Meyerflitedesign/SU-30/3d_prints/Canopy/lock_front_A_x1.3mf

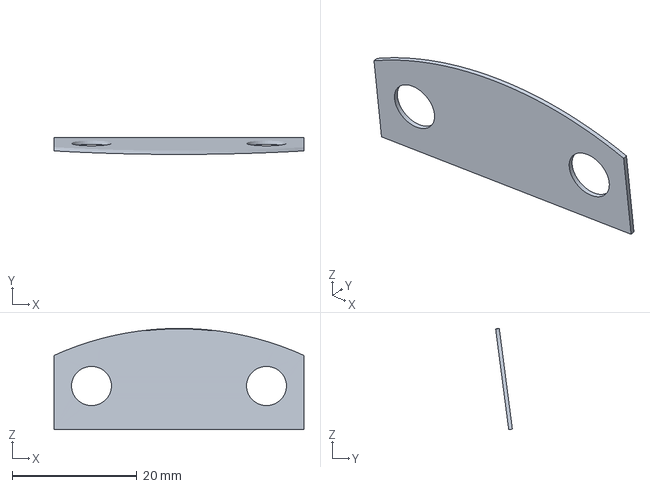
[picture p5: CAD file, 2023-12-27]
3d_prints/Canopy/lock_front_A_x1.3mf
40.0 x 2.69 x 16.2 mm
