Meyerflitedesign/SU-30/3d_prints/Miscellaneous/Tophatch_frame_x1.3mf

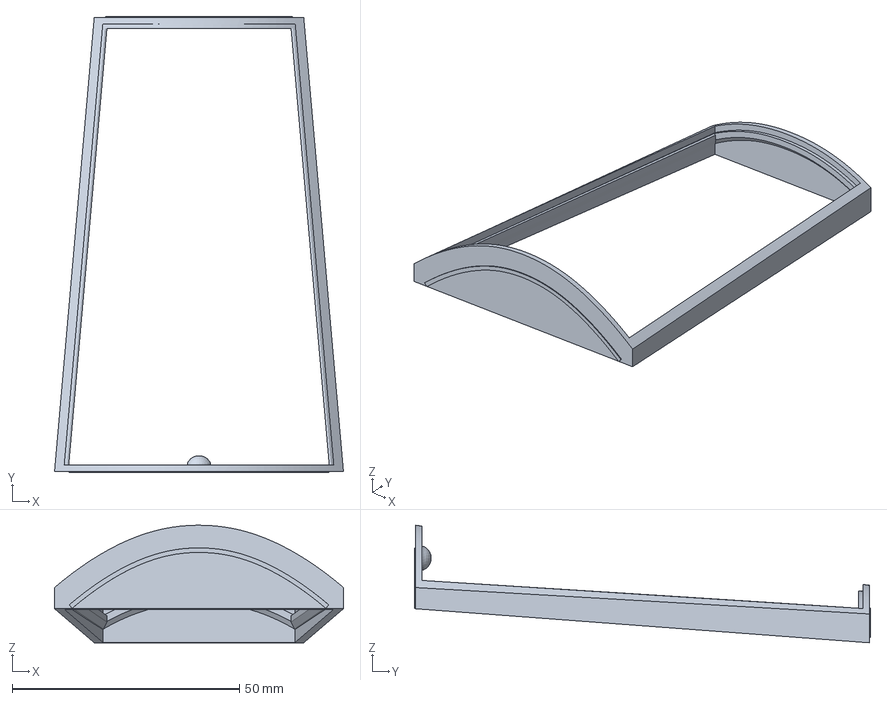
[picture p6: CAD file, 2023-12-27]
3d_prints/Miscellaneous/Tophatch_frame_x1.3mf
63.6 x 100.4 x 25.9 mm
