Meyerflitedesign/SU-30/3d_prints/Moving Canards/Canard_hinge_x2.3mf

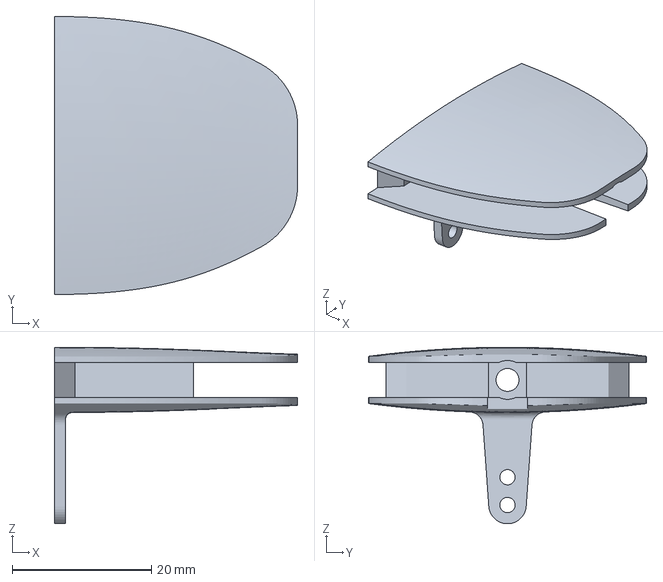
[picture p7: CAD file, 2023-12-27]
3d_prints/Moving Canards/Canard_hinge_x2.3mf
35.0 x 40.0 x 25.4 mm
