Meyerflitedesign/SU-30/3d_prints/Moving Stabilizers/Stabilizer_hinge_x1 +M.3mf

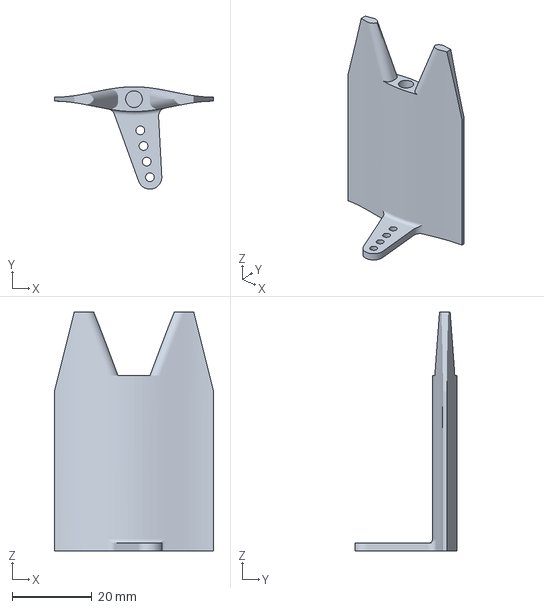
[picture p8: CAD file, 2023-12-27]
3d_prints/Moving Stabilizers/Stabilizer_hinge_x1 +M.3mf
40.0 x 25.7 x 60.0 mm
