Meyerflitedesign/SU-30/3d_prints/Substitutional Foam Parts/EF3_x1 +M.3mf

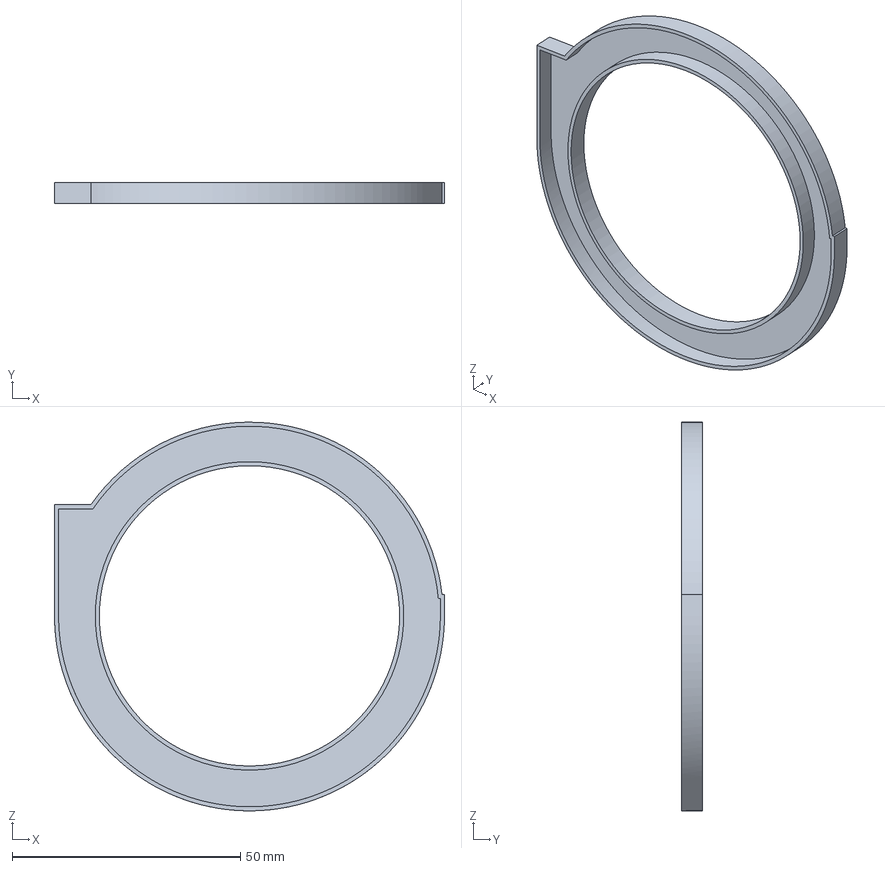
[picture p9: CAD file, 2023-12-27]
3d_prints/Substitutional Foam Parts/EF3_x1 +M.3mf
85.4 x 4.70 x 85.1 mm
