Meyerflitedesign/SU-30/3d_prints/Thrust Vectoring/Nozzle_retainer_x4.3mf

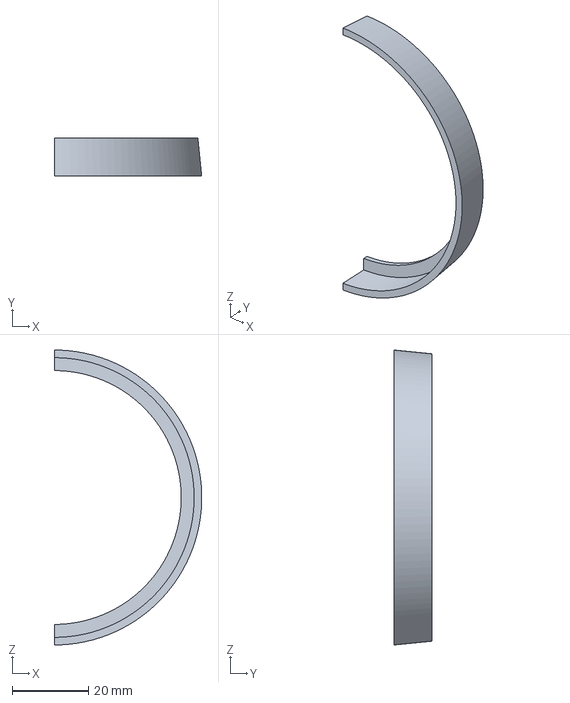
[picture p10: CAD file, 2023-12-27]
3d_prints/Thrust Vectoring/Nozzle_retainer_x4.3mf
38.7 x 10.00 x 77.4 mm
