Meyerflitedesign/SU-30/3d_prints/Canopy/Lock_back_B_x1.3mf

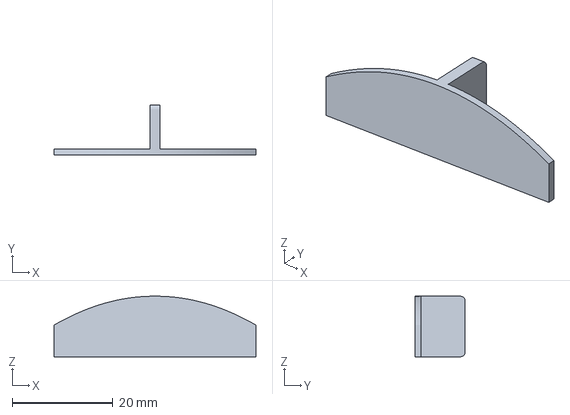
[picture p11: CAD file, 2023-12-27]
3d_prints/Canopy/Lock_back_B_x1.3mf
40.0 x 10.0 x 12.0 mm
