Meyerflitedesign/SU-30/3d_prints/Miscellaneous/Launchtab_support_x2.3mf

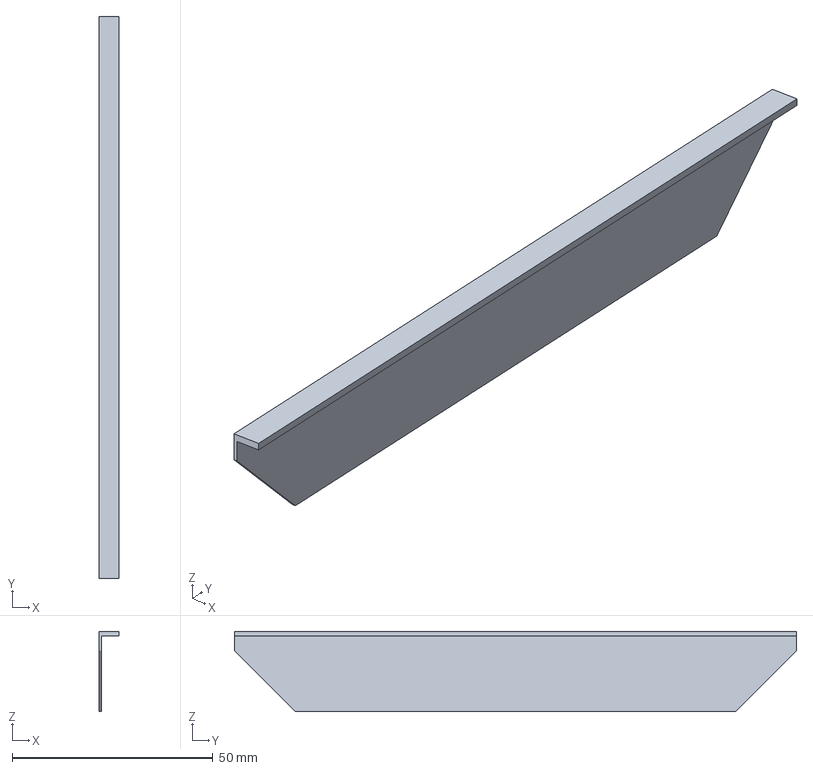
[picture p12: CAD file, 2023-12-27]
3d_prints/Miscellaneous/Launchtab_support_x2.3mf
5.00 x 140.0 x 20.0 mm
