Meyerflitedesign/SU-30/3d_prints/Moving Canards/Canard_mount_x1 +M.3mf

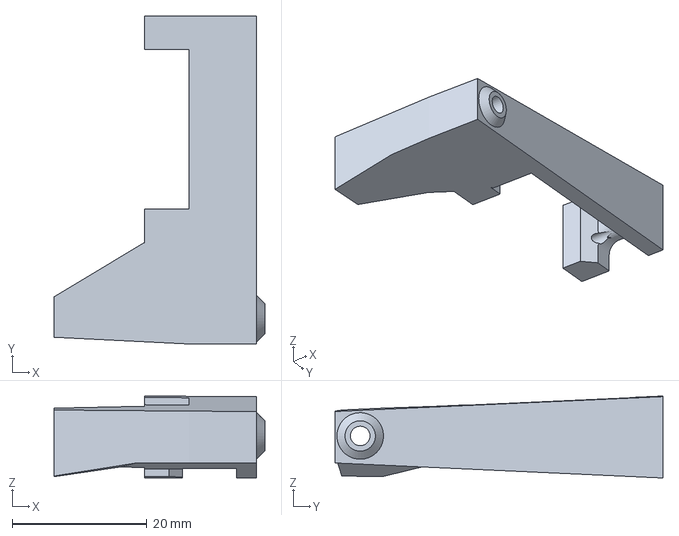
[picture p13: CAD file, 2023-12-27]
3d_prints/Moving Canards/Canard_mount_x1 +M.3mf
31.2 x 48.6 x 12.1 mm
