Meyerflitedesign/SU-30/3d_prints/Moving Stabilizers/Stabilizer_mount_1 +M.3mf

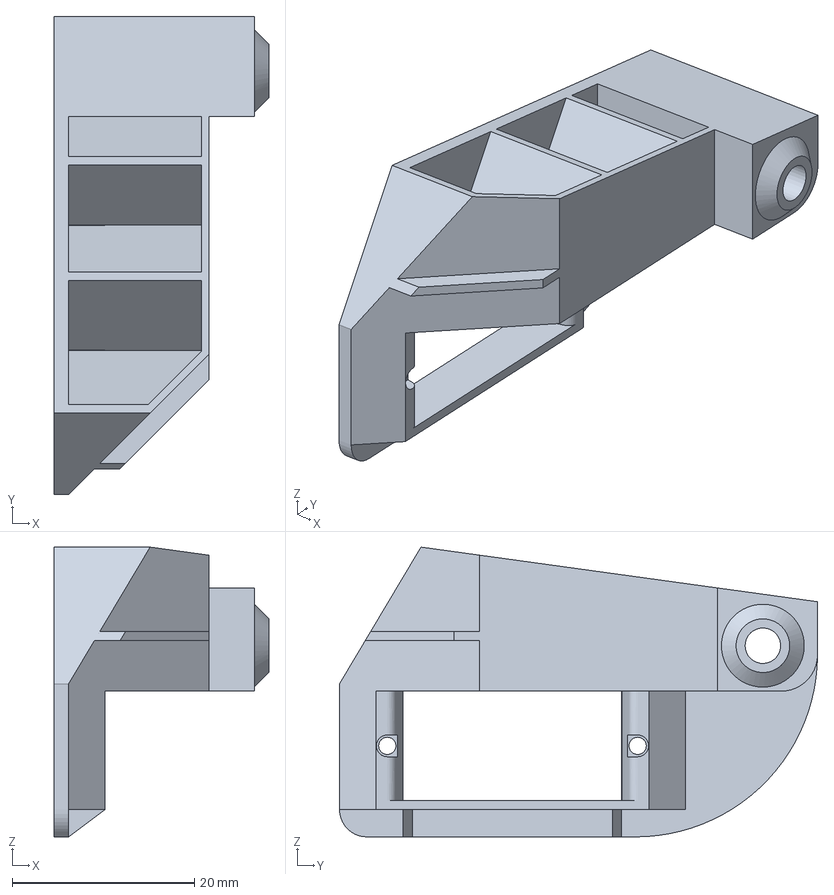
[picture p14: CAD file, 2023-12-27]
3d_prints/Moving Stabilizers/Stabilizer_mount_1 +M.3mf
23.6 x 52.5 x 31.8 mm
