Meyerflitedesign/SU-30/3d_prints/Substitutional Foam Parts/EF1_x1 +M.3mf

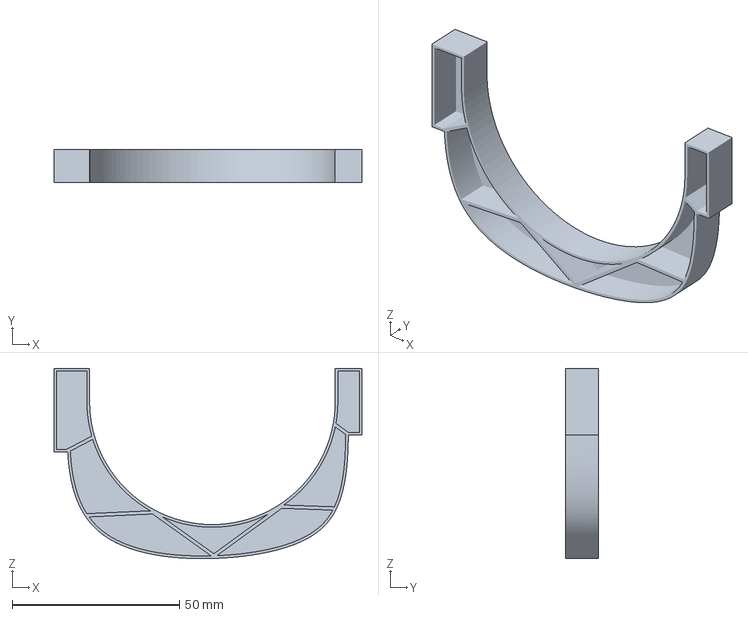
[picture p15: CAD file, 2023-12-27]
3d_prints/Substitutional Foam Parts/EF1_x1 +M.3mf
92.1 x 9.80 x 56.9 mm
