Meyerflitedesign/SU-30/3d_prints/Thrust Vectoring/Nozzle_mount_x2.3mf

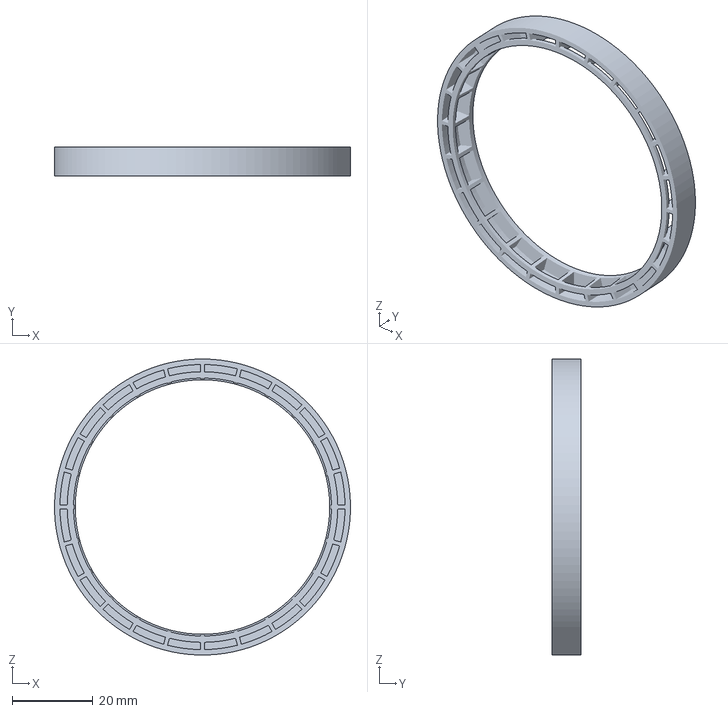
[picture p16: CAD file, 2023-12-27]
3d_prints/Thrust Vectoring/Nozzle_mount_x2.3mf
73.3 x 7.25 x 73.3 mm
