Meyerflitedesign/SU-30/3d_prints/Canopy/Lock_back_A_x1.3mf

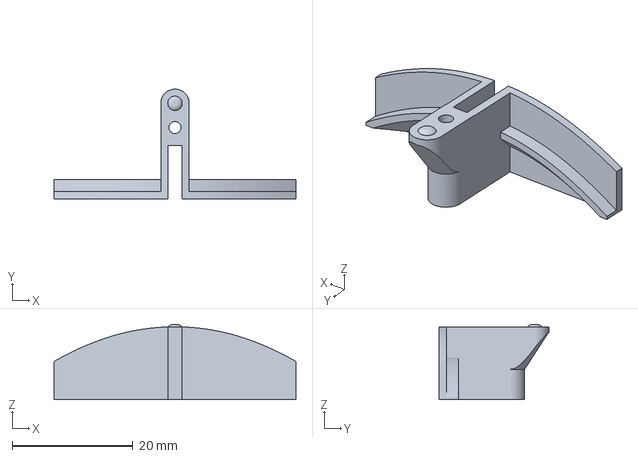
[picture p17: CAD file, 2023-12-27]
3d_prints/Canopy/Lock_back_A_x1.3mf
40.0 x 18.1 x 12.4 mm
