Meyerflitedesign/SU-30/3d_prints/Miscellaneous/Intake_grill_x4.3mf

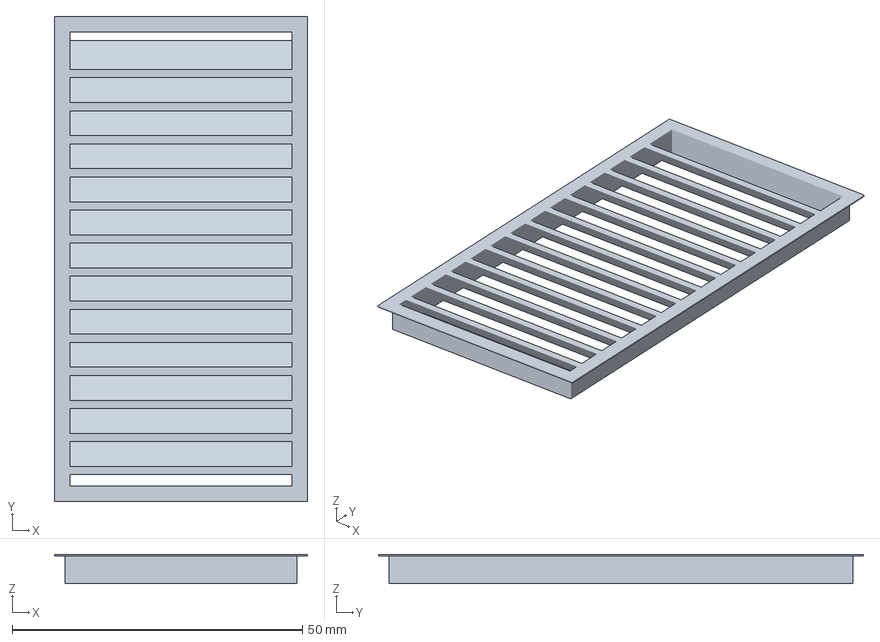
[picture p18: CAD file, 2023-12-27]
3d_prints/Miscellaneous/Intake_grill_x4.3mf
43.6 x 83.6 x 5.00 mm
