Meyerflitedesign/SU-30/3d_prints/Substitutional Foam Parts/FF2_x1 +M.3mf

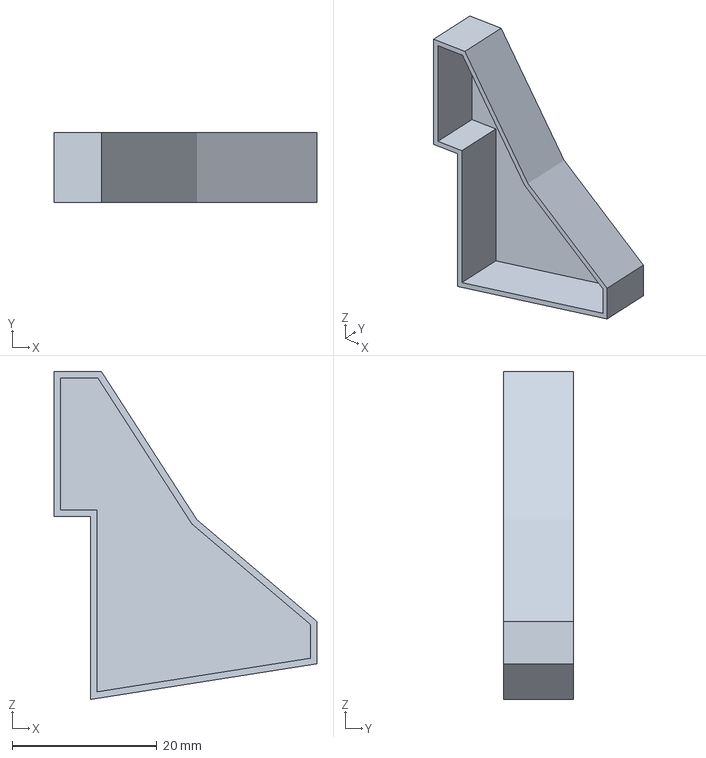
[picture p19: CAD file, 2023-12-27]
3d_prints/Substitutional Foam Parts/FF2_x1 +M.3mf
36.3 x 9.70 x 45.2 mm
