Meyerflitedesign/SU-30/3d_prints/Thrust Vectoring/Control_horn_x4.3mf

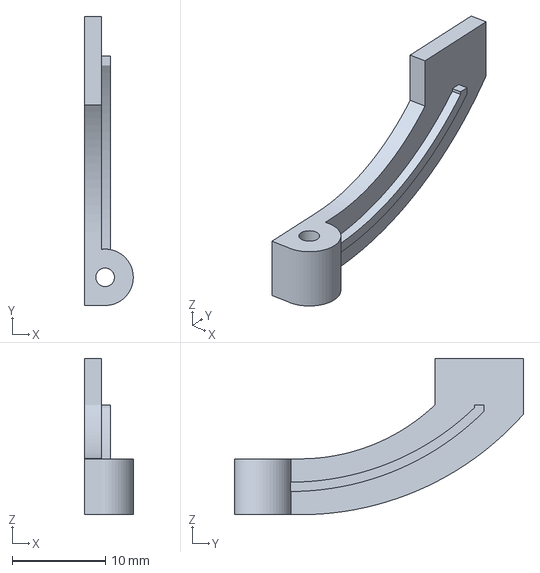
[picture p20: CAD file, 2023-12-27]
3d_prints/Thrust Vectoring/Control_horn_x4.3mf
5.23 x 31.0 x 16.8 mm
