Meyerflitedesign/SU-30/3d_prints/Canopy/Canopy_back_x1.3mf

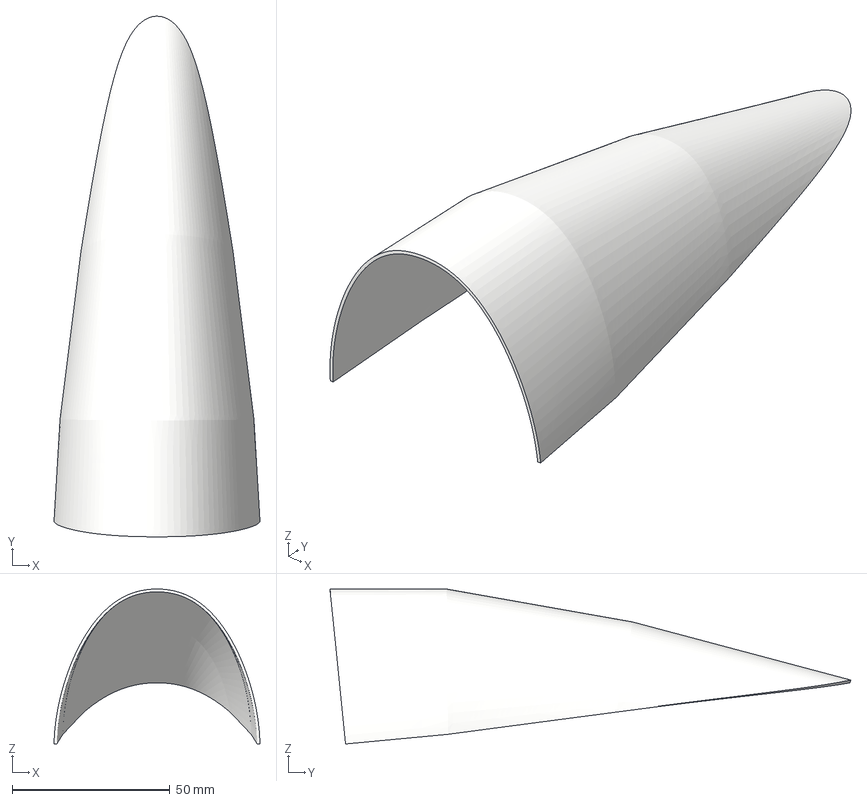
[picture p21: CAD file, 2023-12-27]
3d_prints/Canopy/Canopy_back_x1.3mf
65.3 x 165.1 x 49.1 mm
