Meyerflitedesign/SU-30/3d_prints/Miscellaneous/Gopro_mount_x1.3mf

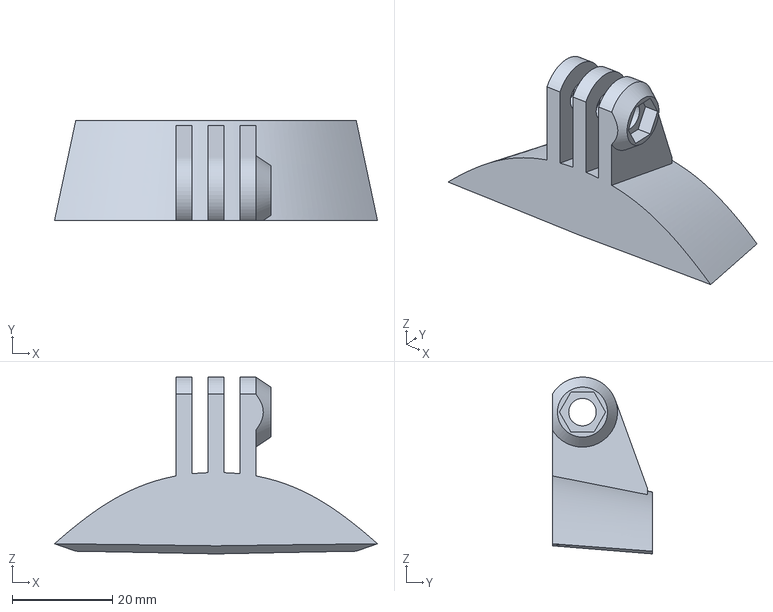
[picture p22: CAD file, 2023-12-27]
3d_prints/Miscellaneous/Gopro_mount_x1.3mf
64.5 x 20.0 x 35.3 mm
