Meyerflitedesign/SU-30/3d_prints/Substitutional Foam Parts/EF2_x1 +M.3mf

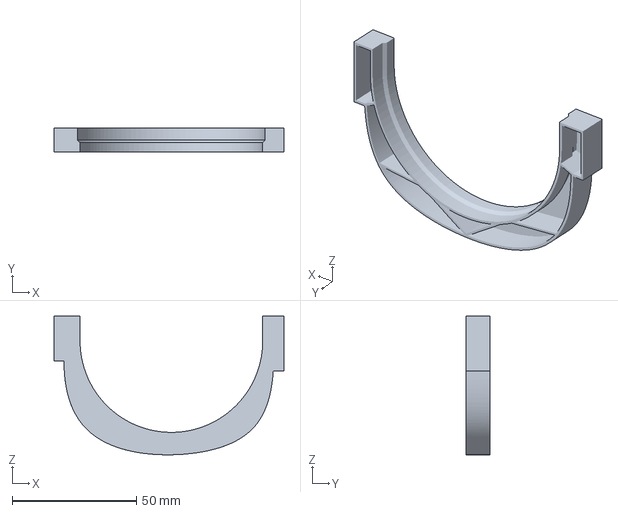
[picture p23: CAD file, 2023-12-27]
3d_prints/Substitutional Foam Parts/EF2_x1 +M.3mf
92.4 x 9.80 x 55.7 mm
