Meyerflitedesign/SU-30/3d_prints/Thrust Vectoring/Servo_mount_vertical_x1+M.3mf

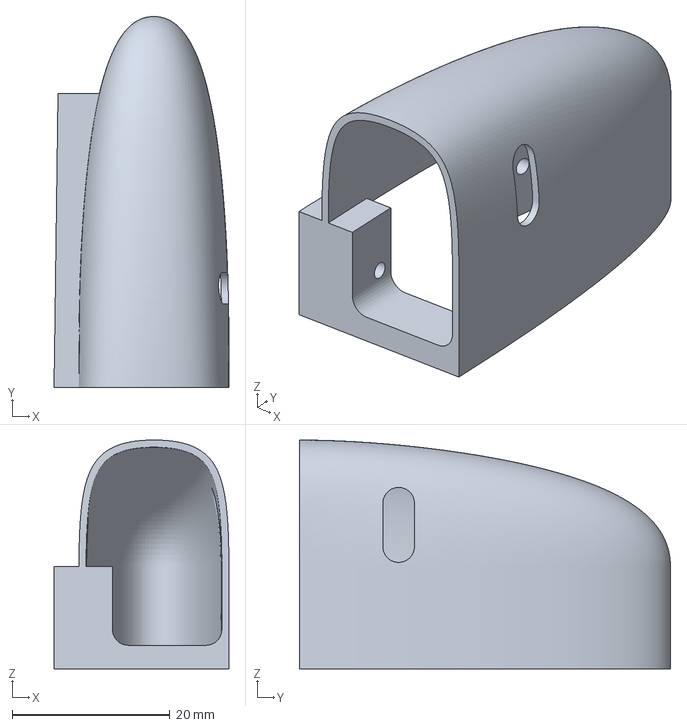
[picture p24: CAD file, 2023-12-27]
3d_prints/Thrust Vectoring/Servo_mount_vertical_x1+M.3mf
22.2 x 47.0 x 29.0 mm
