Meyerflitedesign/SU-30/3d_prints/Canopy/Canopy_front_x1.3mf

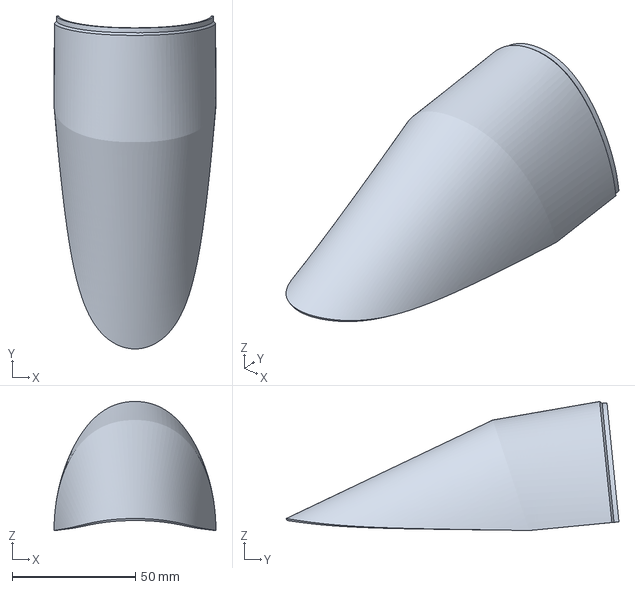
[picture p25: CAD file, 2023-12-27]
3d_prints/Canopy/Canopy_front_x1.3mf
65.6 x 134.9 x 52.3 mm
