Meyerflitedesign/SU-30/3d_prints/Miscellaneous/Tophatch_lid_x1.3mf

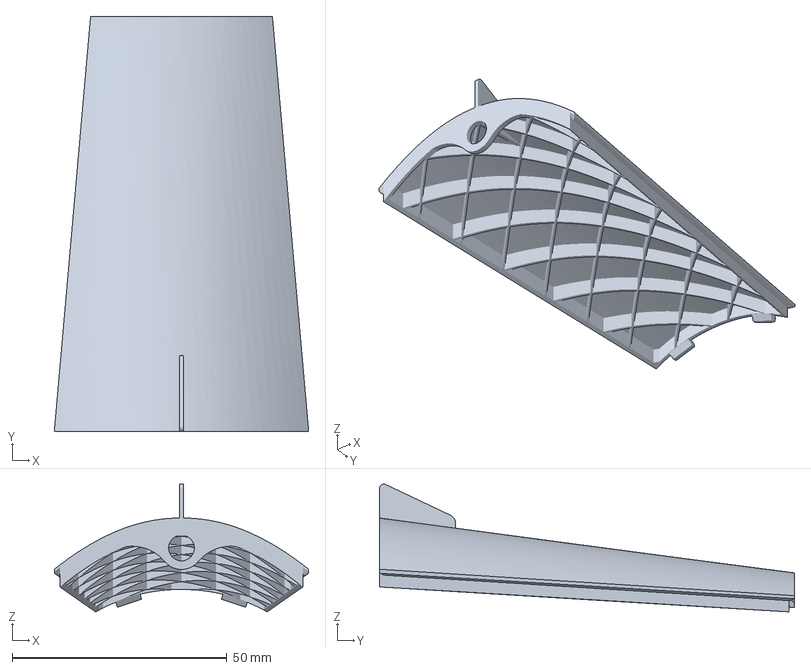
[picture p26: CAD file, 2023-12-27]
3d_prints/Miscellaneous/Tophatch_lid_x1.3mf
59.3 x 96.7 x 29.8 mm
