Meyerflitedesign/SU-30/3d_prints/Thrust Vectoring/Servo_mount_horizontal_x1+M.3mf

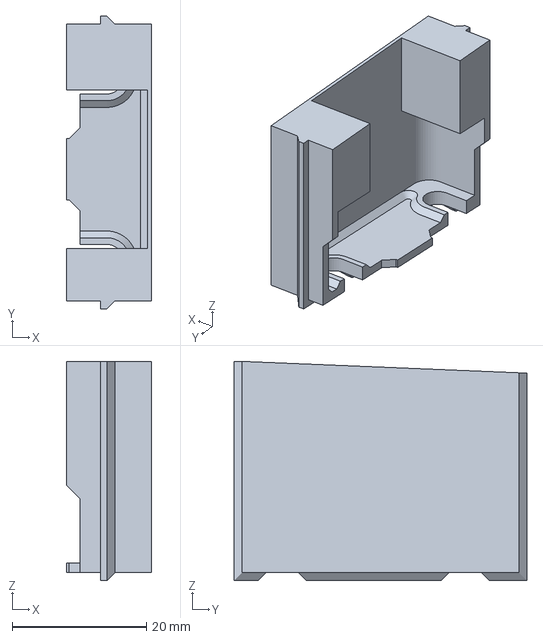
[picture p27: CAD file, 2023-12-27]
3d_prints/Thrust Vectoring/Servo_mount_horizontal_x1+M.3mf
12.6 x 43.6 x 32.6 mm
