Meyerflitedesign/SU-30/3d_prints/Canopy/Lock_front_B_x1.3mf

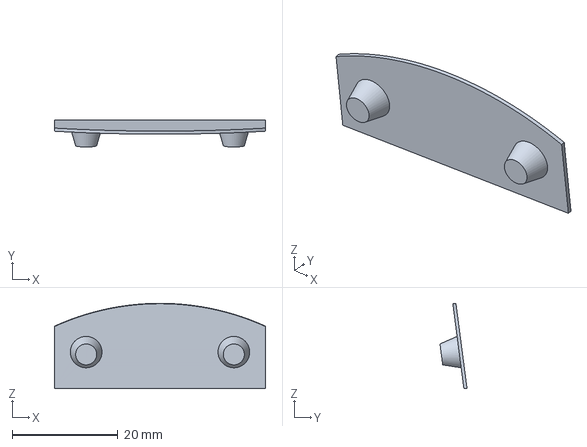
[picture p28: CAD file, 2023-12-27]
3d_prints/Canopy/Lock_front_B_x1.3mf
40.0 x 5.13 x 16.2 mm
