Meyerflitedesign/SU-30/3d_prints/Canopy/Lock_latch_x1.3mf

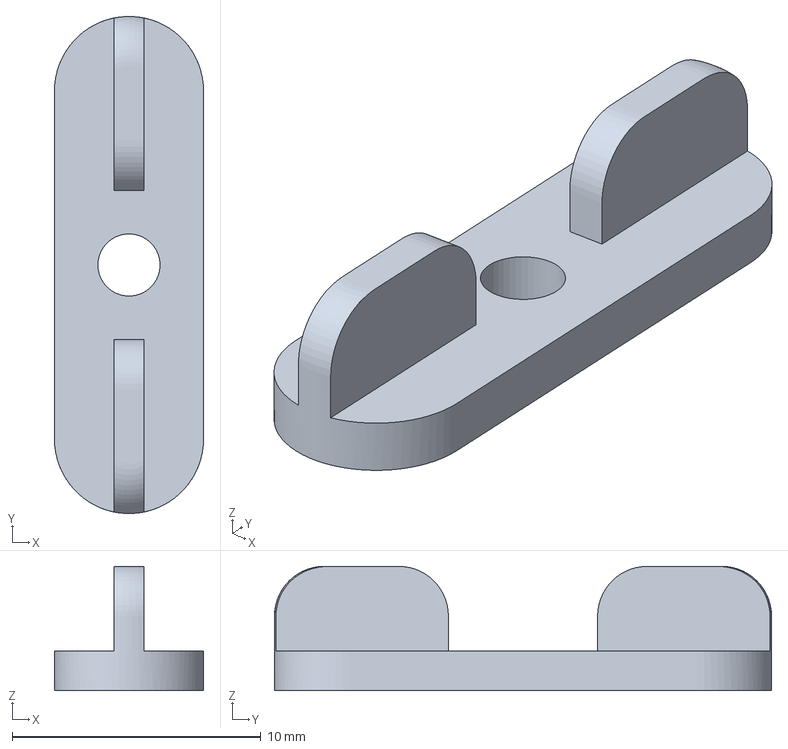
[picture p29: CAD file, 2023-12-27]
3d_prints/Canopy/Lock_latch_x1.3mf
6.00 x 20.0 x 5.00 mm
