Meyerflitedesign/SU-30/(list of files, cad)

Other CAD files:
Sheets/DXF/SU-30.dxf
