Meyerflitedesign/SU-30/su30_wiring.png

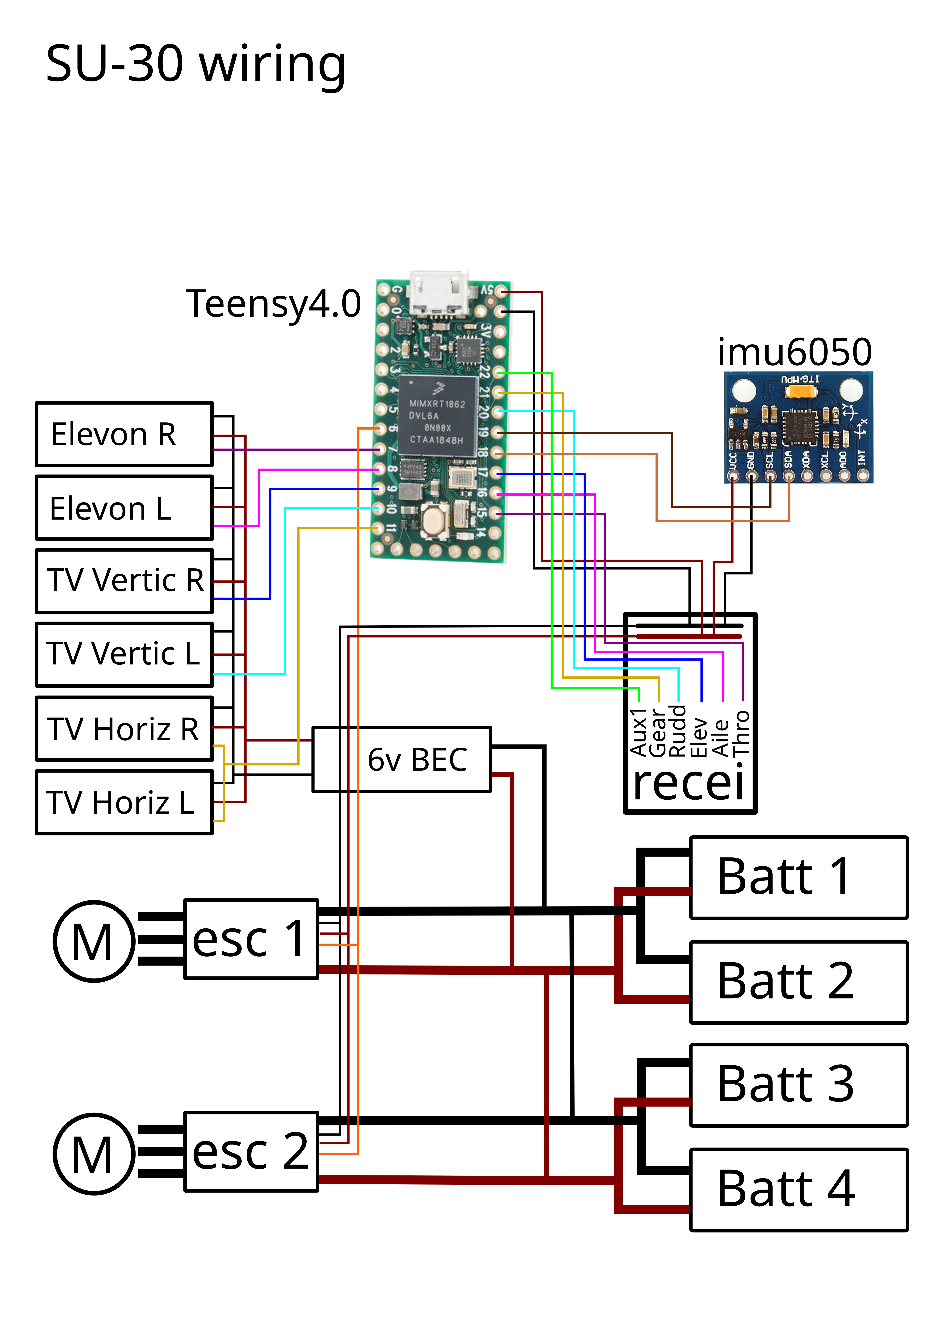
su30_wiring.png
