Meyerflitedesign/SU-30/Sheets/PDF/Sheet1.pdf

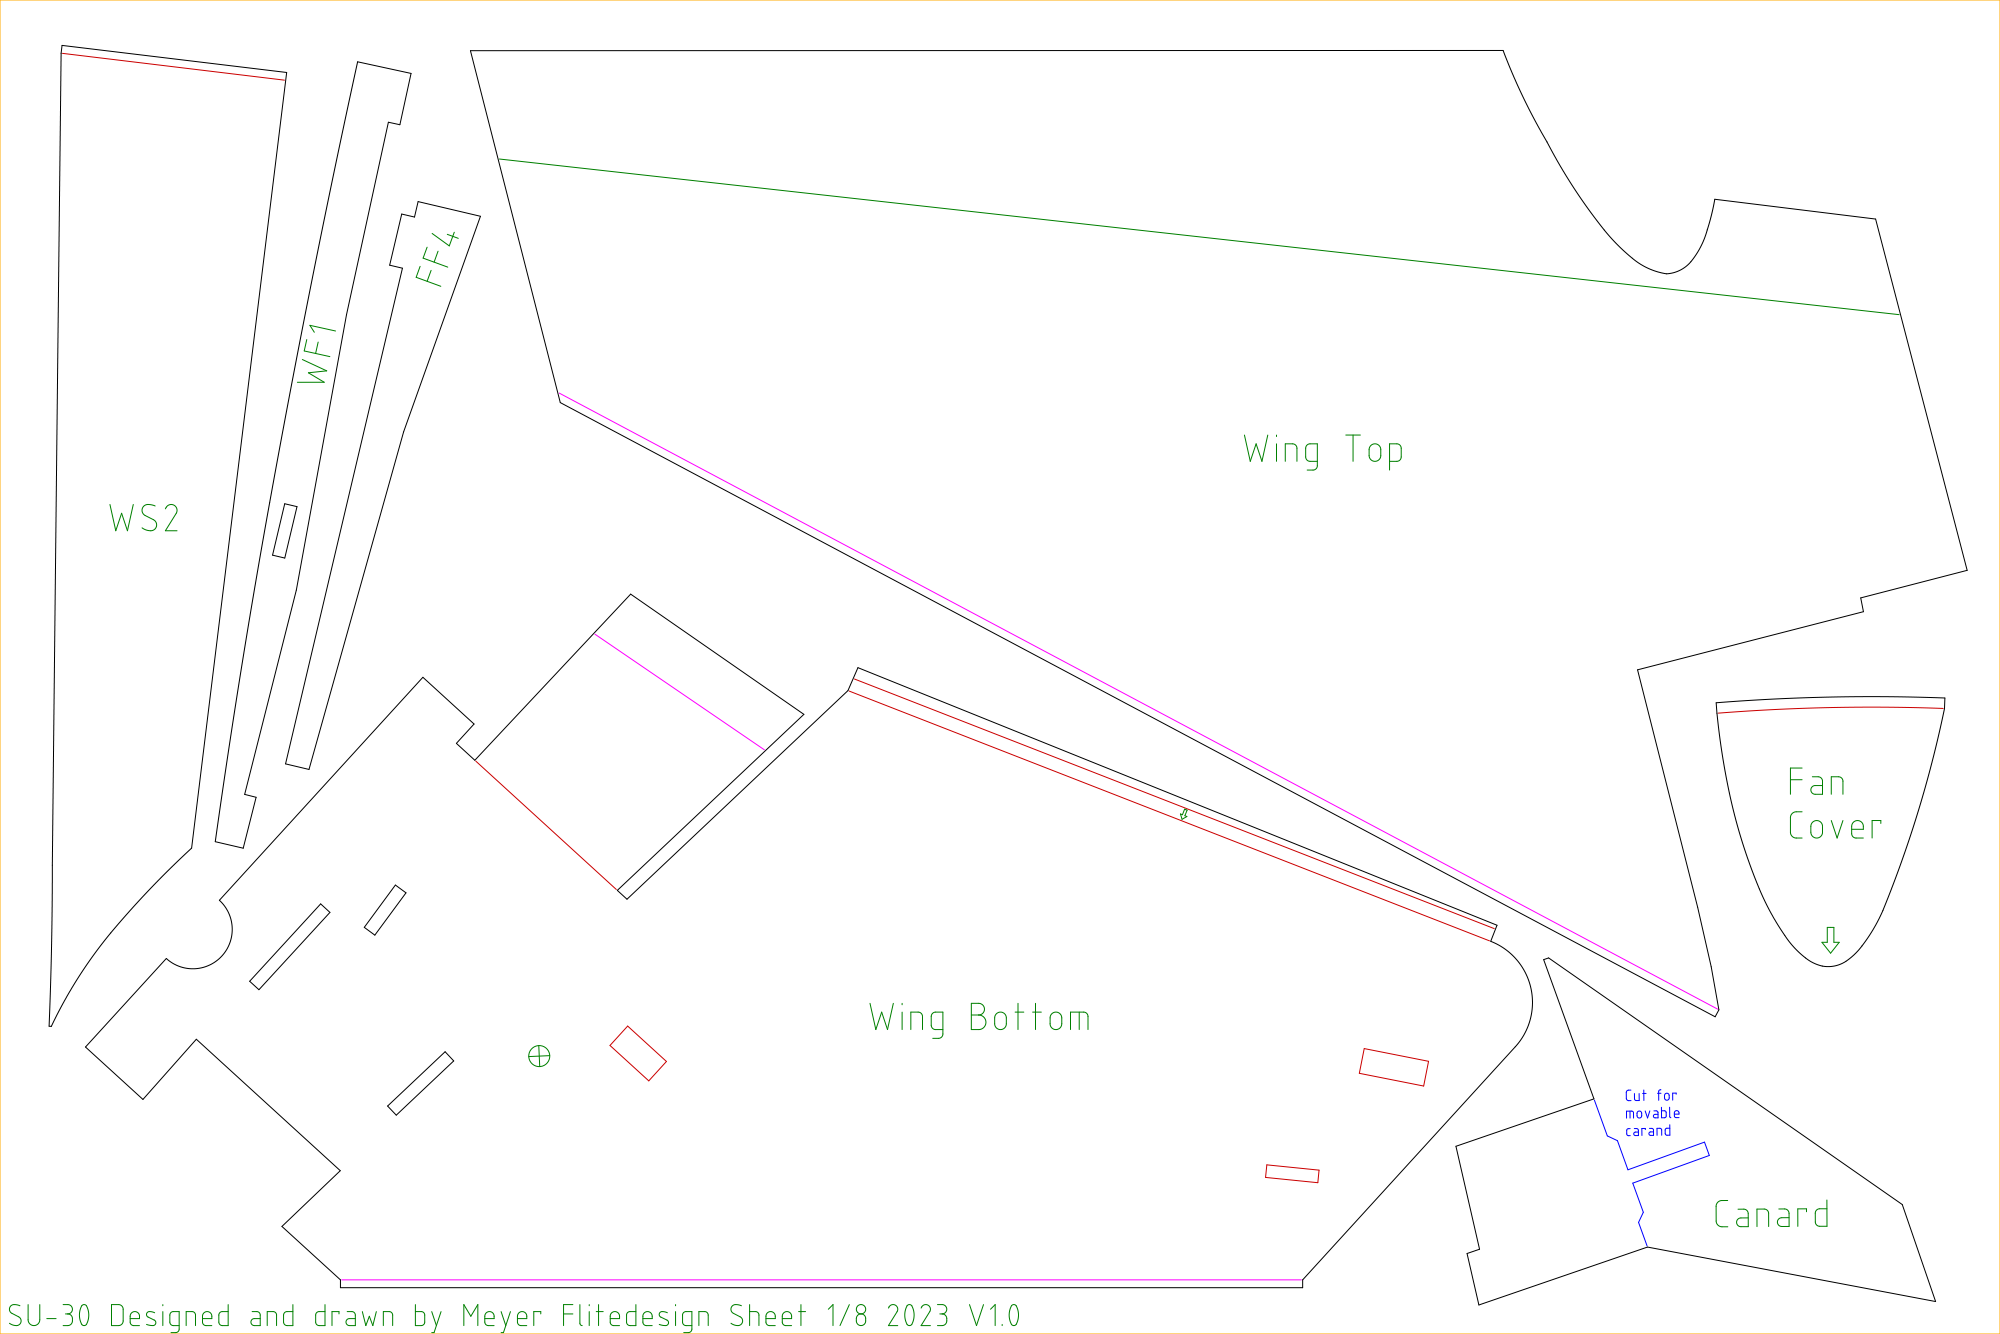
[picture p31: page 1]
