Meyerflitedesign/SU-30/Sheets/PDF/Sheet2.pdf

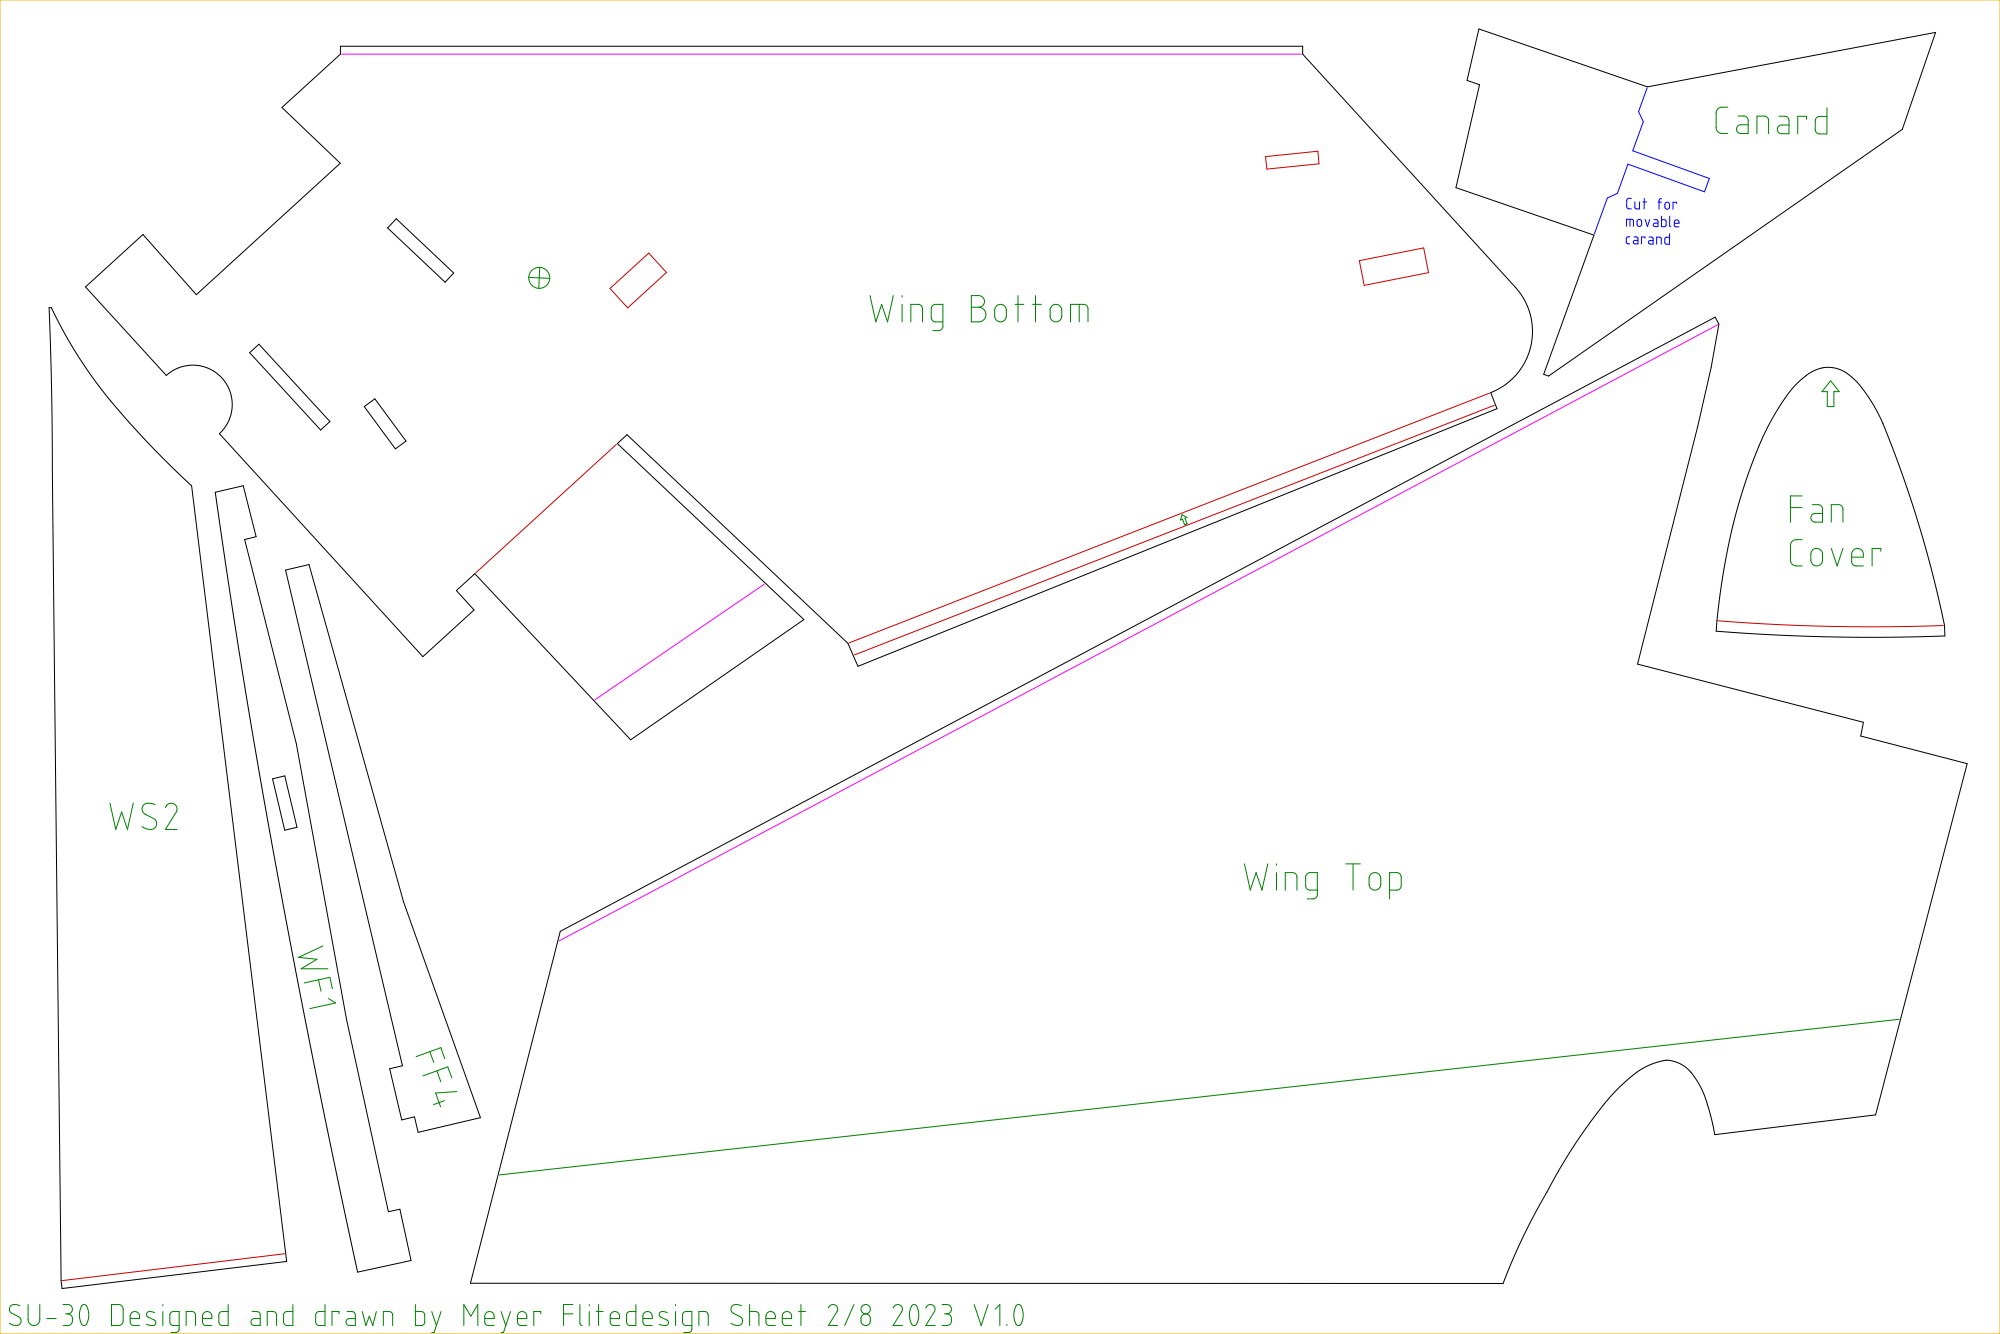
[picture p32: page 1]
