Meyerflitedesign/SU-30/Sheets/PDF/Sheet3.pdf

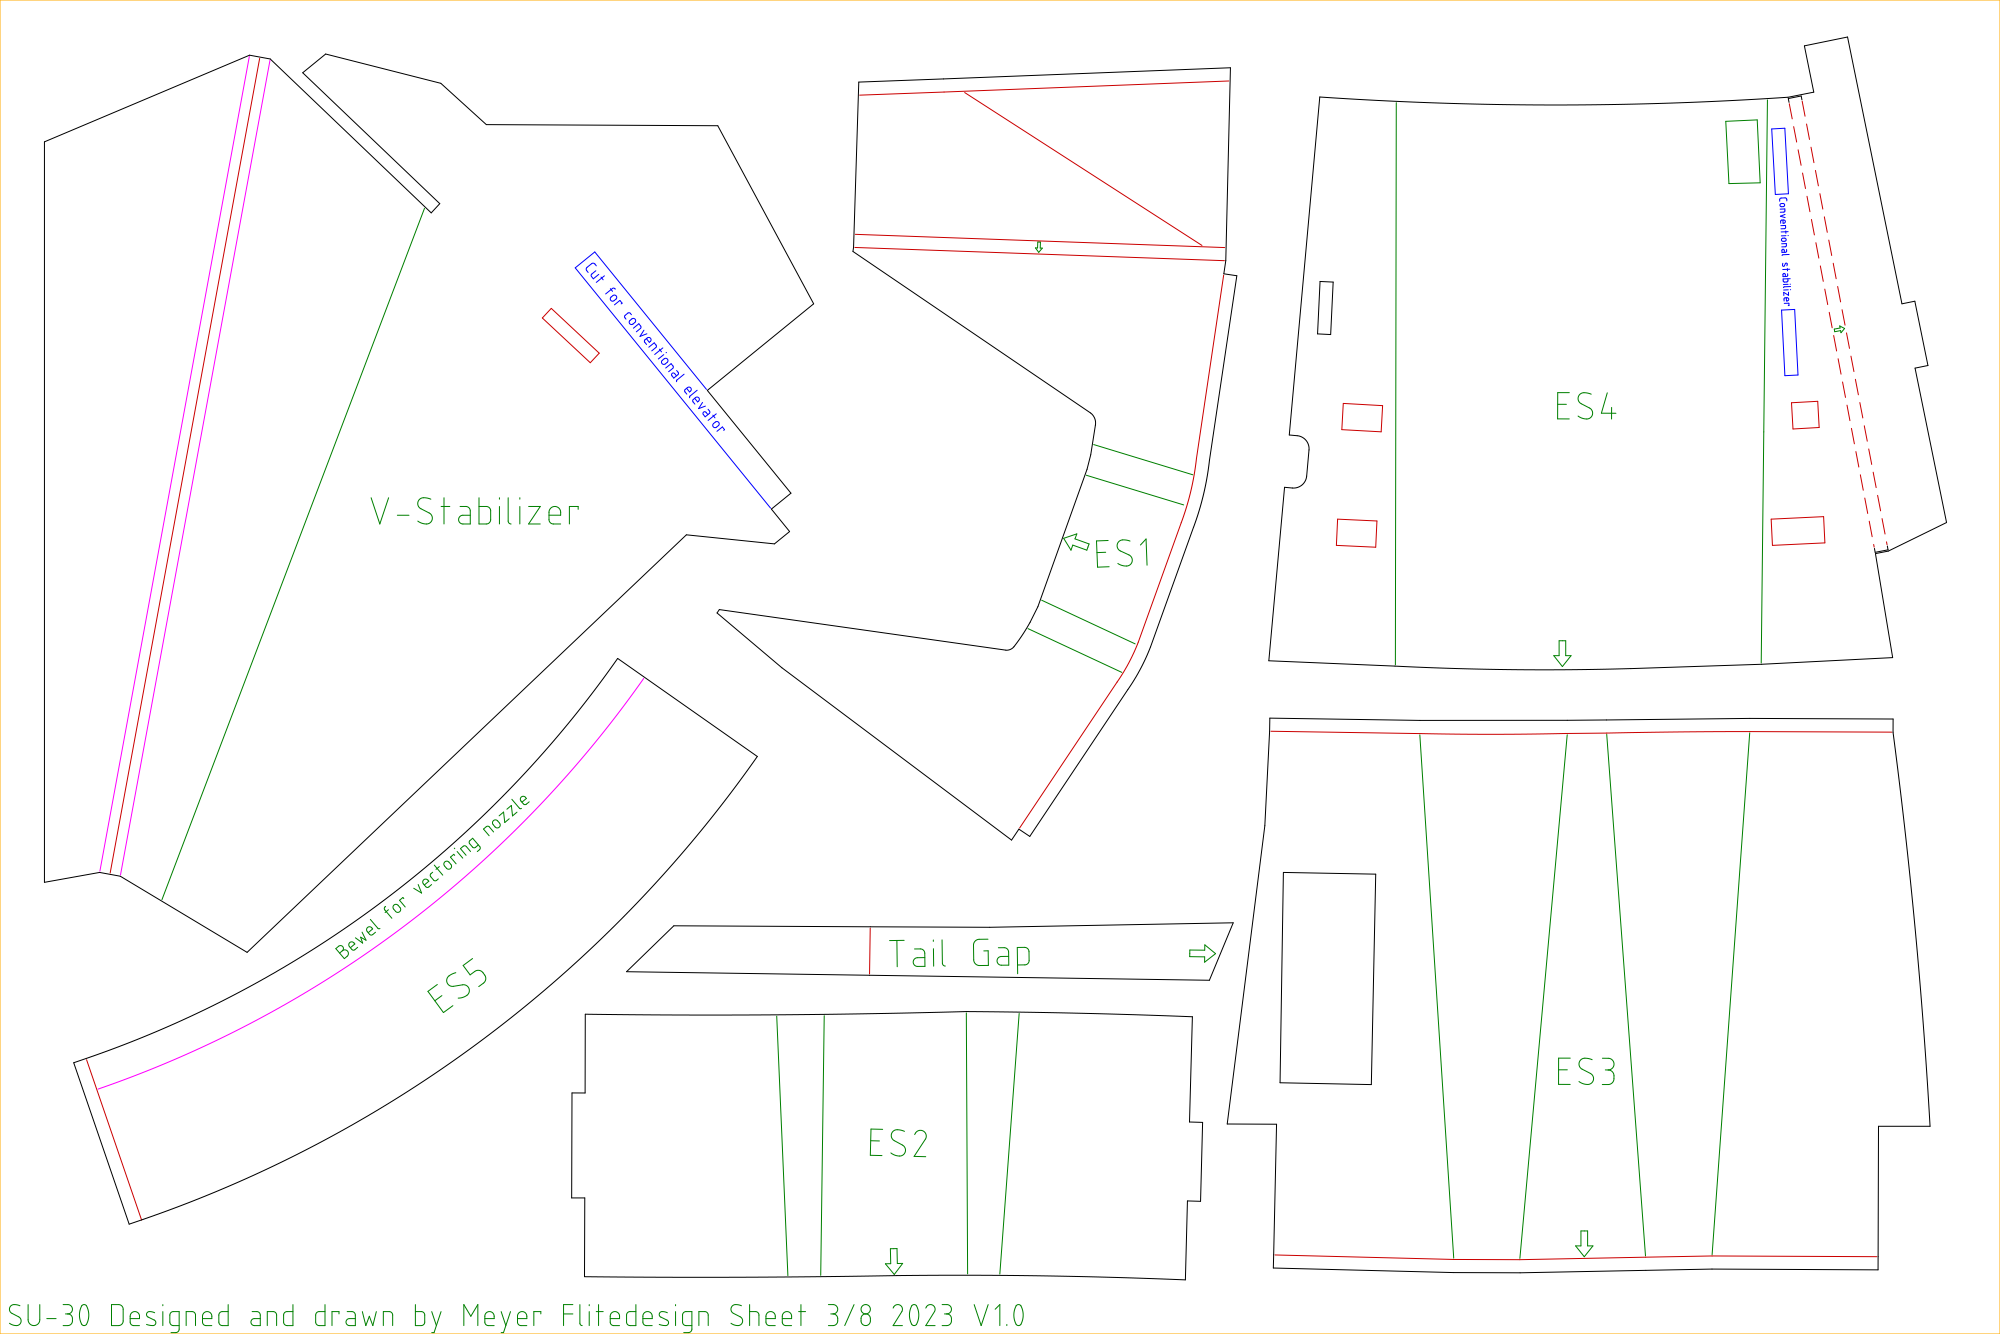
[picture p33: page 1]
