Meyerflitedesign/SU-30/Sheets/PDF/Sheet4.pdf

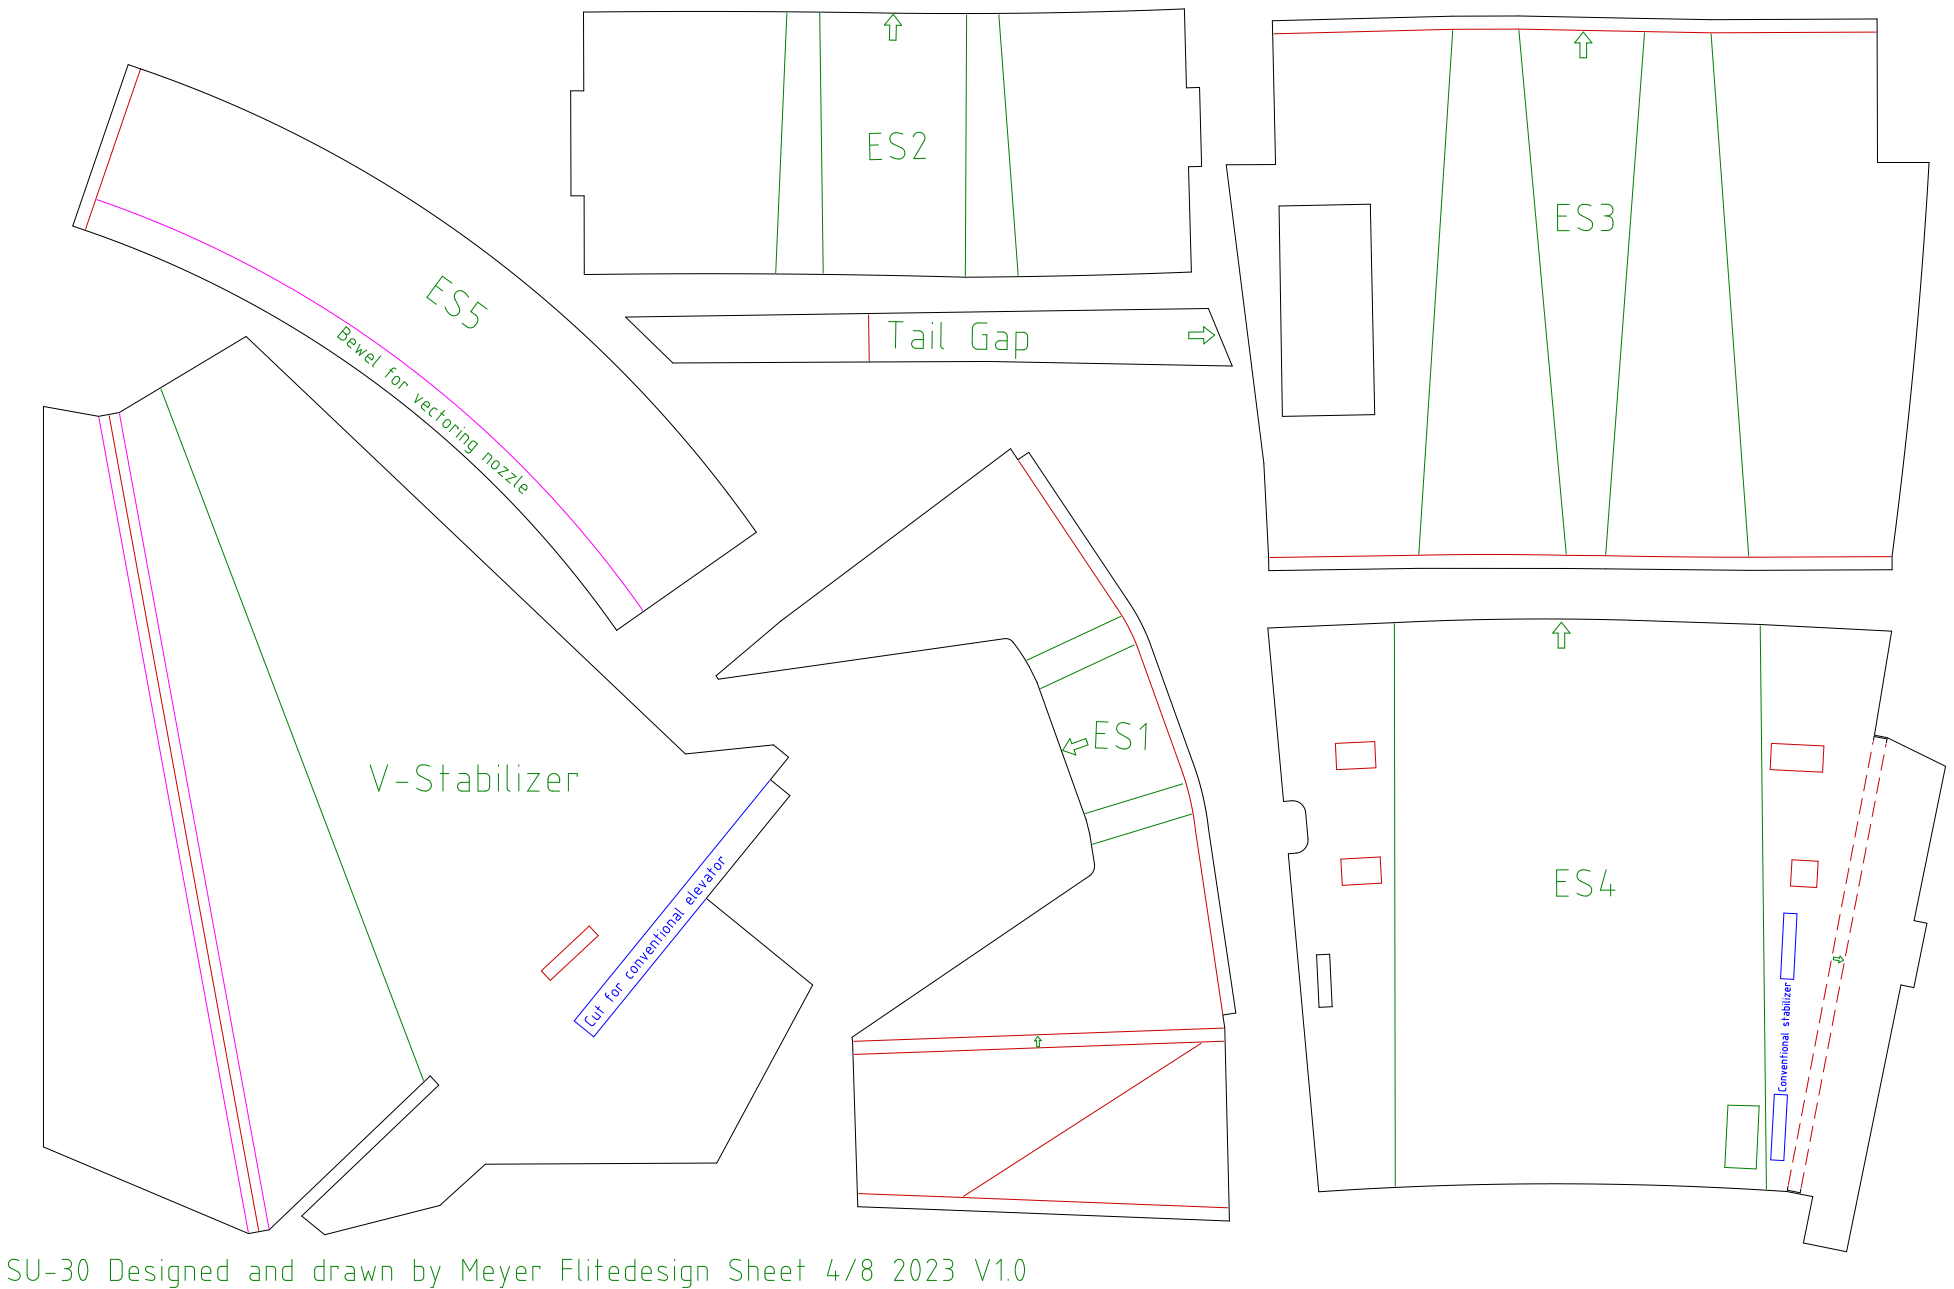
[picture p34: page 1]
