Meyerflitedesign/SU-30/Sheets/PDF/Sheet5.pdf

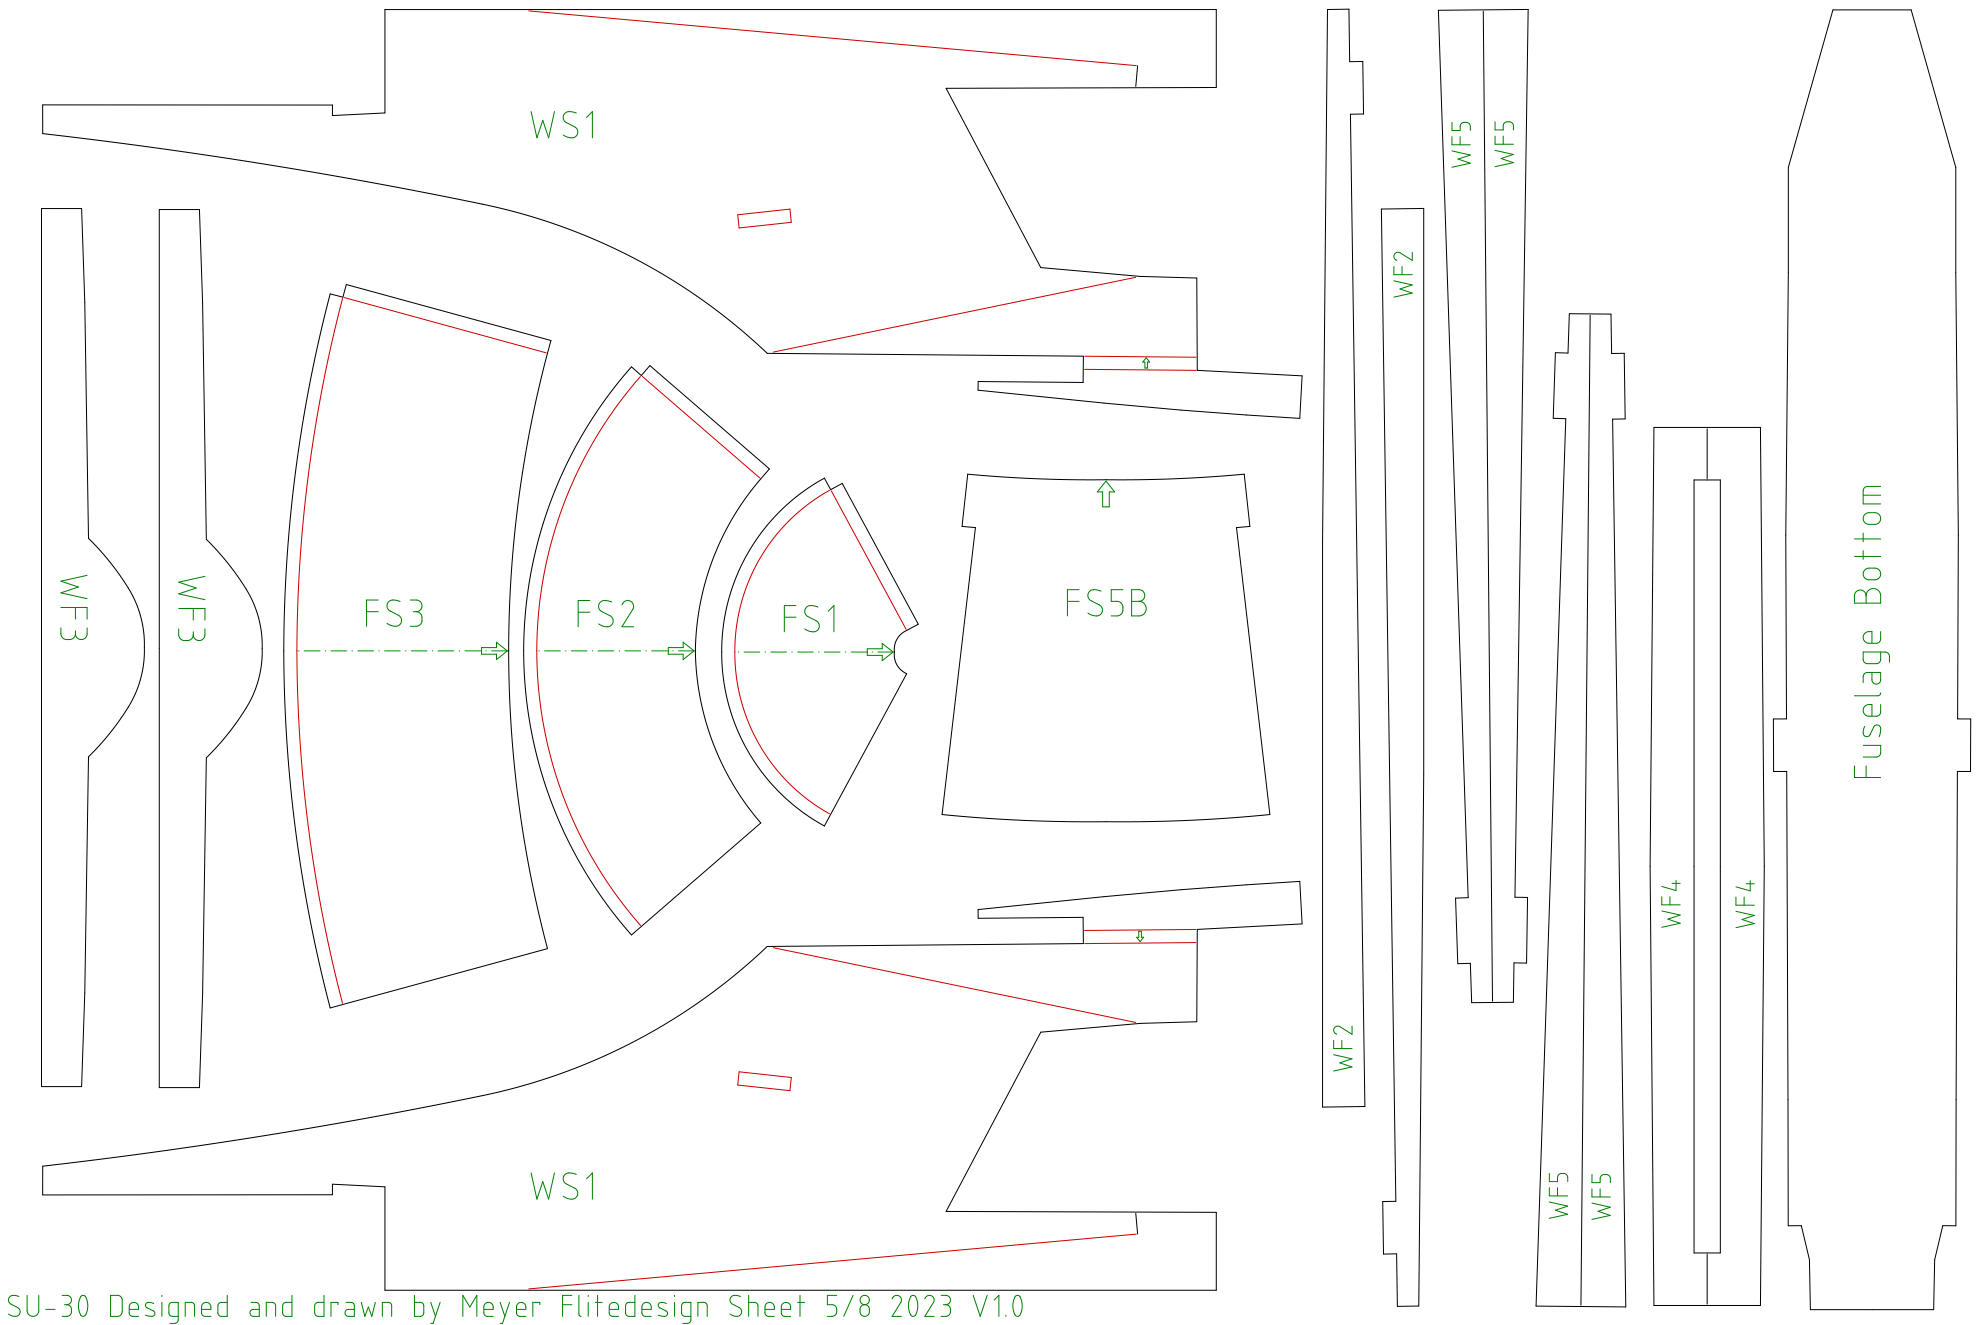
[picture p35: page 1]
