Meyerflitedesign/SU-30/Sheets/PDF/Sheet6.pdf

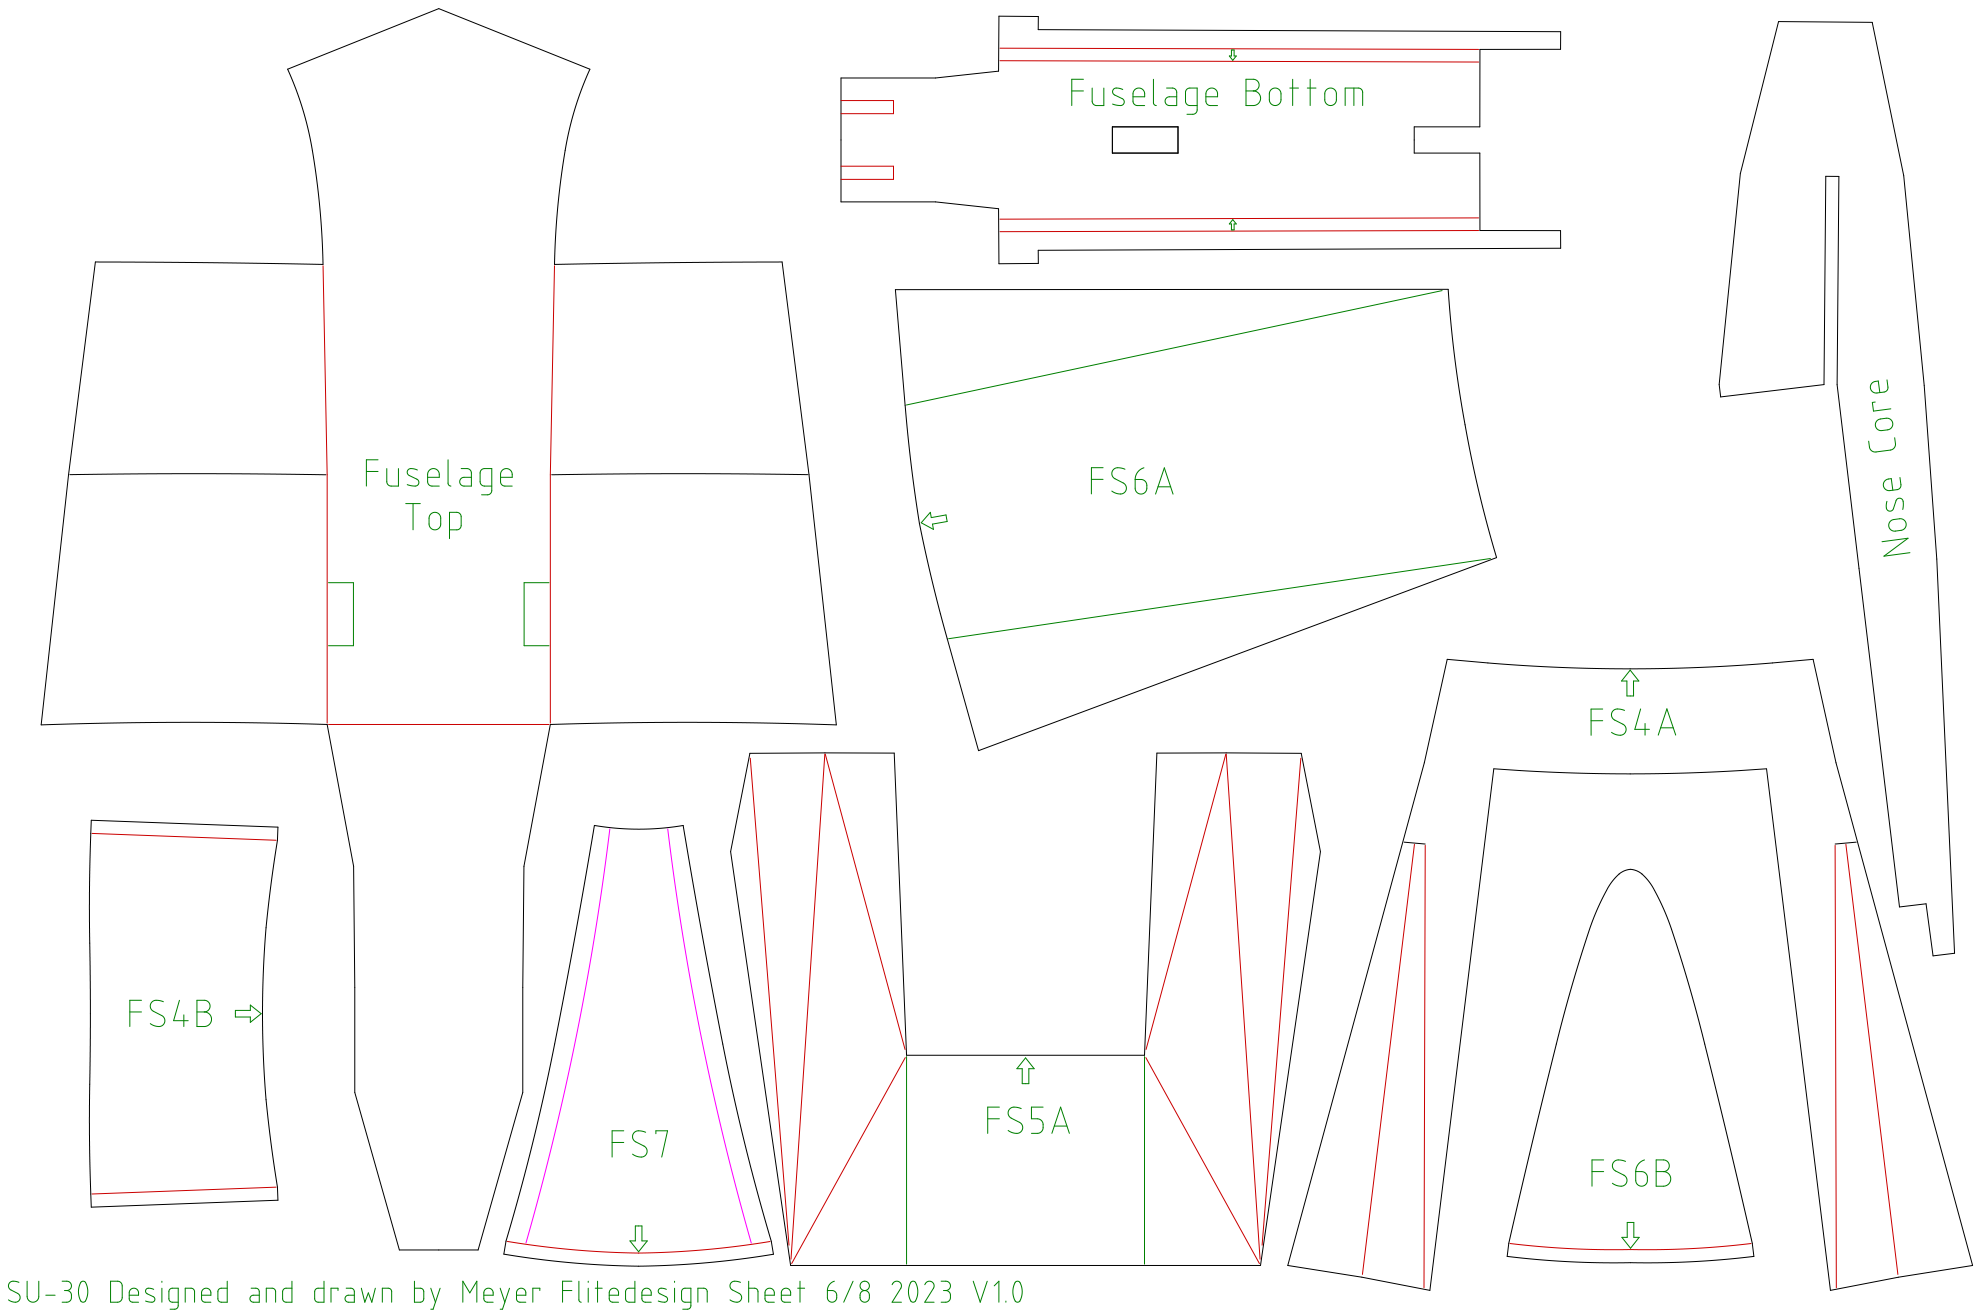
[picture p36: page 1]
