Meyerflitedesign/SU-30/Sheets/PDF/Sheet7.pdf

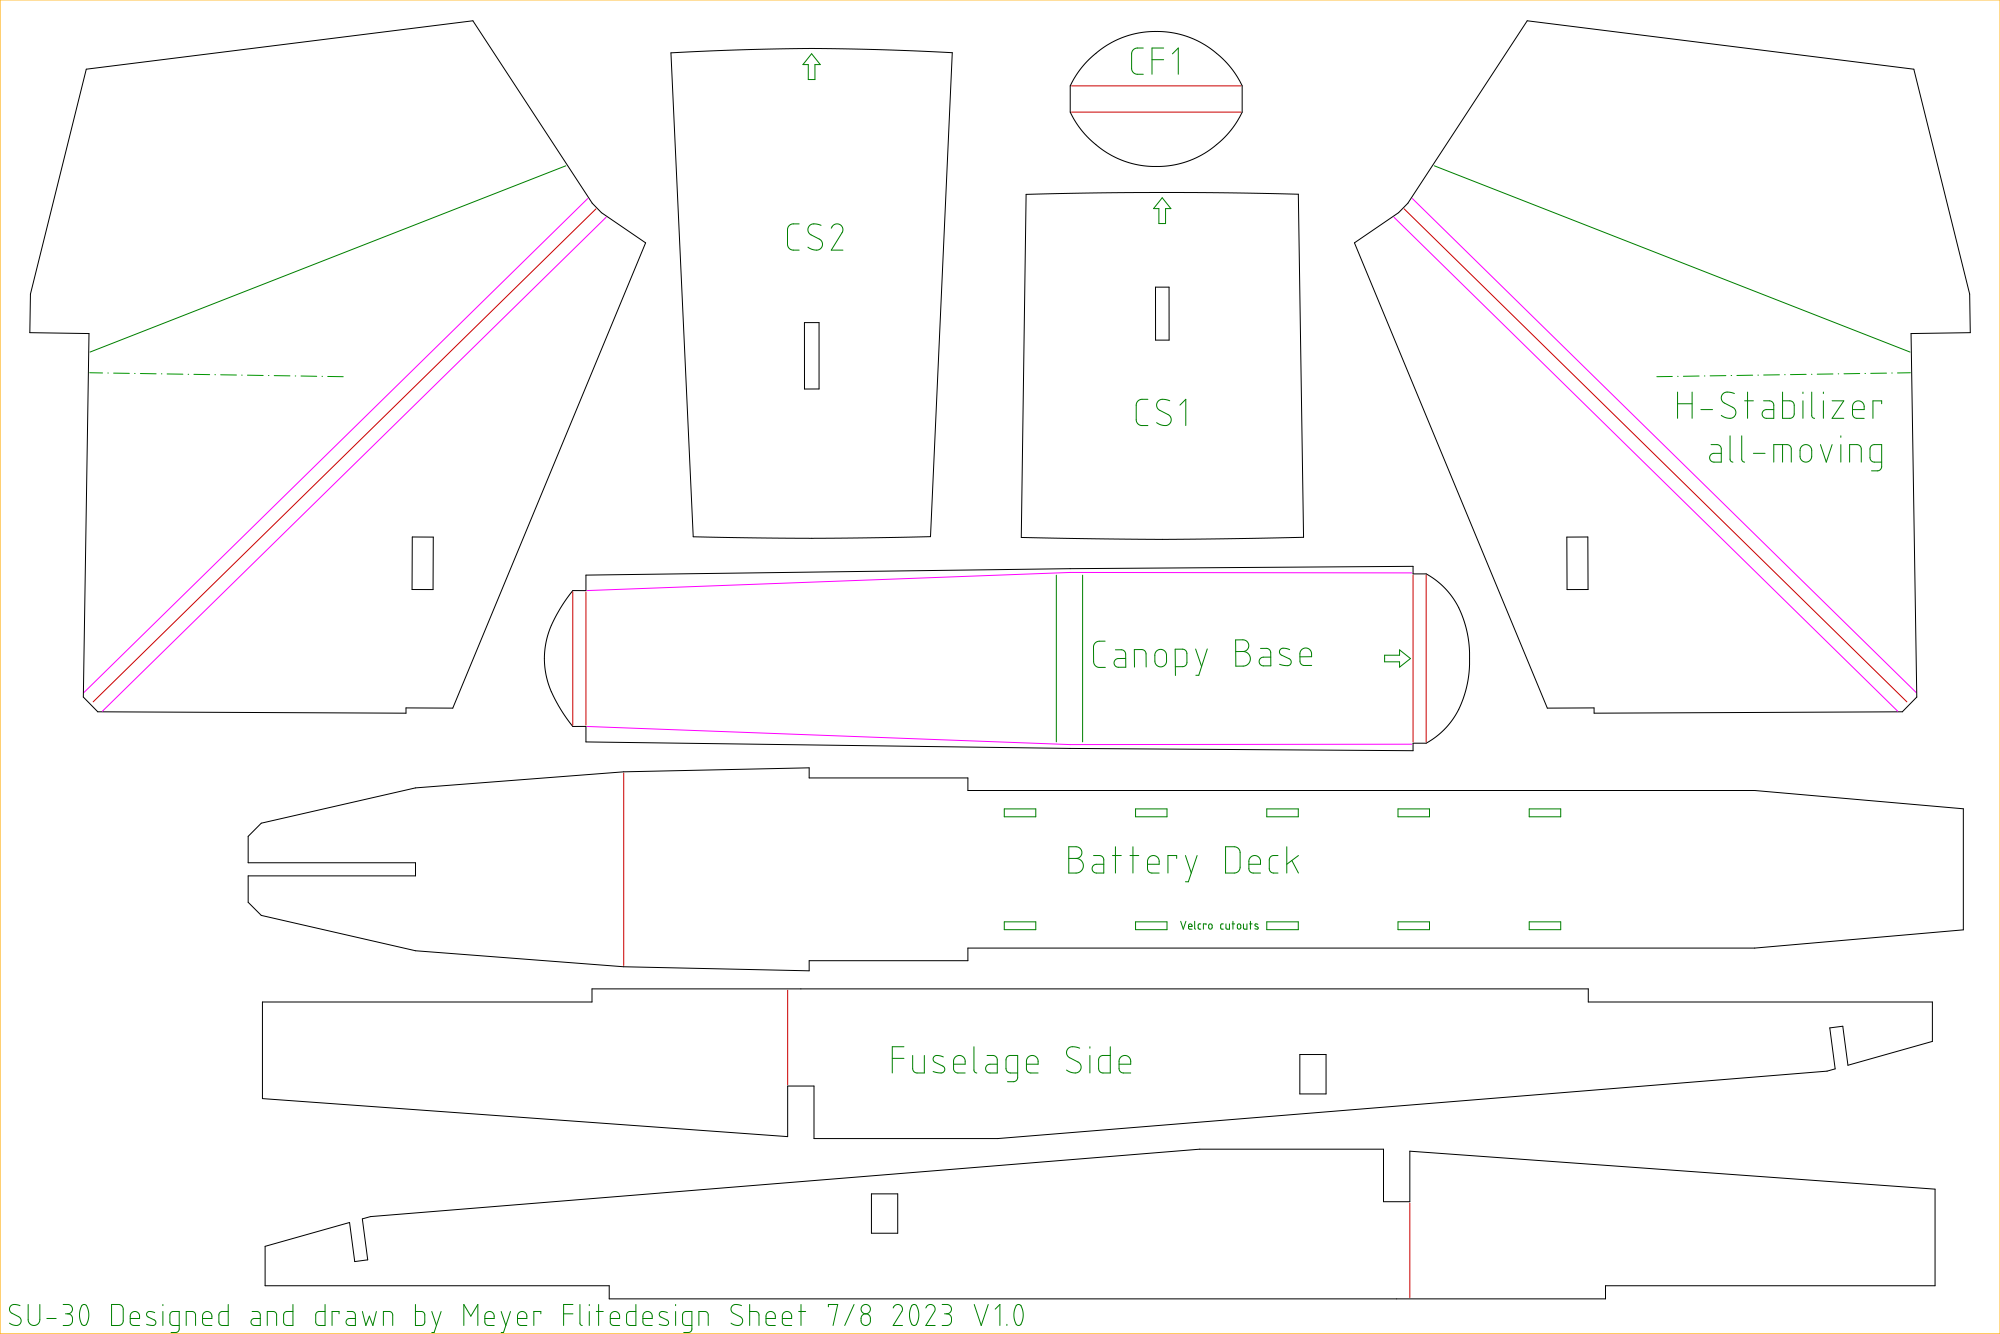
[picture p37: page 1]
