Meyerflitedesign/SU-30/Sheets/PDF/Sheet8.pdf

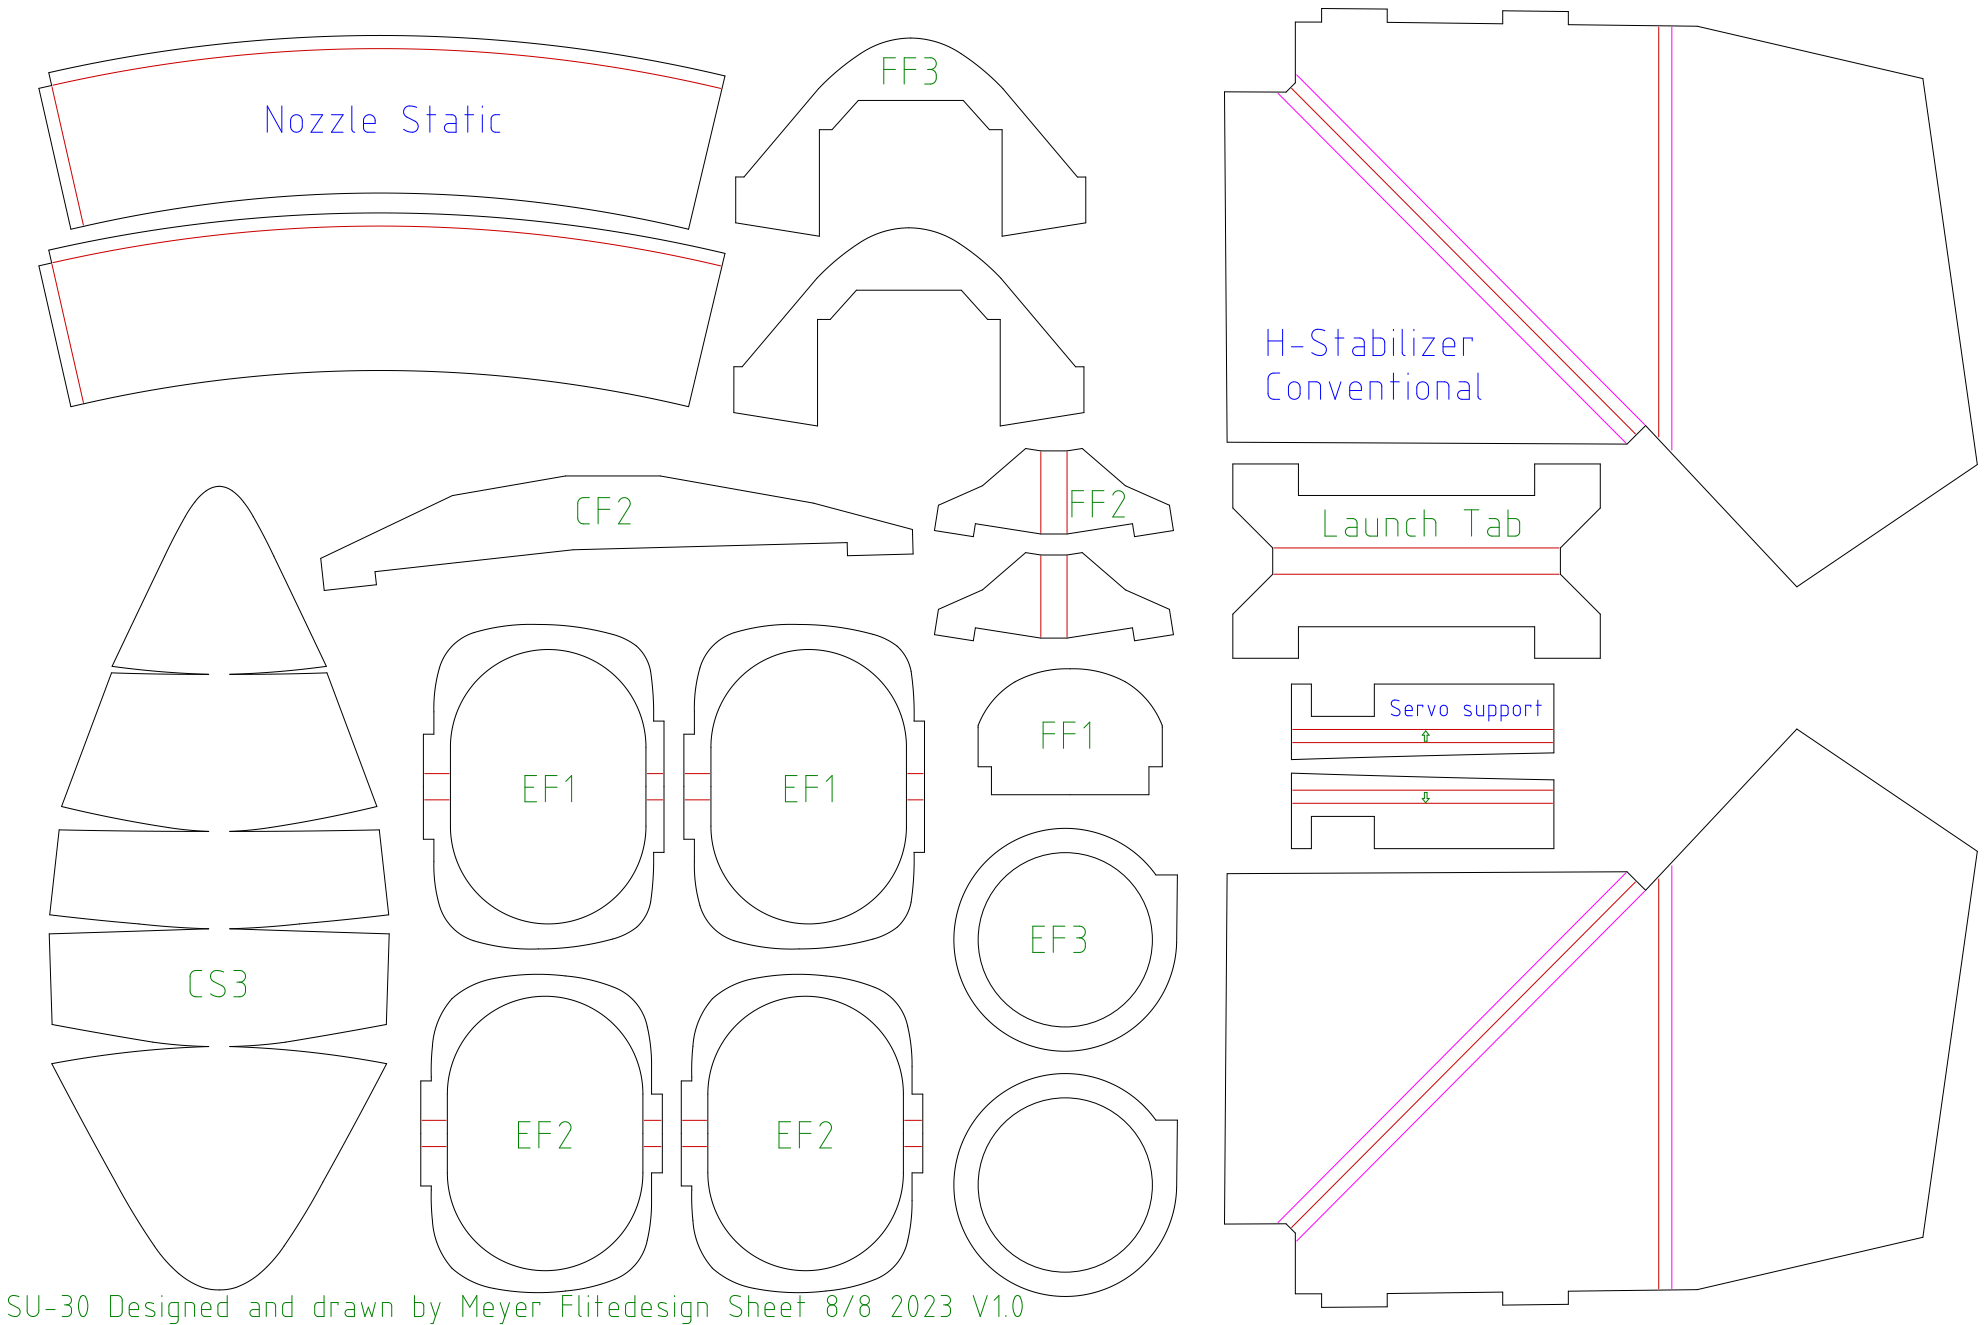
[picture p38: page 1]
