Meyerflitedesign/SU-30/Sheets/PDF/thrust_tube_conventional.pdf

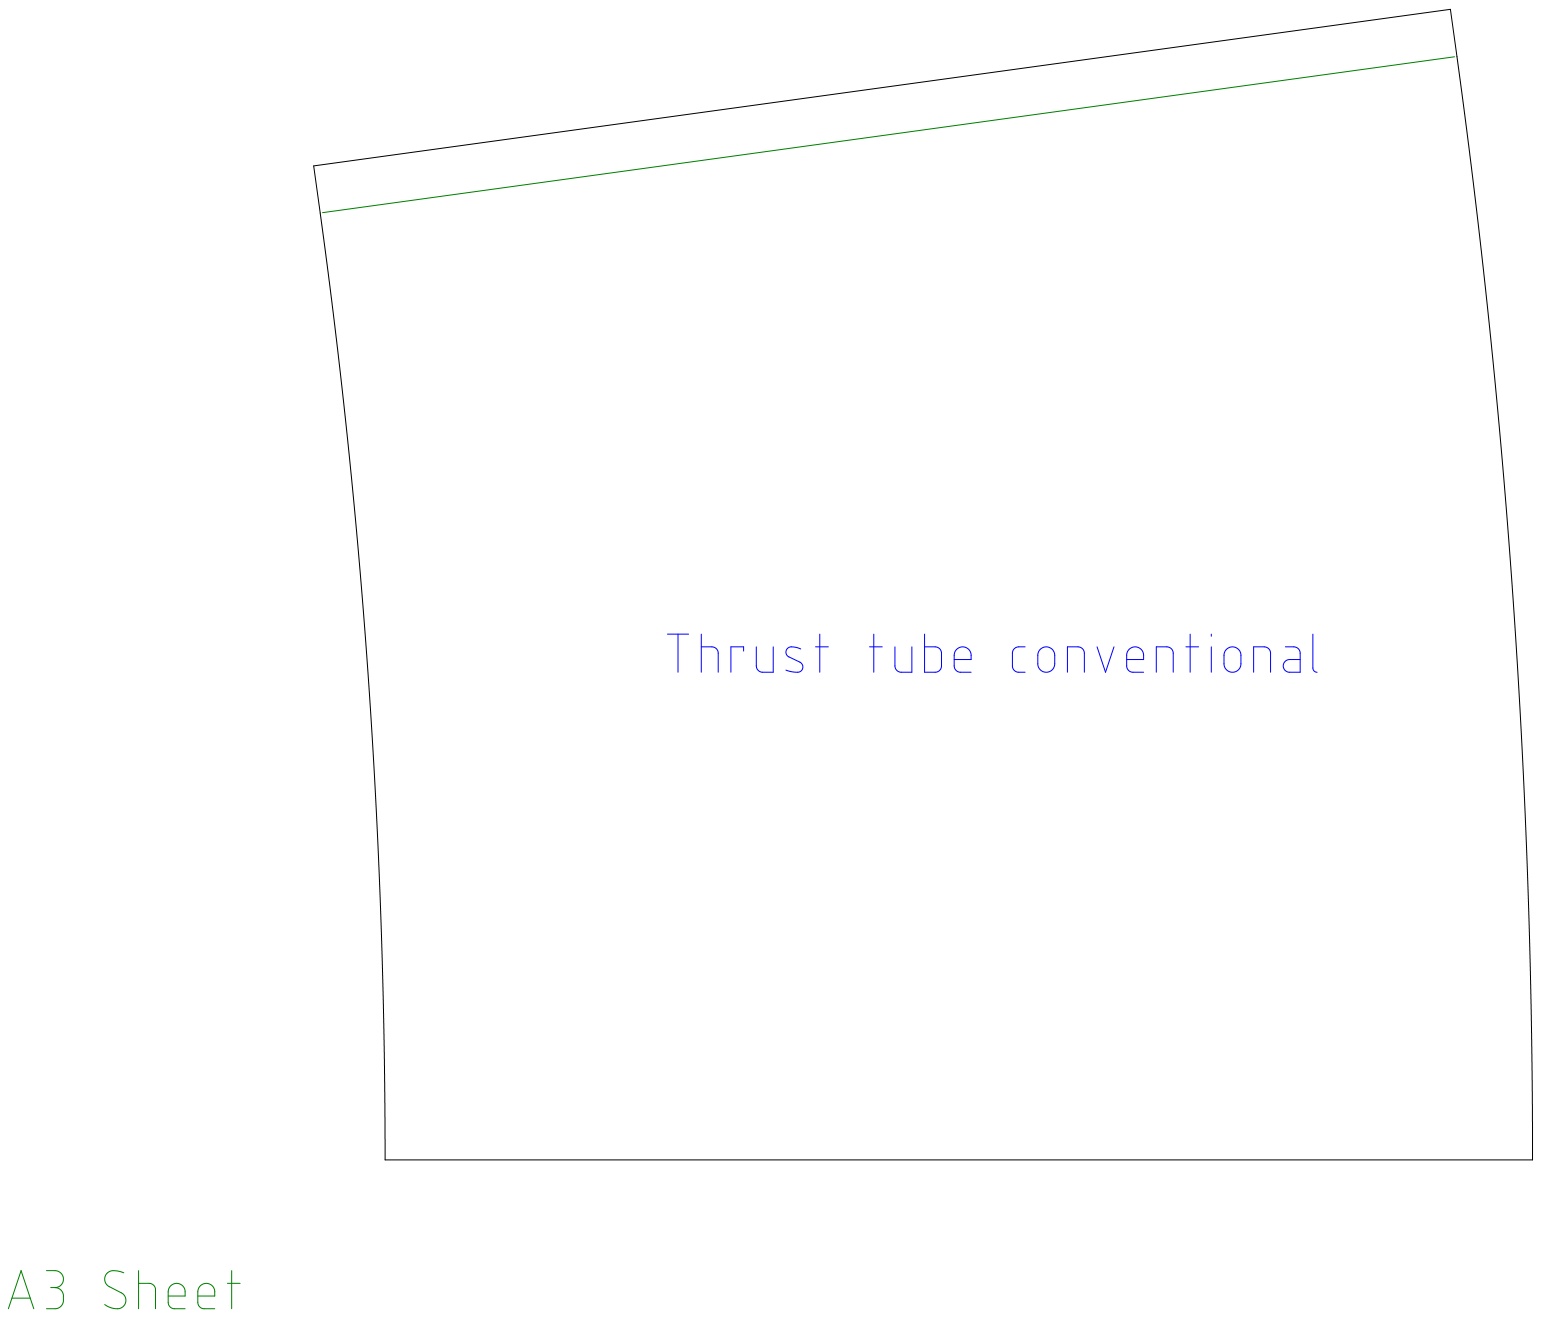
[picture p39: page 1]
