Meyerflitedesign/SU-30/Sheets/PDF/thrust_tube_vectored.pdf

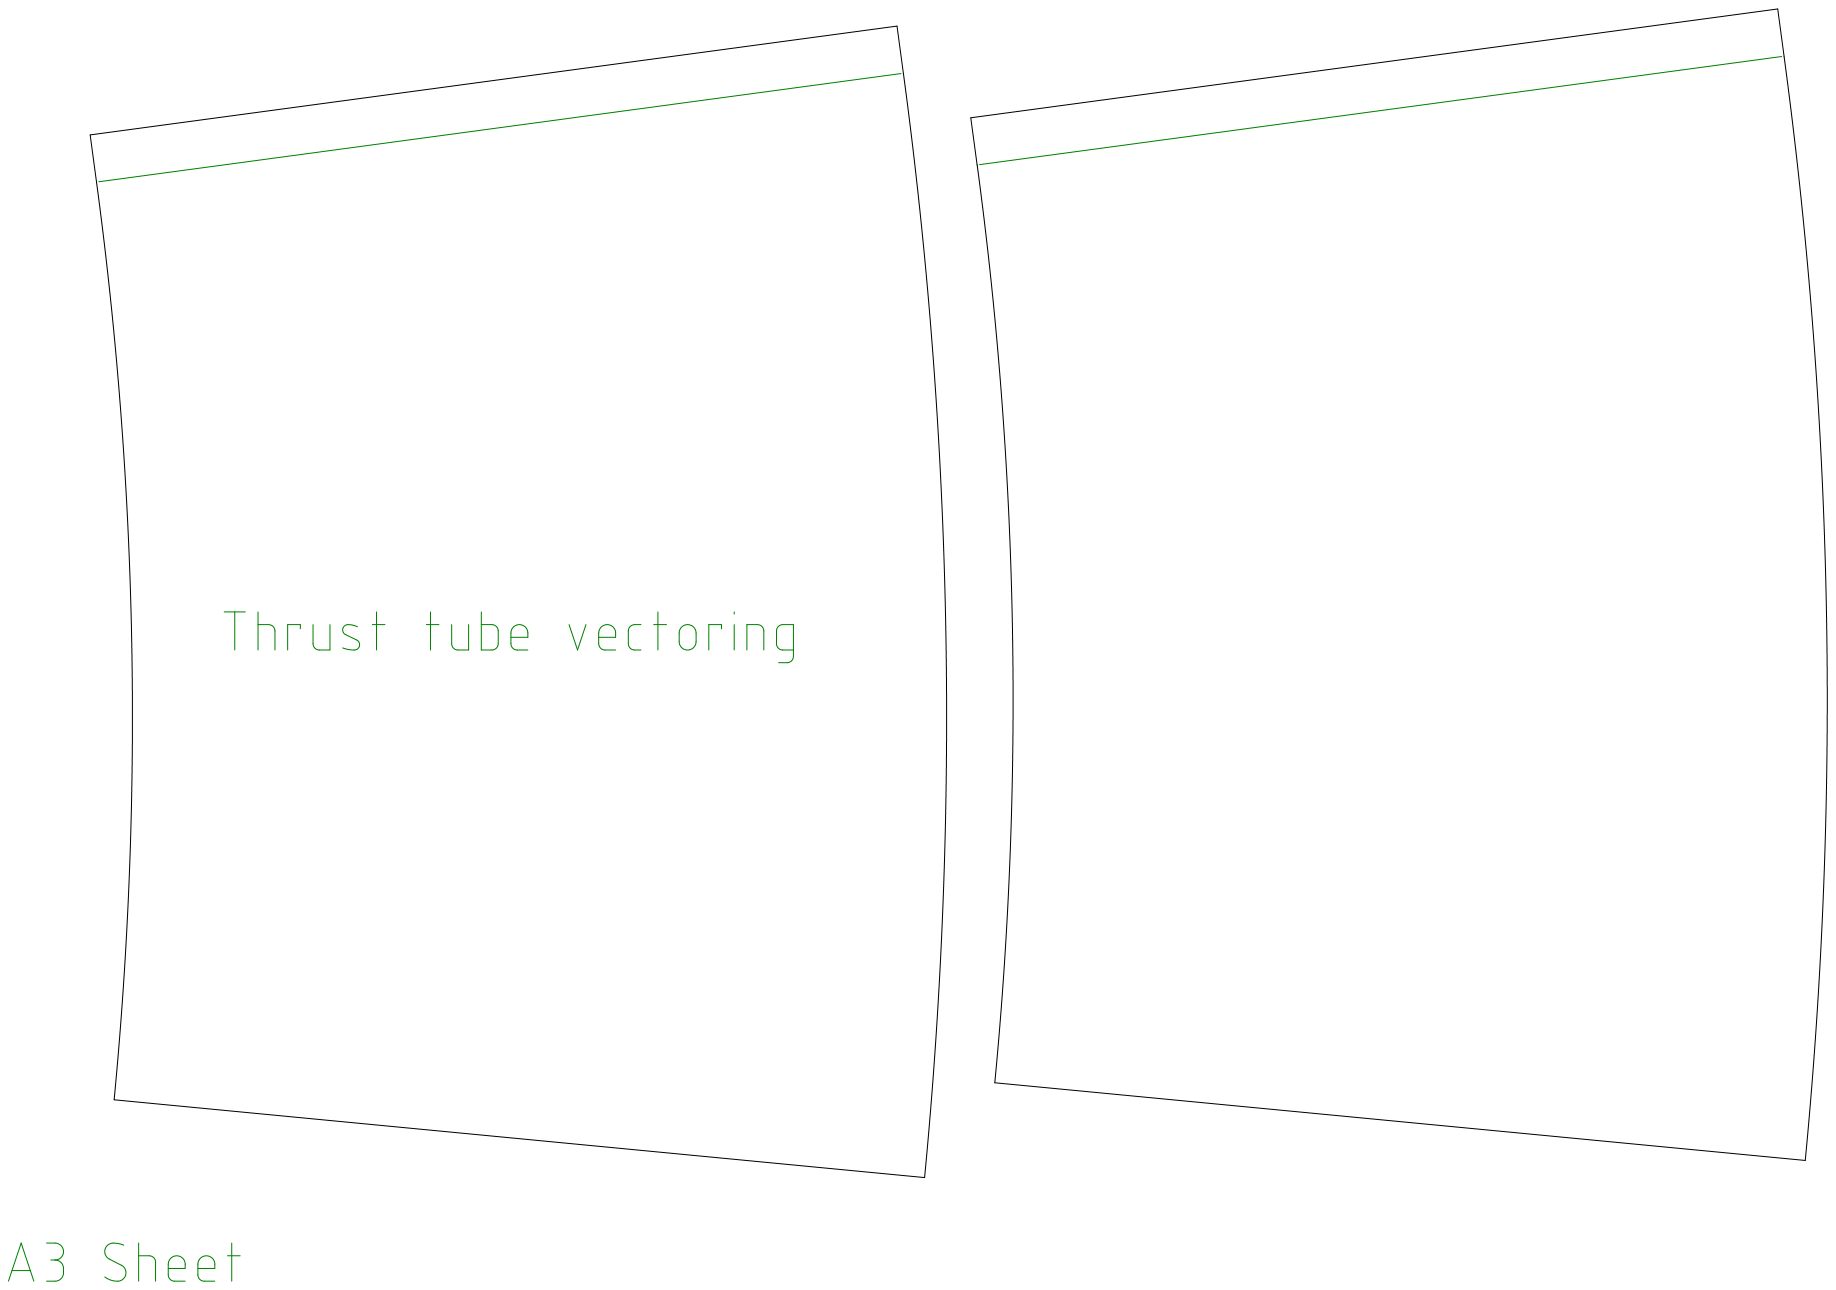
[picture p40: page 1]
