Meyerflitedesign/SU-30/Sheets/PDF_tiled/Sheet1.pdf

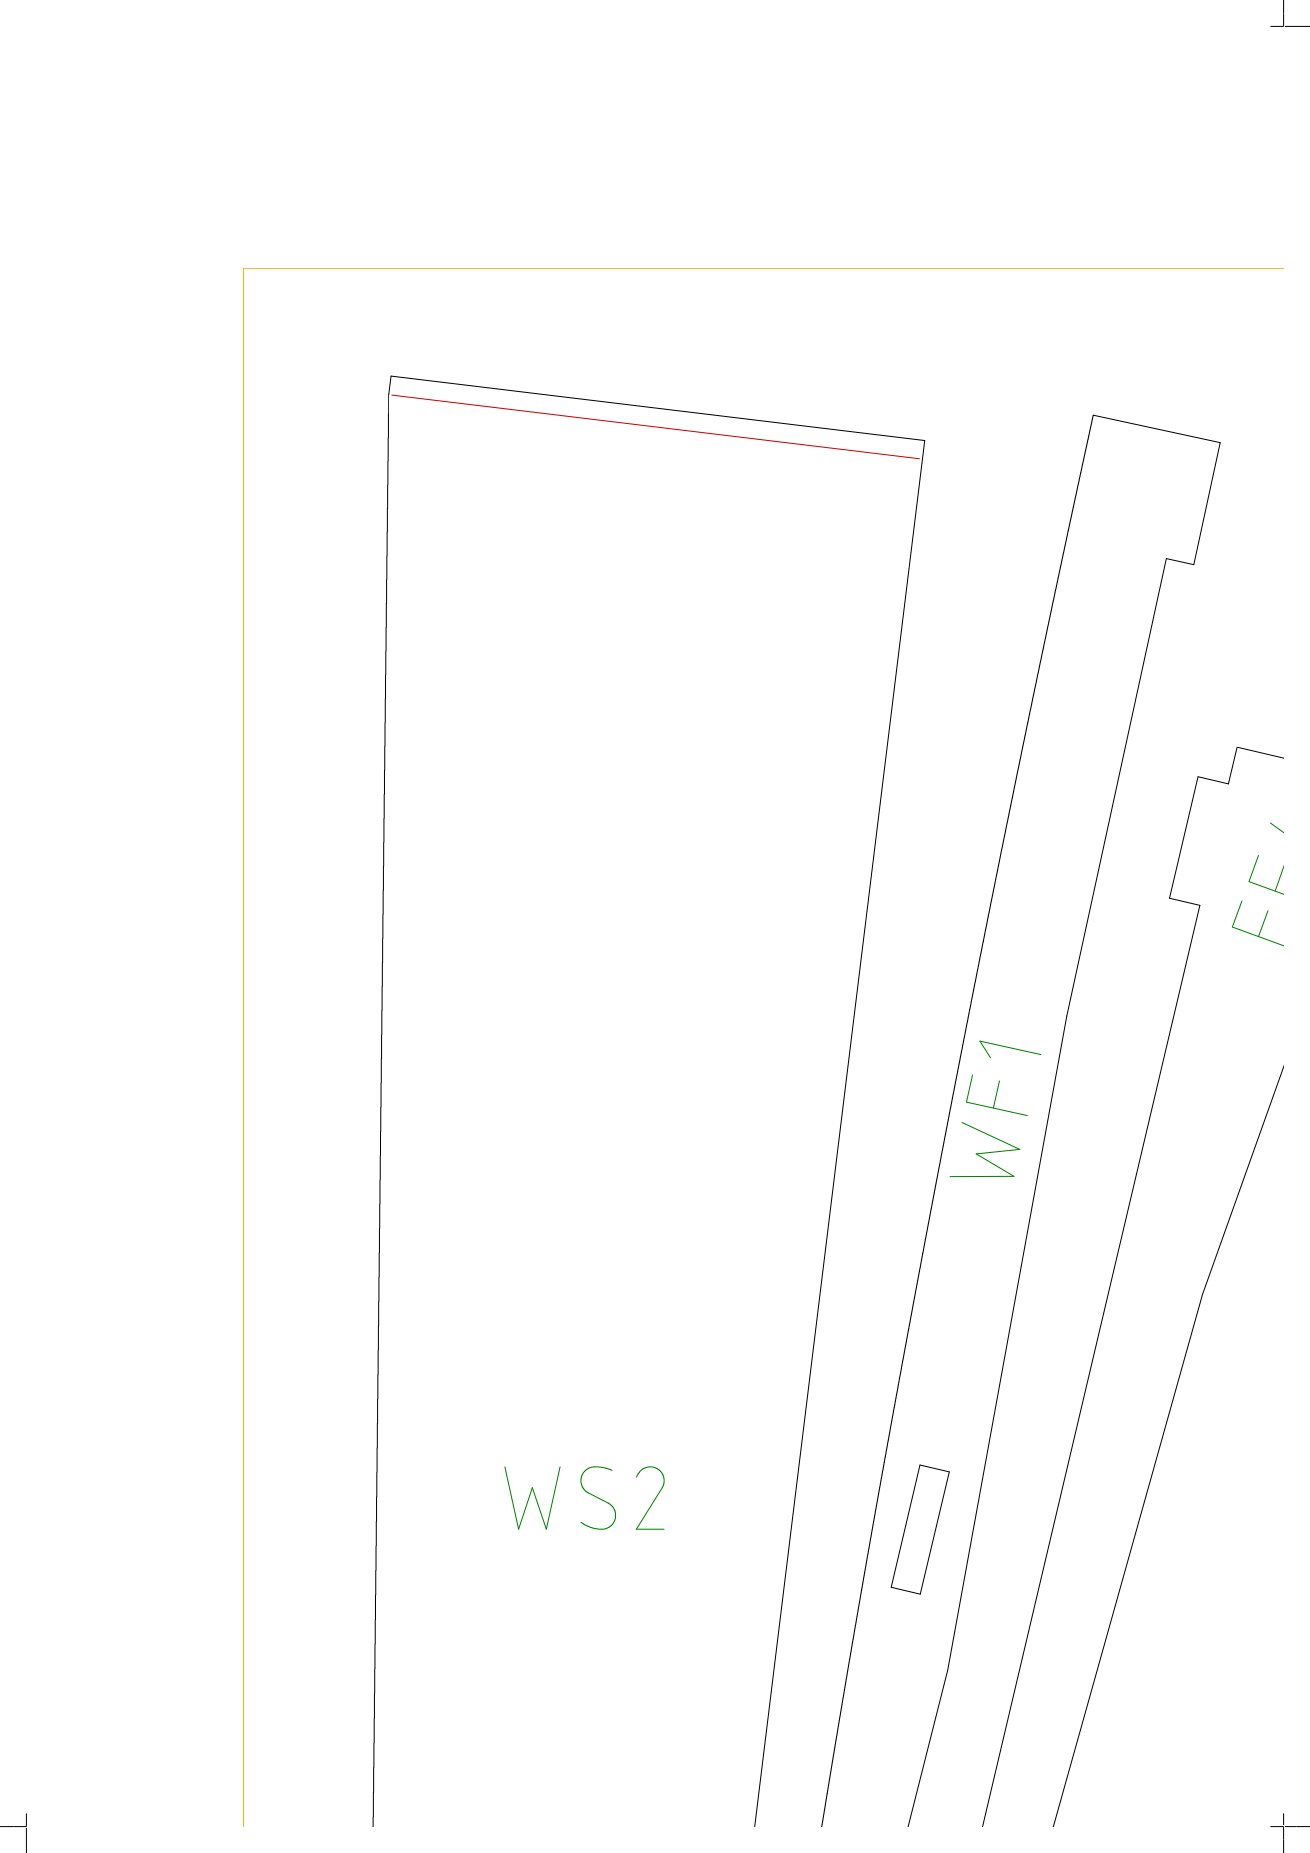
[picture p41: page 1]

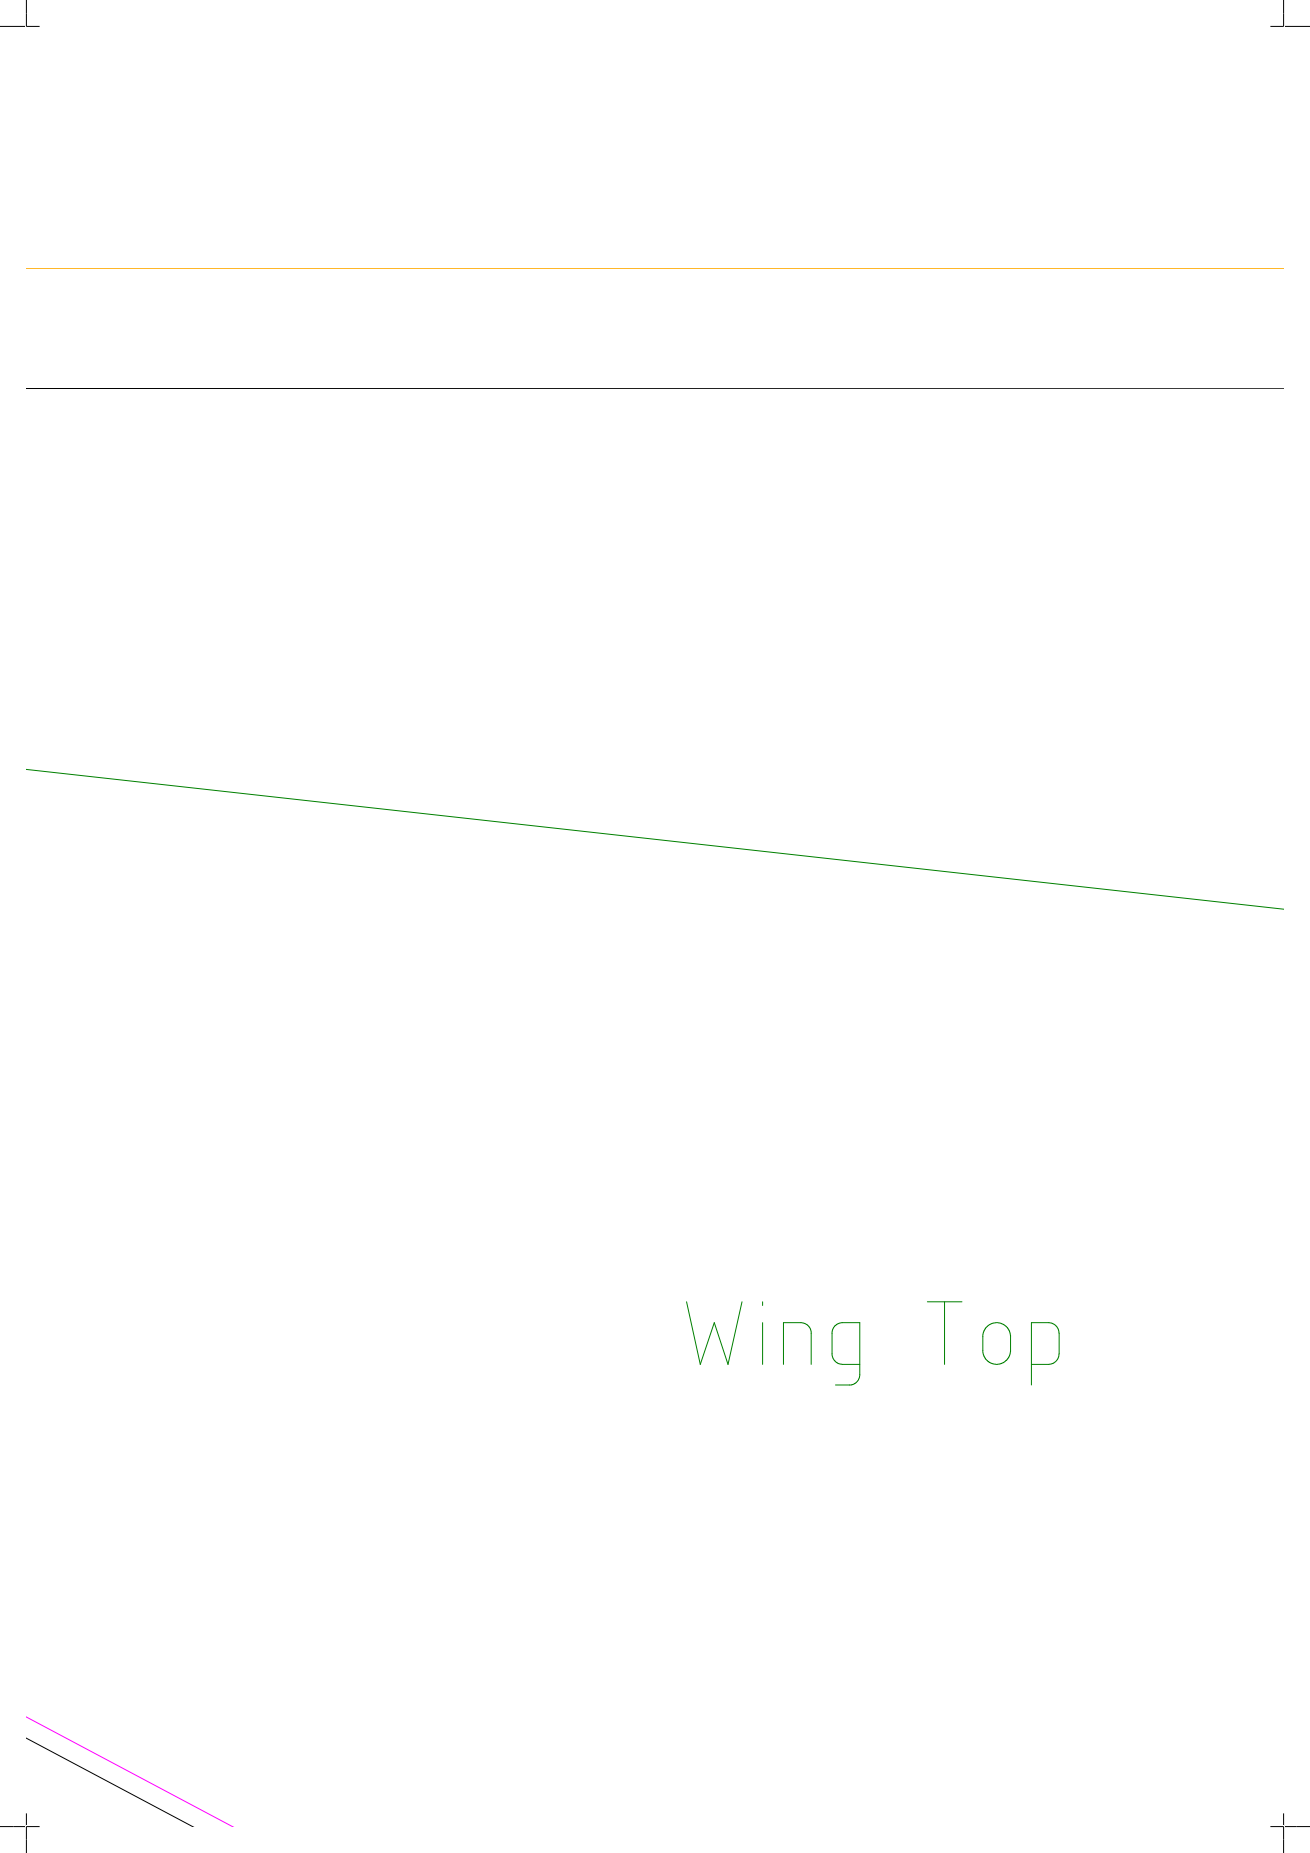
[picture p42: page 3]

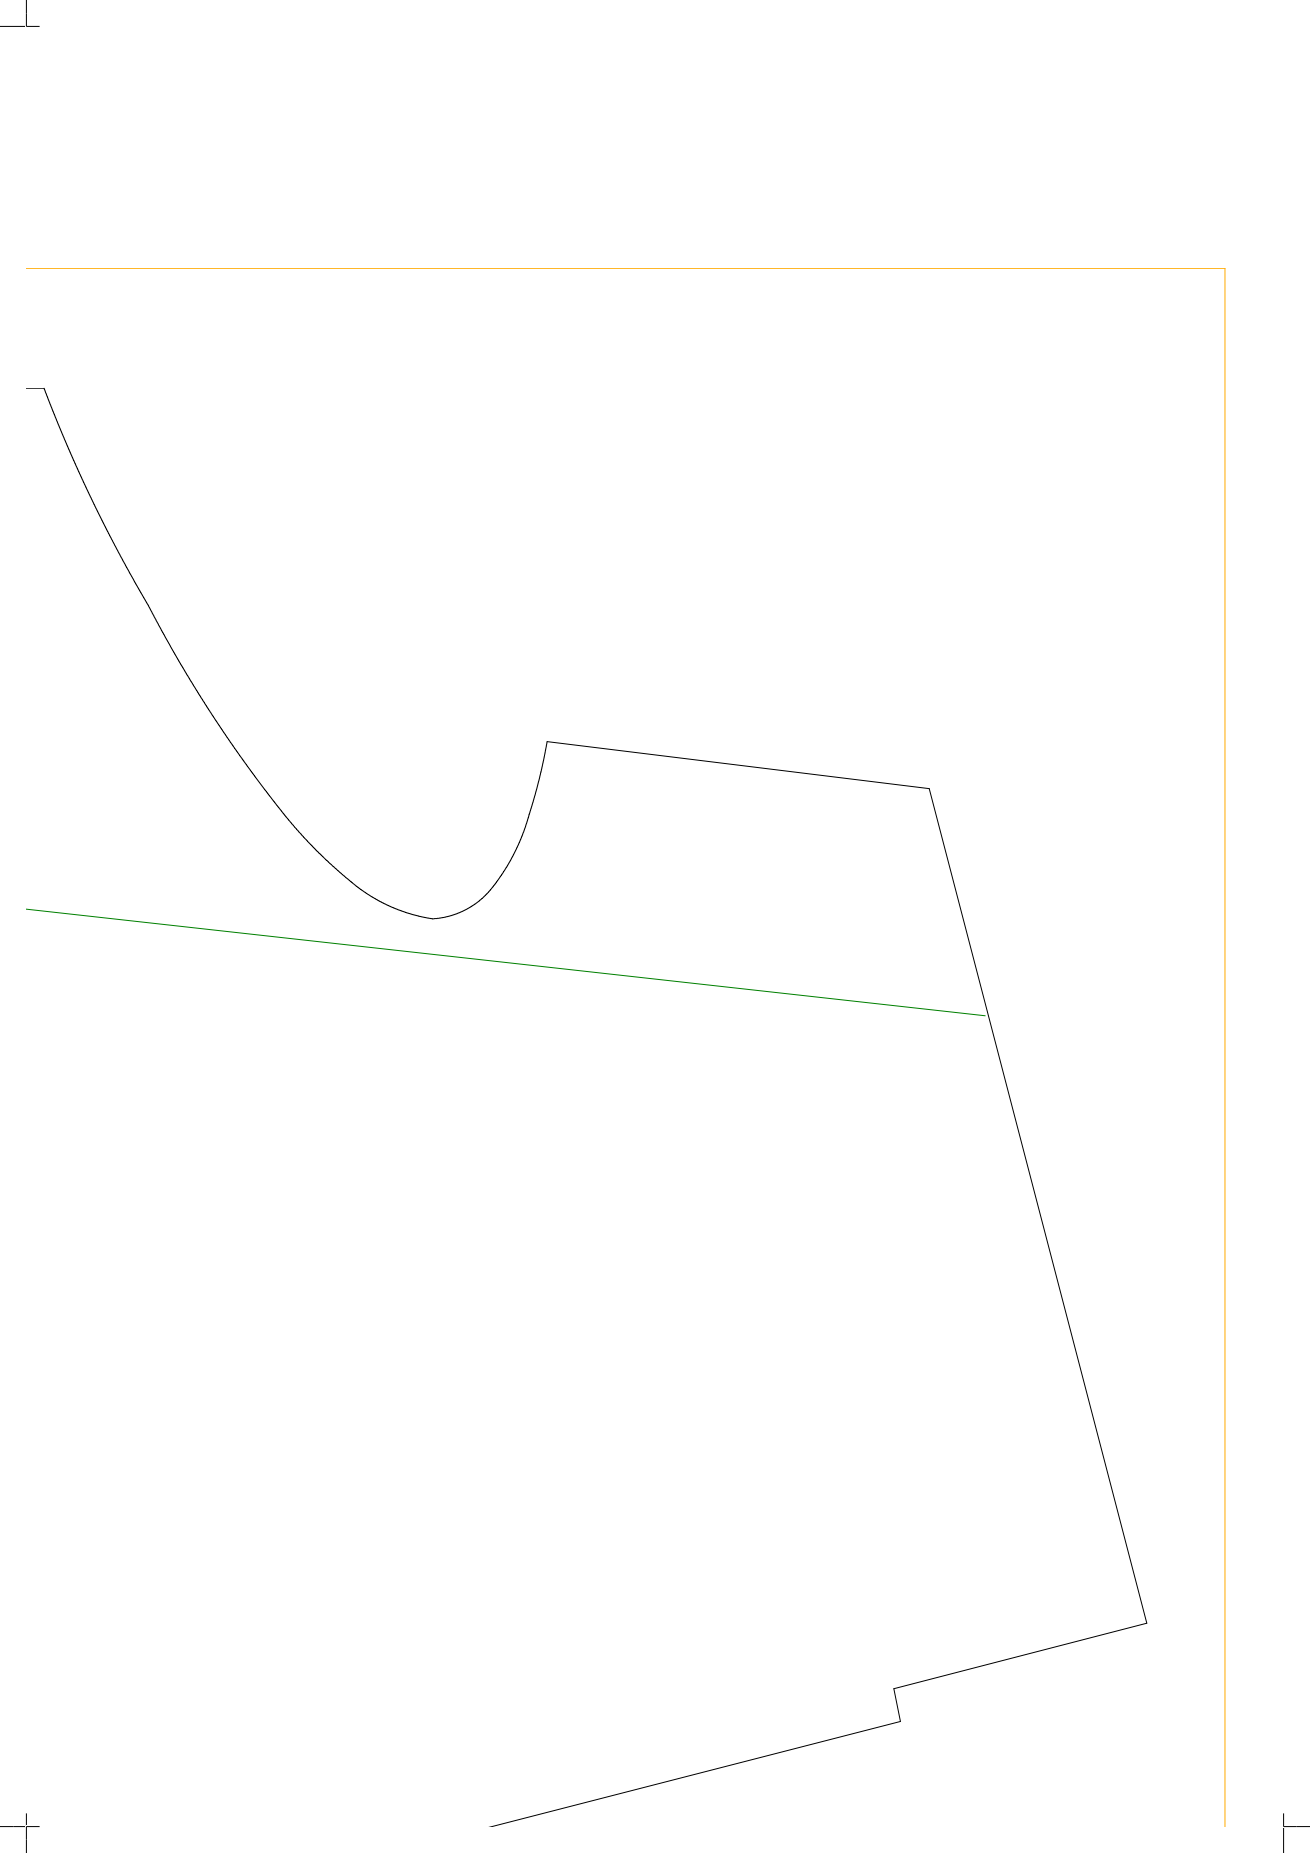
[picture p43: page 4]

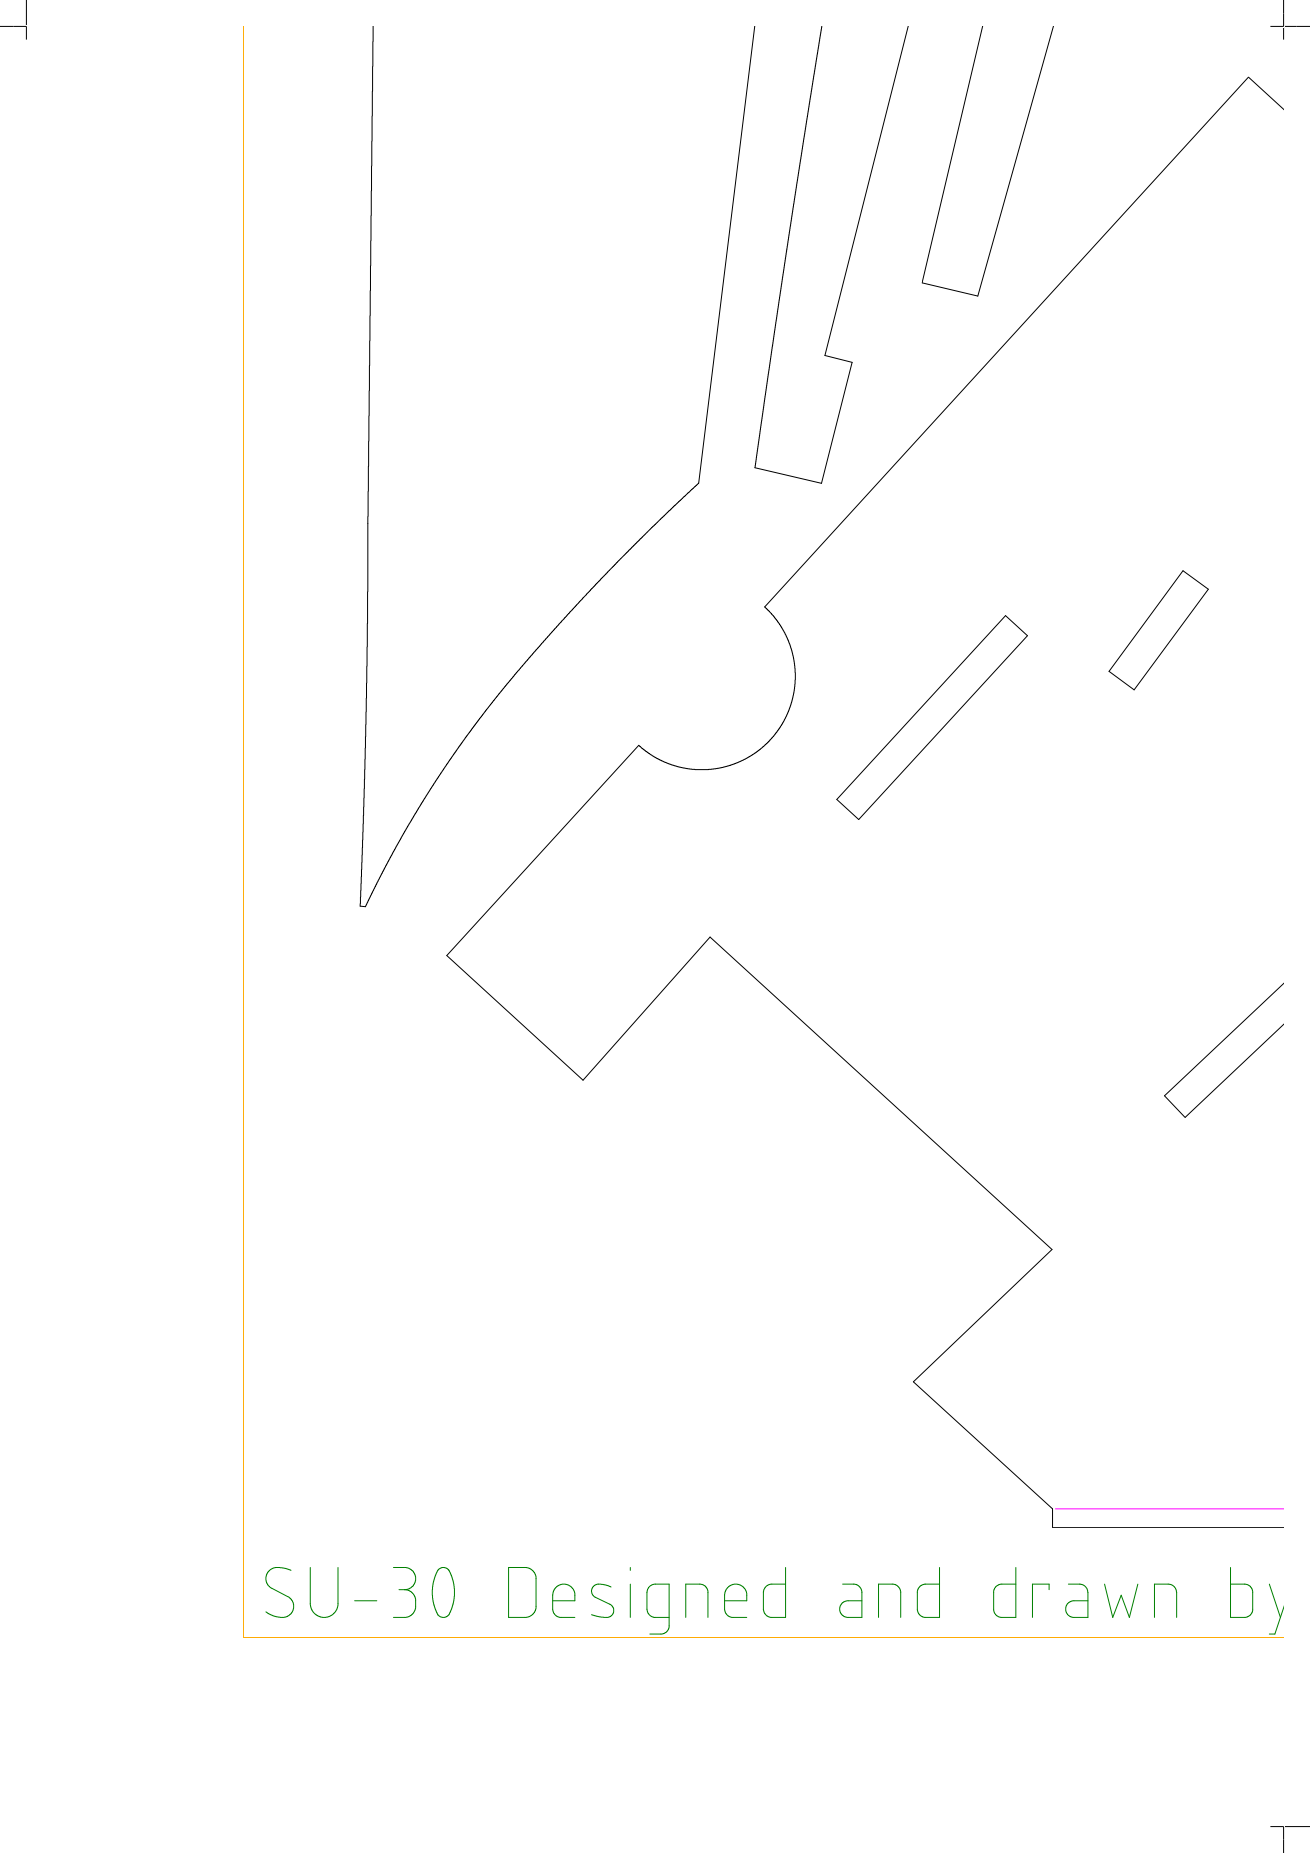
[picture p44: page 5]

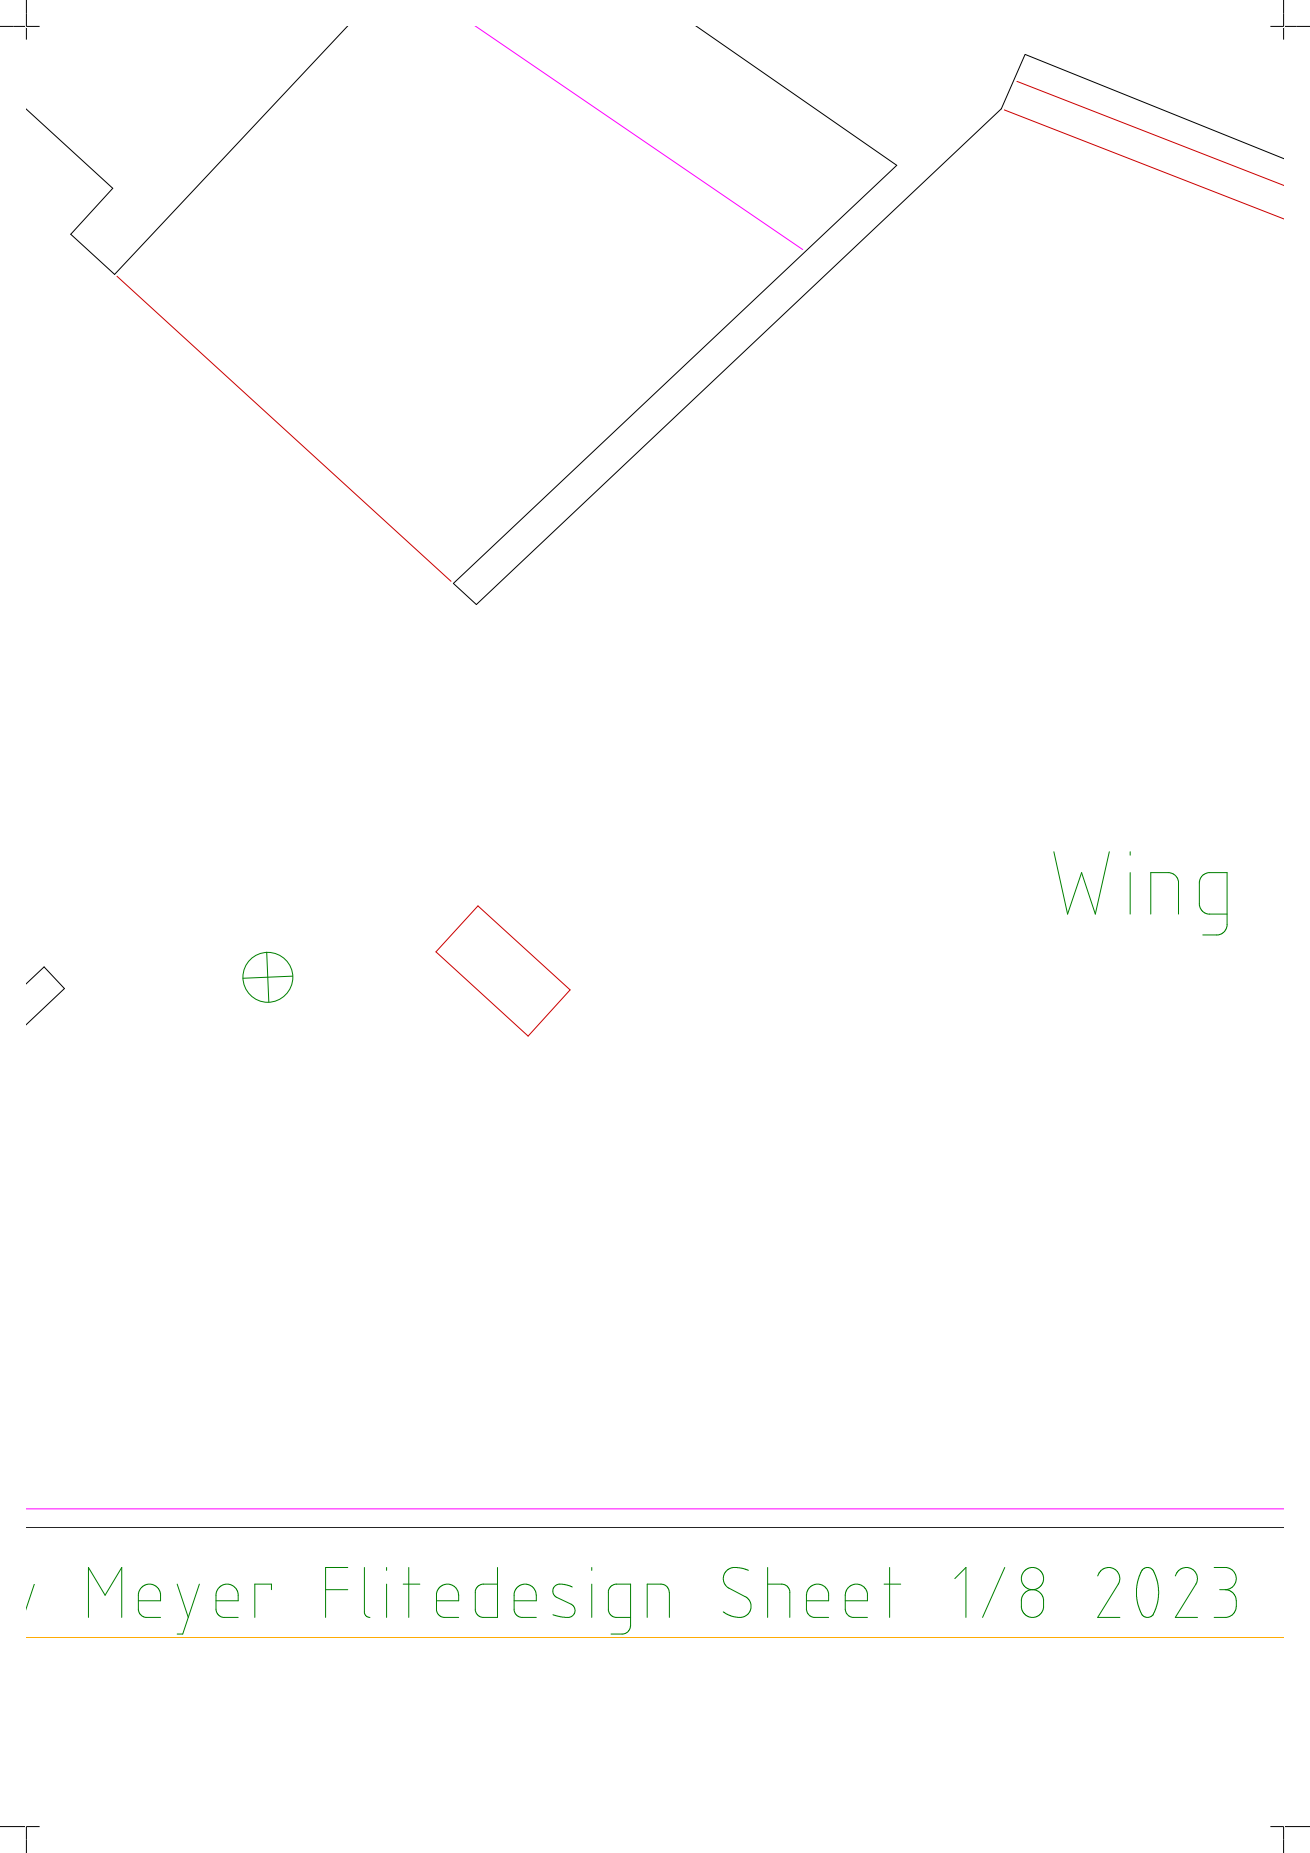
[picture p45: page 6]

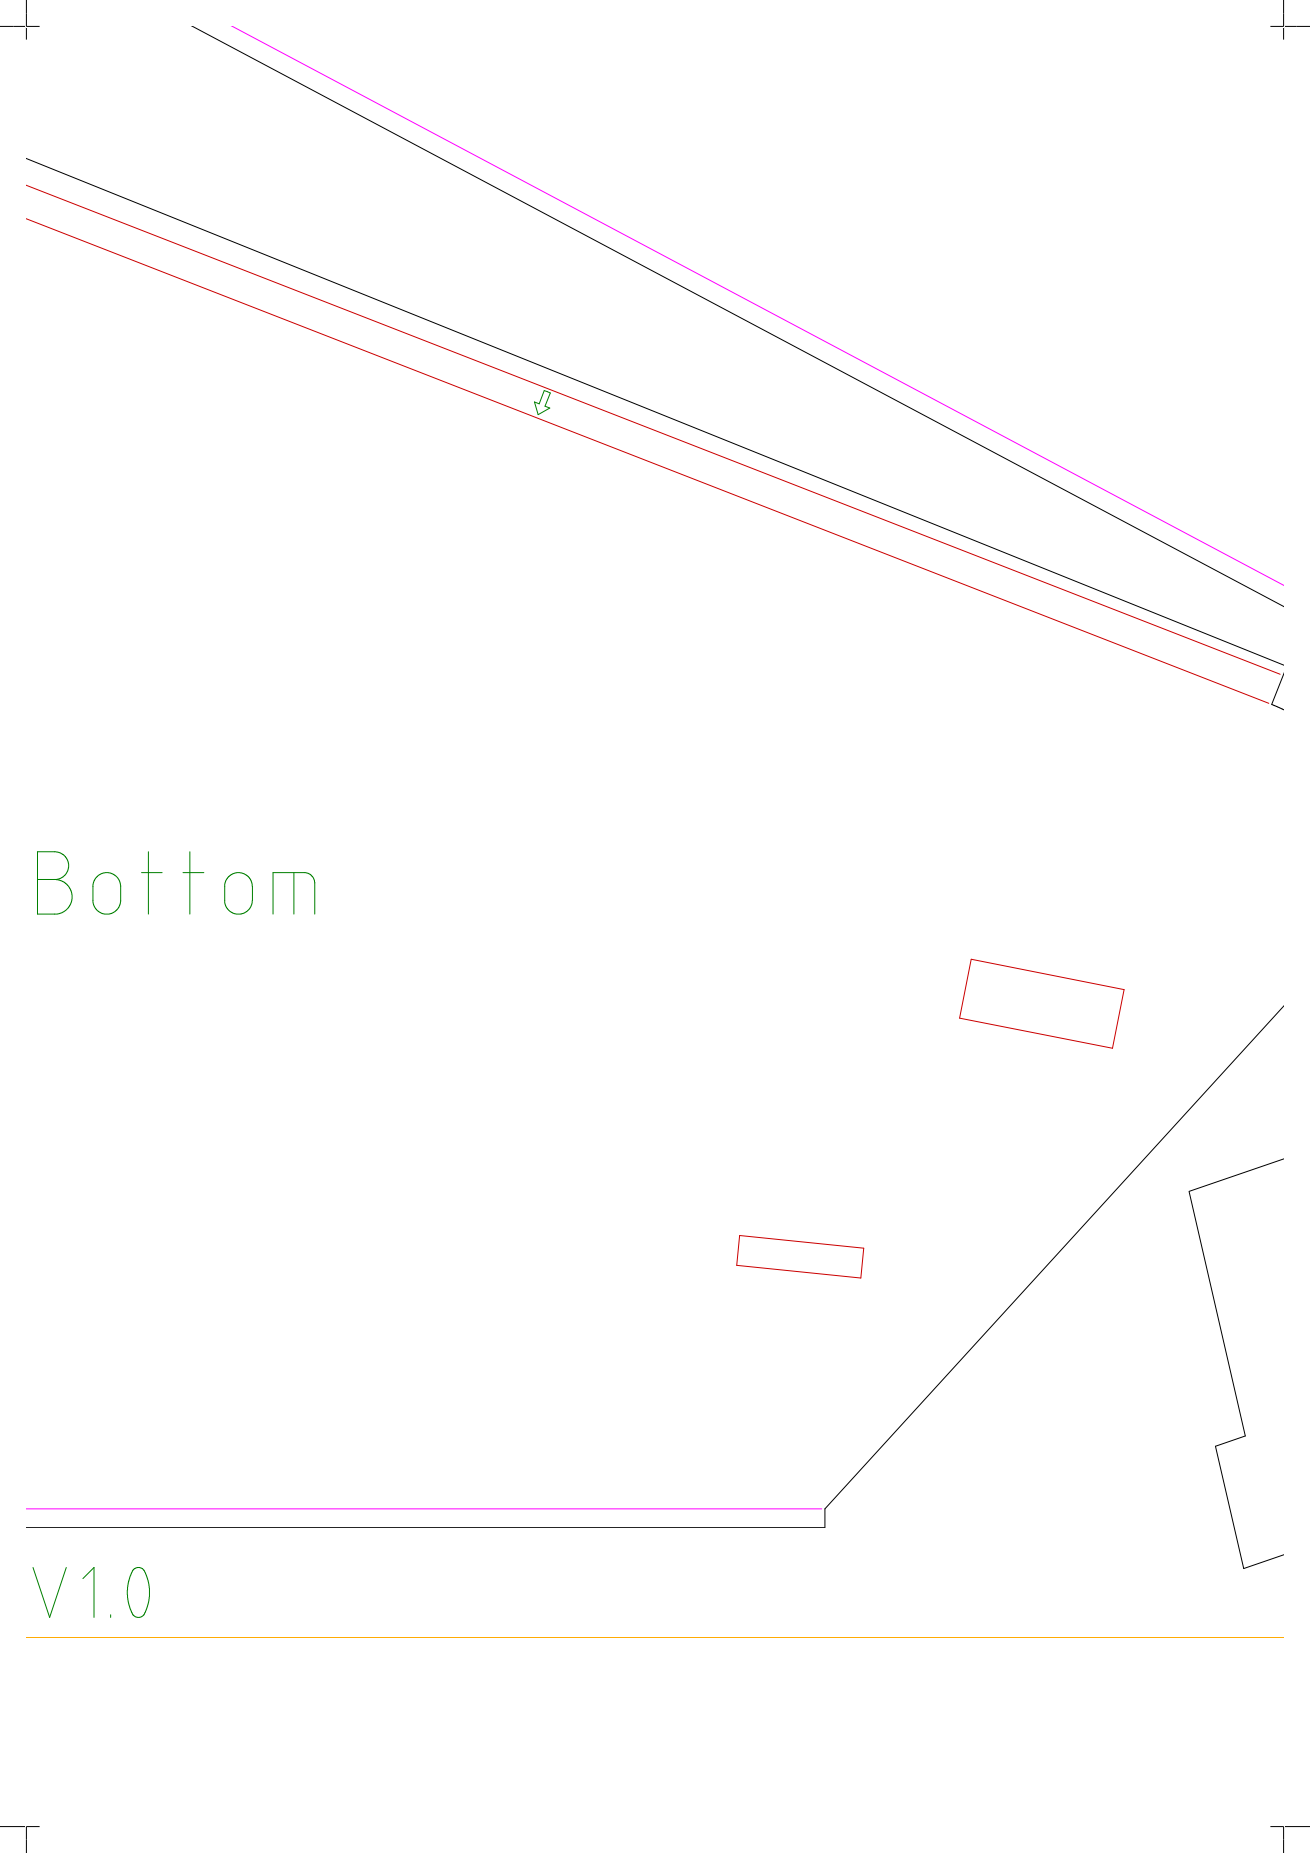
[picture p46: page 7]

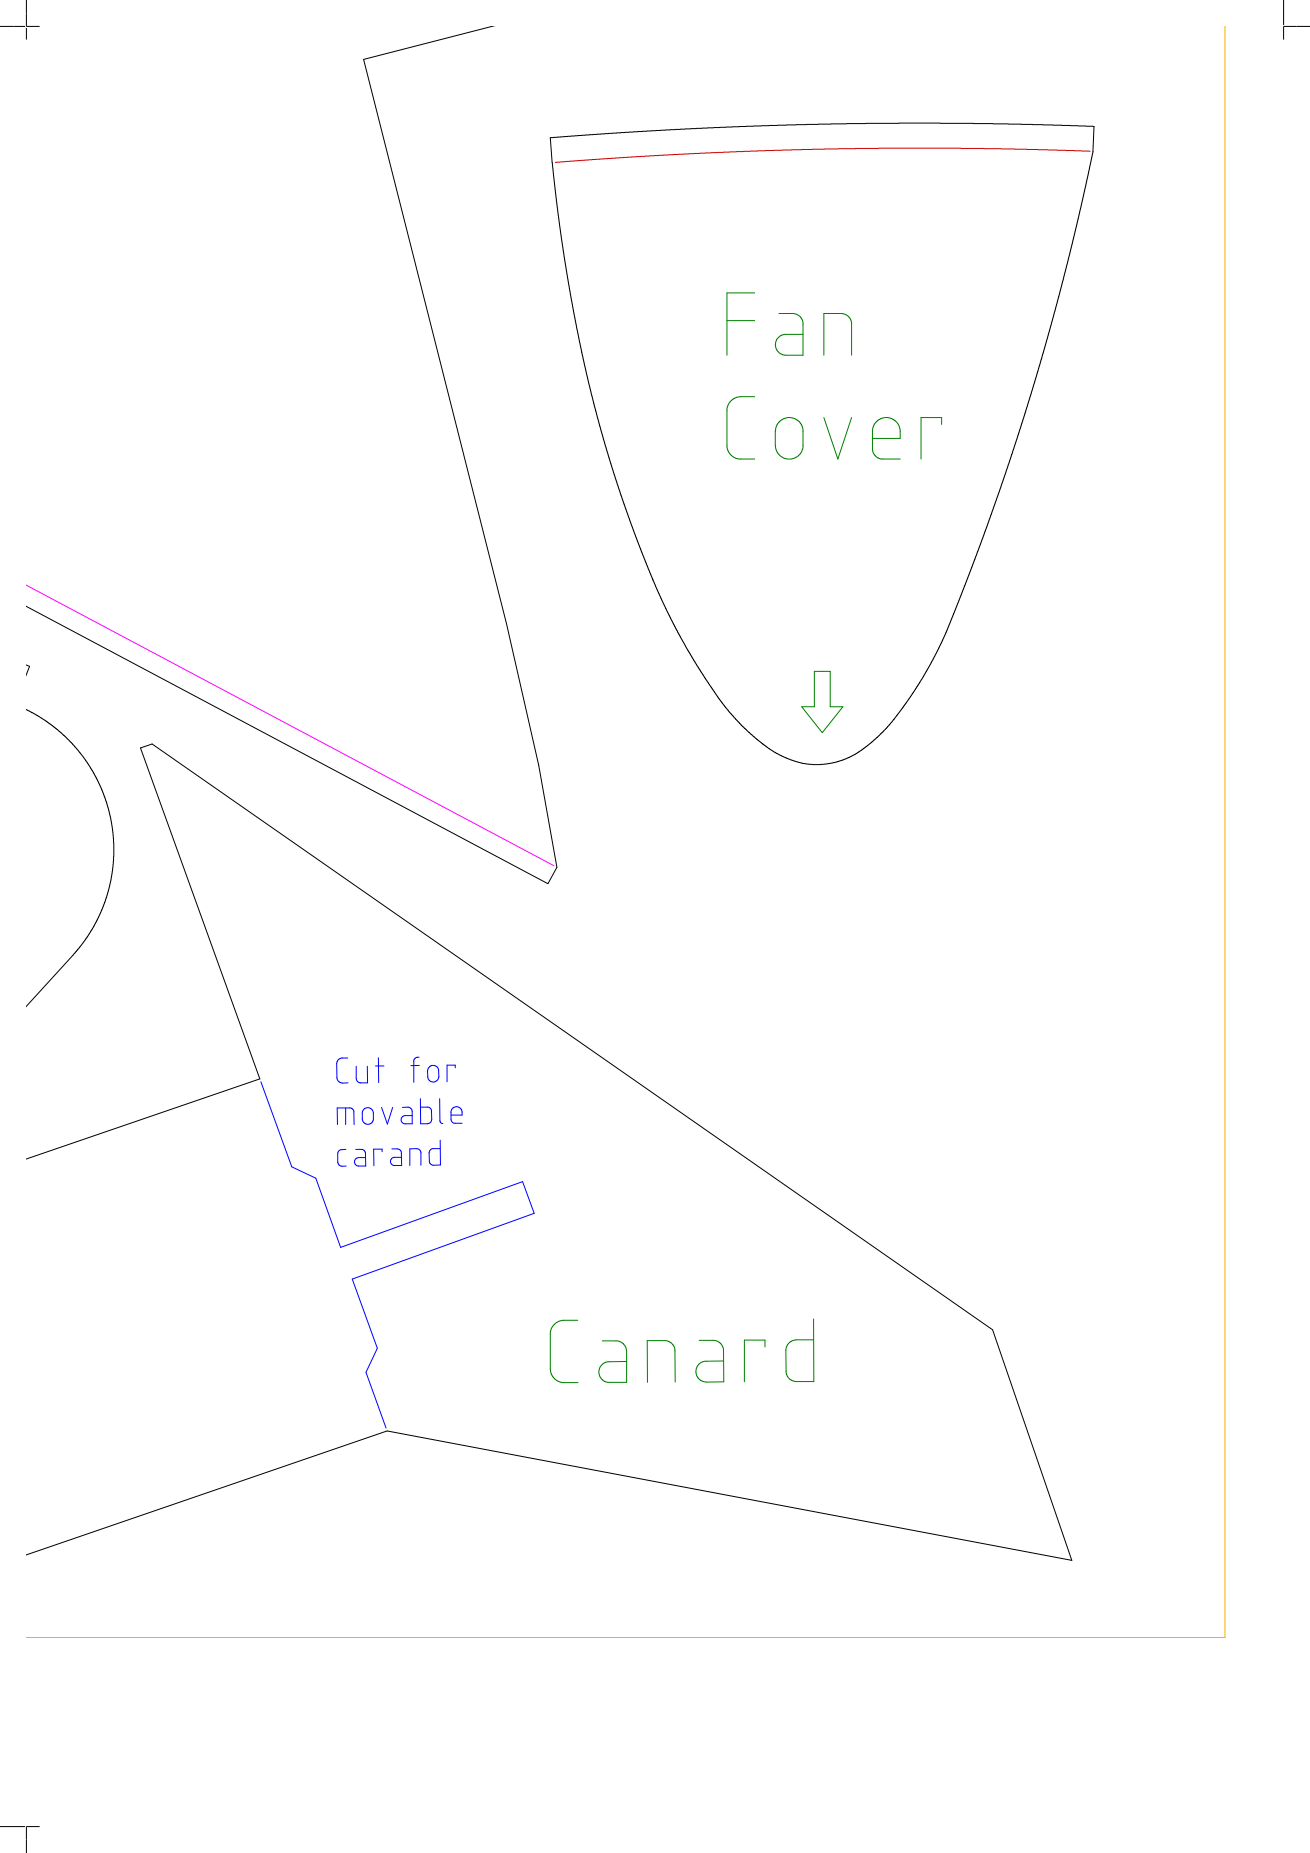
[picture p47: page 8]
