Meyerflitedesign/SU-30/Sheets/PDF_tiled/Sheet5.pdf

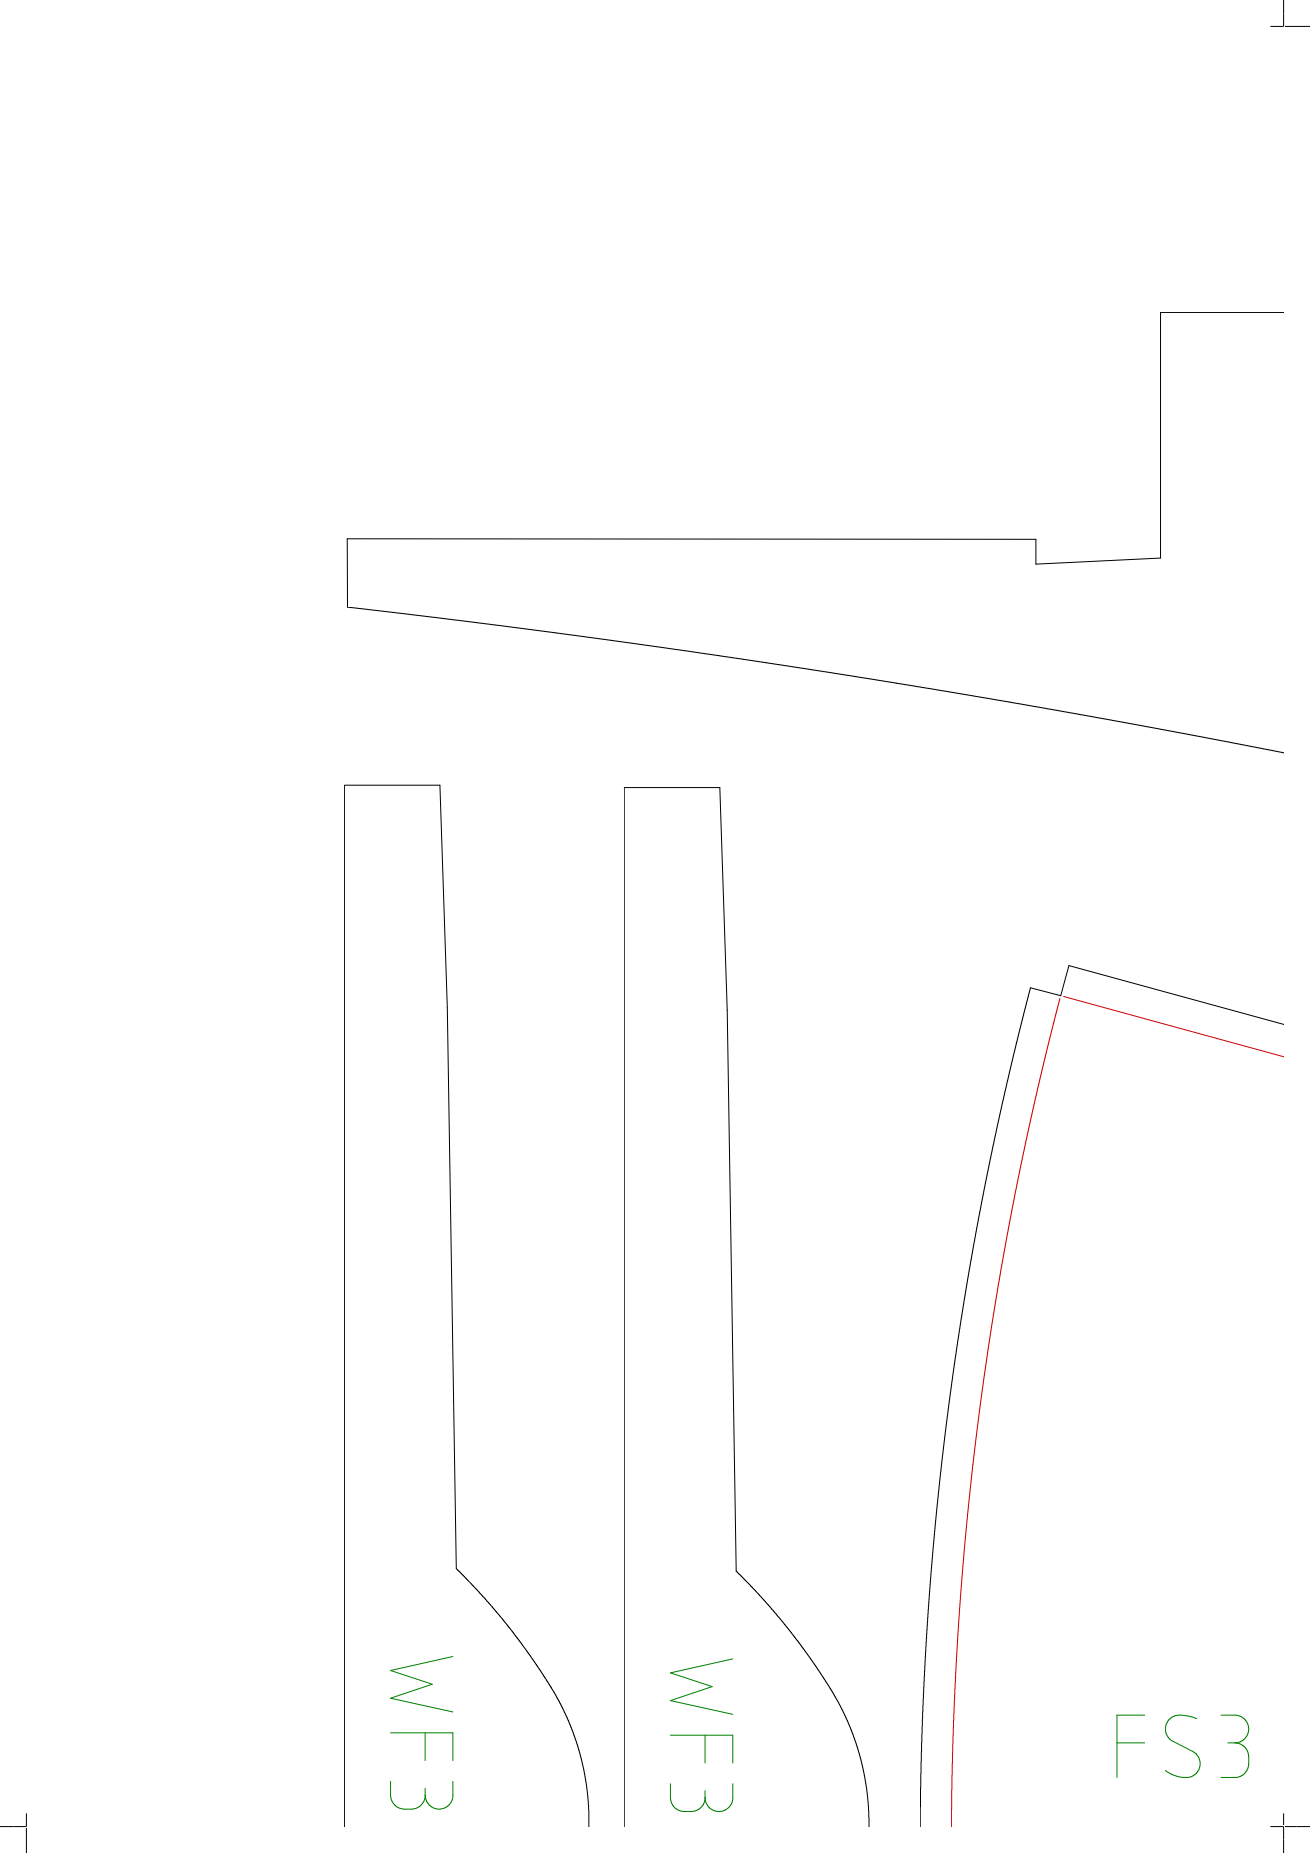
[picture p72: page 1]

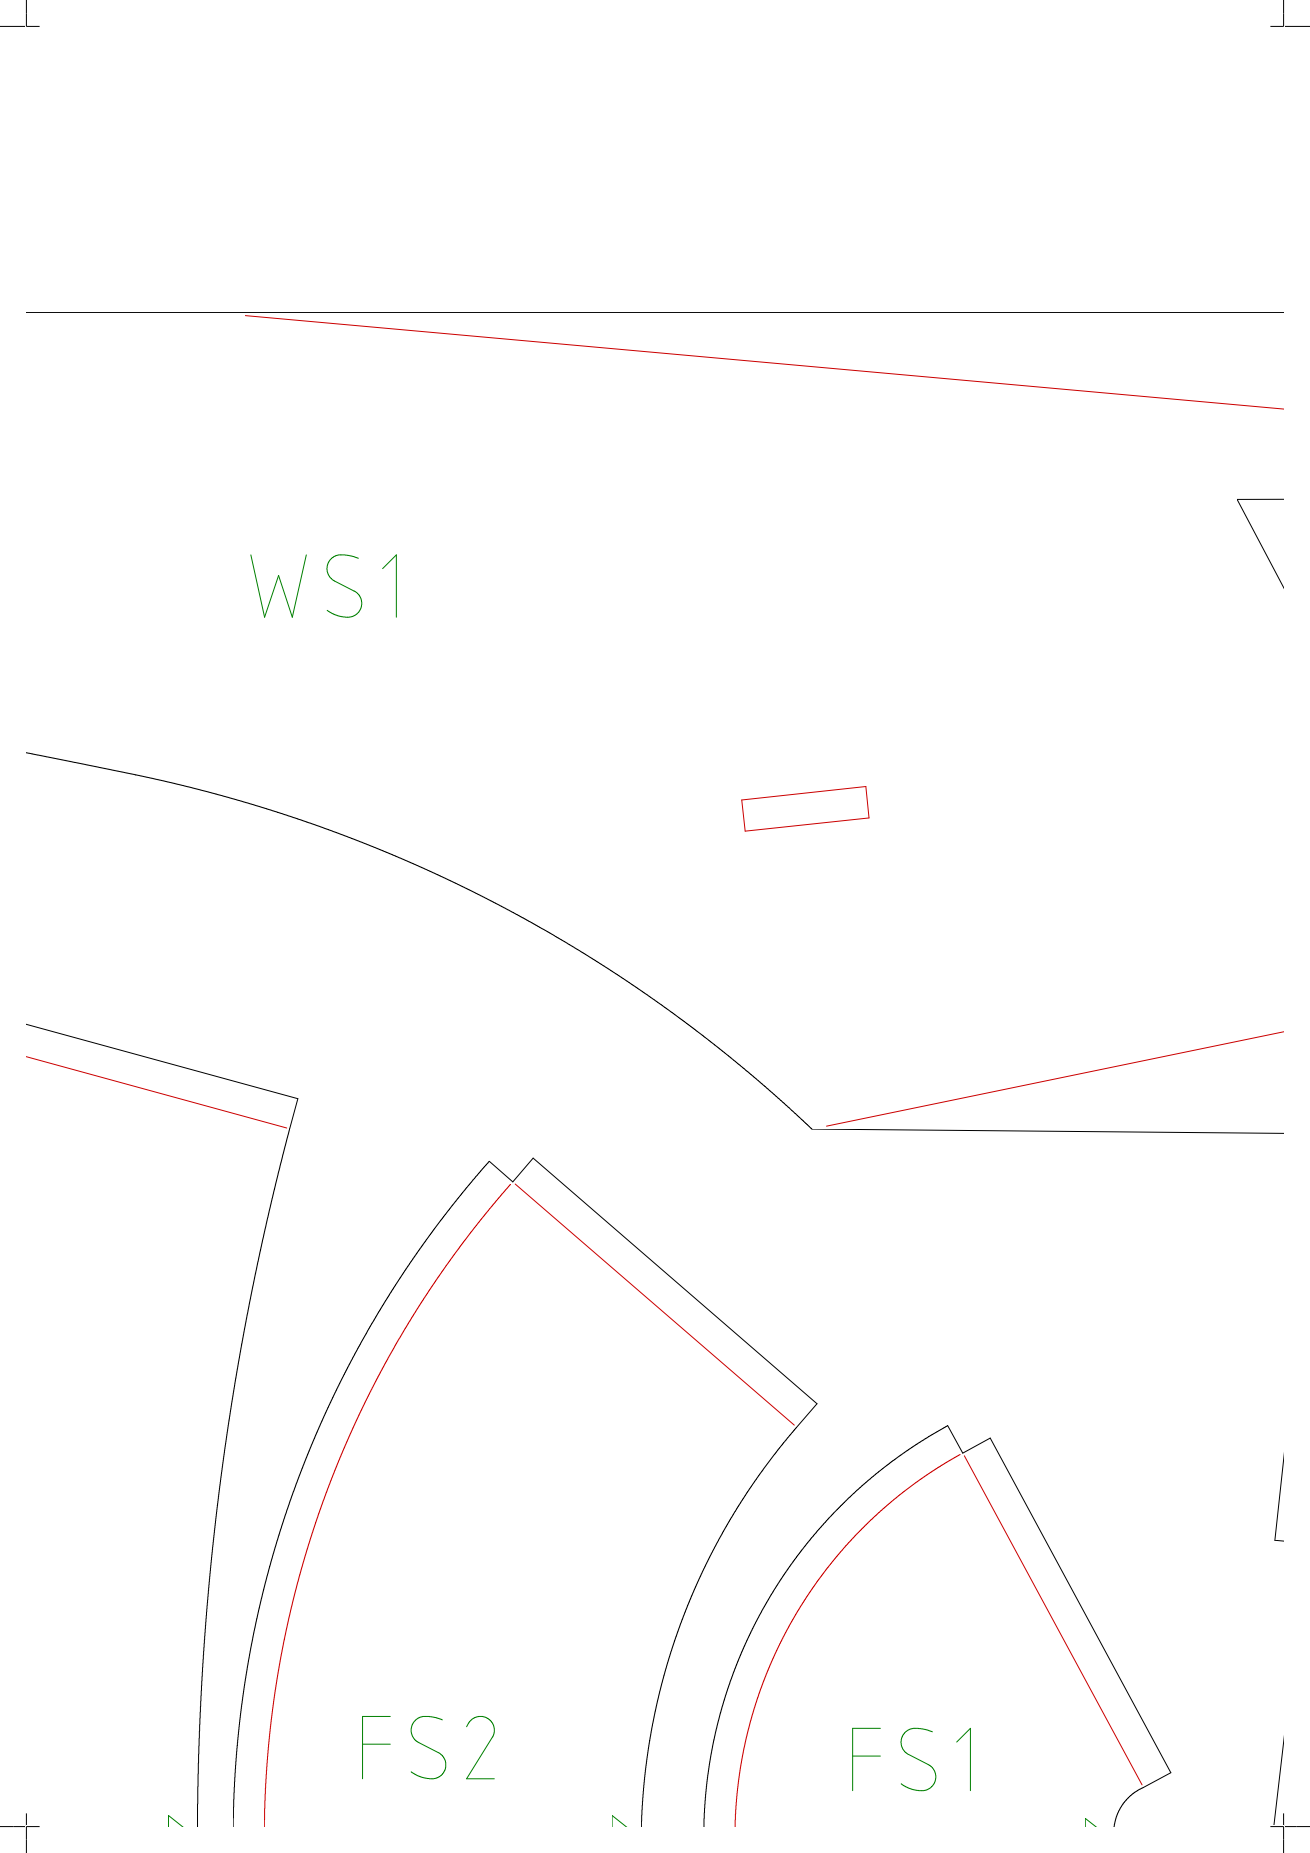
[picture p73: page 2]

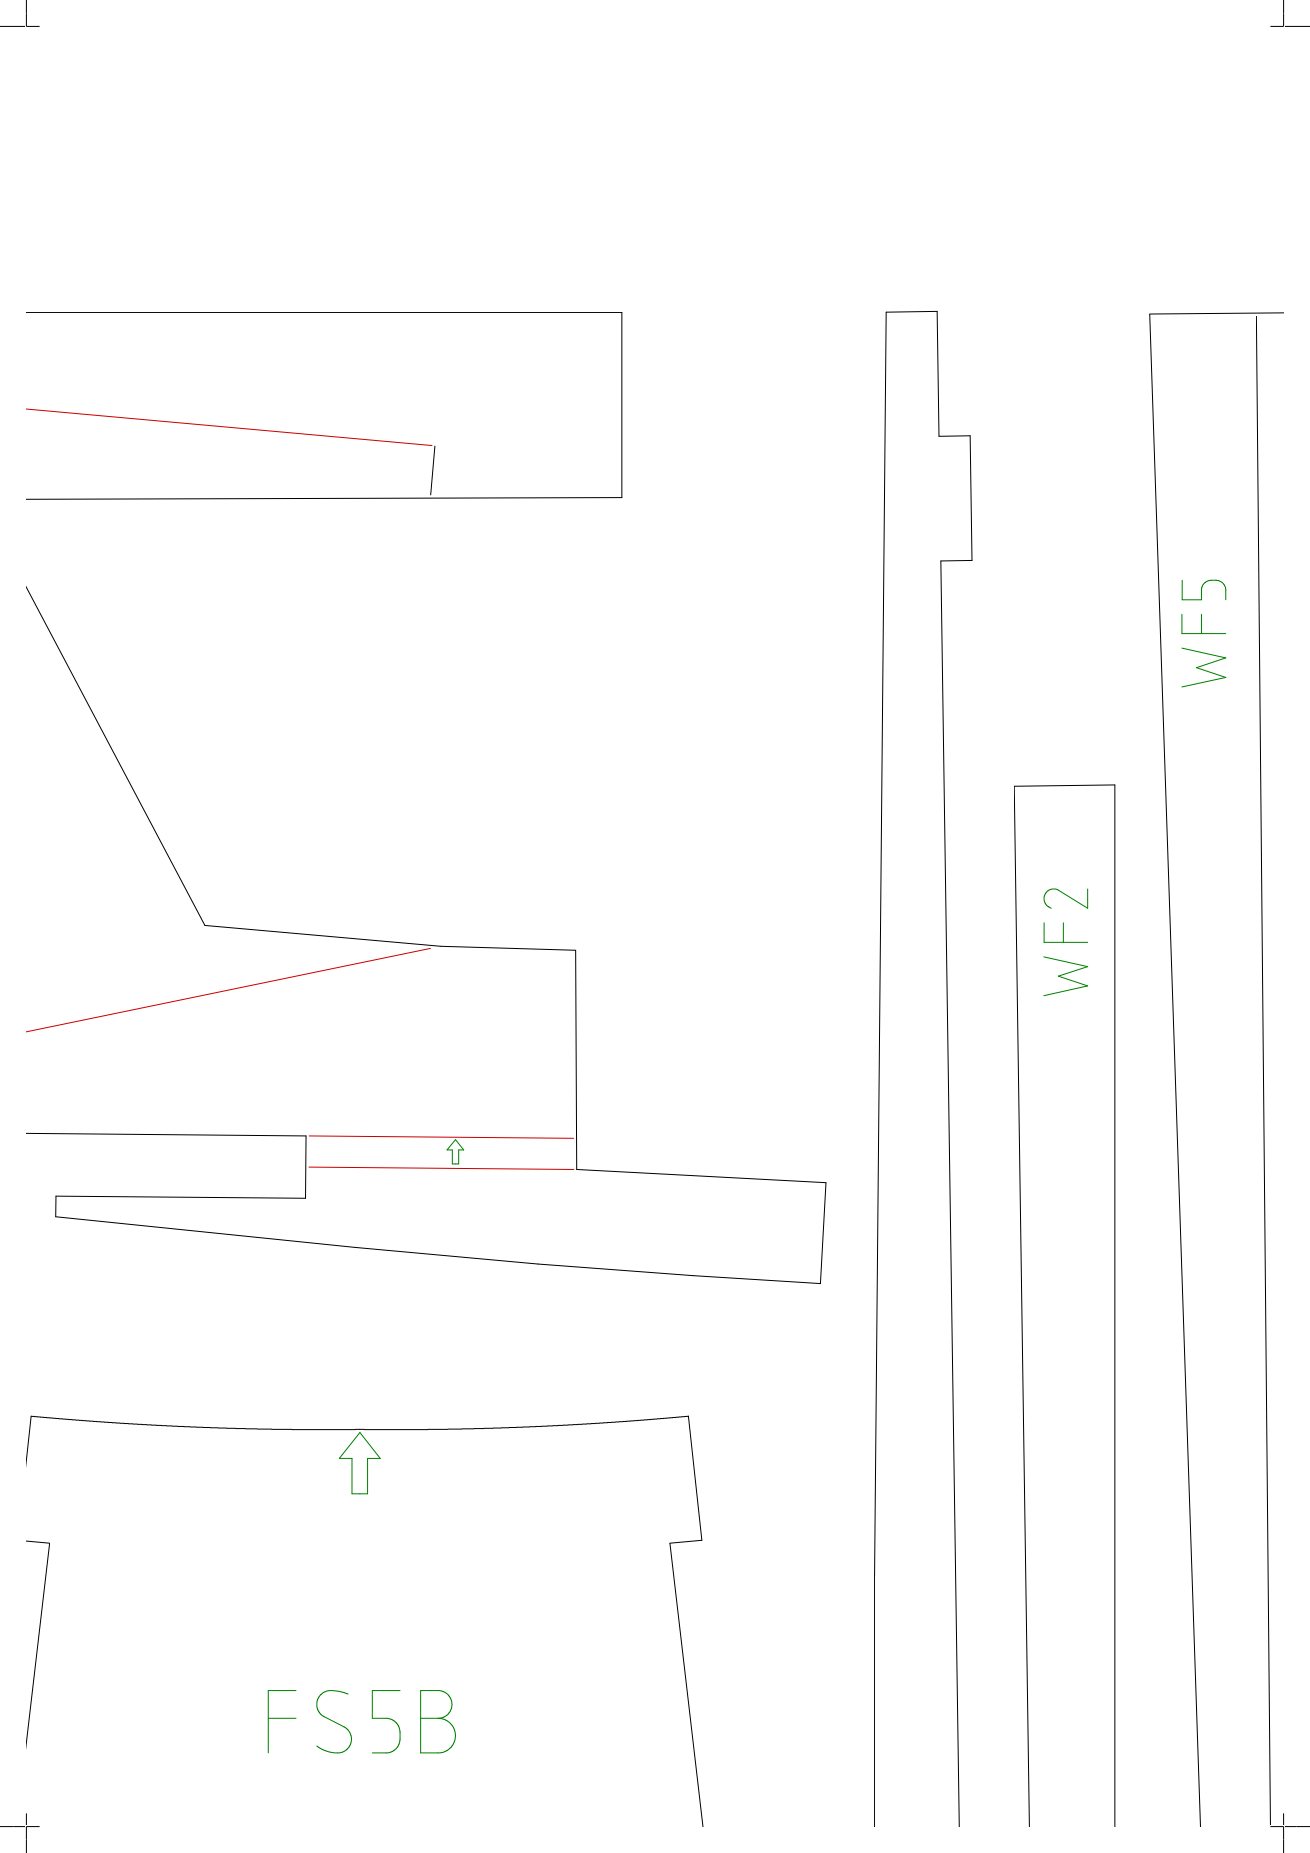
[picture p74: page 3]

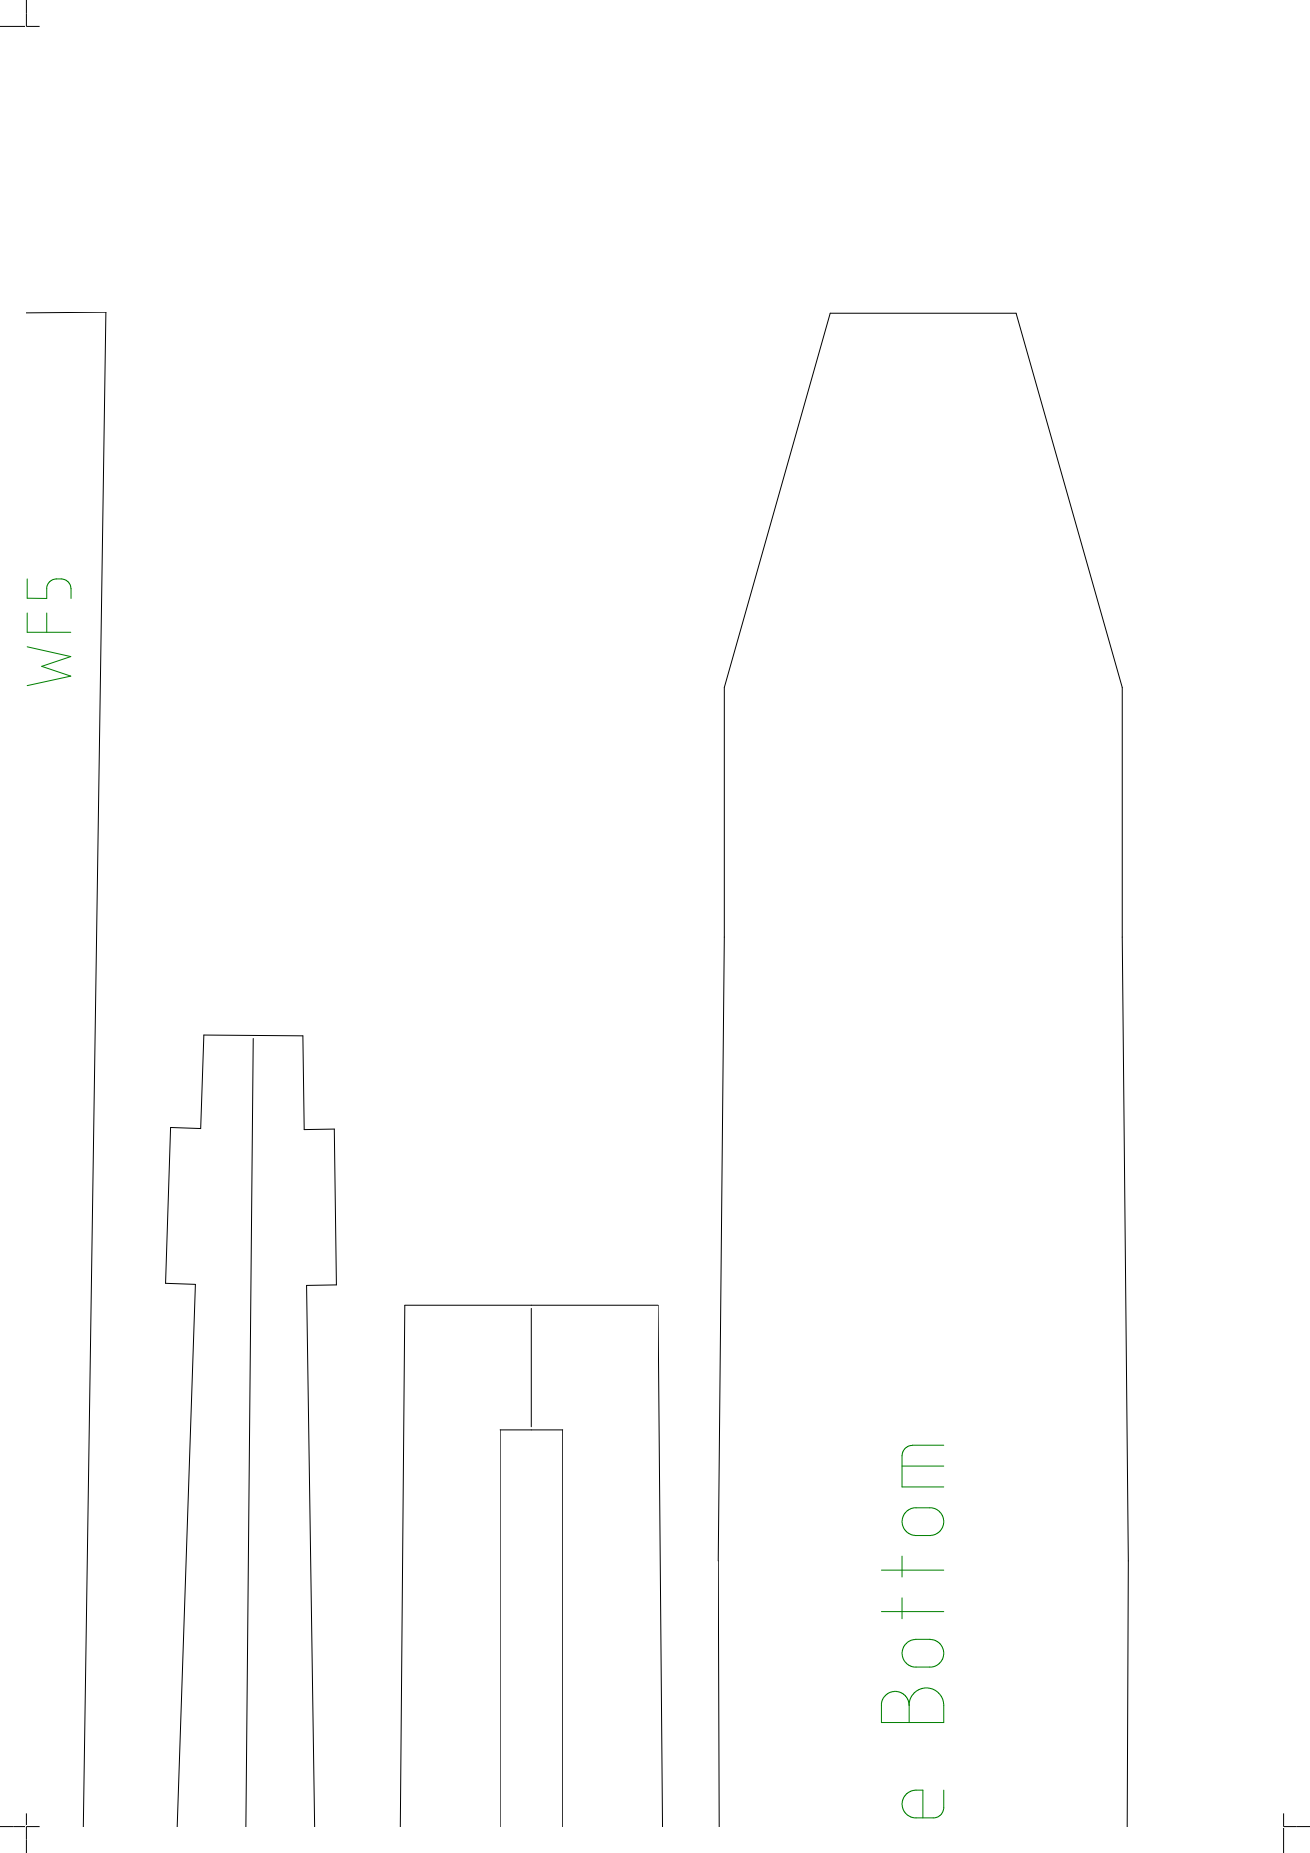
[picture p75: page 4]

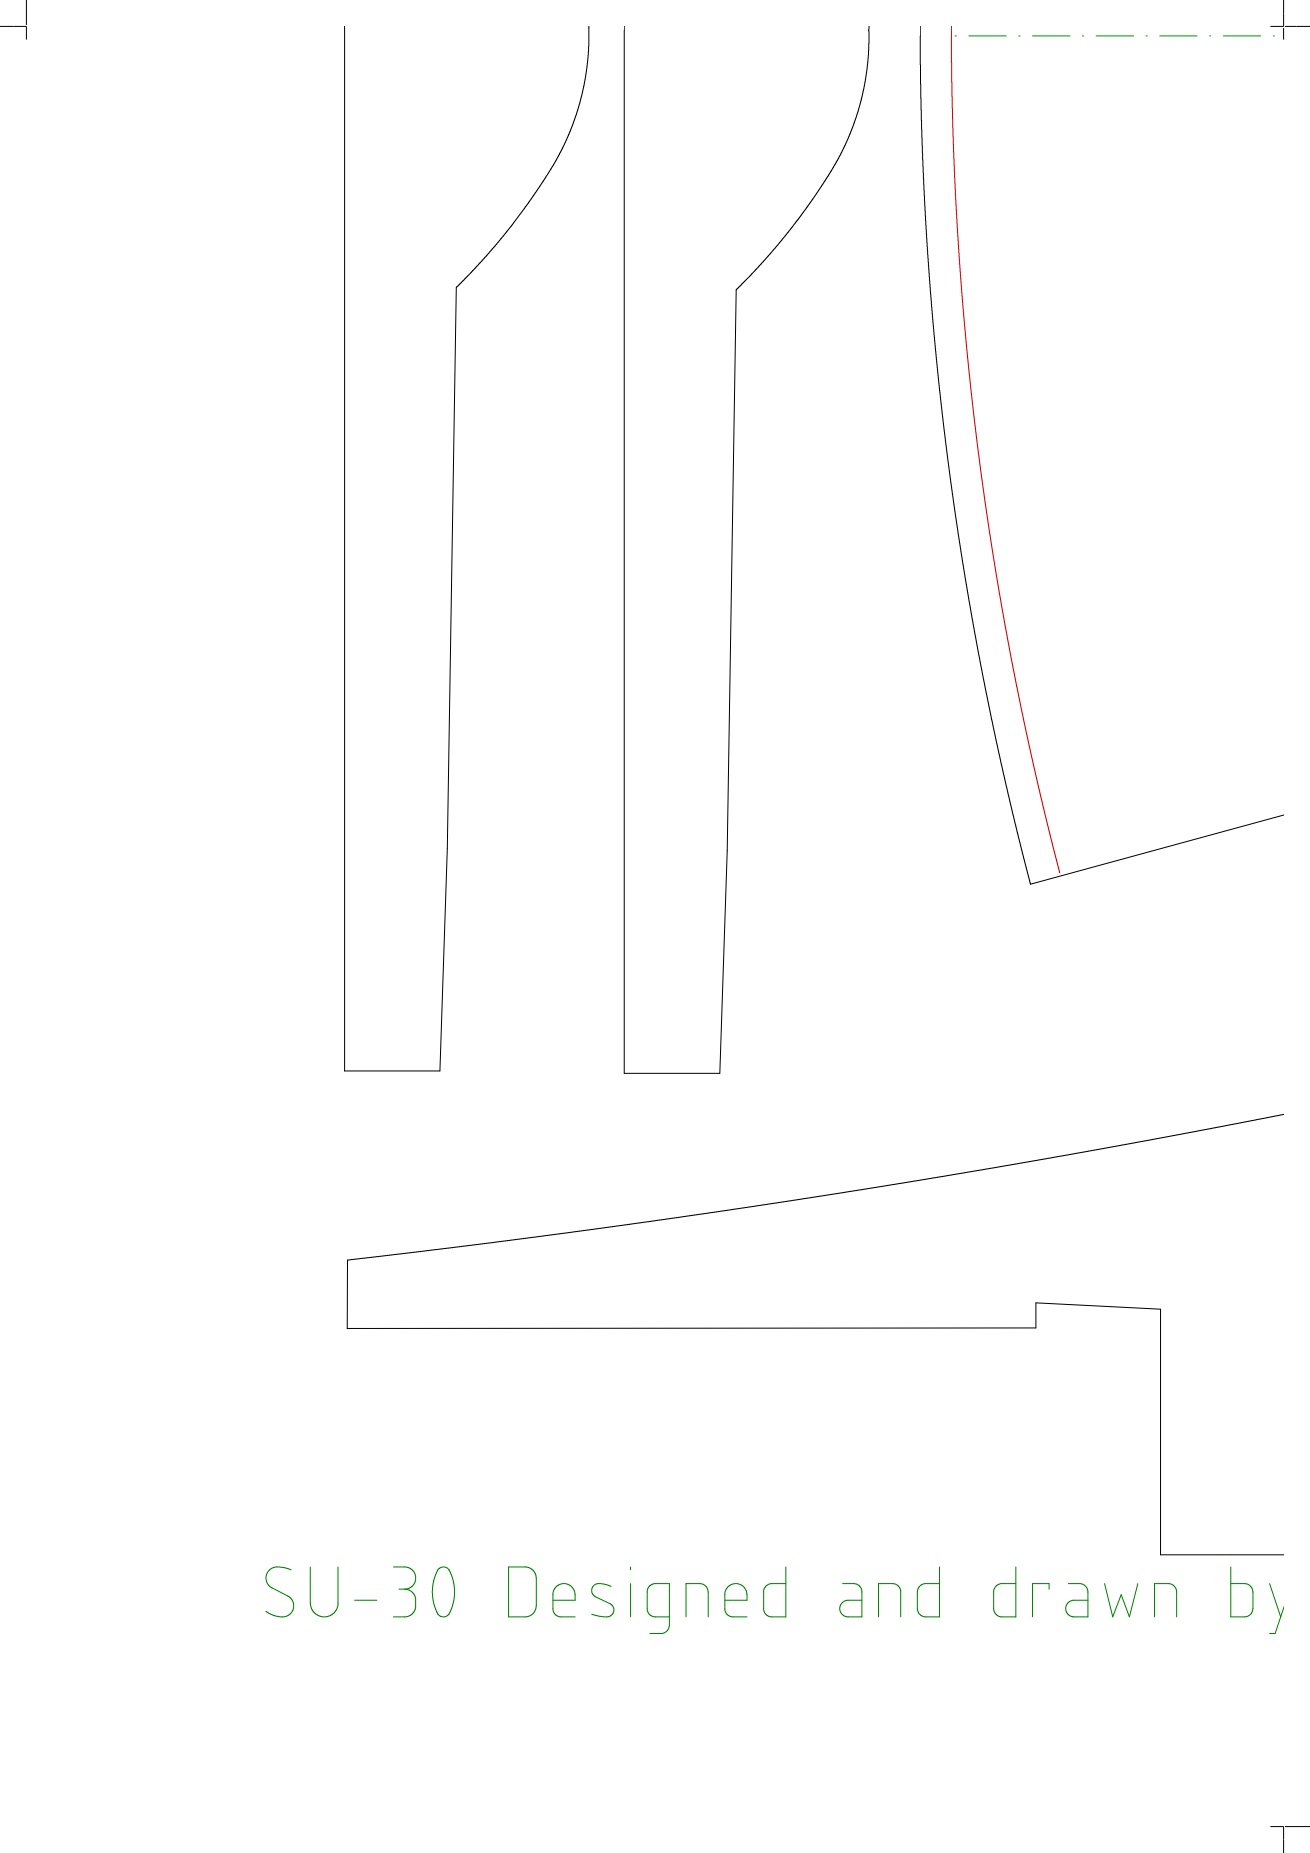
[picture p76: page 5]

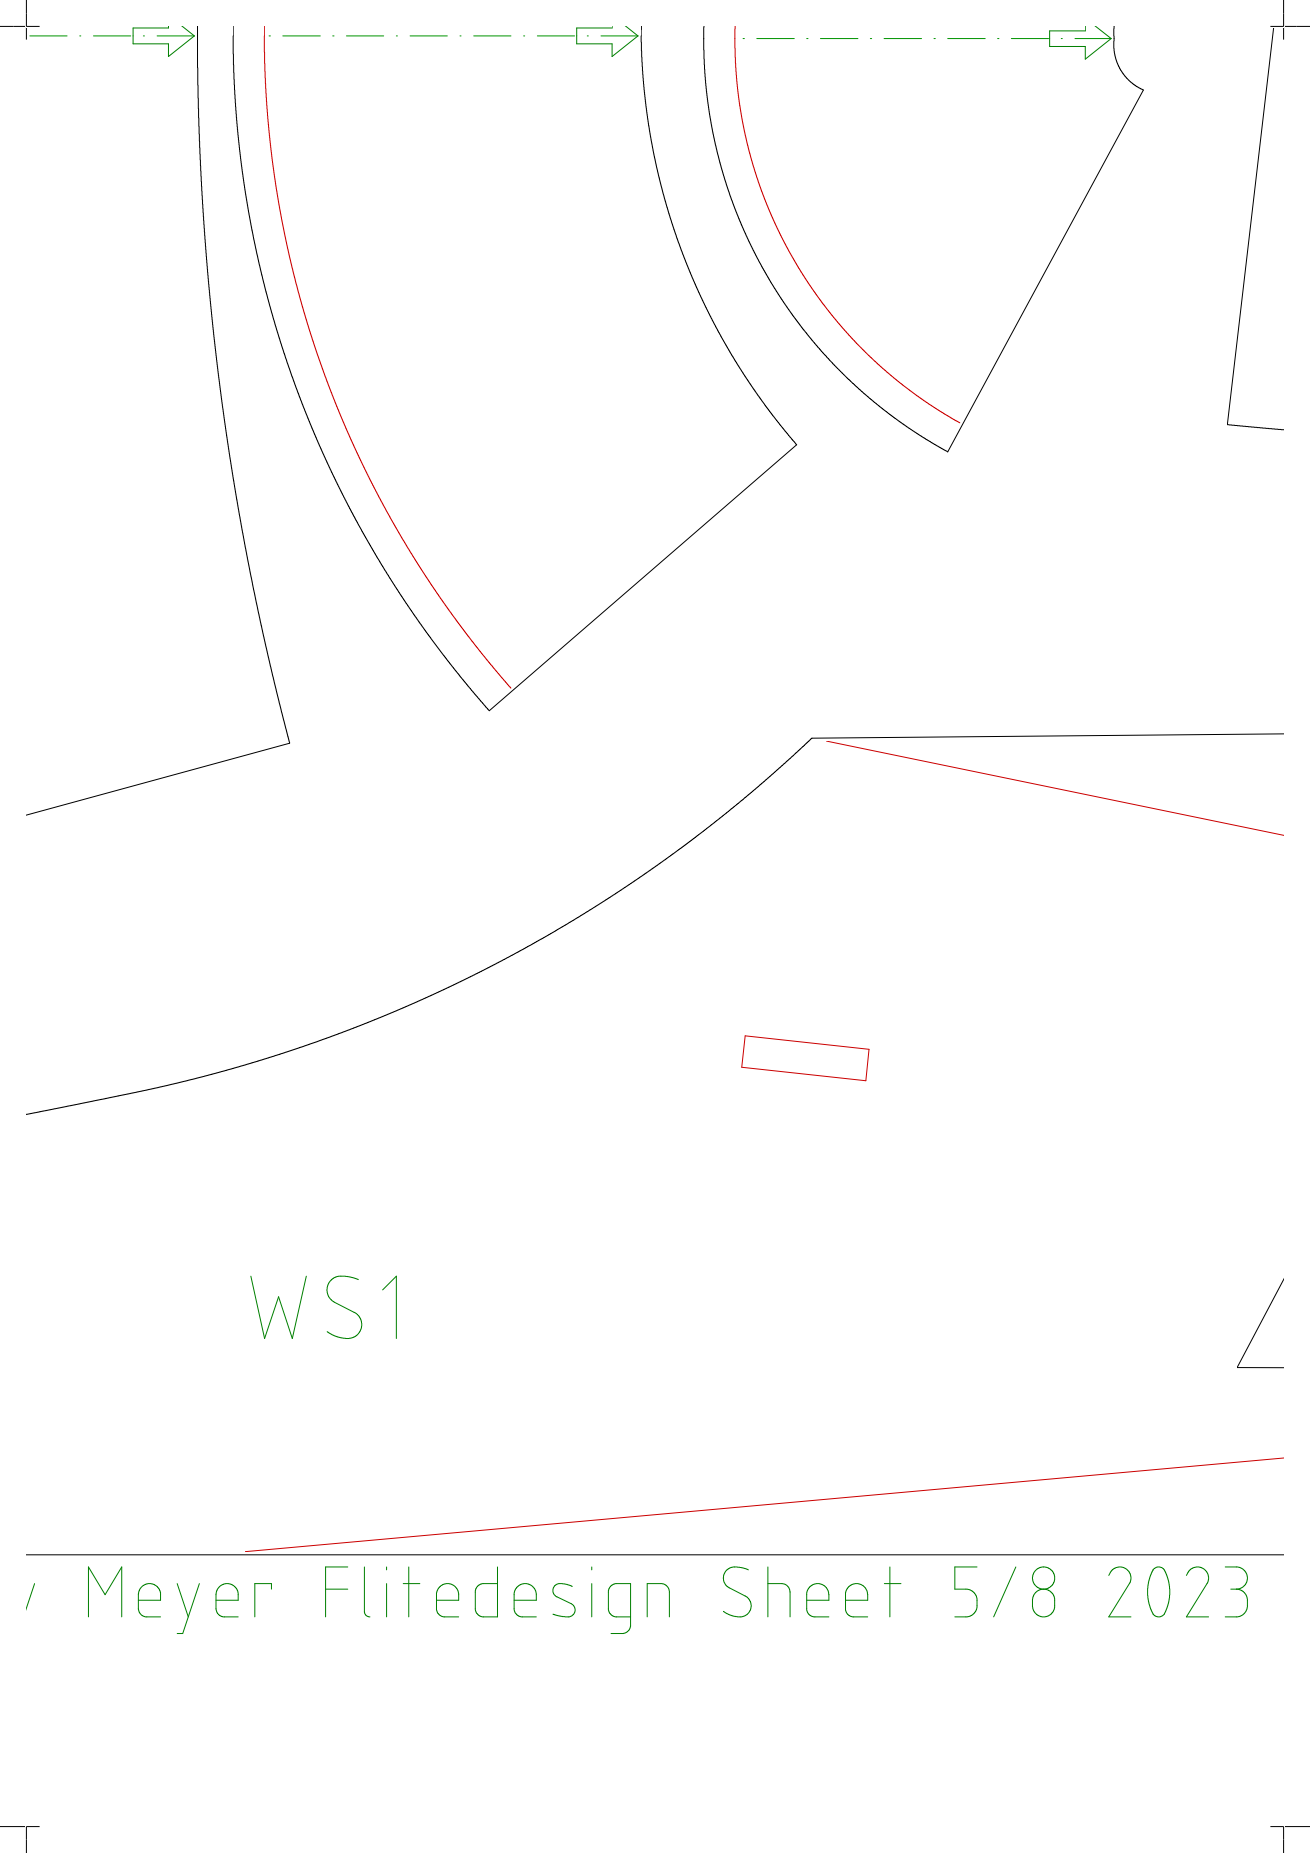
[picture p77: page 6]

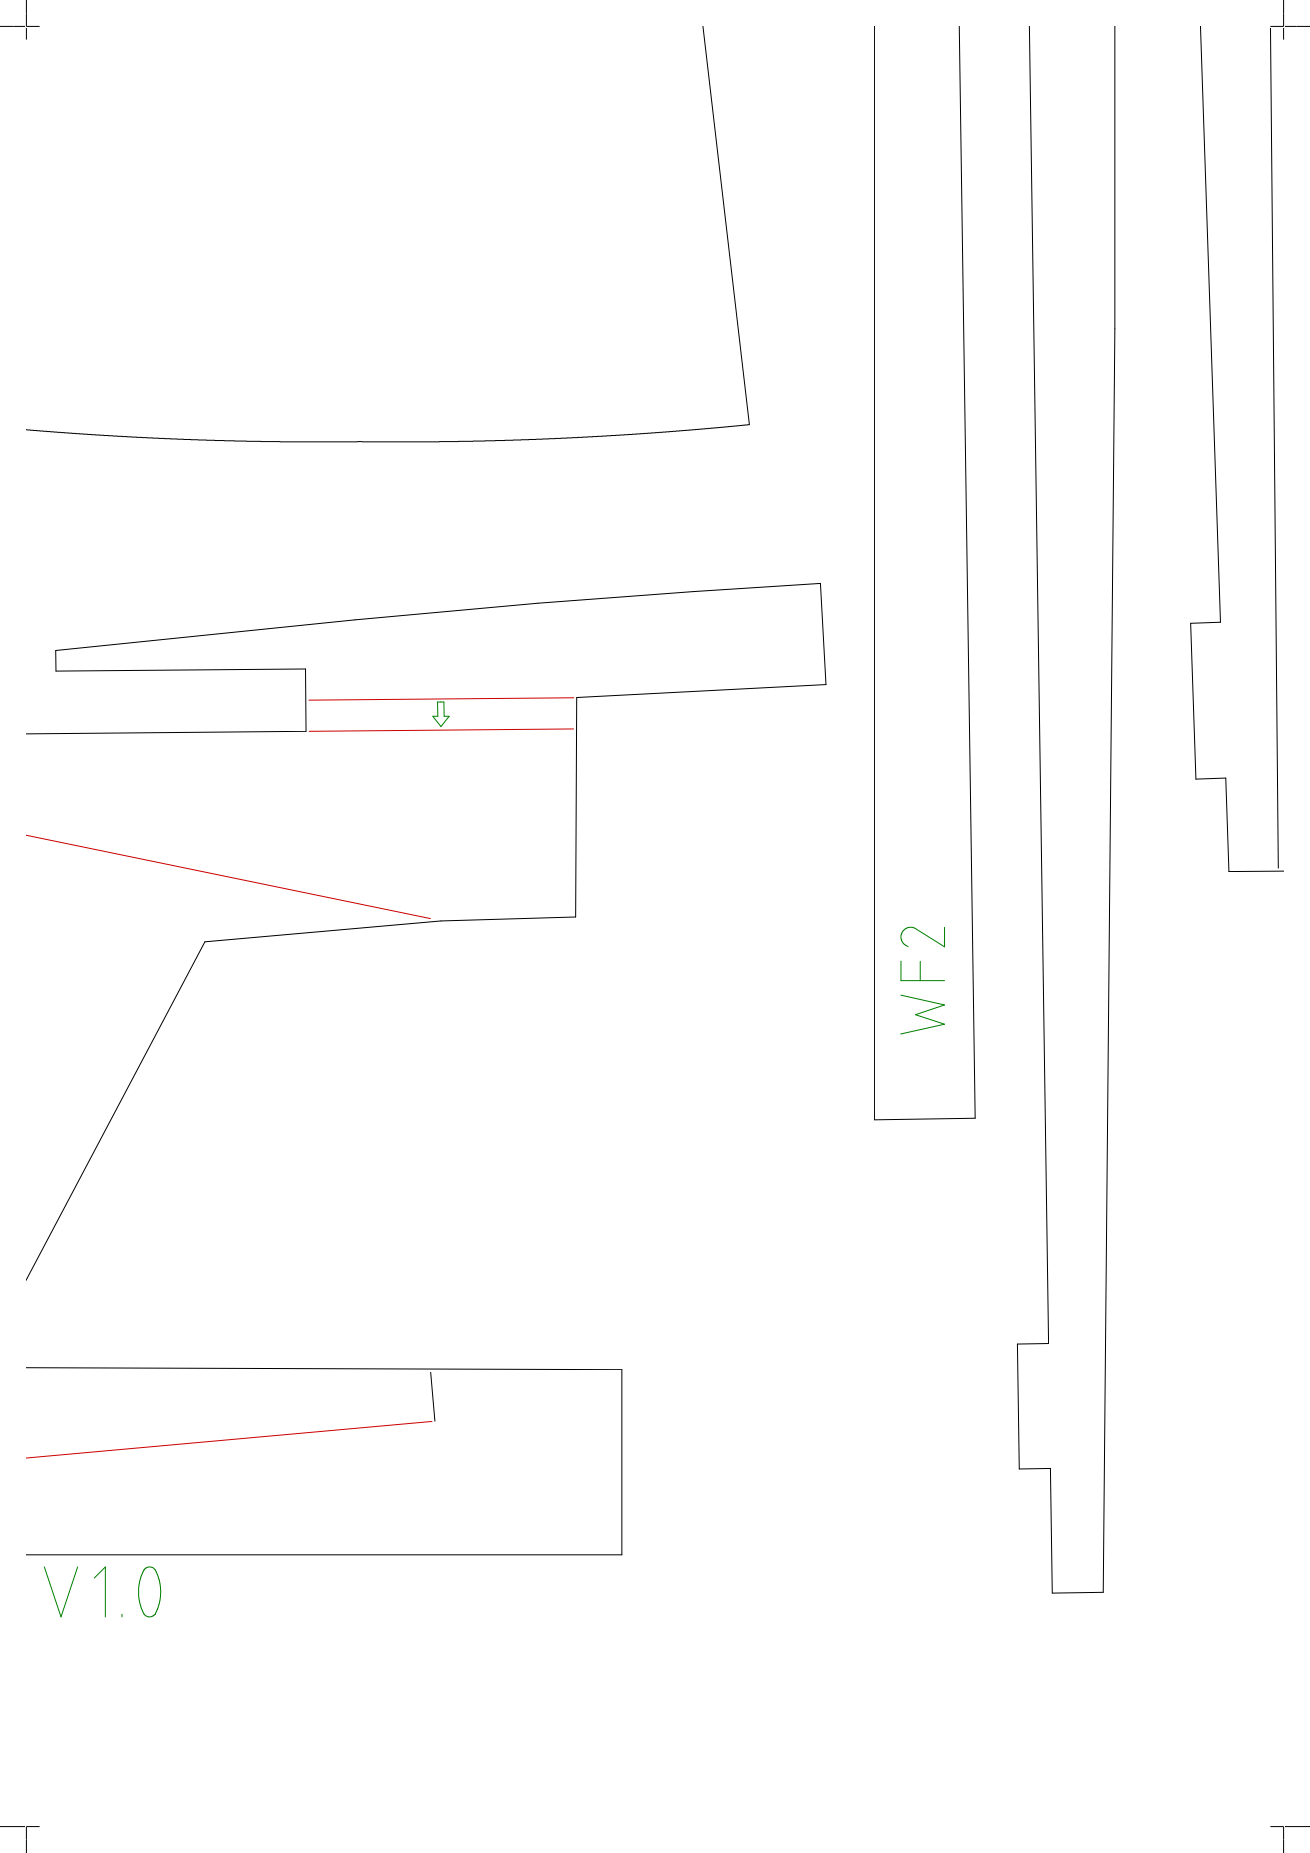
[picture p78: page 7]

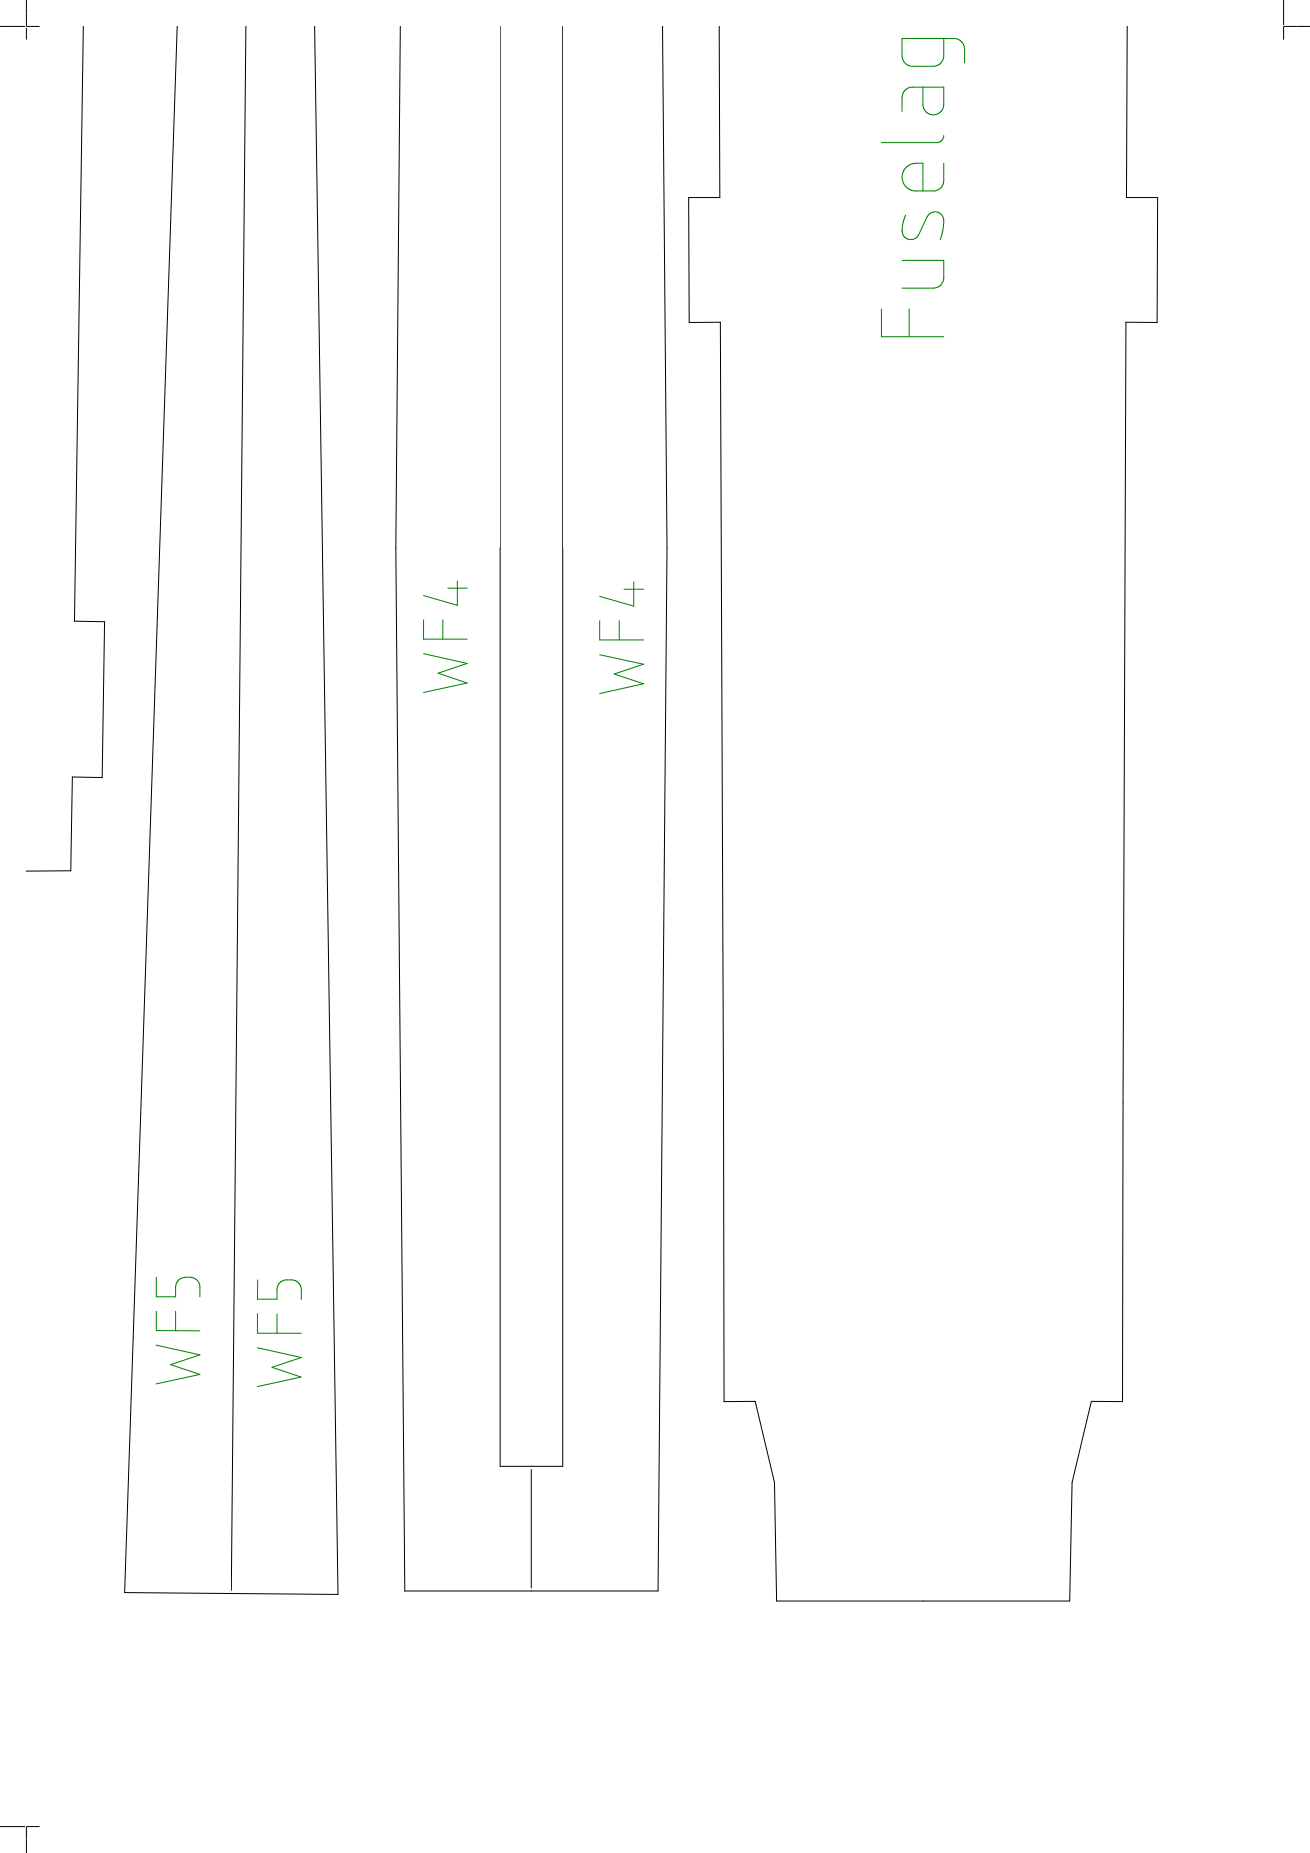
[picture p79: page 8]
