Meyerflitedesign/SU-30/Sheets/PDF_tiled/Sheet6.pdf

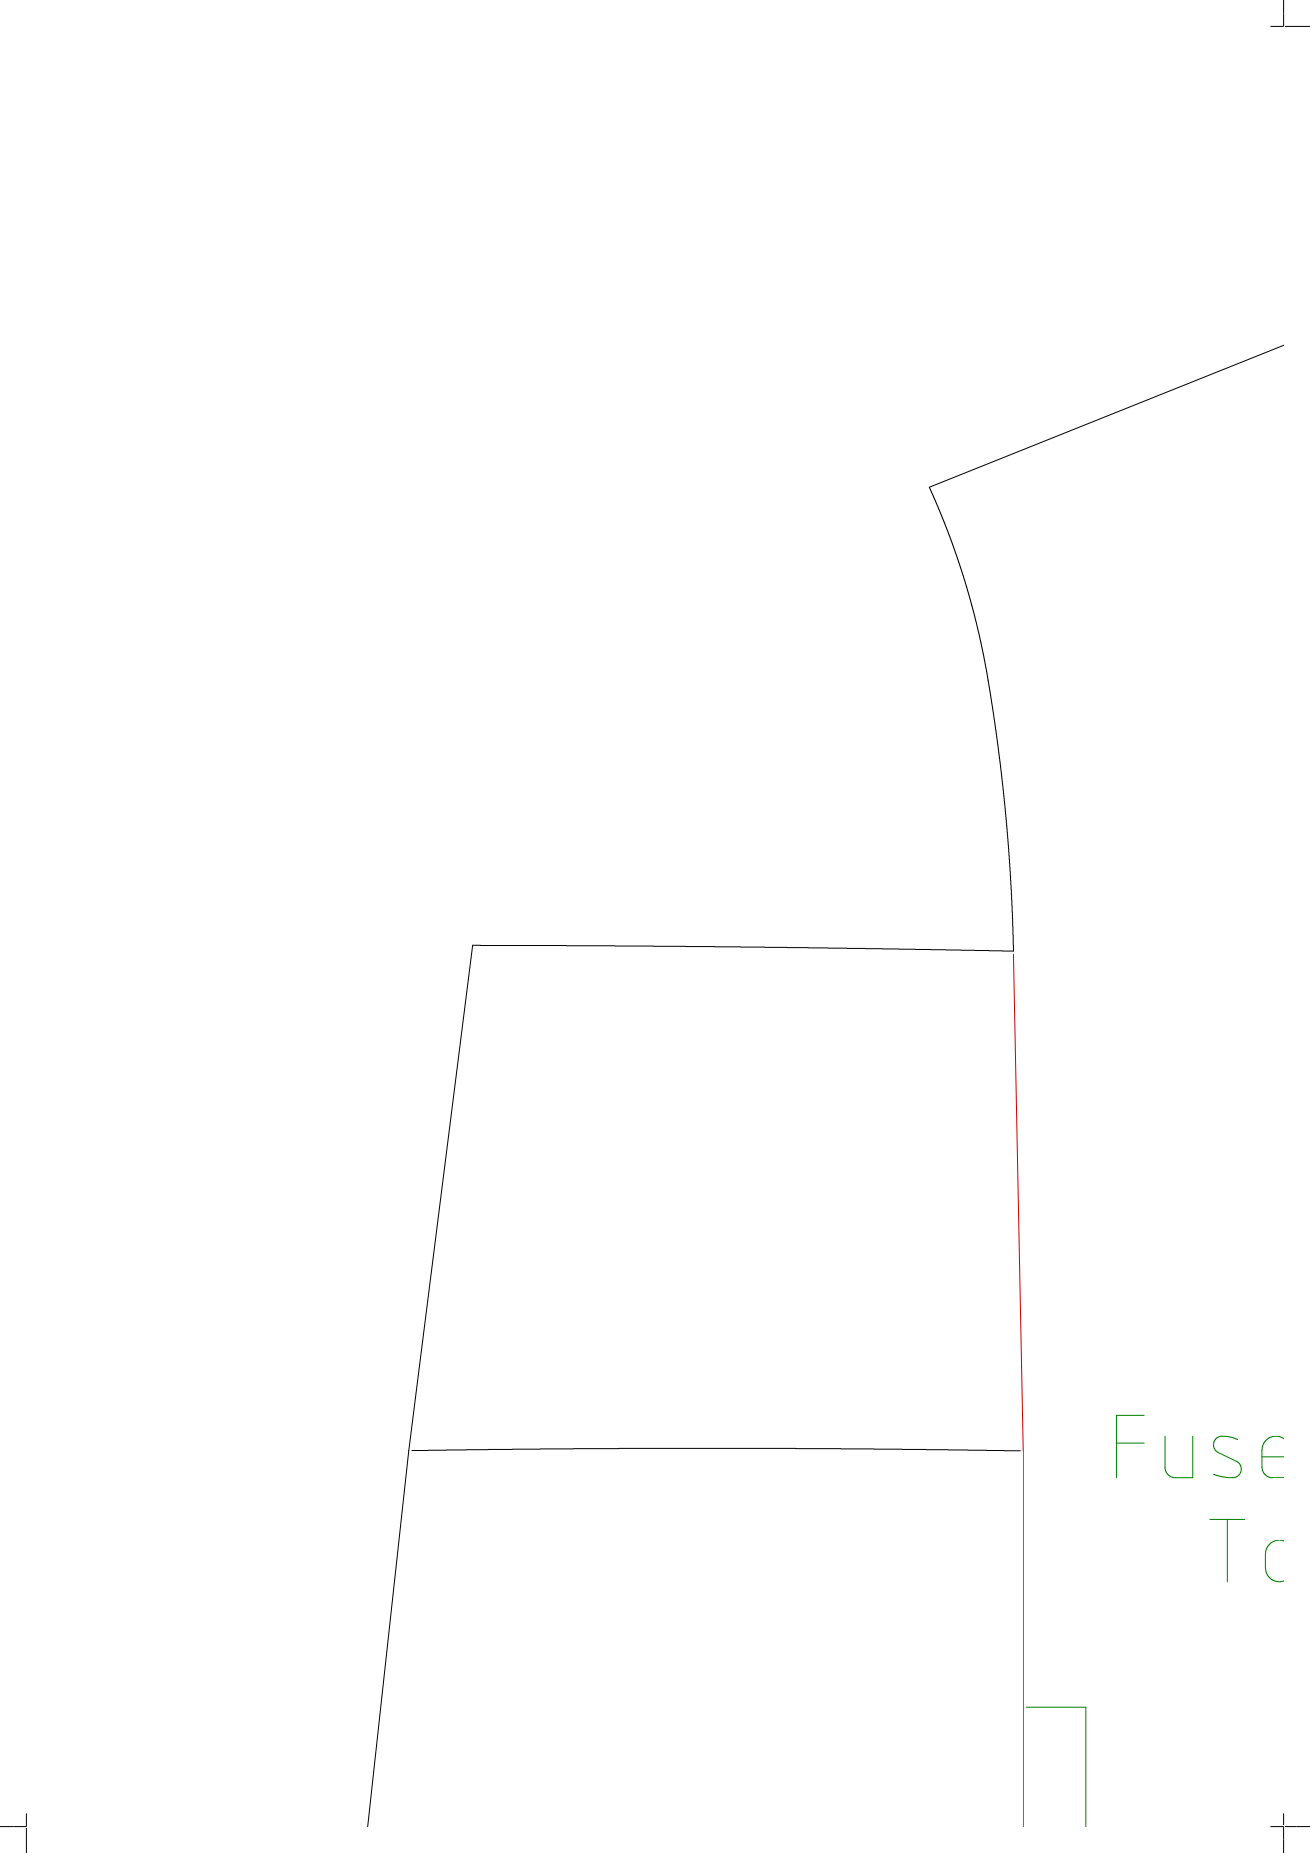
[picture p80: page 1]

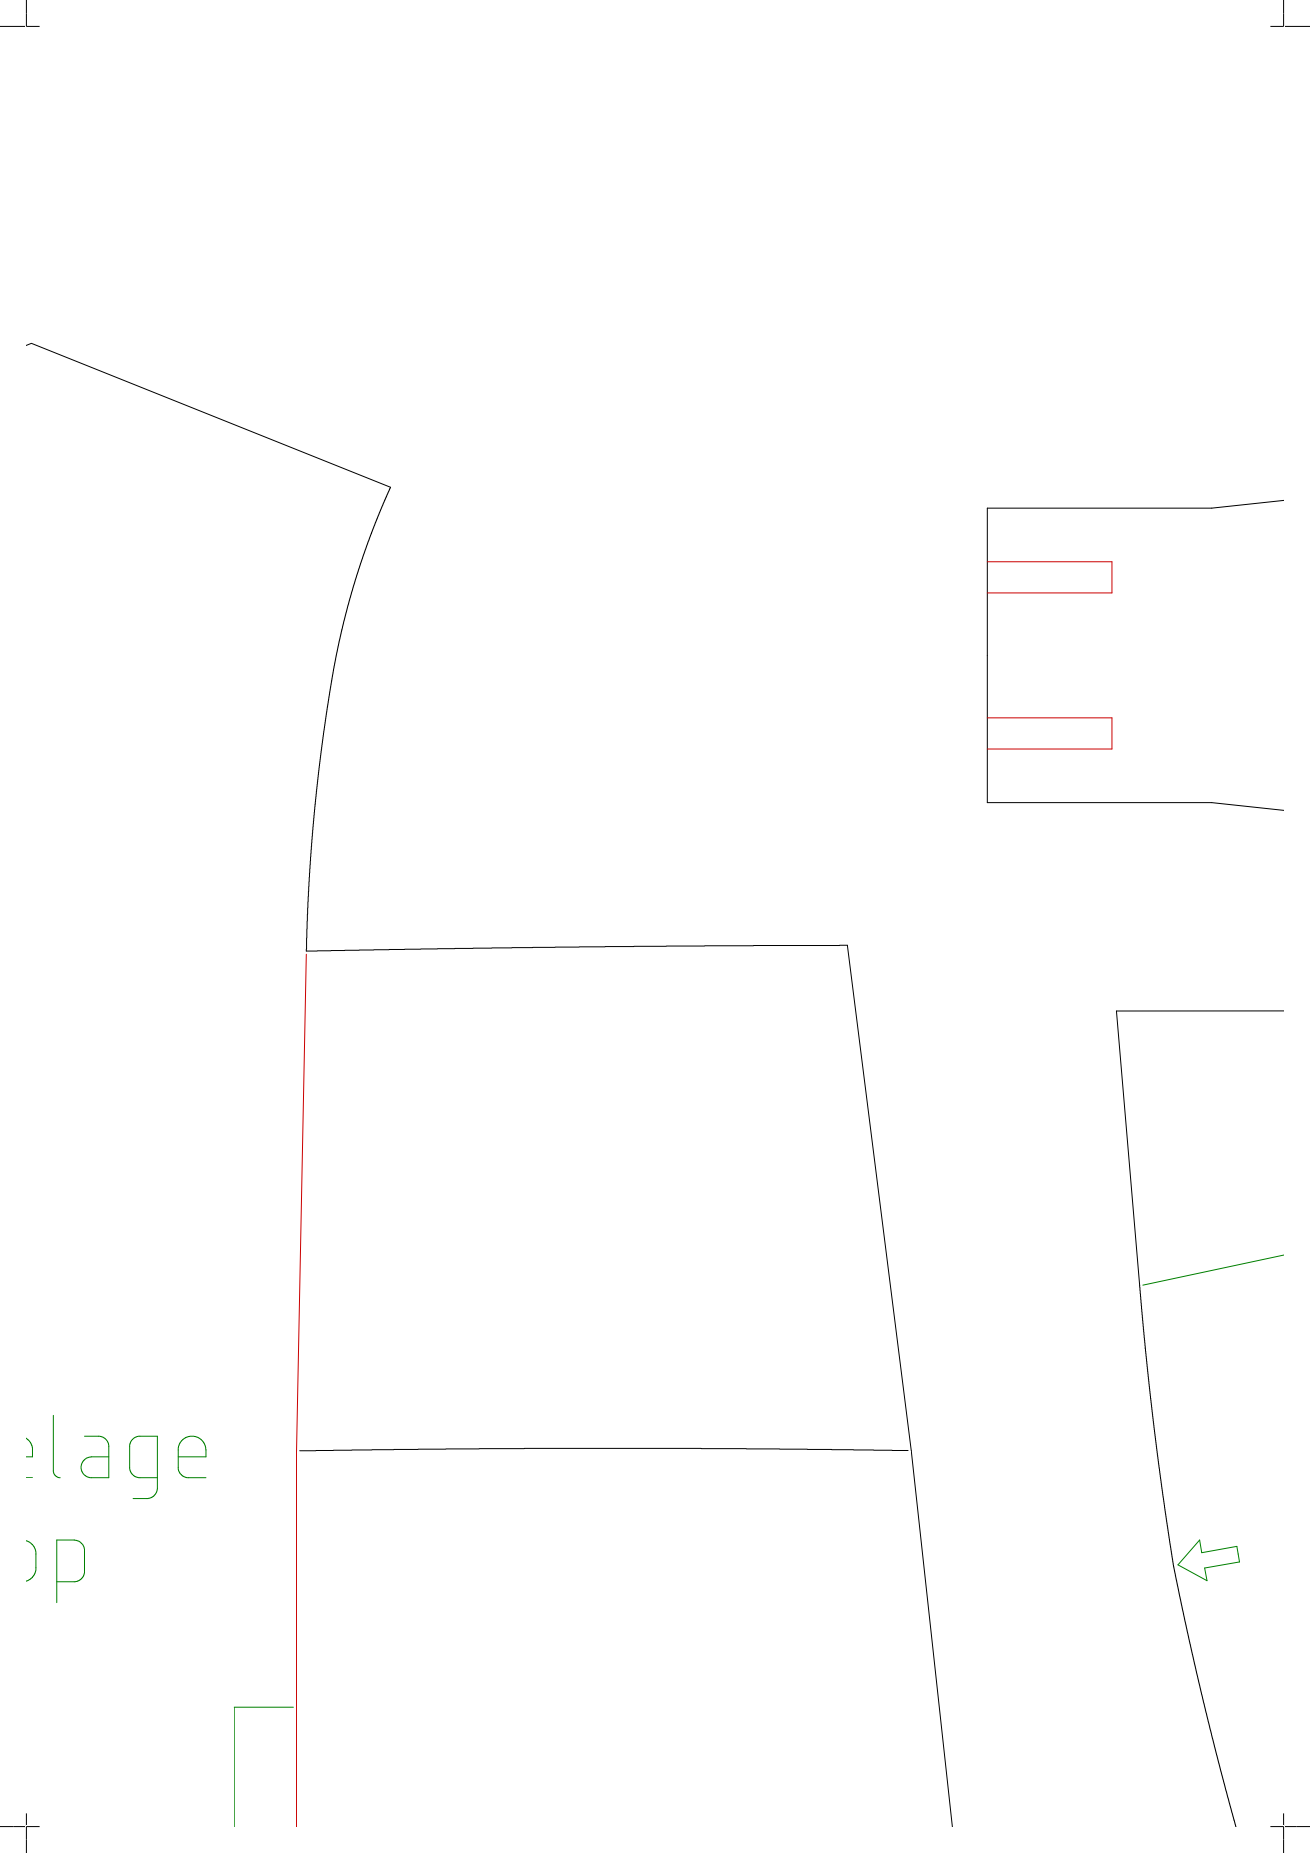
[picture p81: page 2]

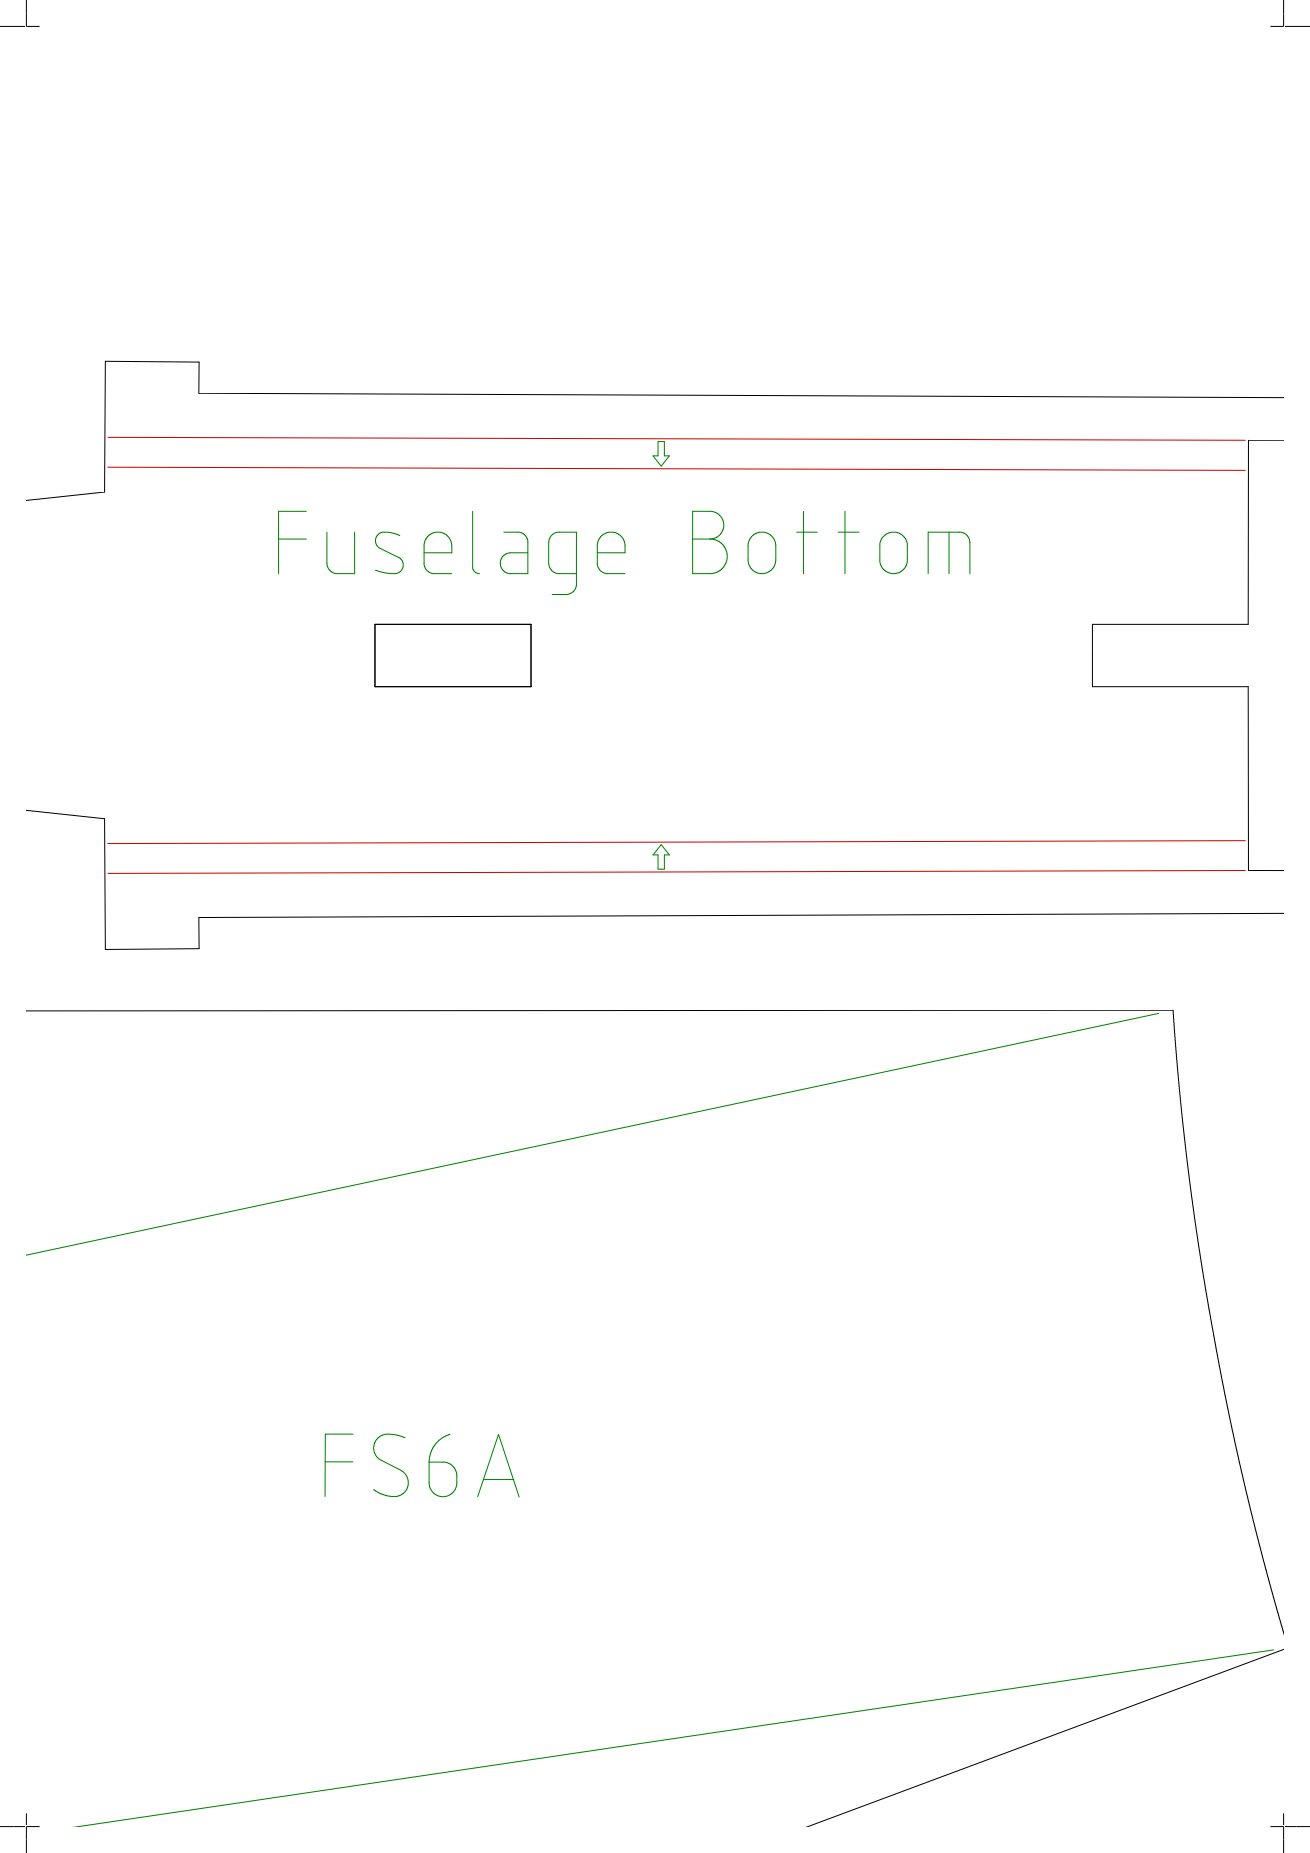
[picture p82: page 3]

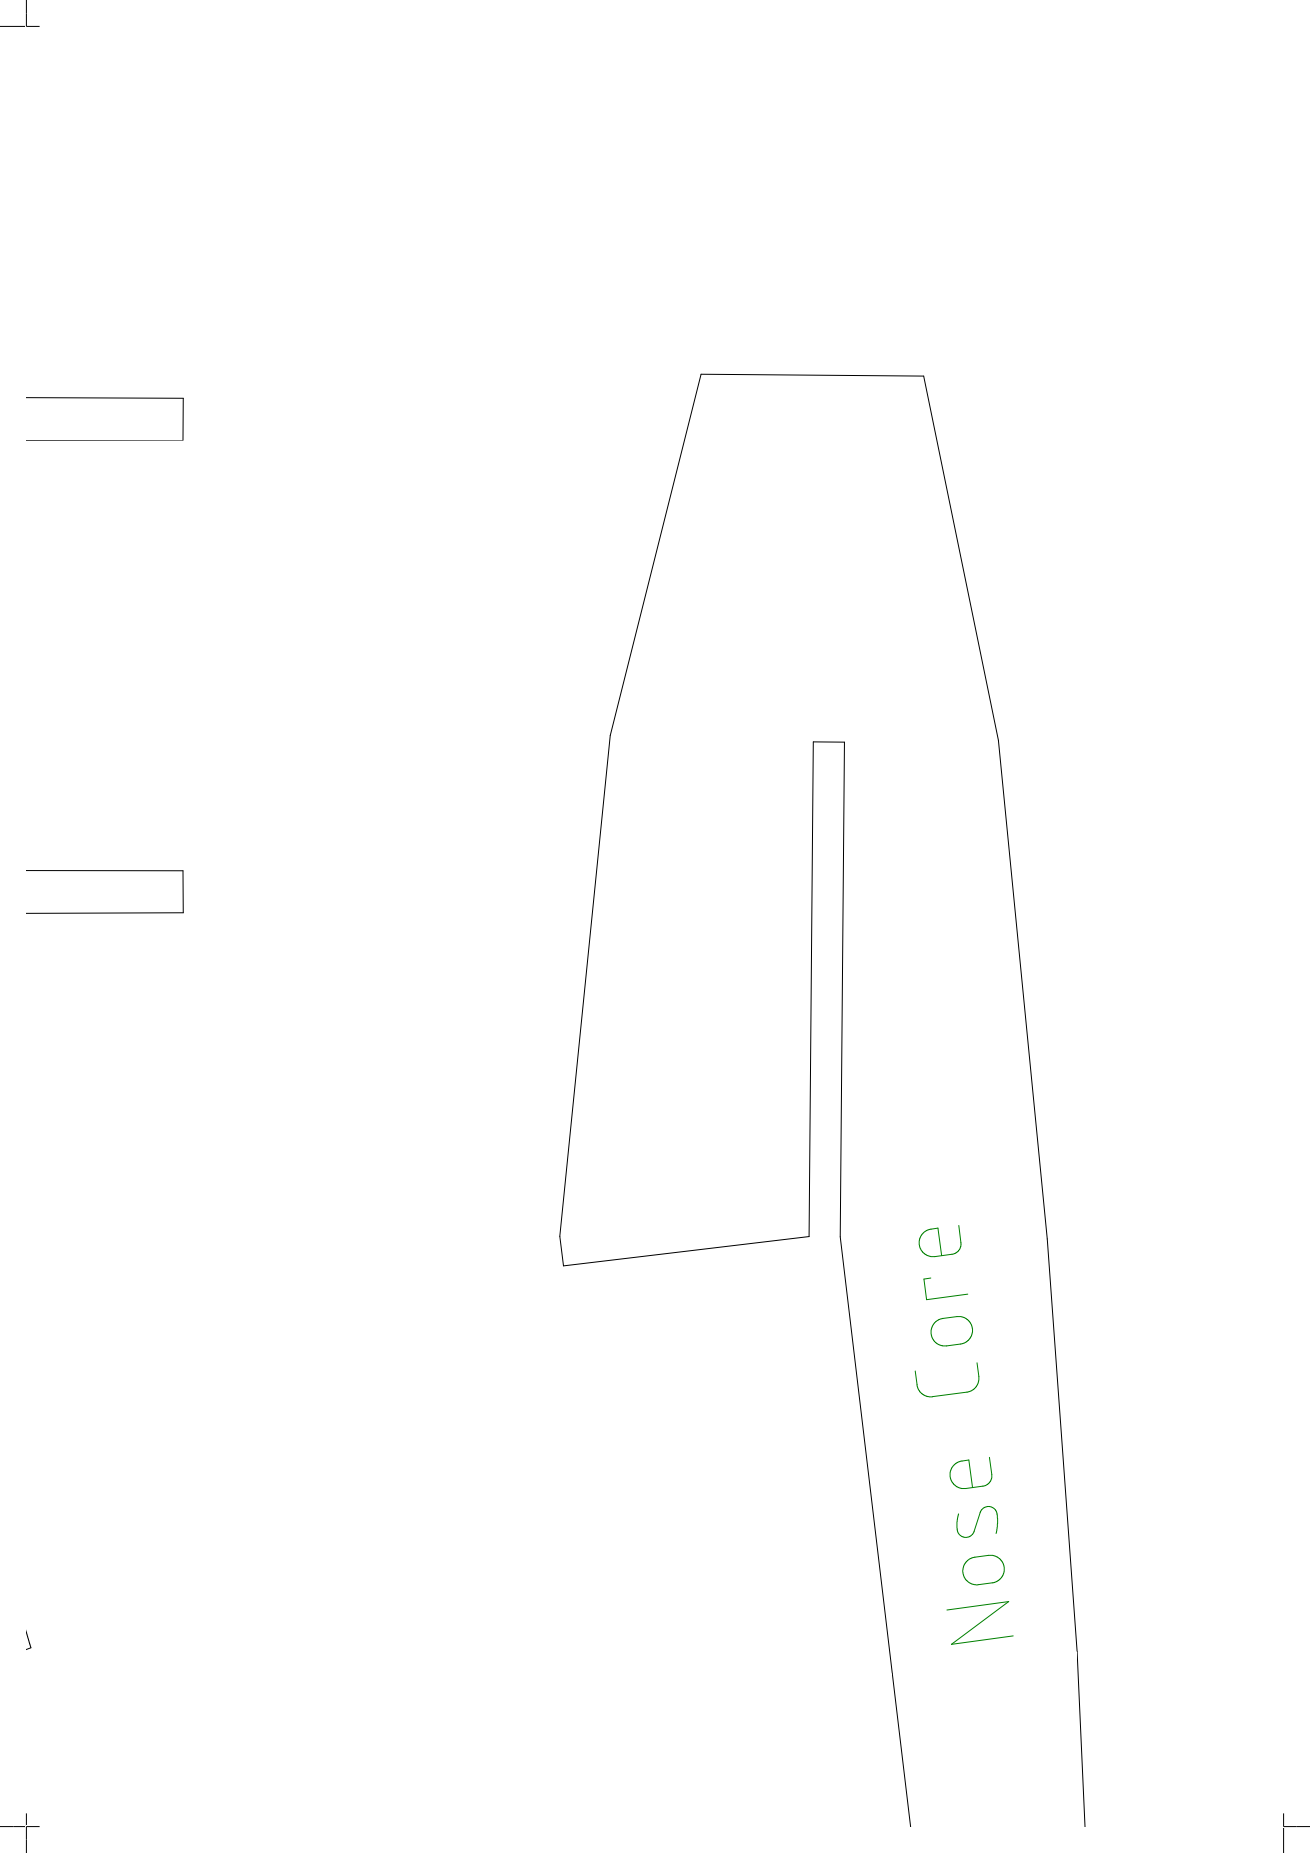
[picture p83: page 4]

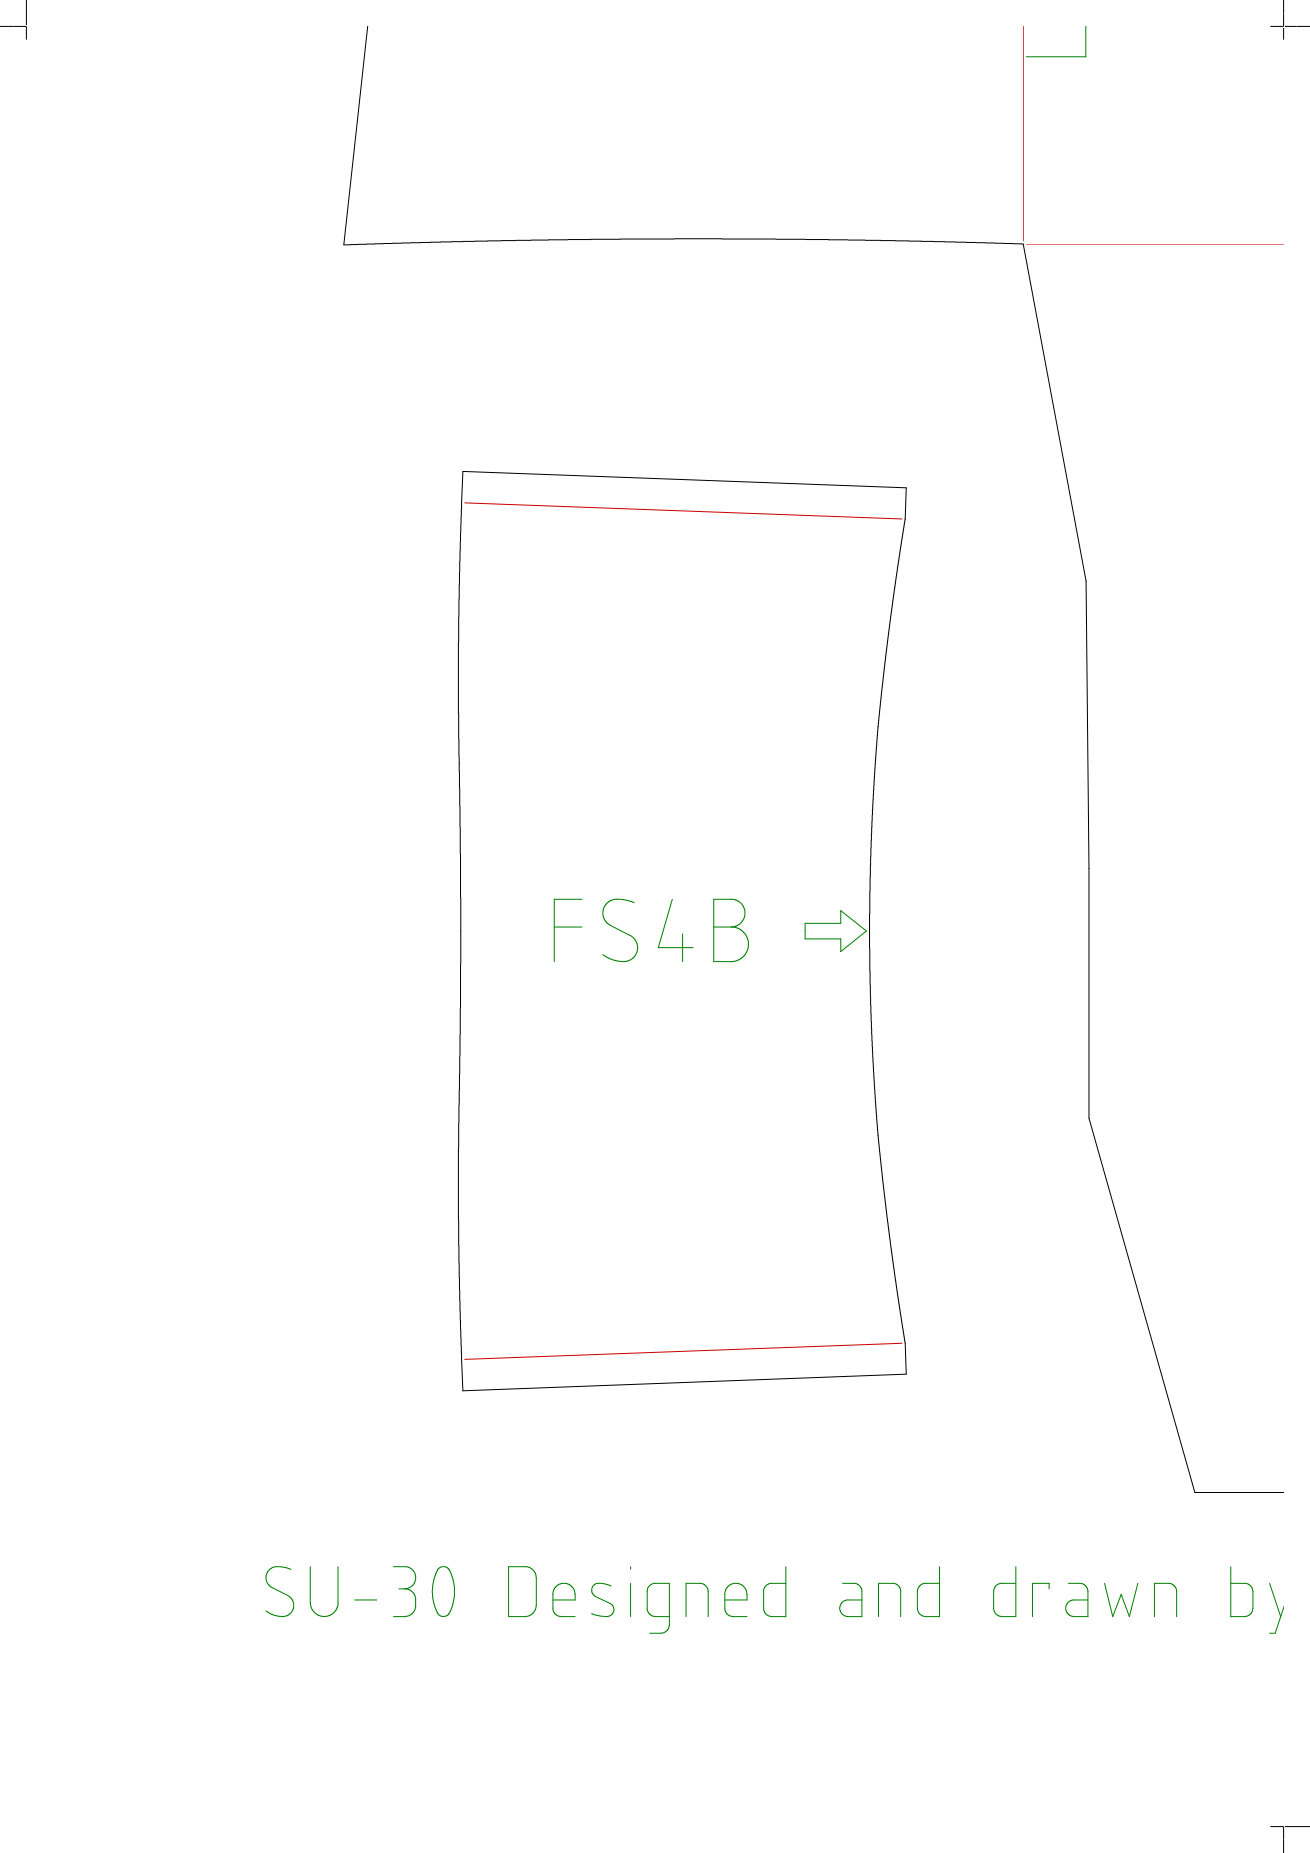
[picture p84: page 5]

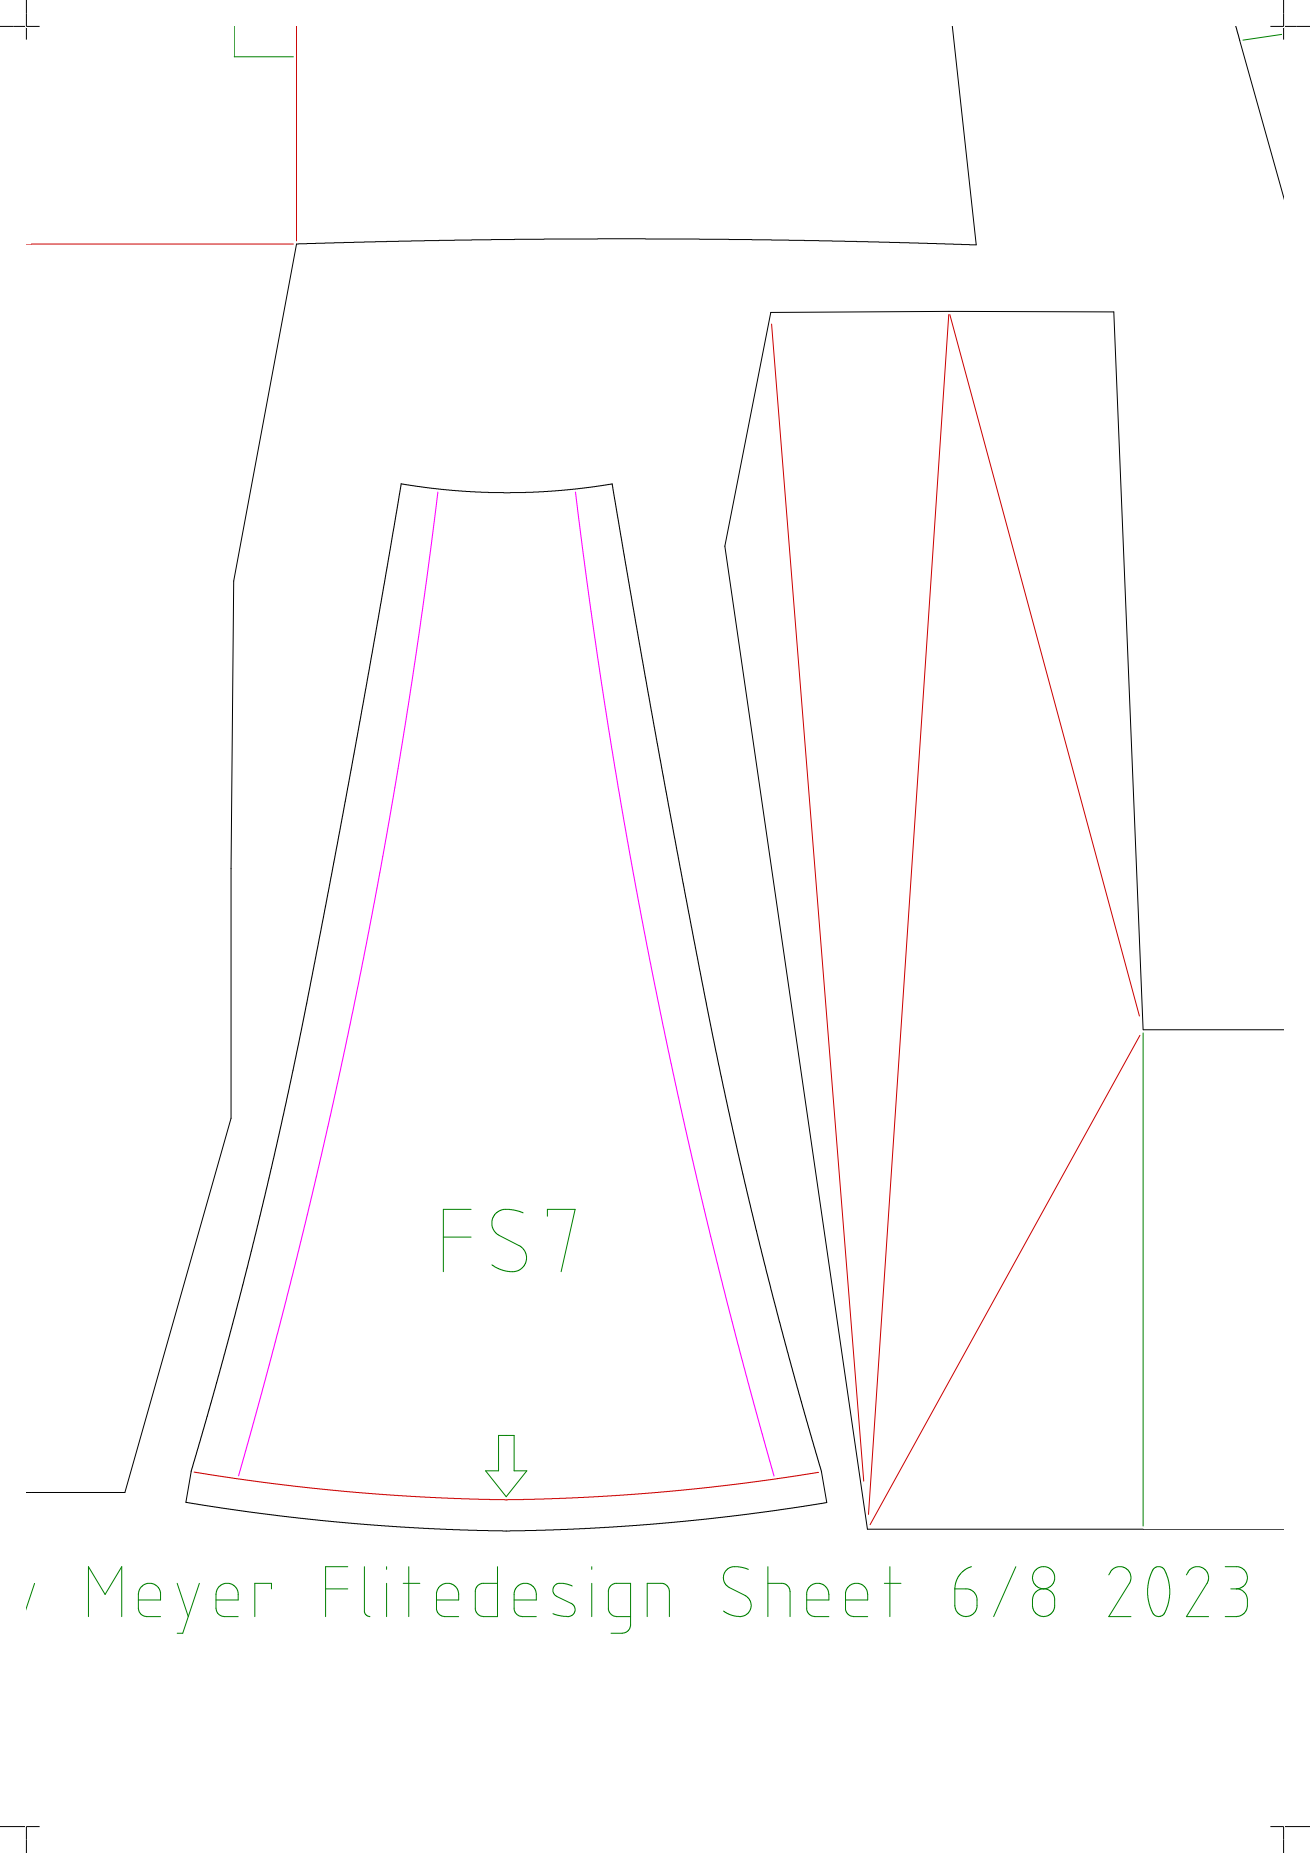
[picture p85: page 6]

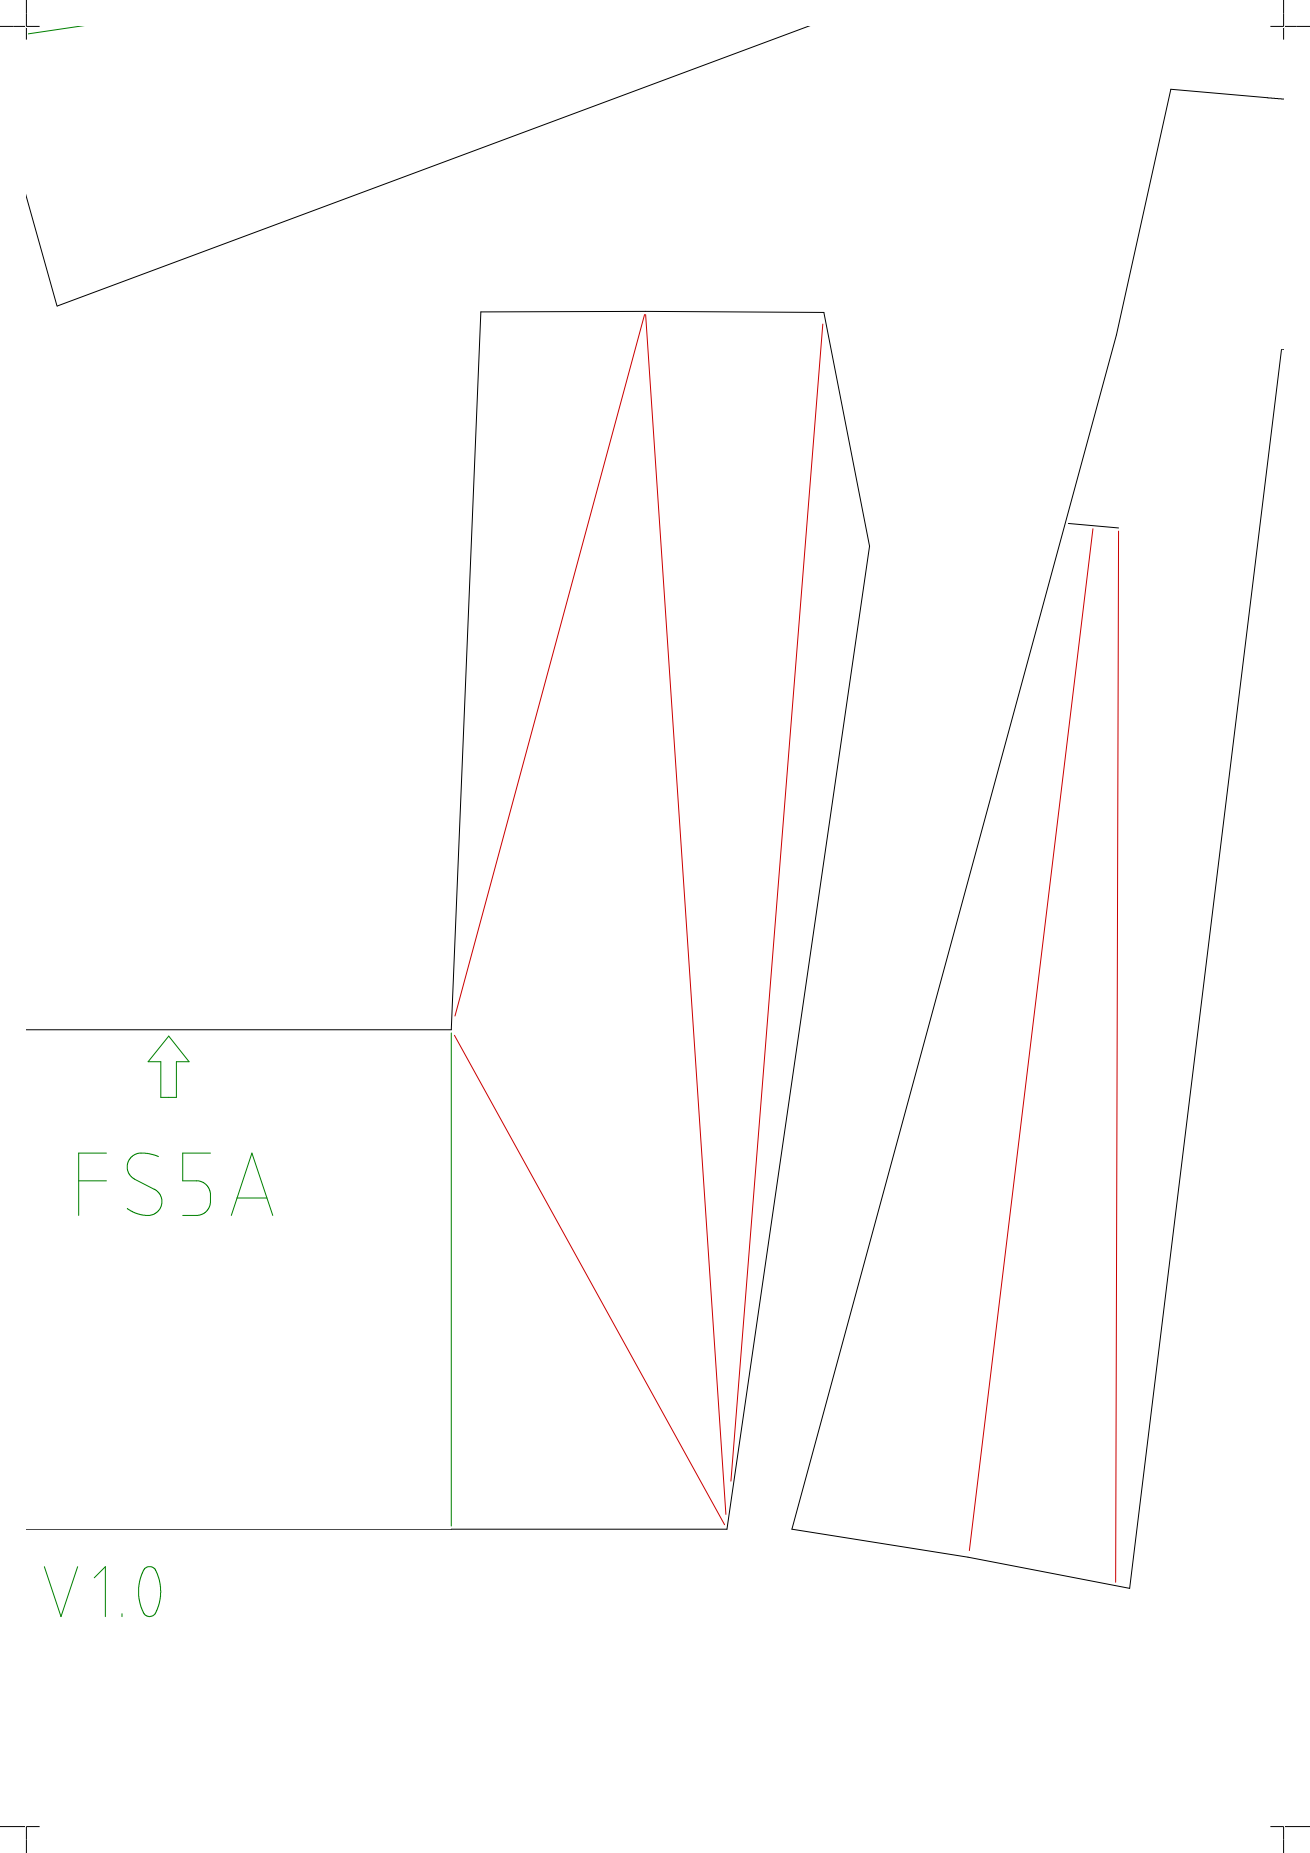
[picture p86: page 7]

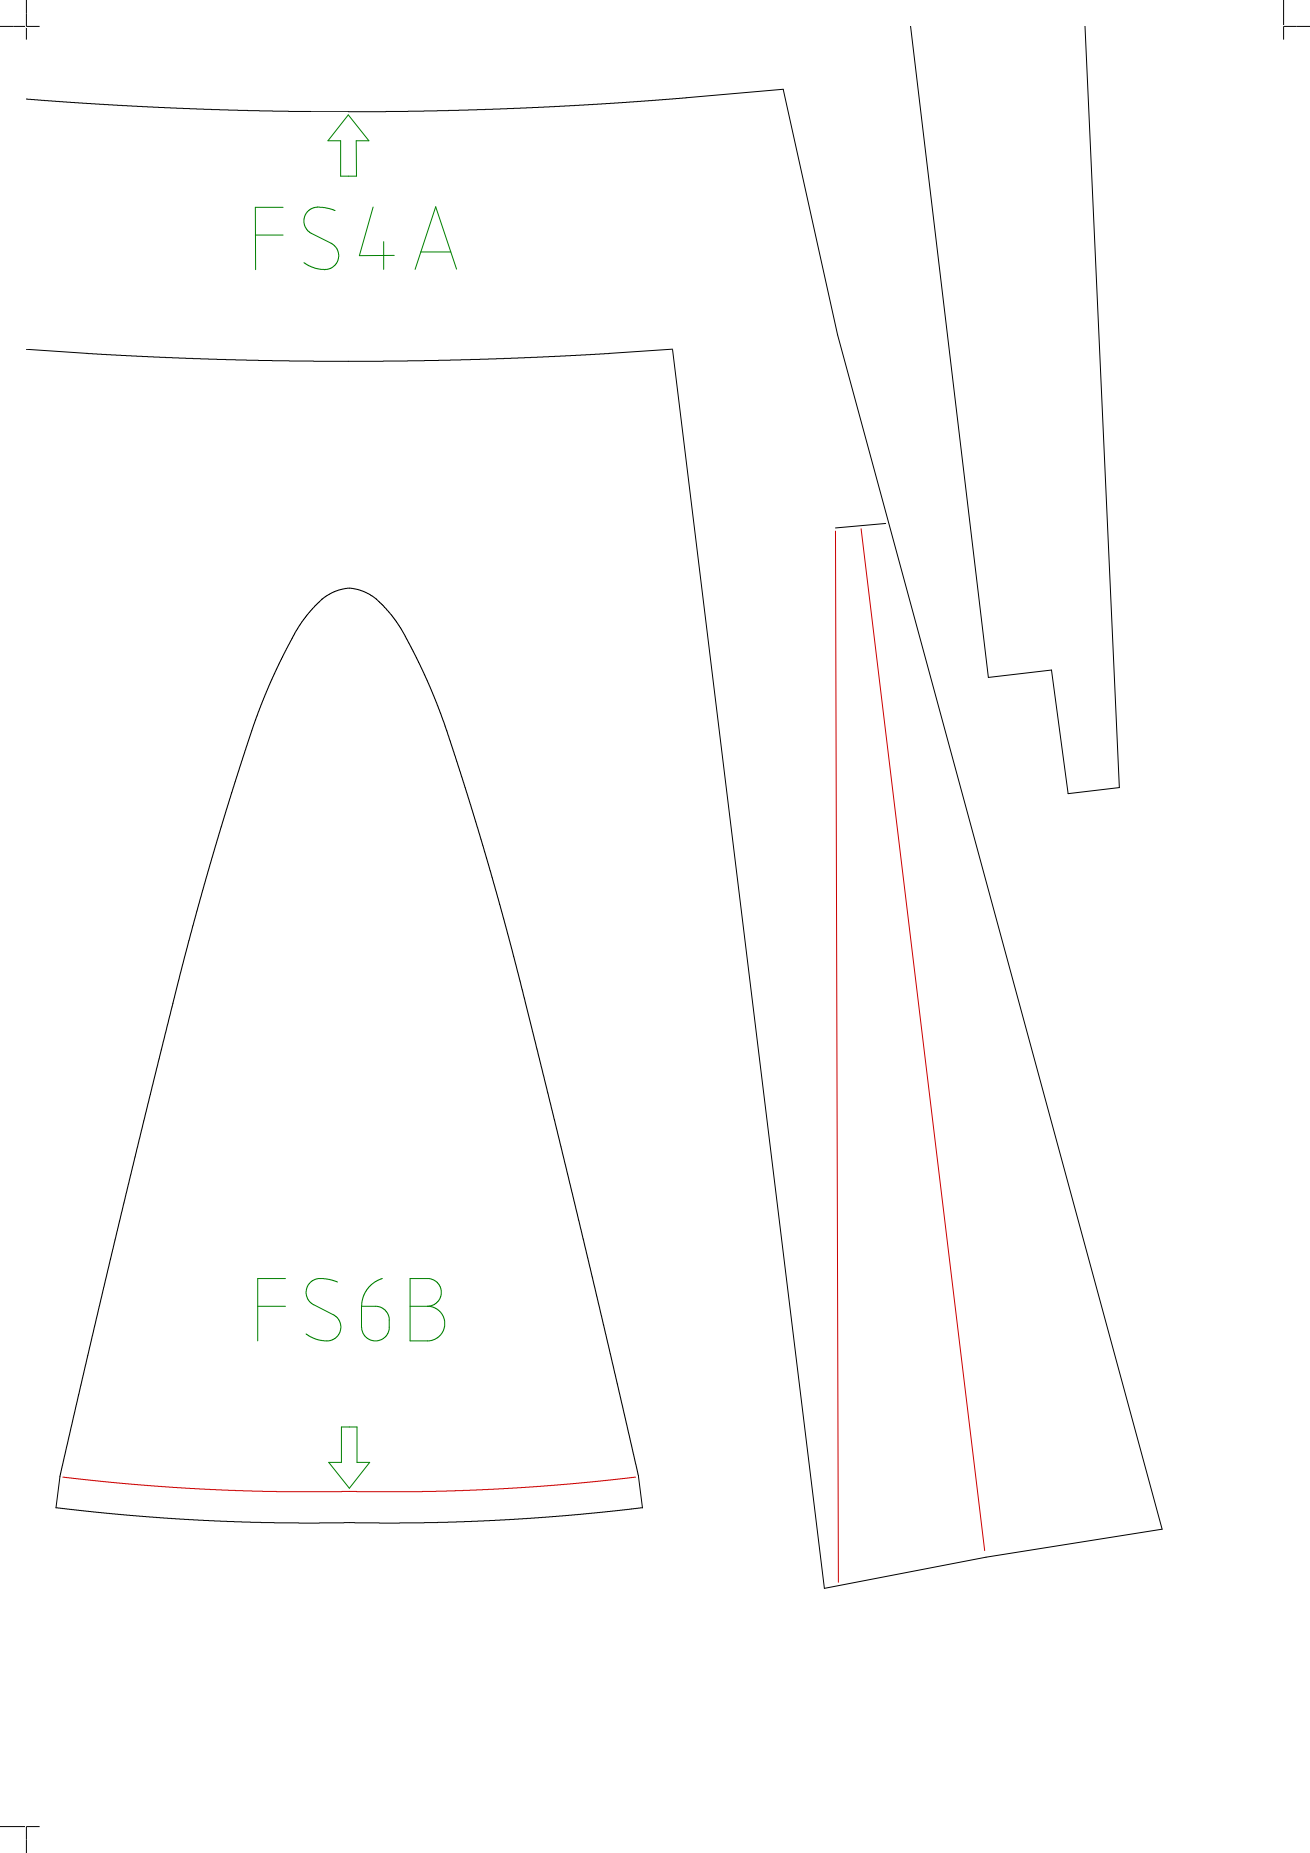
[picture p87: page 8]
