Meyerflitedesign/SU-30/Sheets/PDF_tiled/Sheet7.pdf

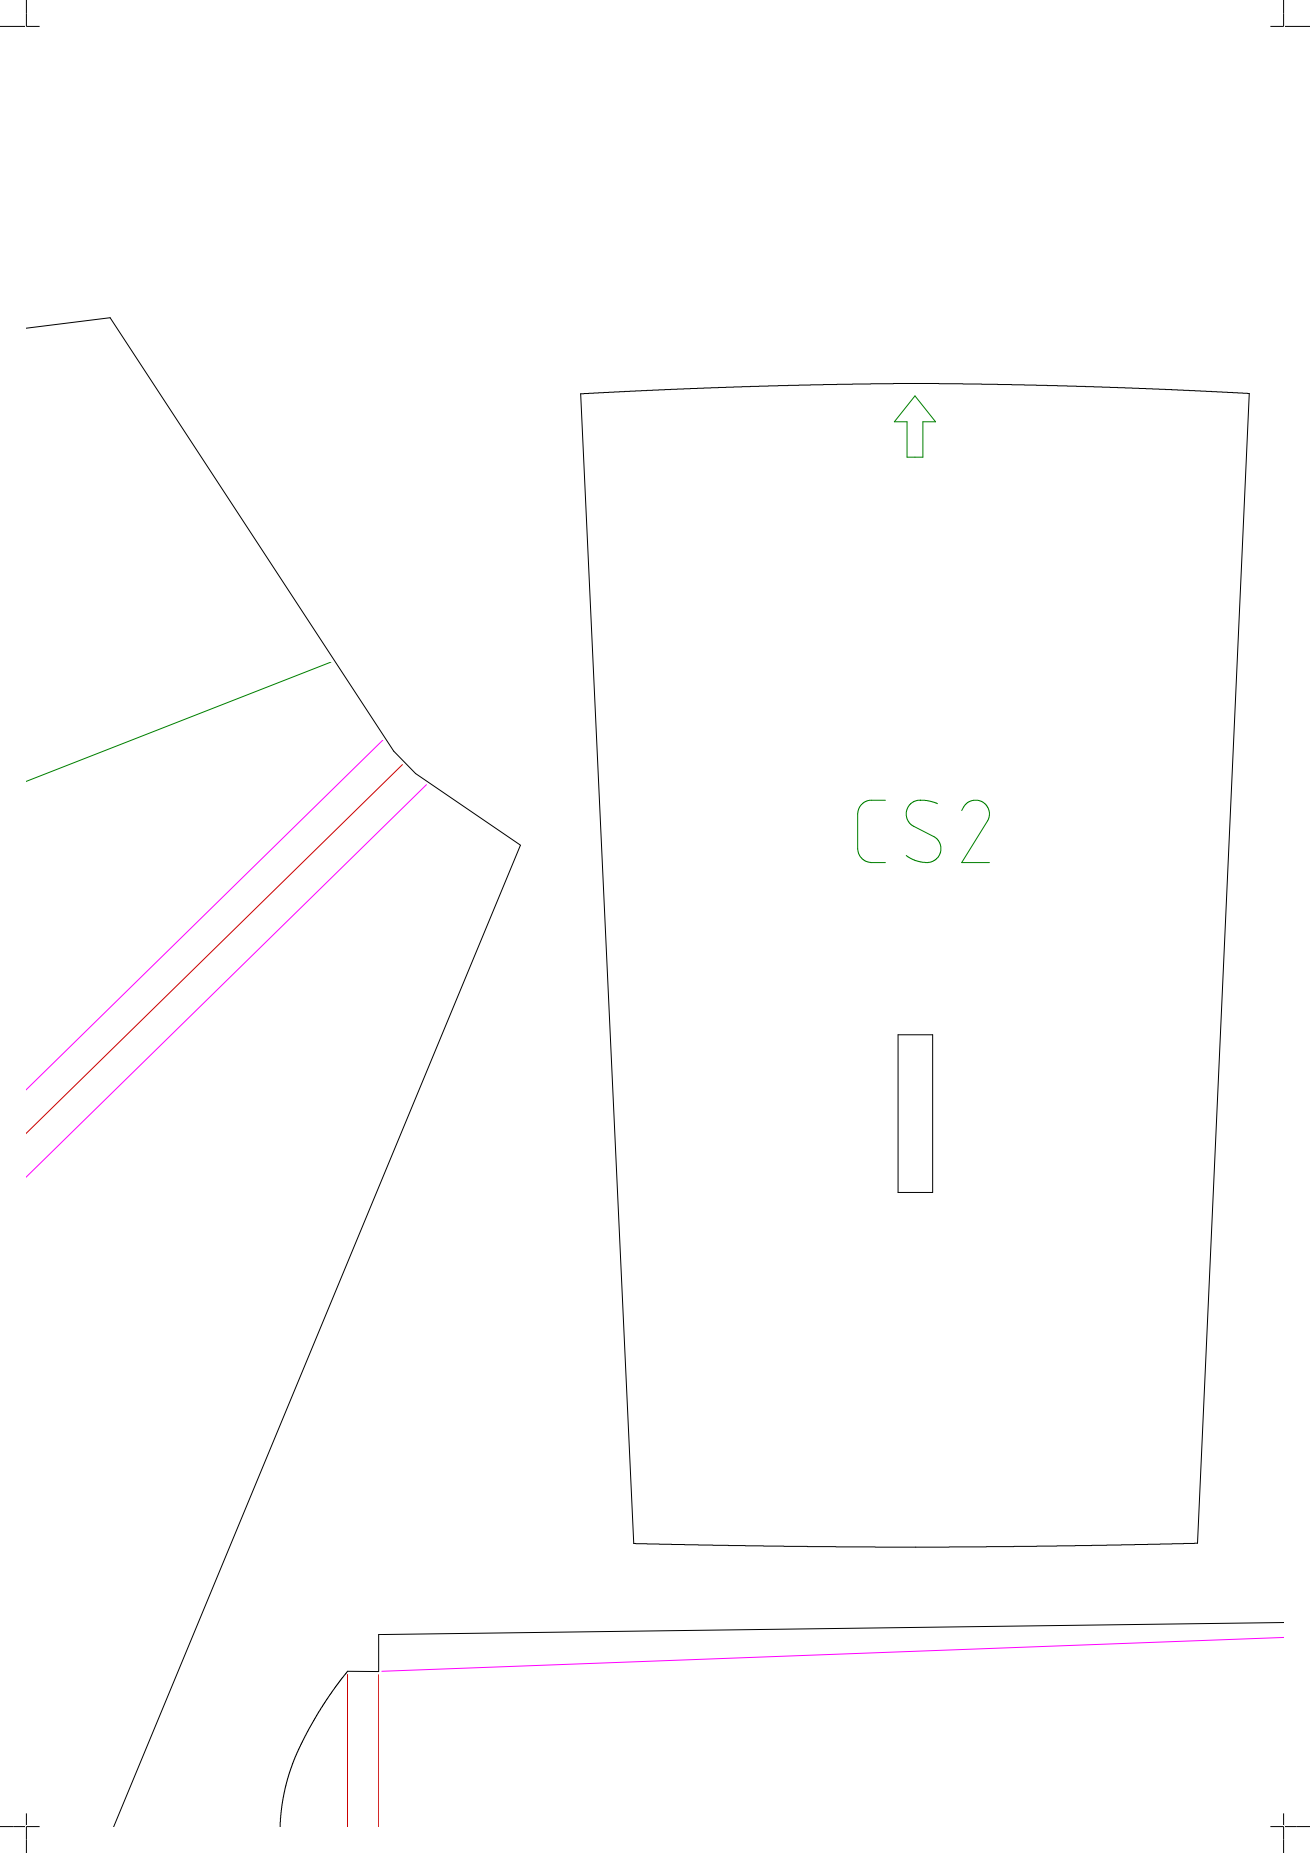
[picture p88: page 2]

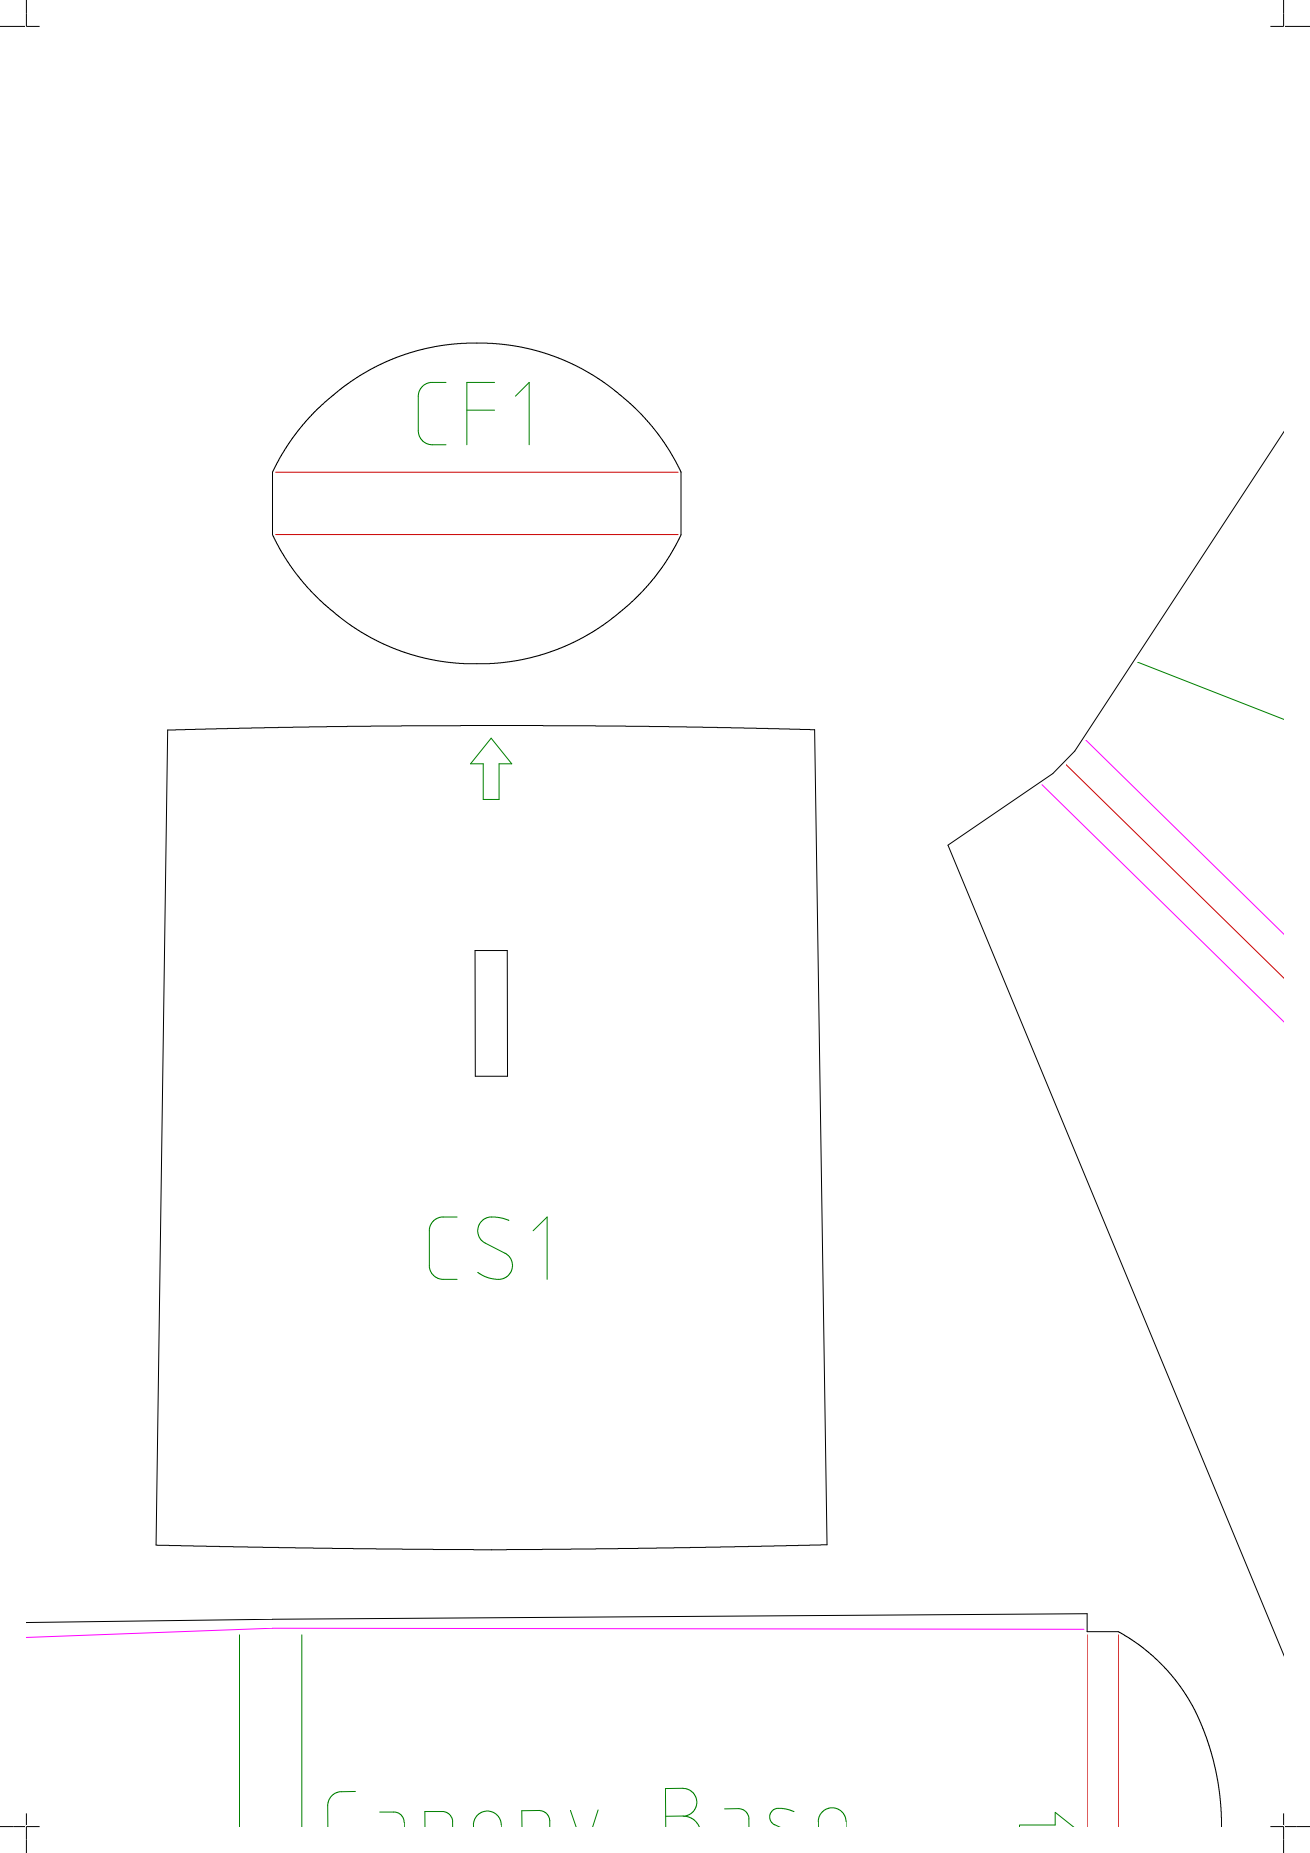
[picture p89: page 3]

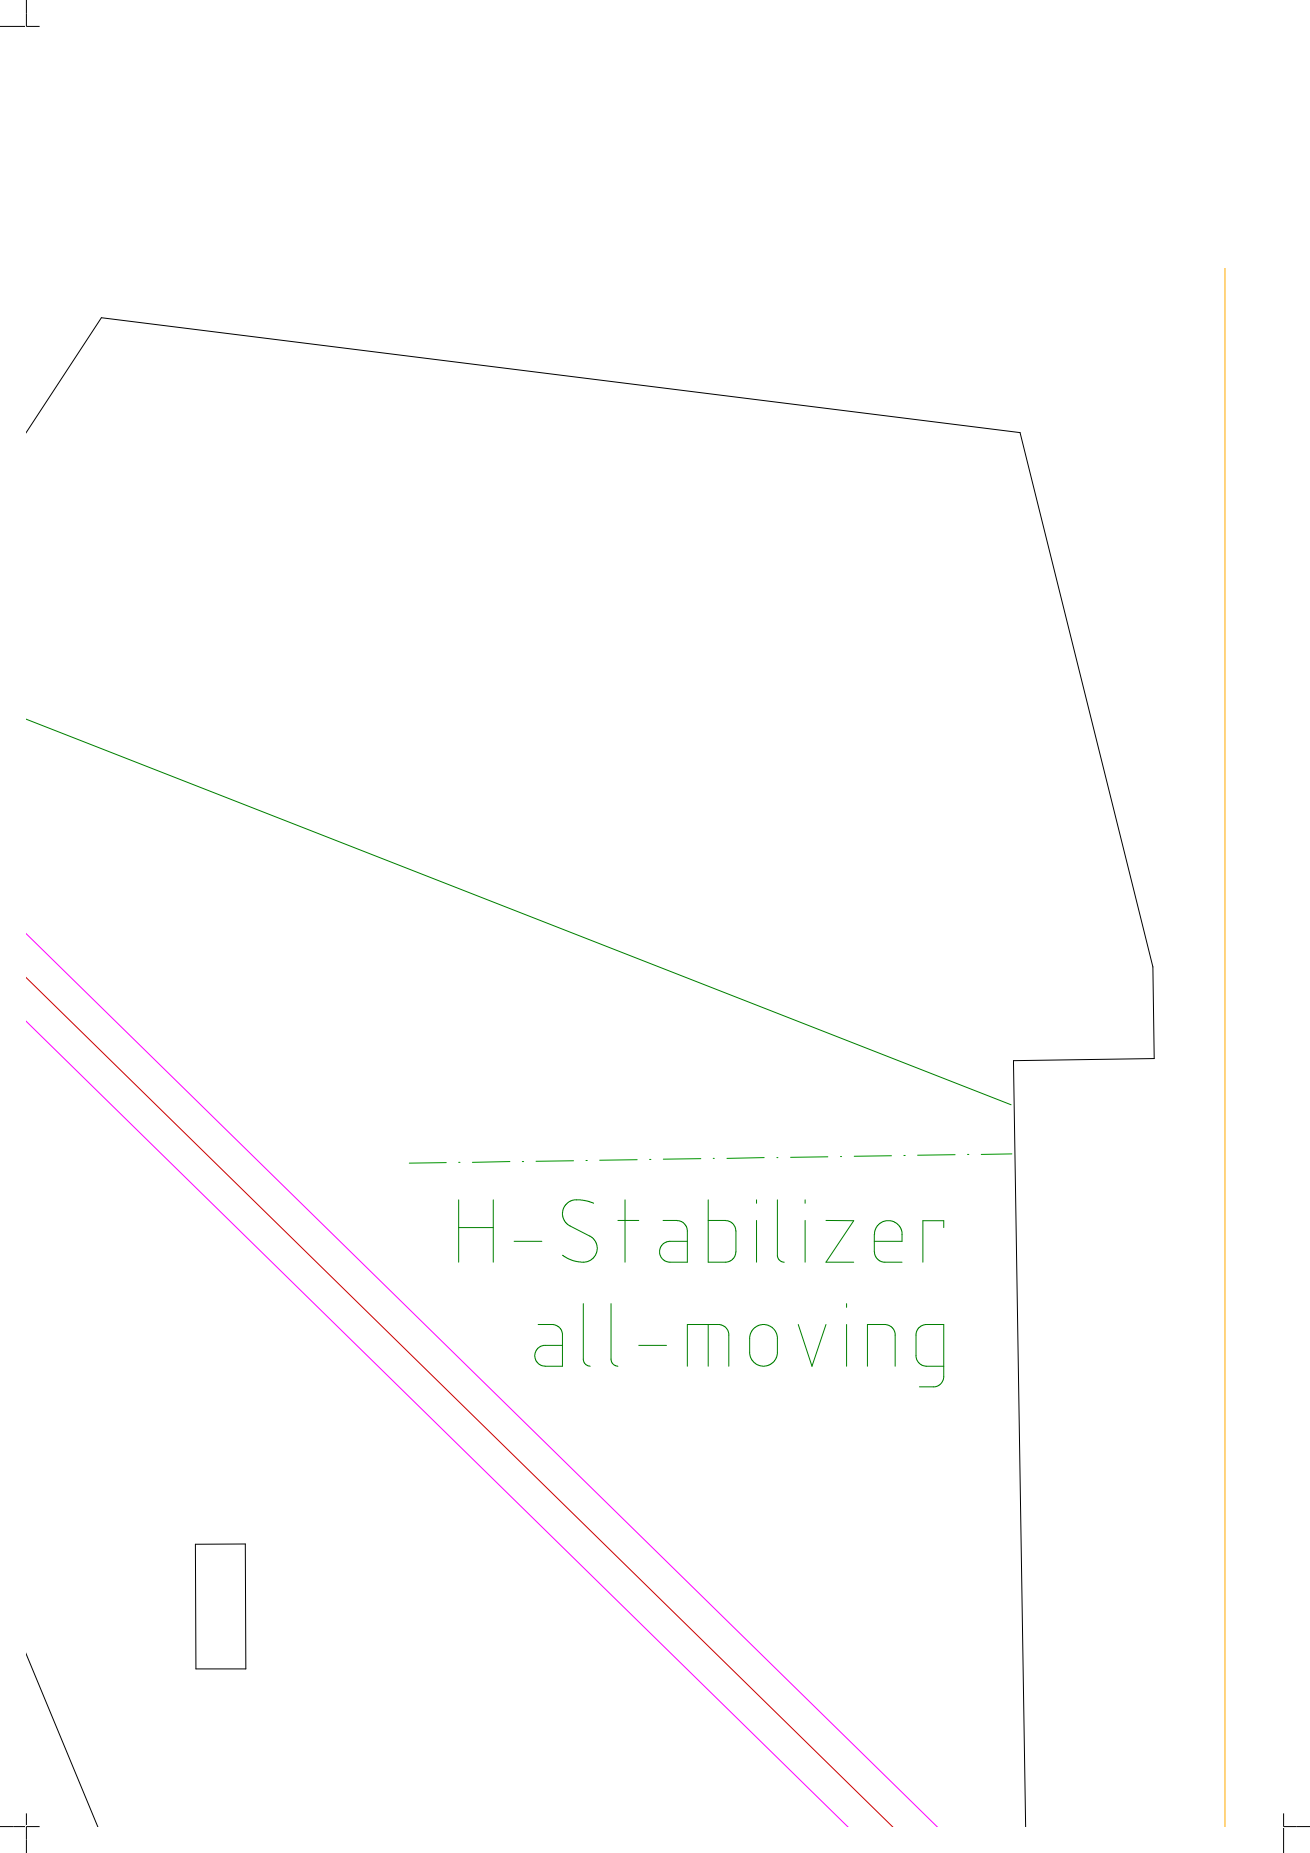
[picture p90: page 4]

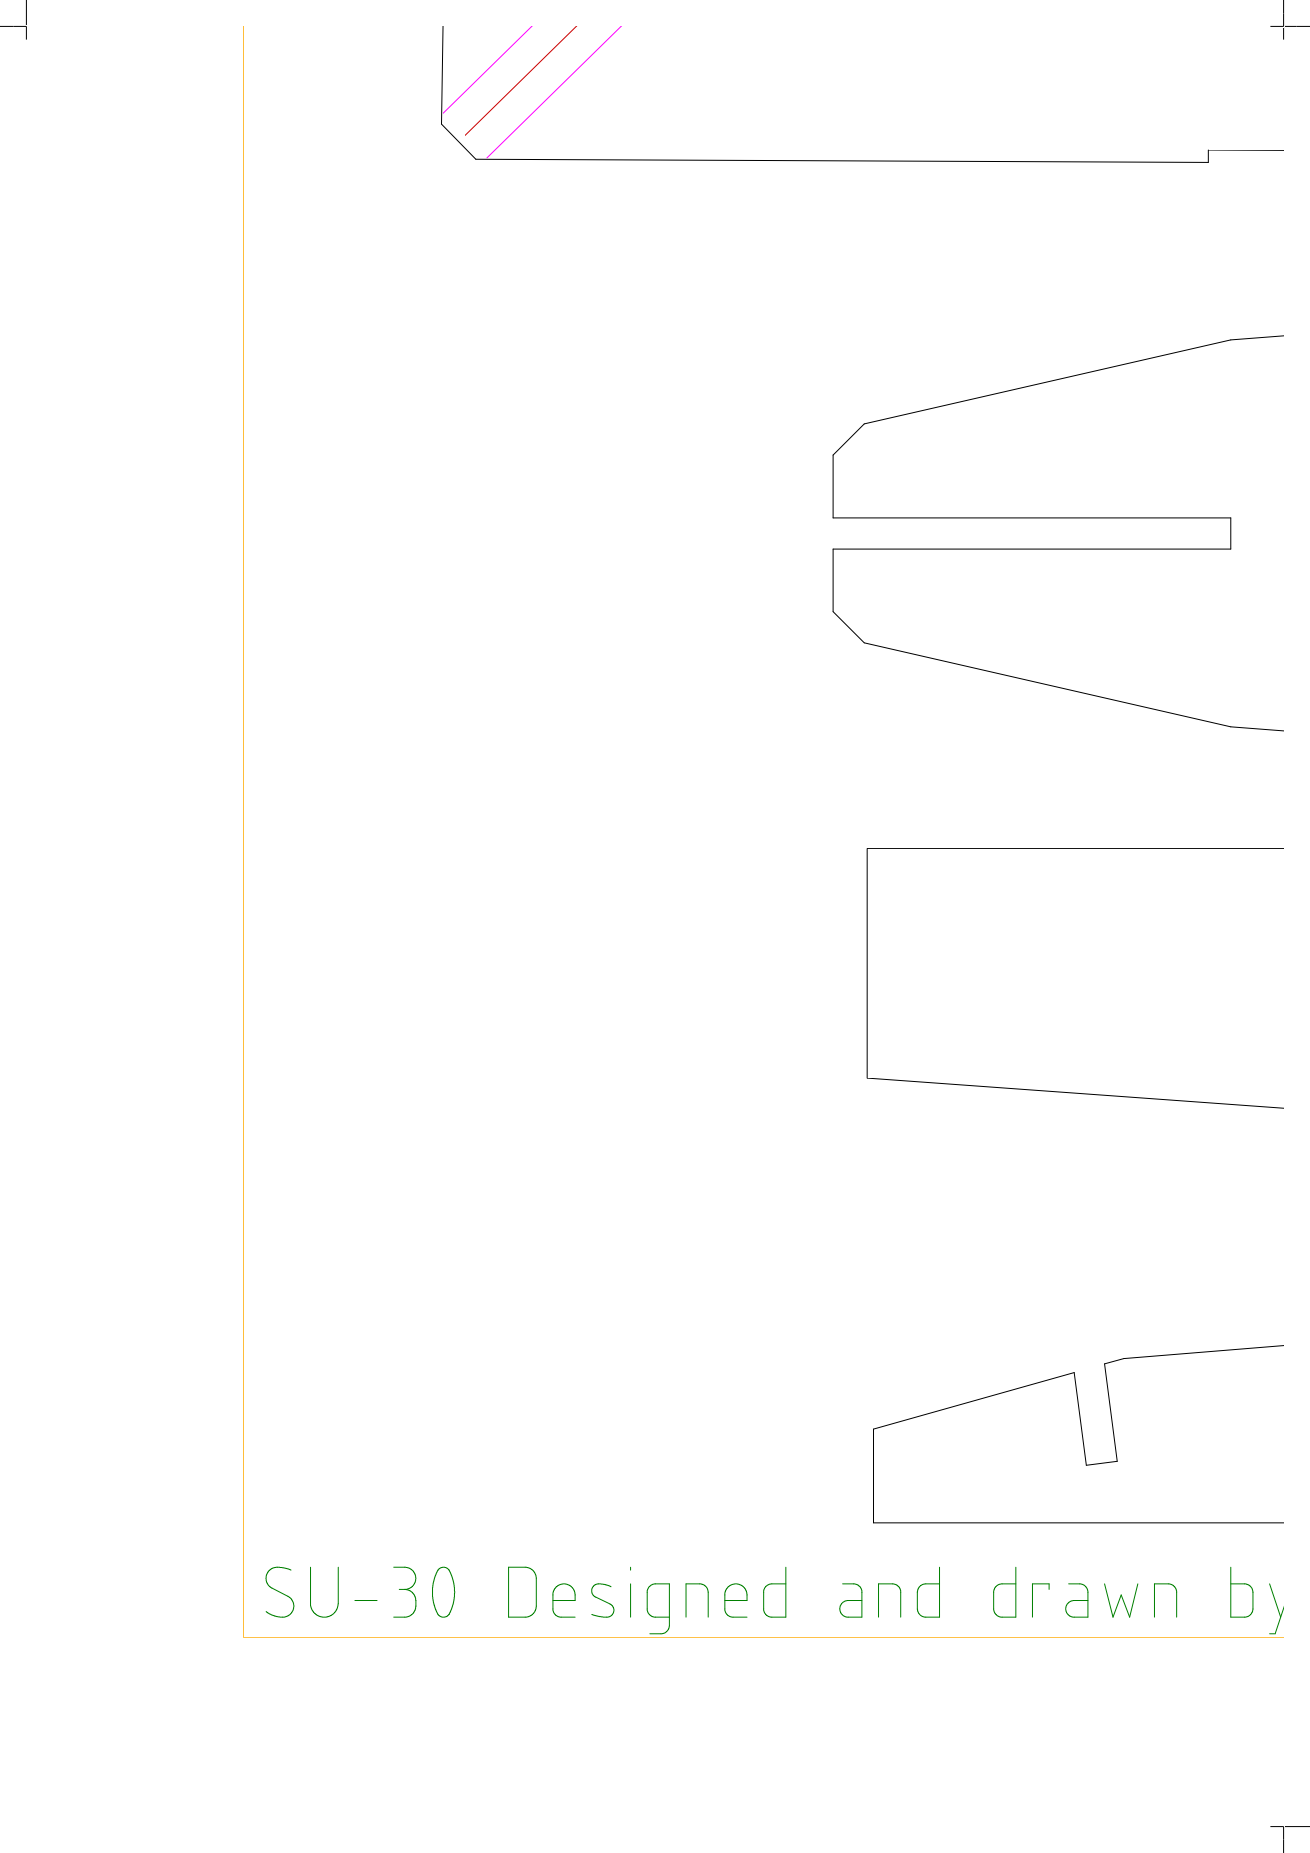
[picture p91: page 5]

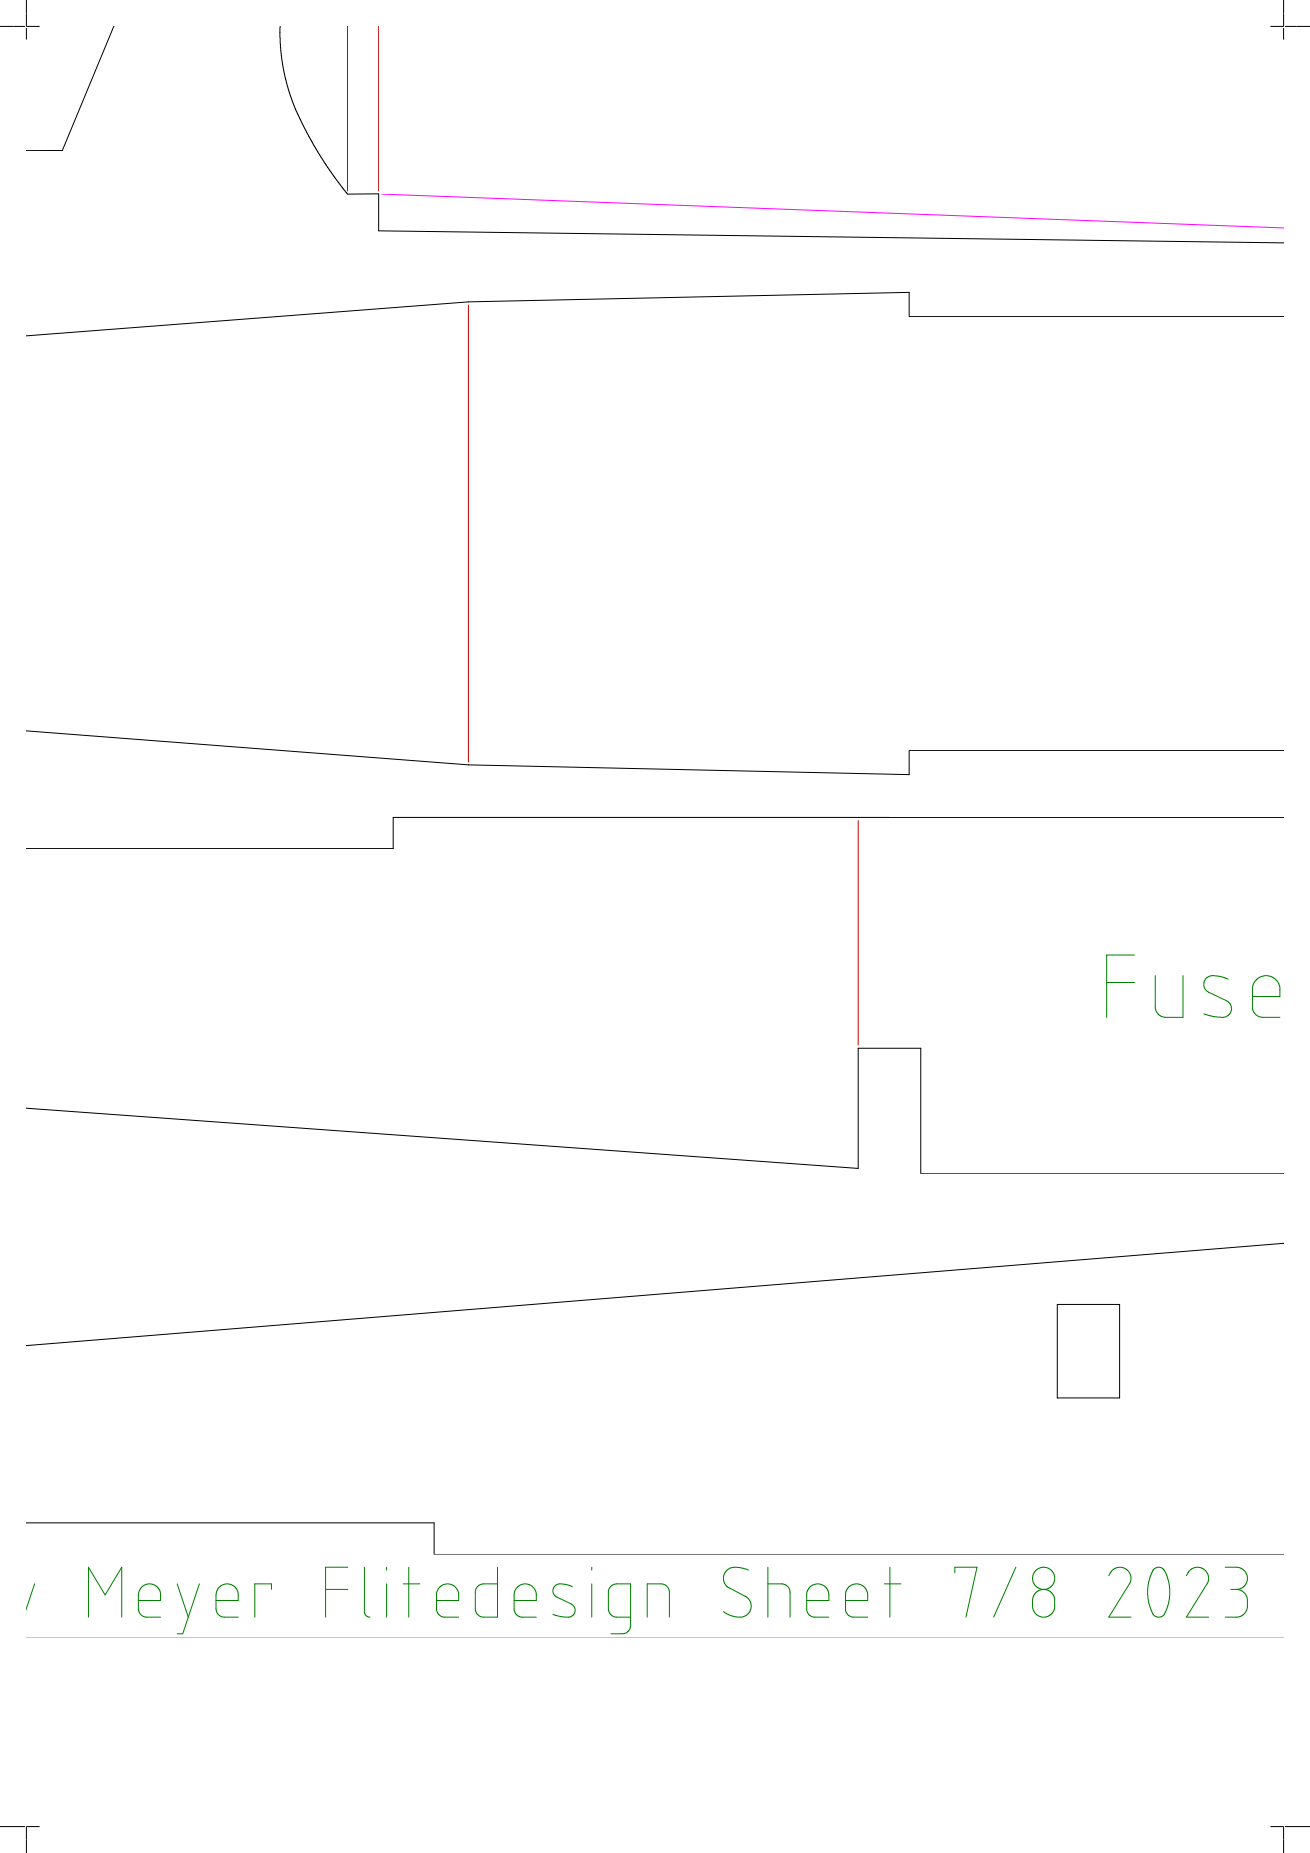
[picture p92: page 6]

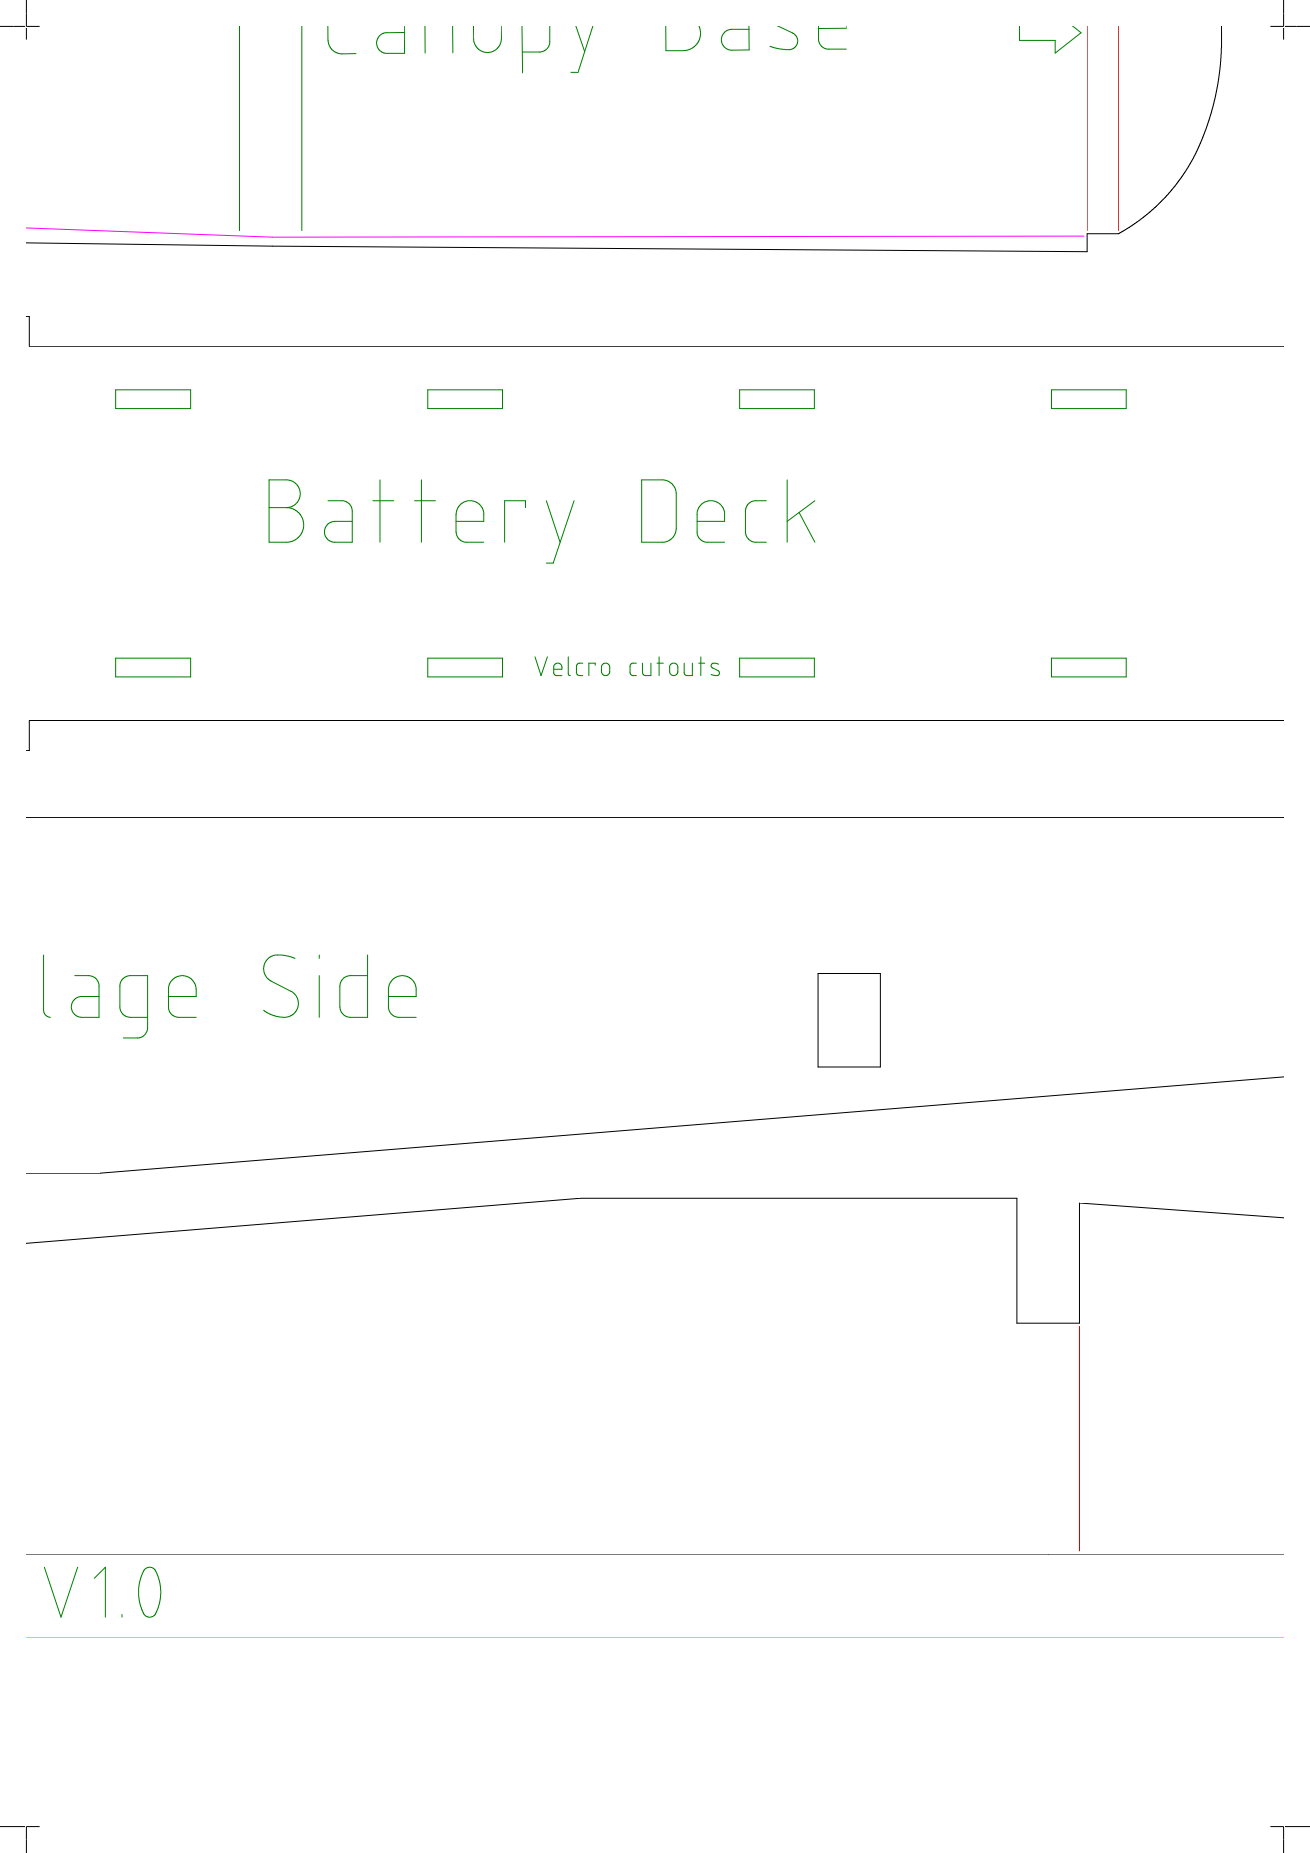
[picture p93: page 7]
