Meyerflitedesign/SU-30/Sheets/PDF_tiled/Sheet8.pdf

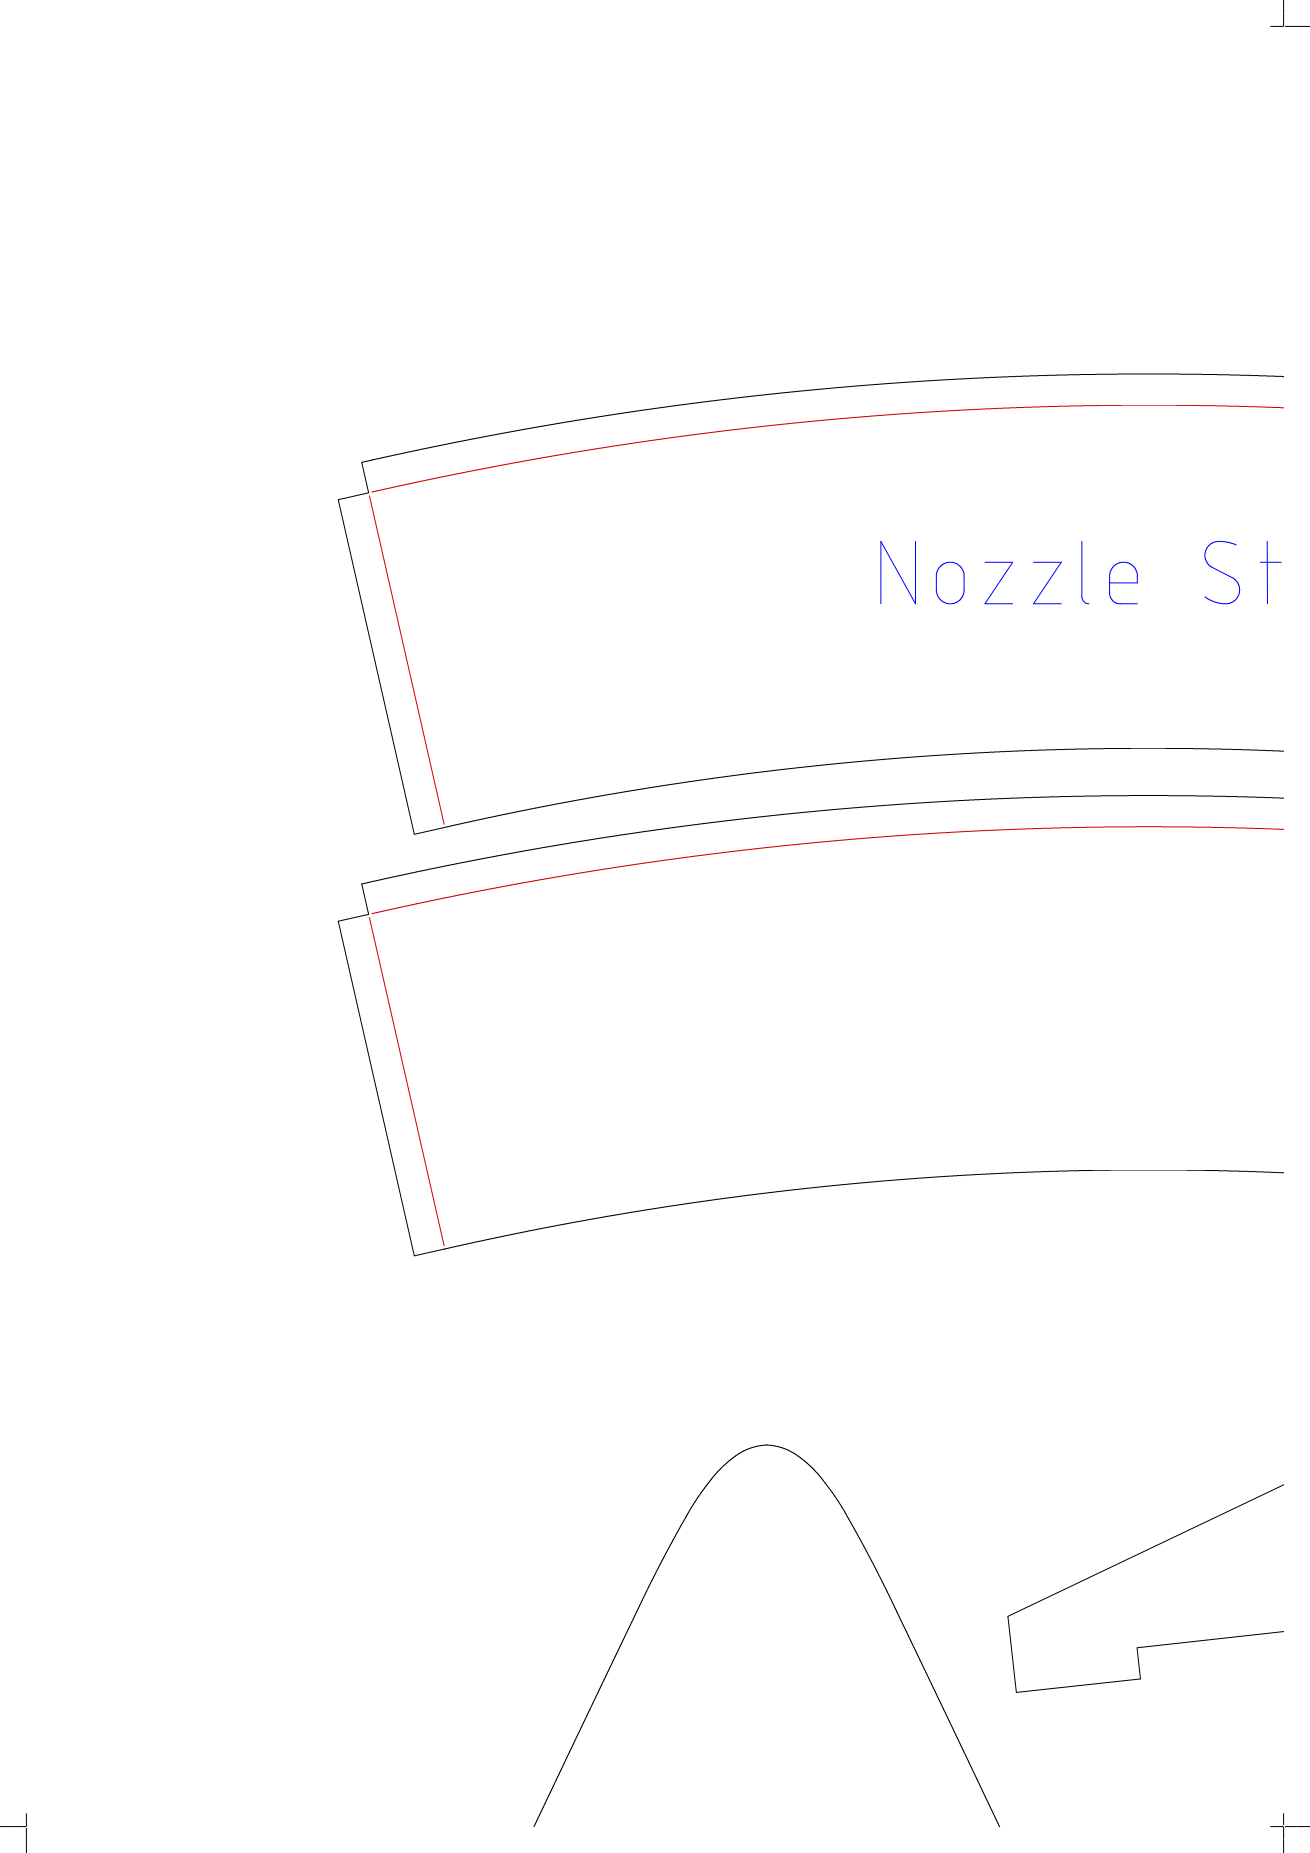
[picture p94: page 1]

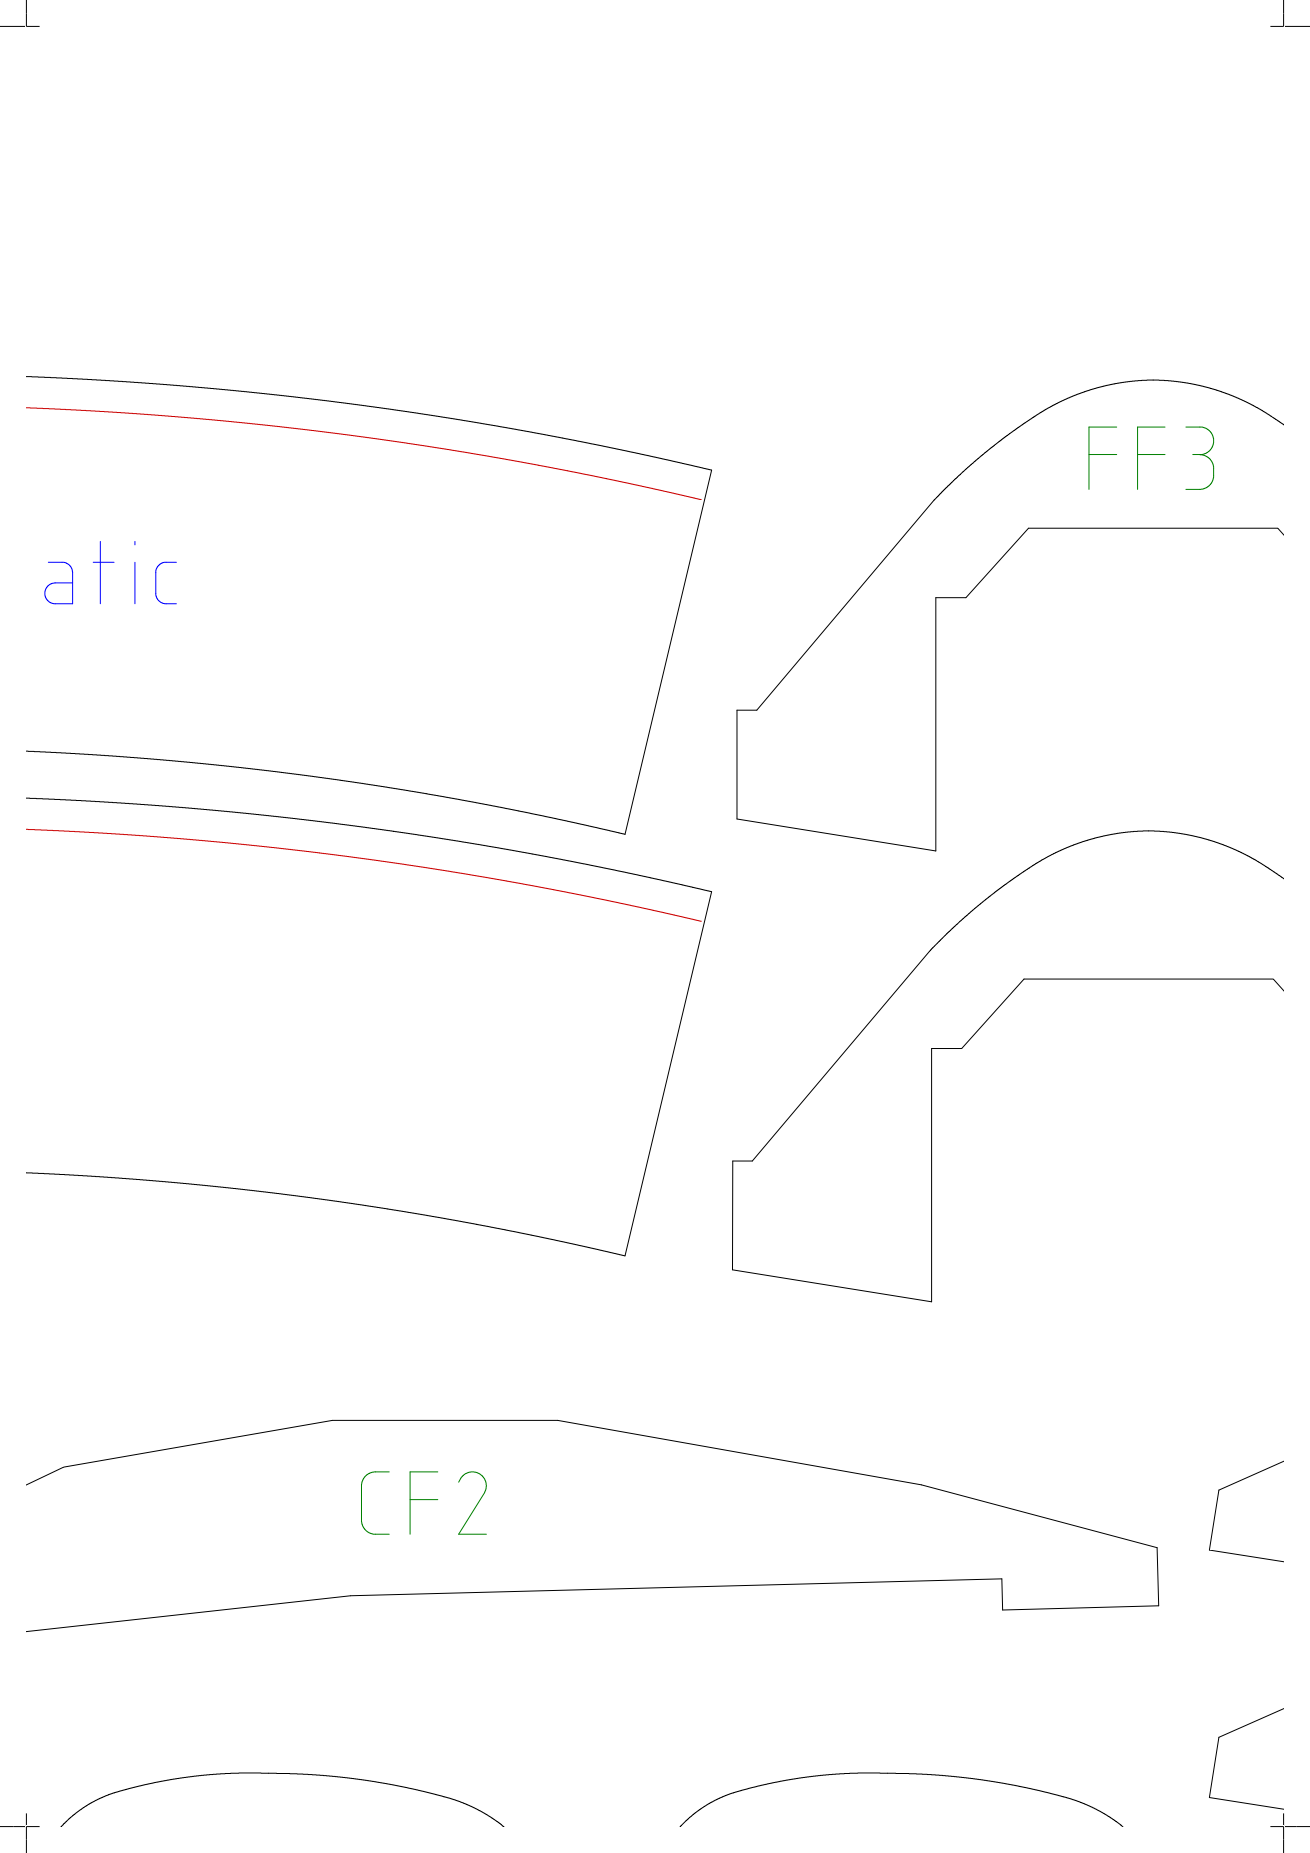
[picture p95: page 2]

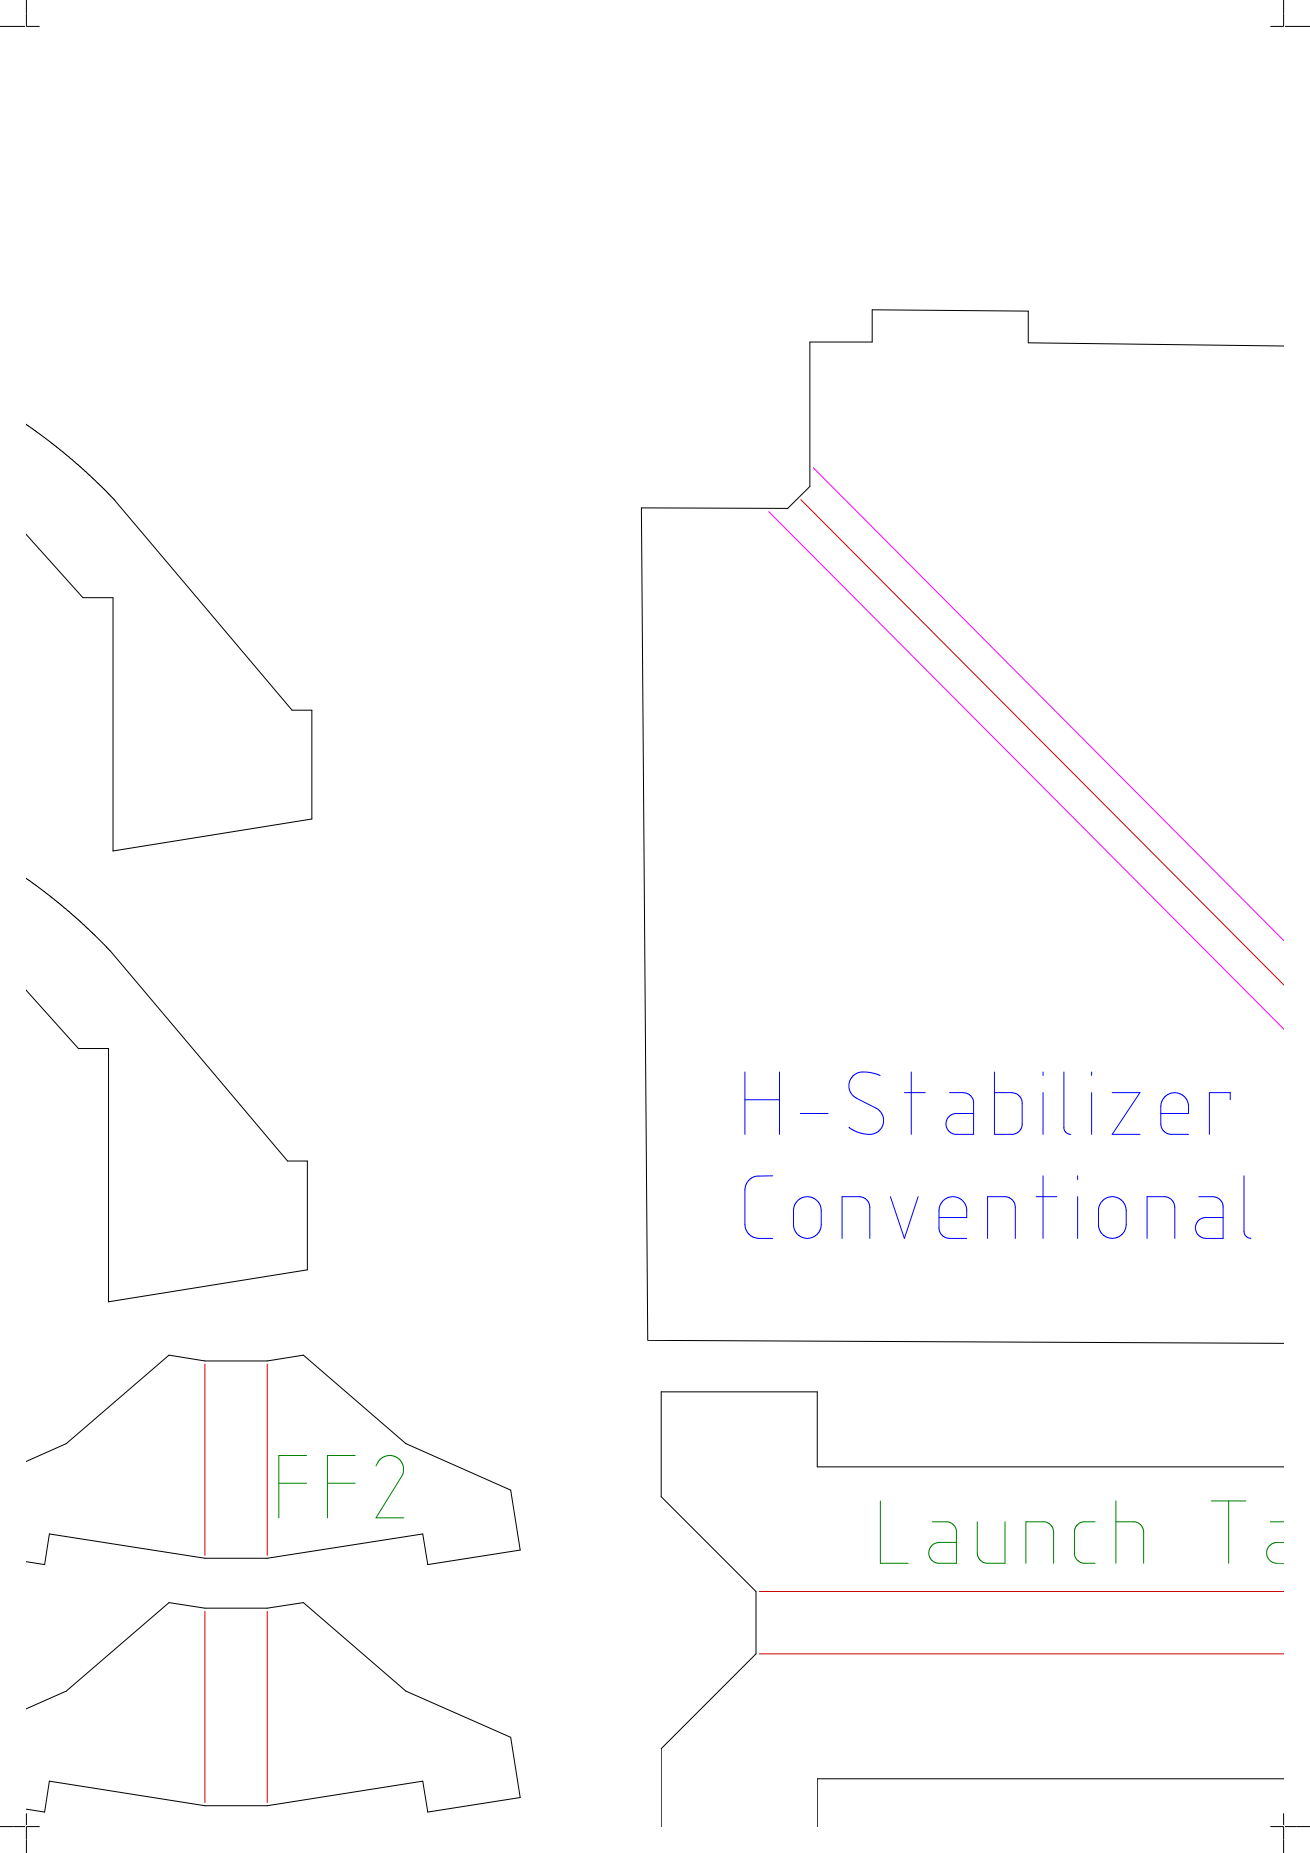
[picture p96: page 3]

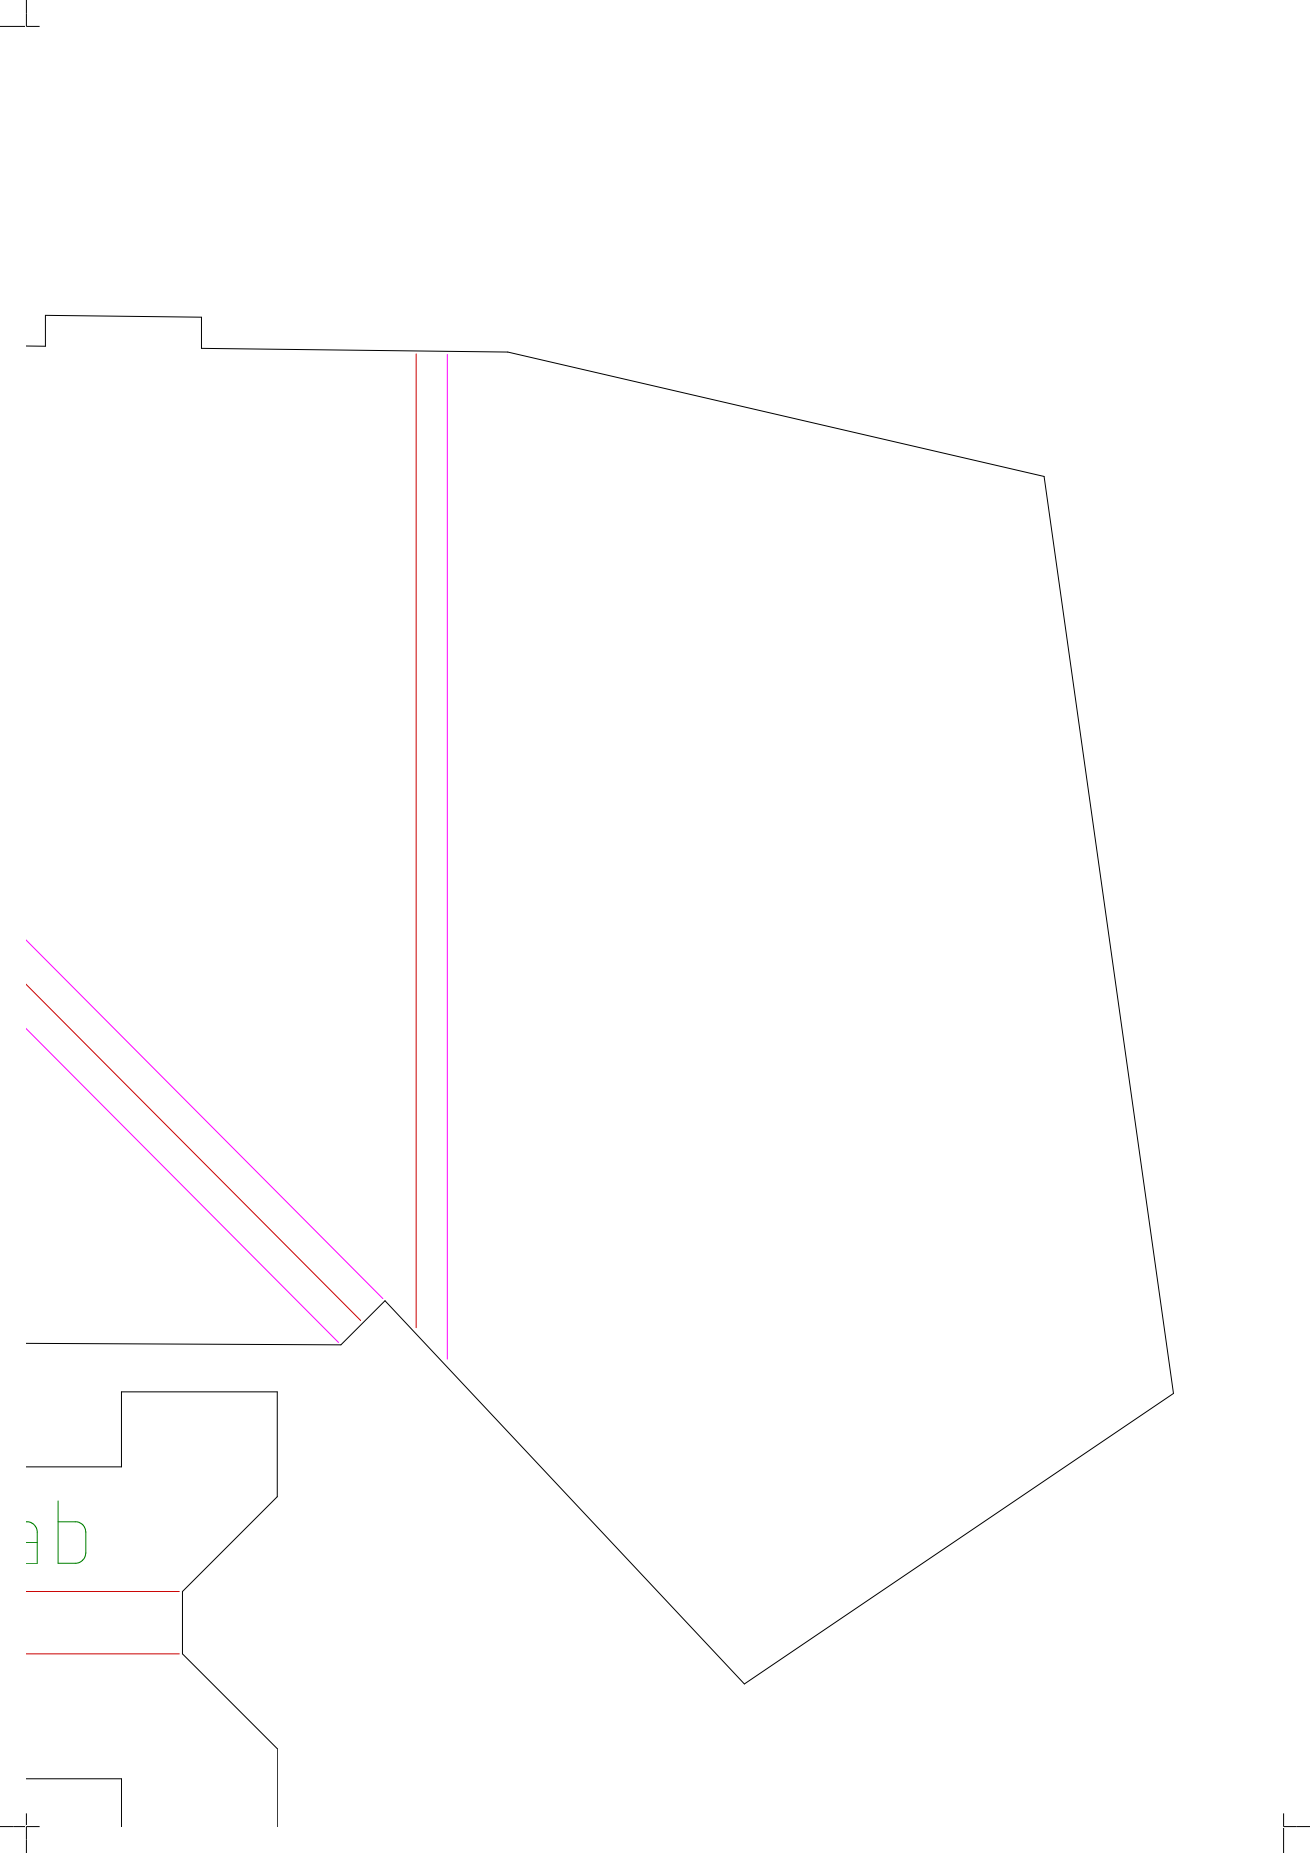
[picture p97: page 4]

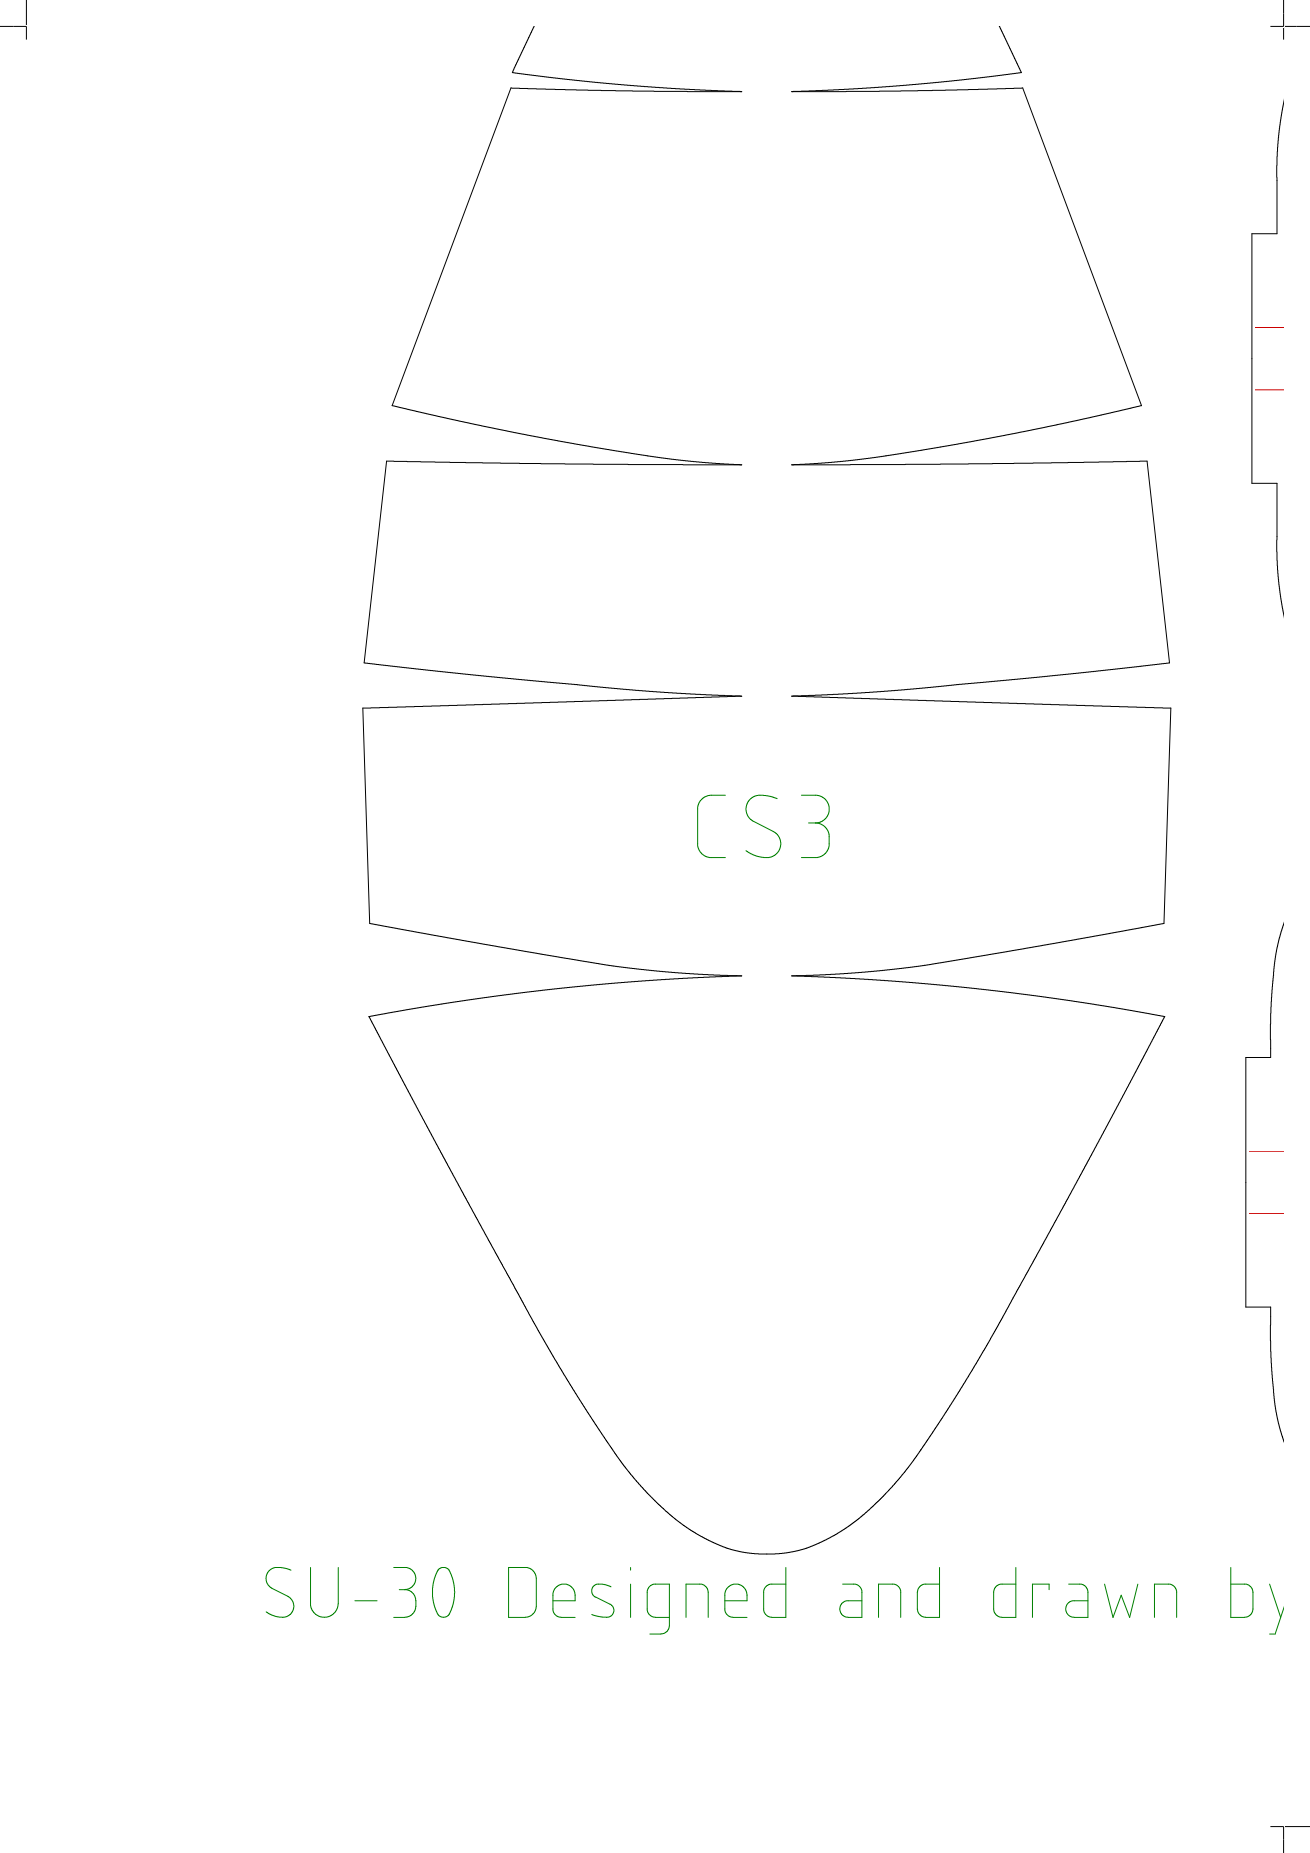
[picture p98: page 5]

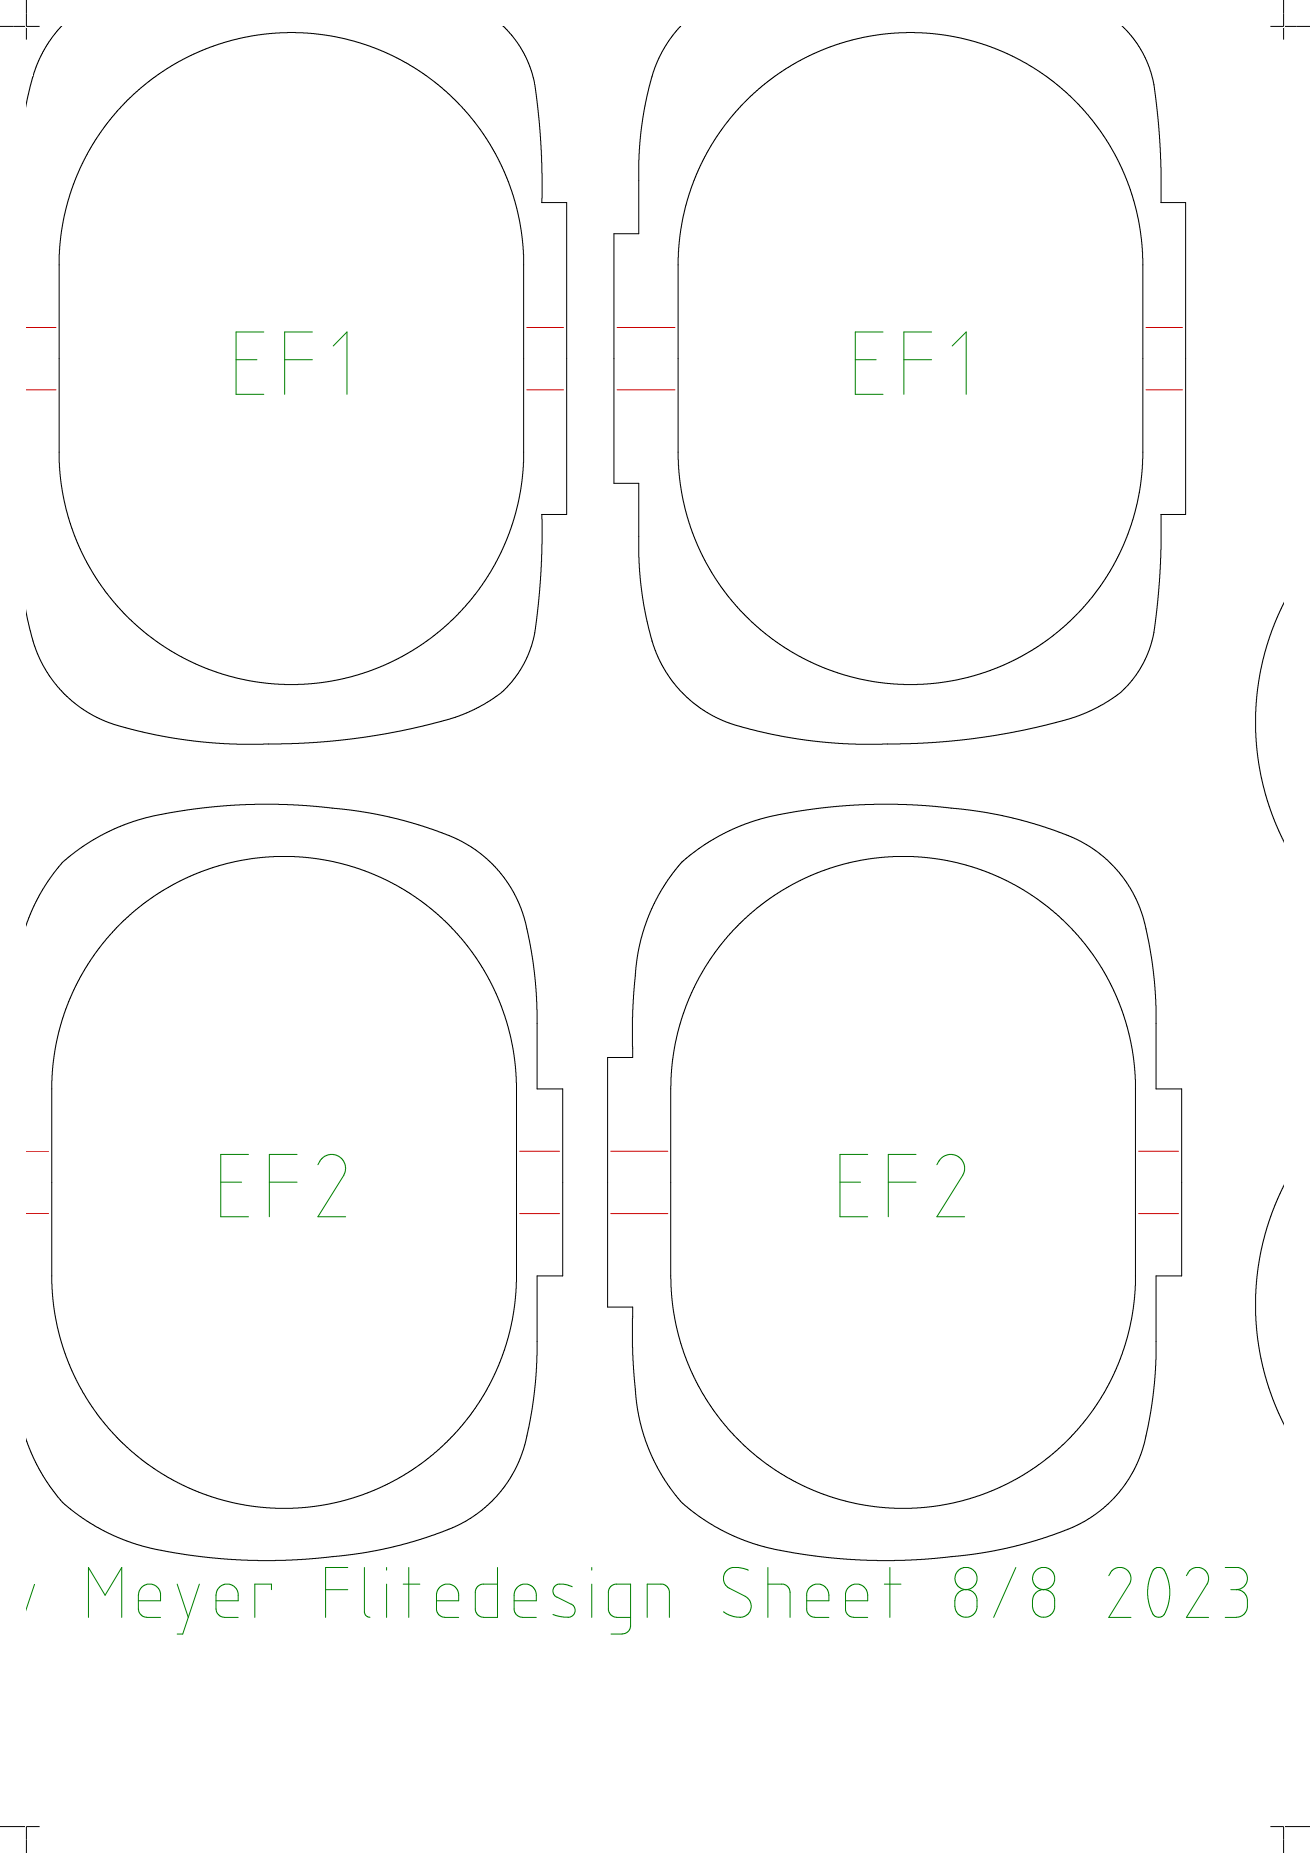
[picture p99: page 6]

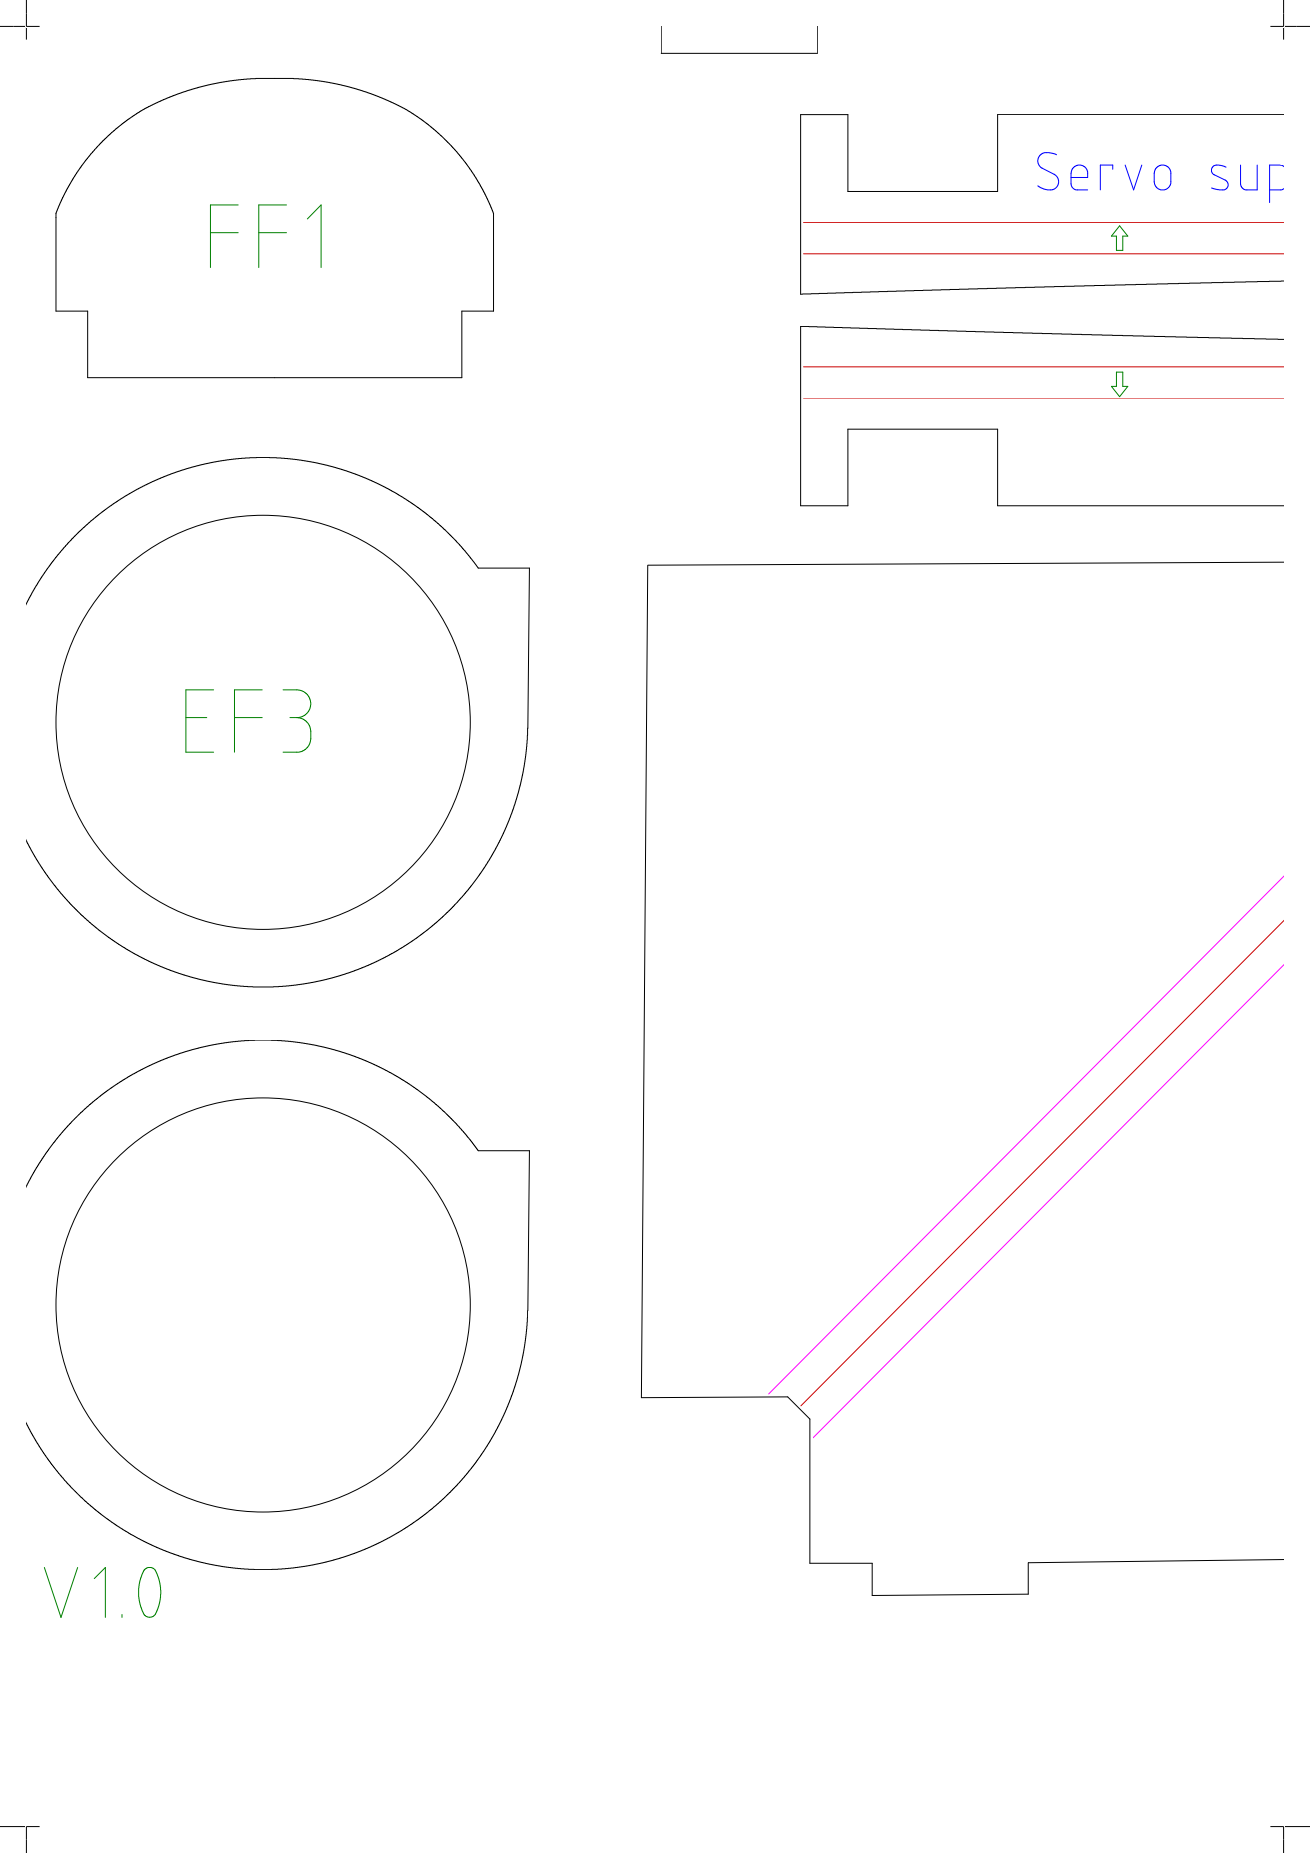
[picture p100: page 7]

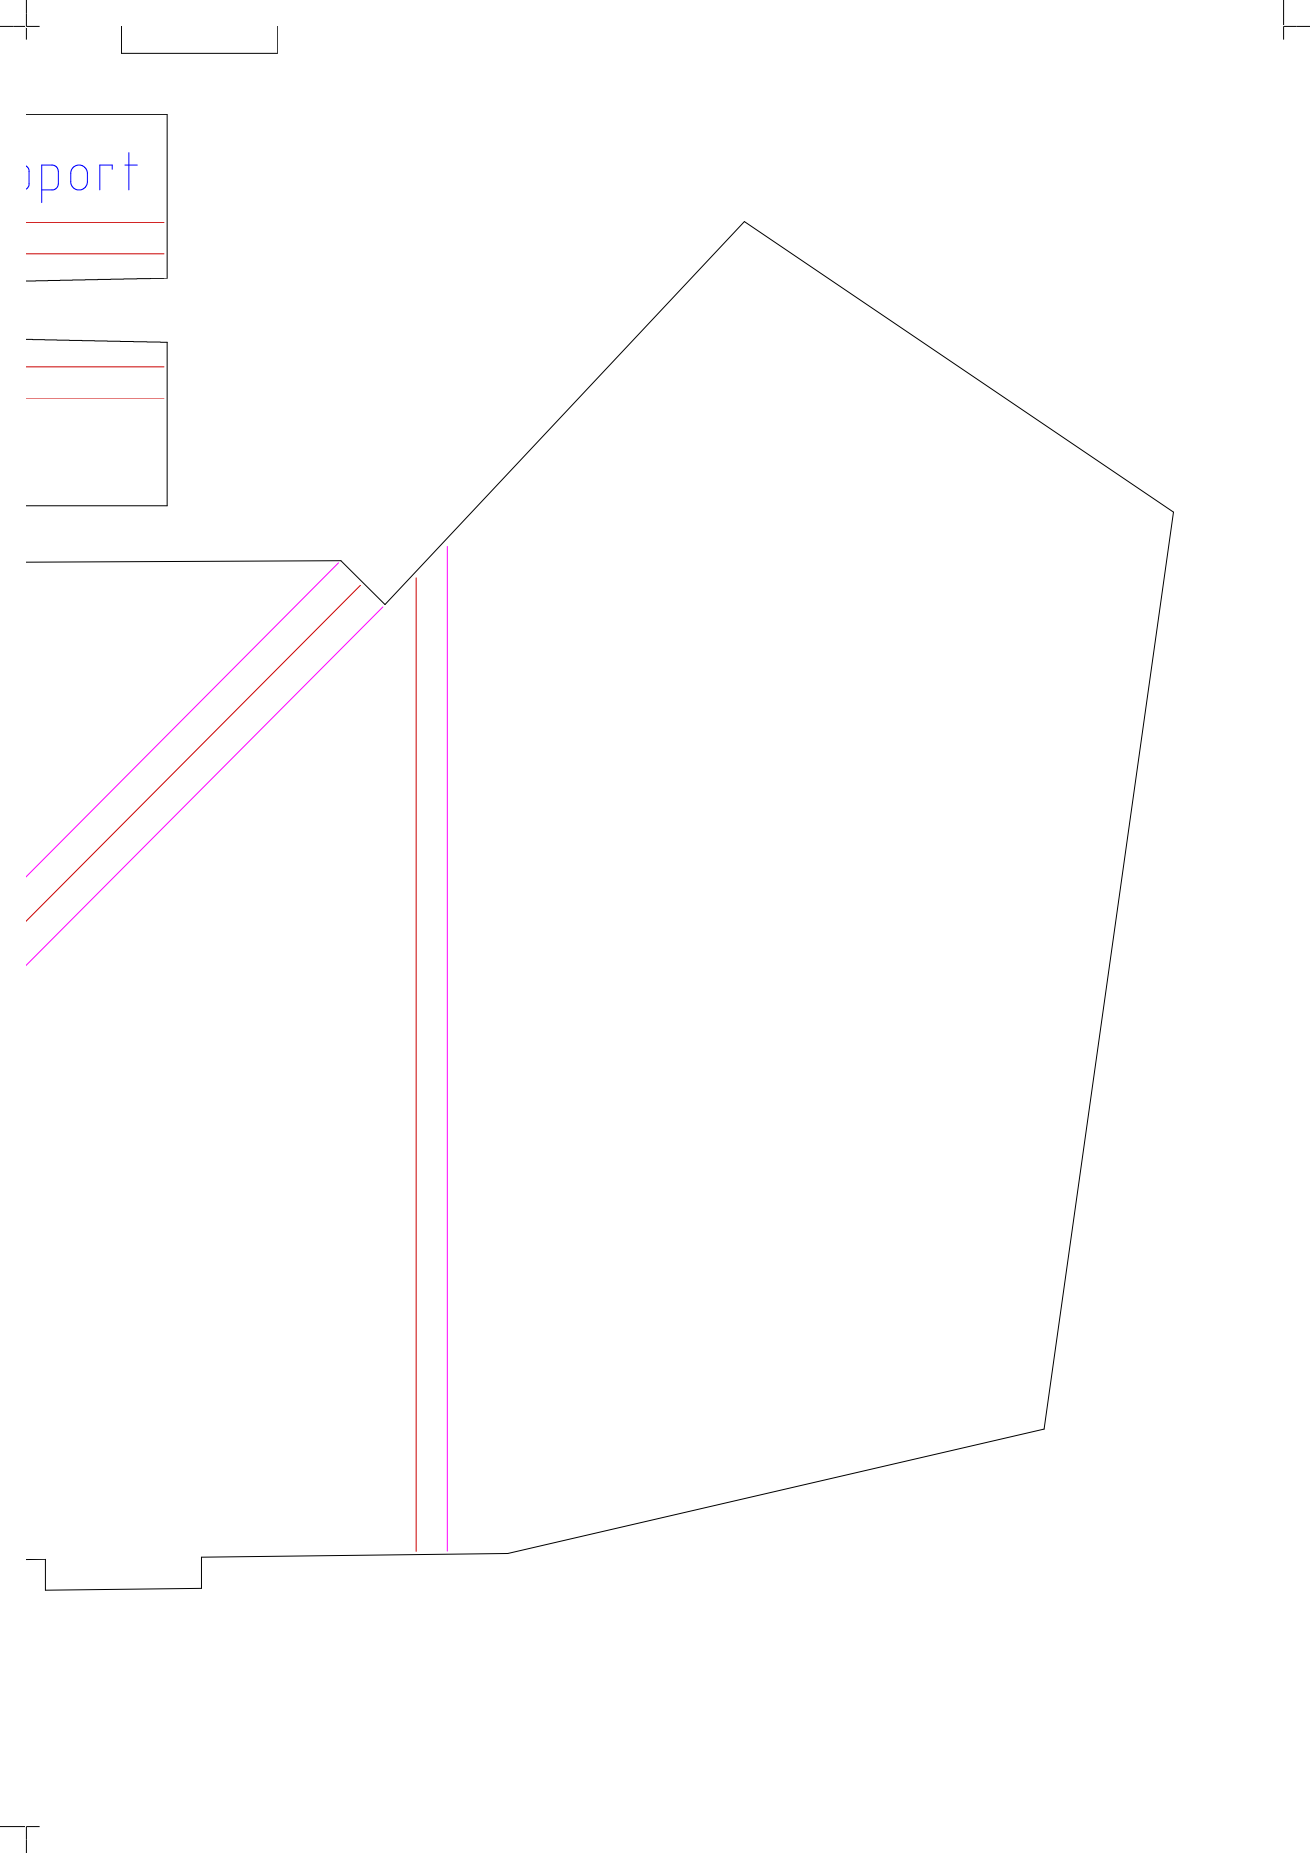
[picture p101: page 8]
