Meyerflitedesign/SU-30/Sheets/PDF_tiled/thrust_tube_conventional.pdf

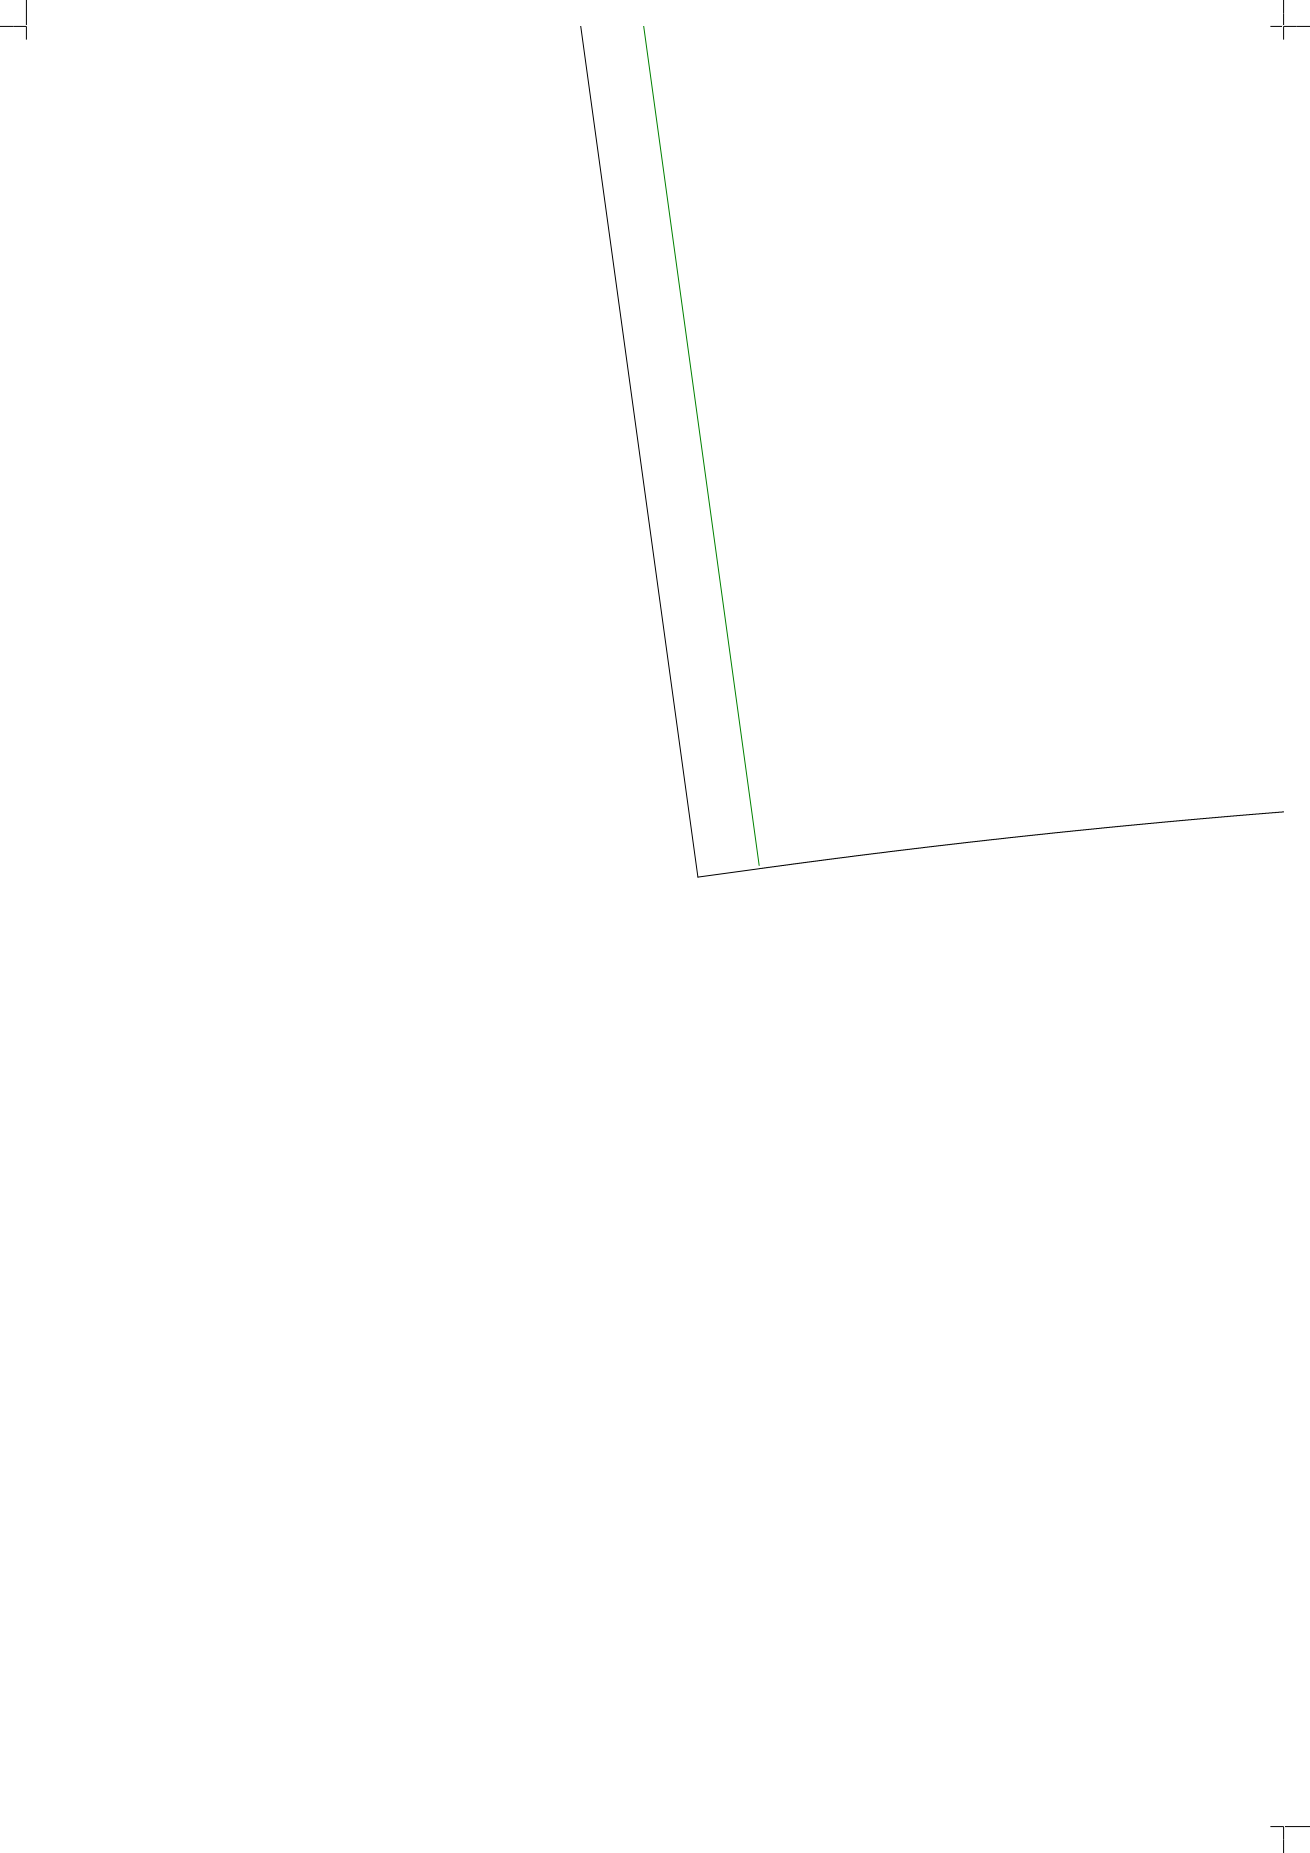
[picture p102: page 1]

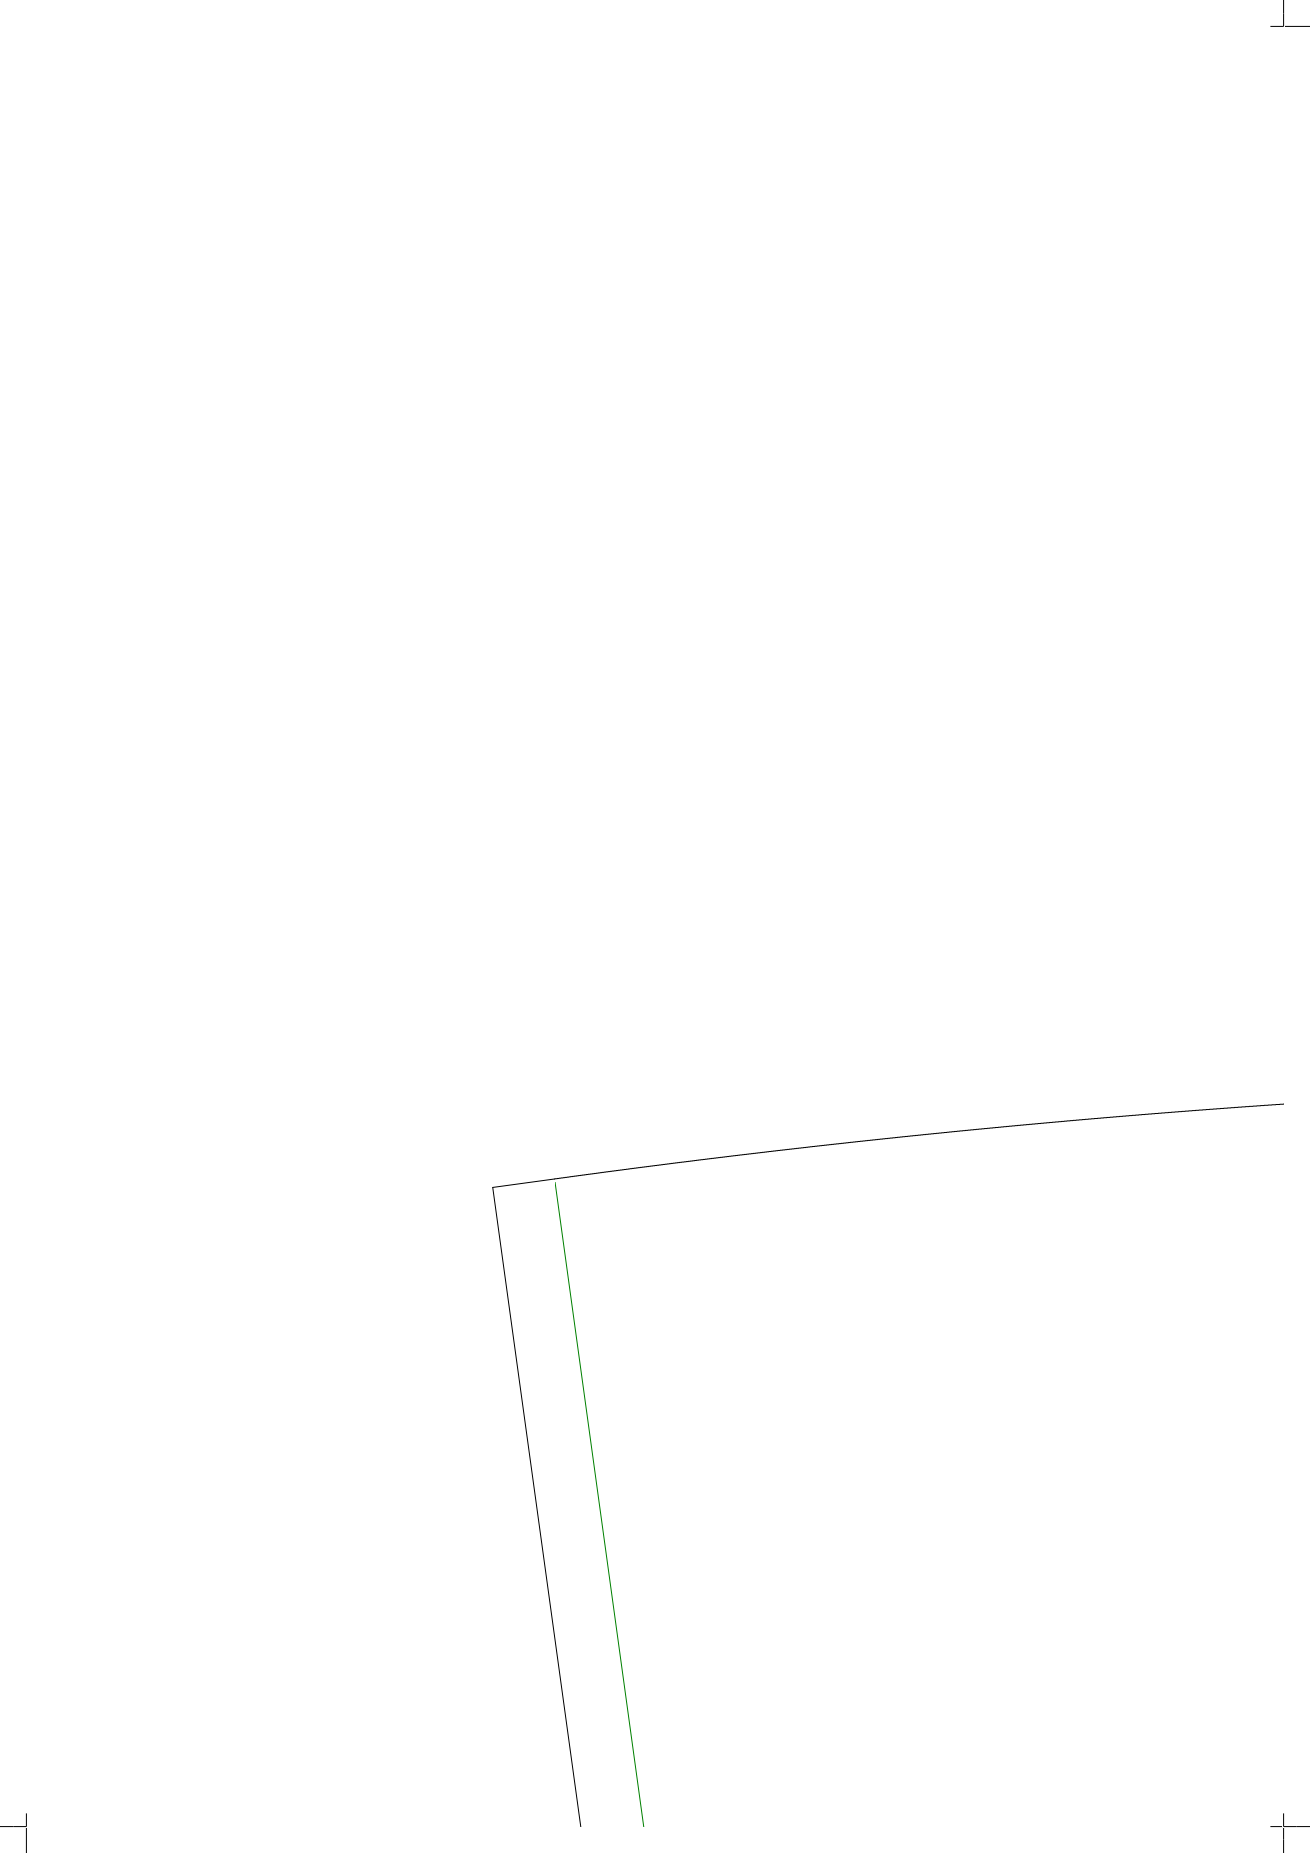
[picture p103: page 2]

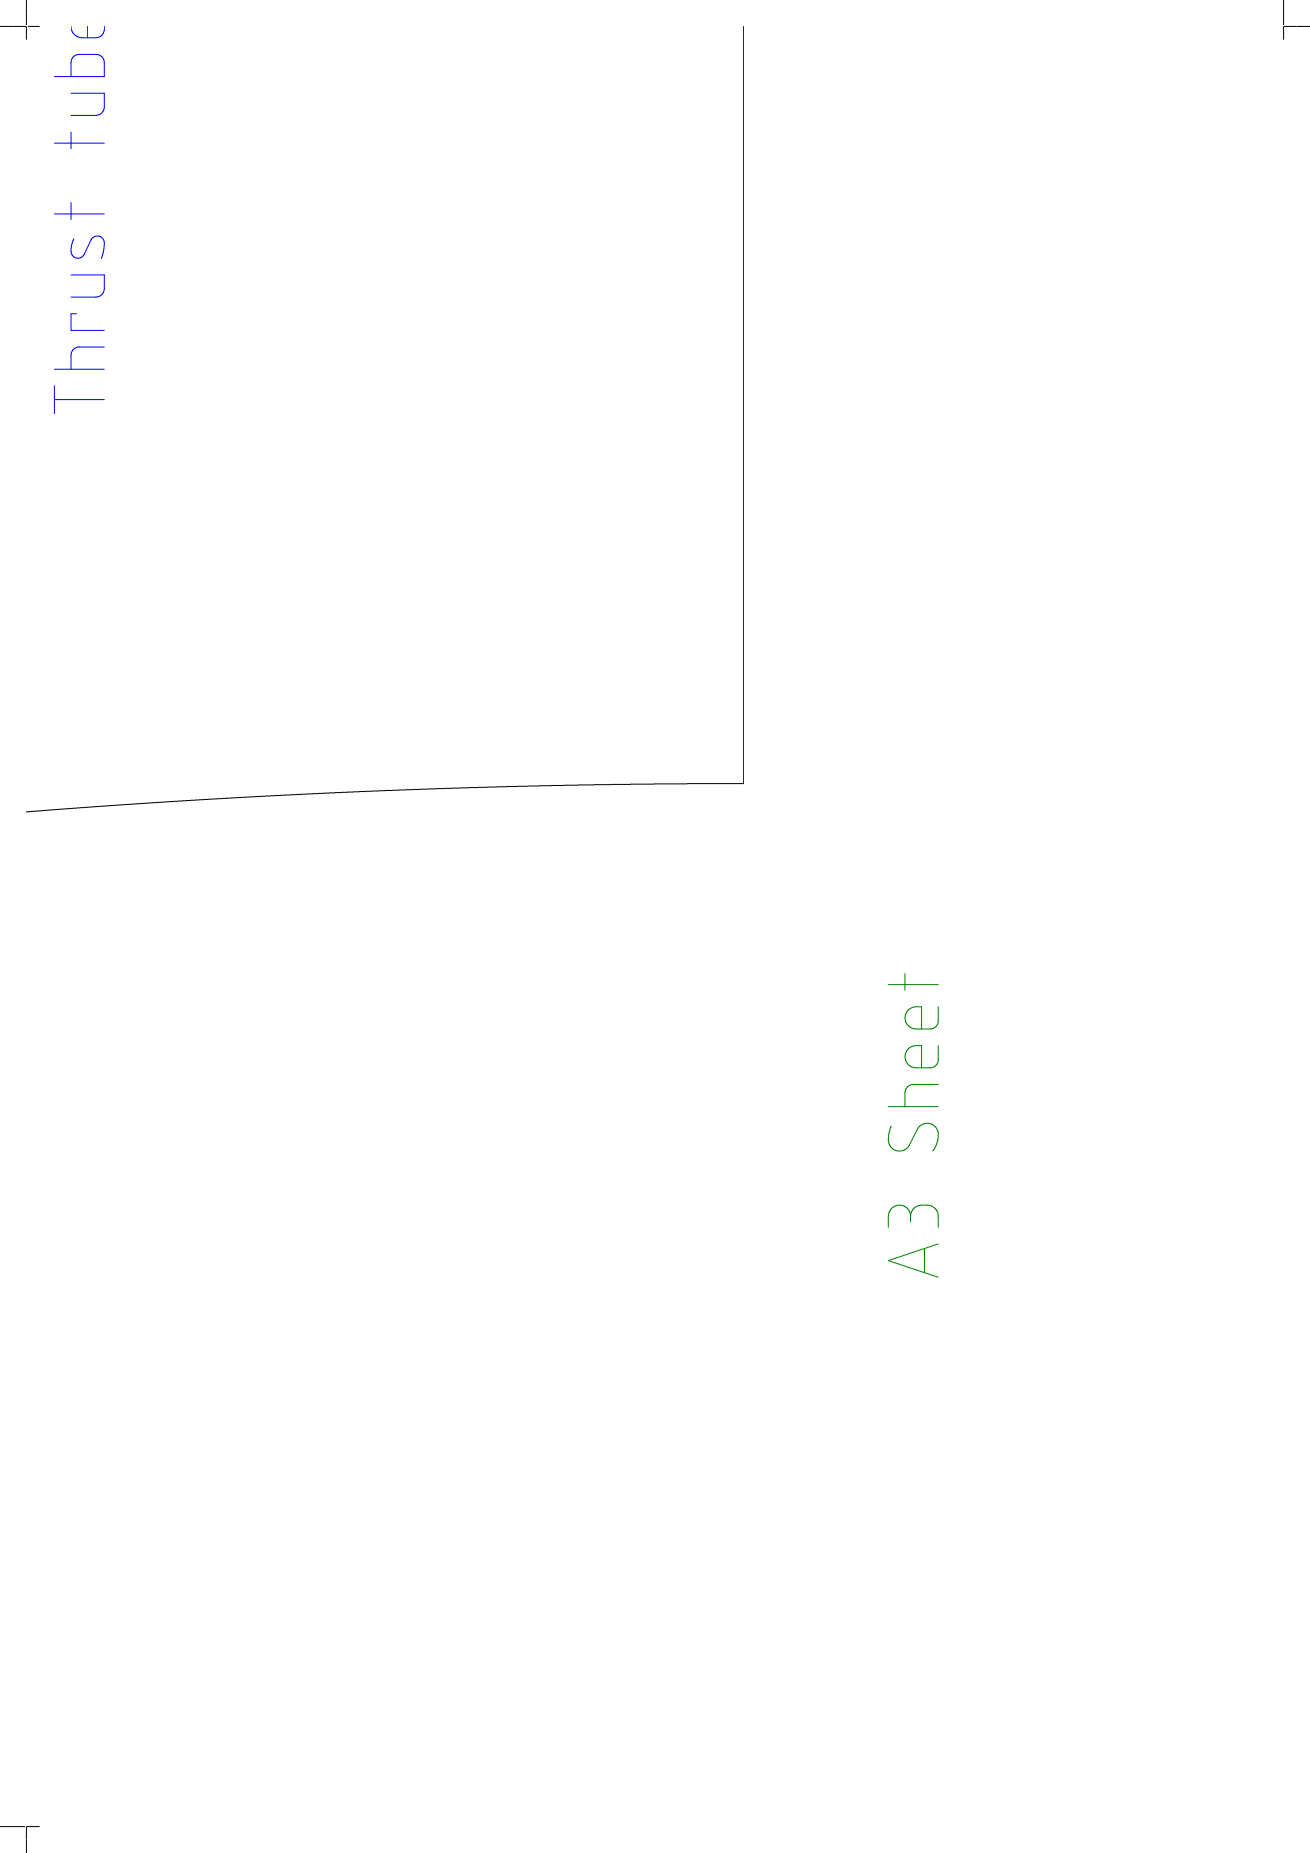
[picture p104: page 3]

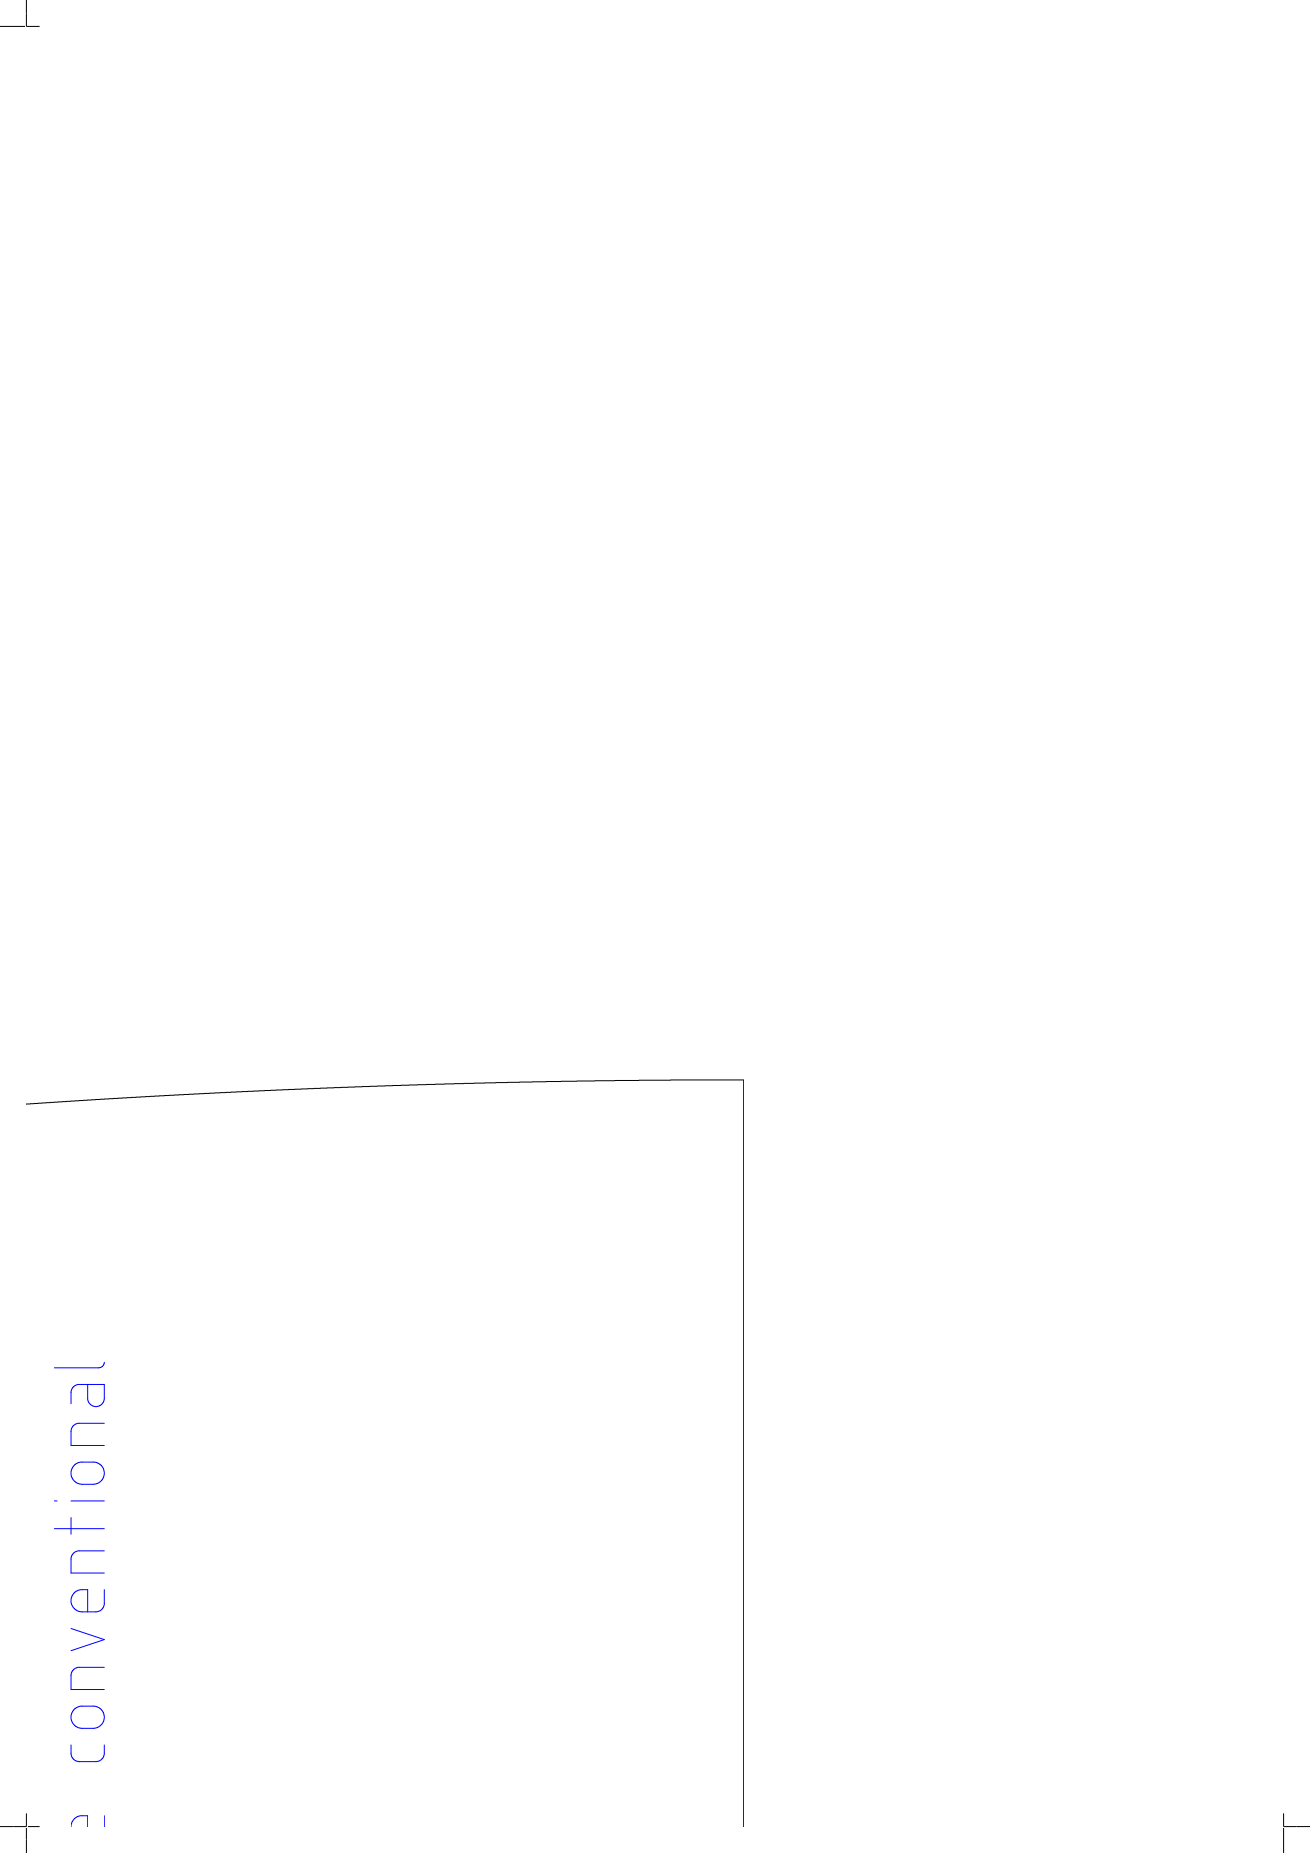
[picture p105: page 4]
