Meyerflitedesign/SU-30/Sheets/PDF_tiled/thrust_tube_vectored.pdf

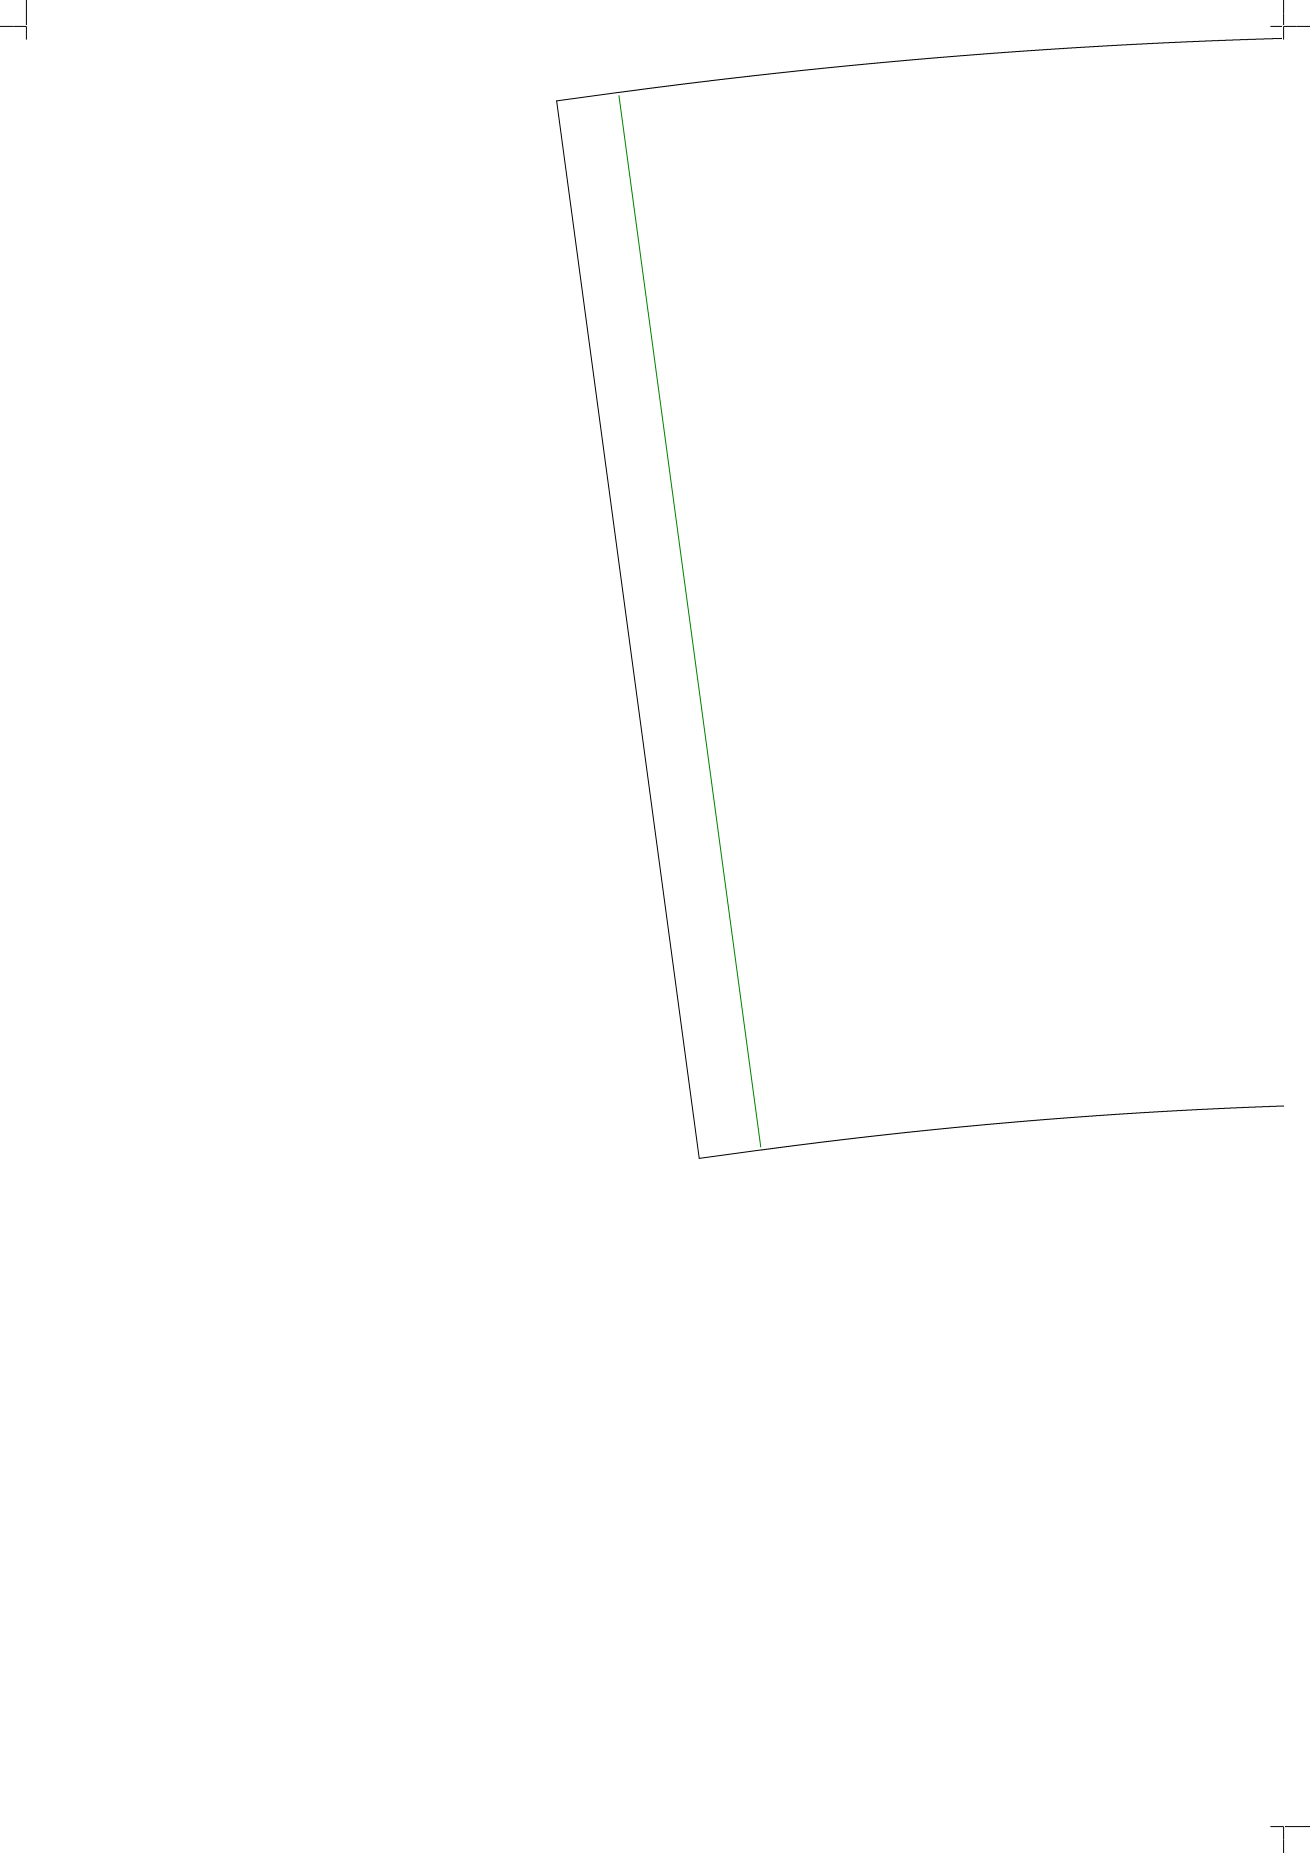
[picture p106: page 1]

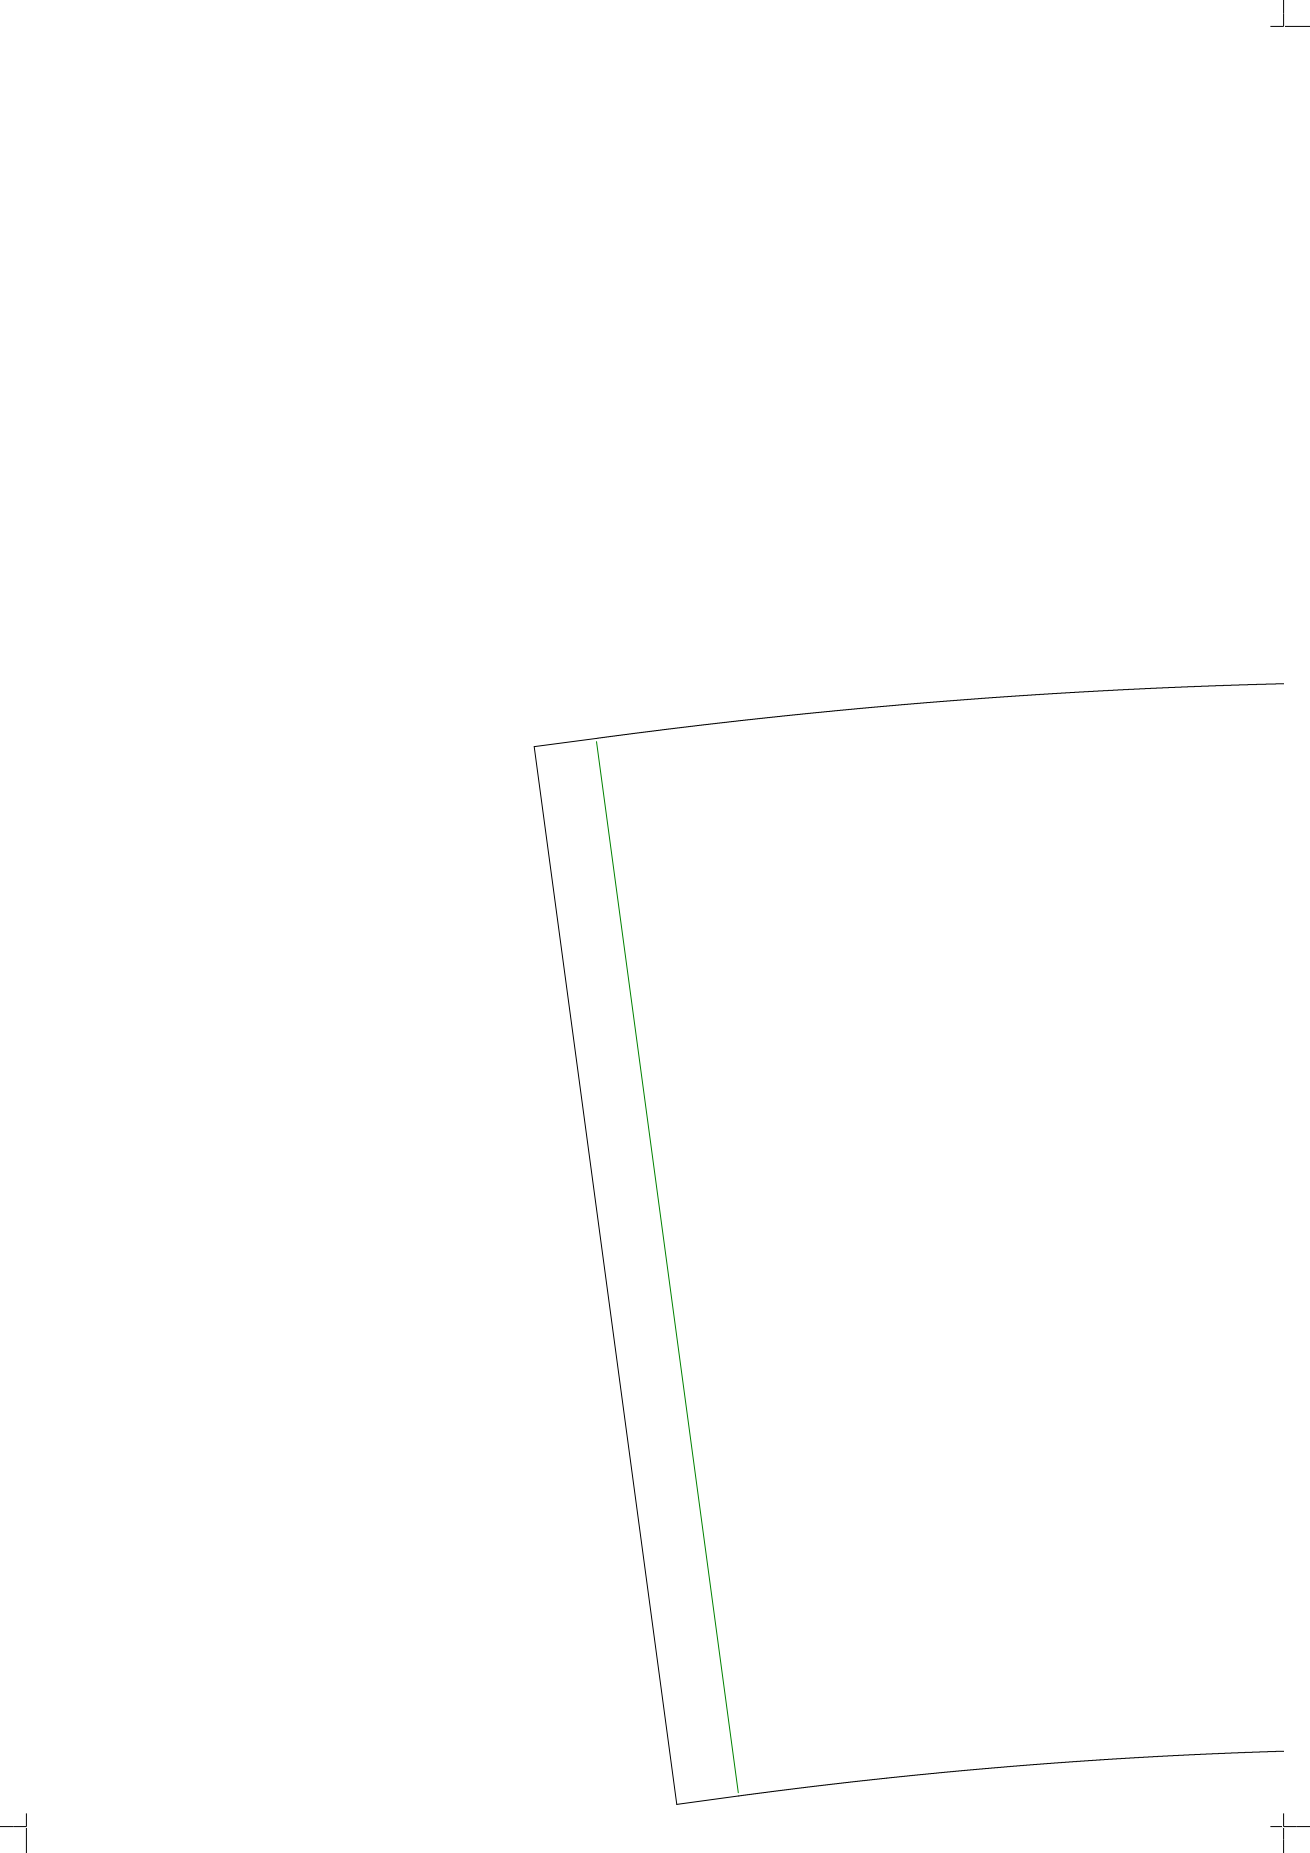
[picture p107: page 2]

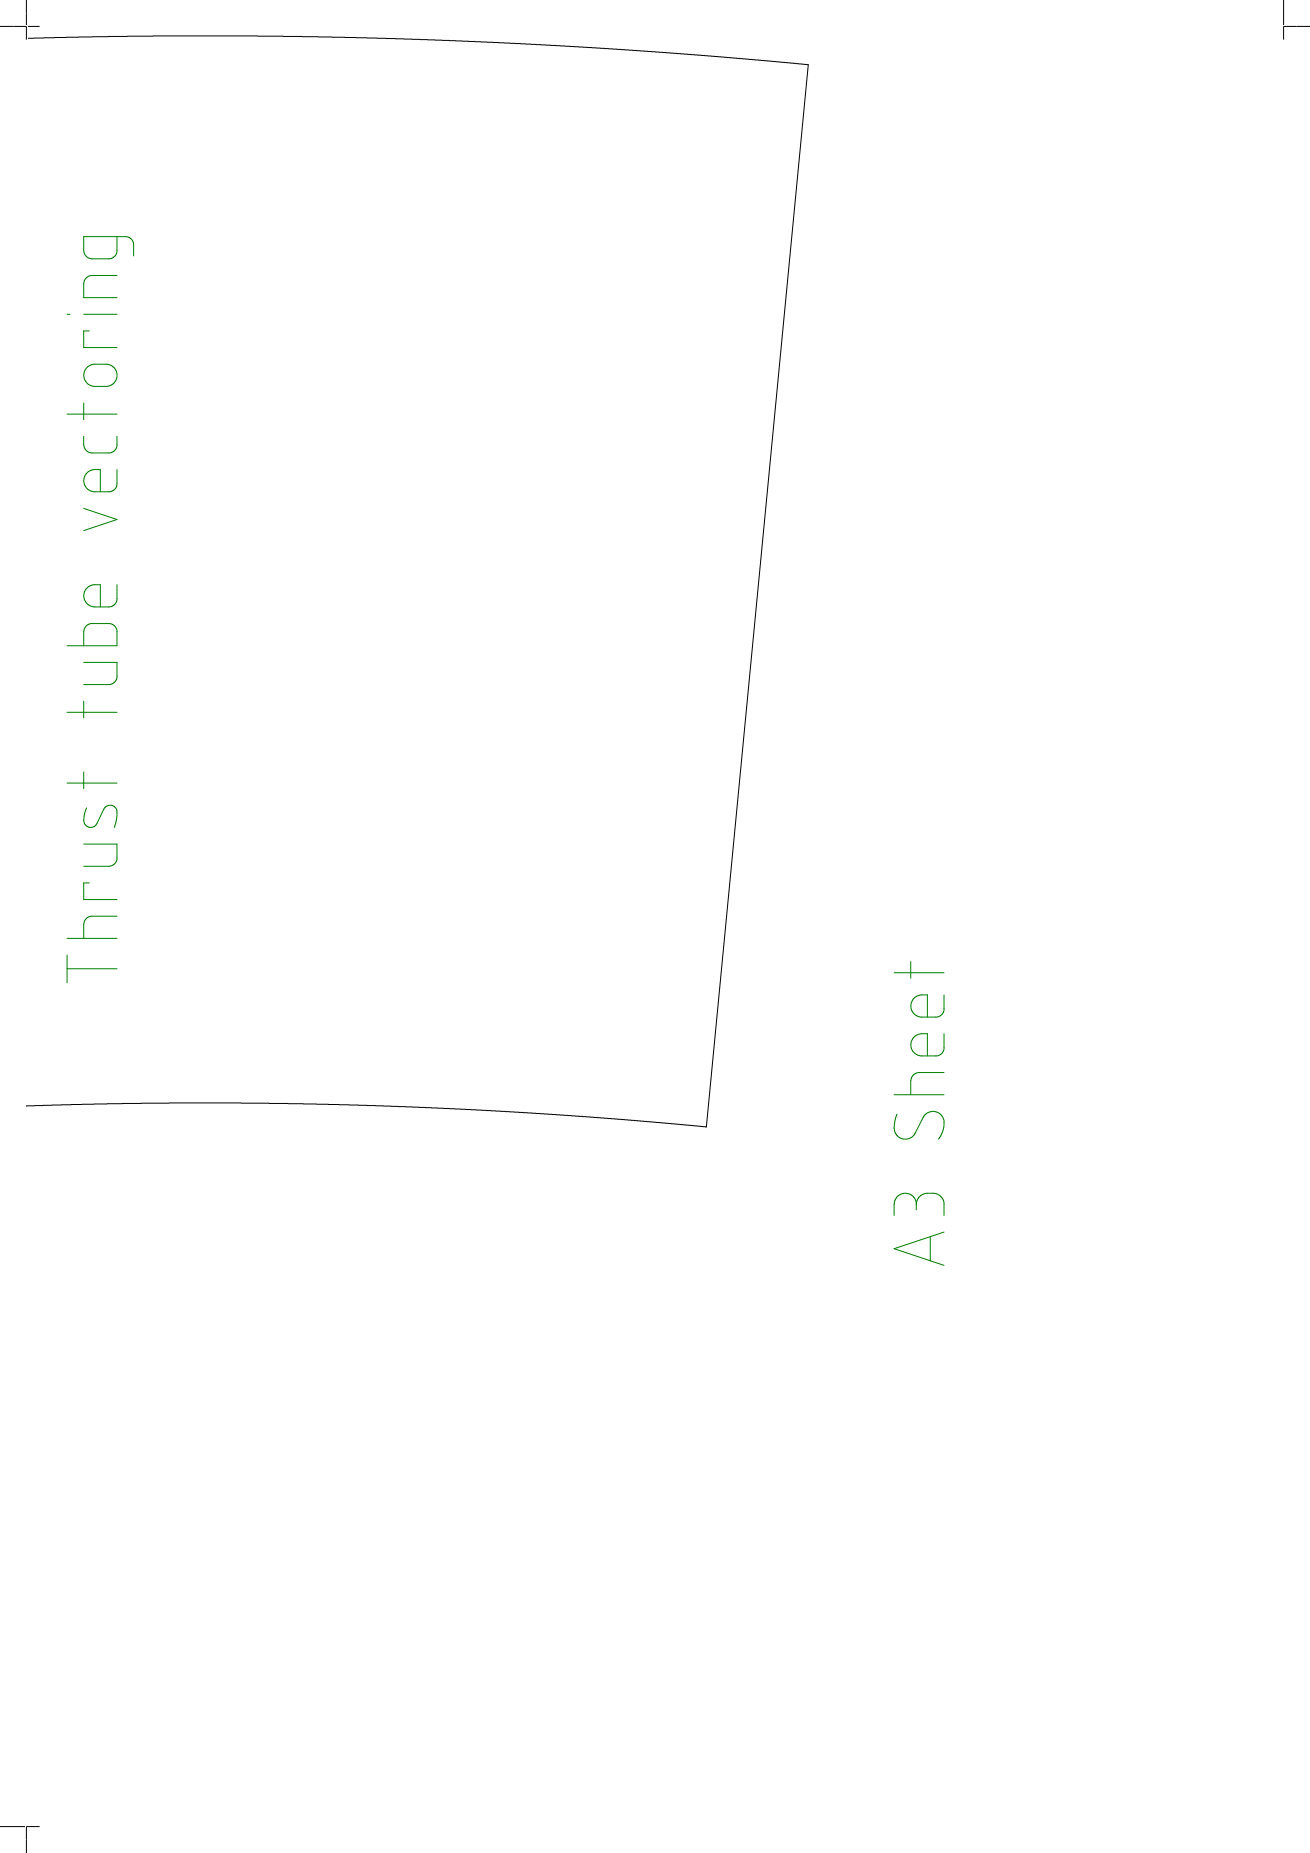
[picture p108: page 3]

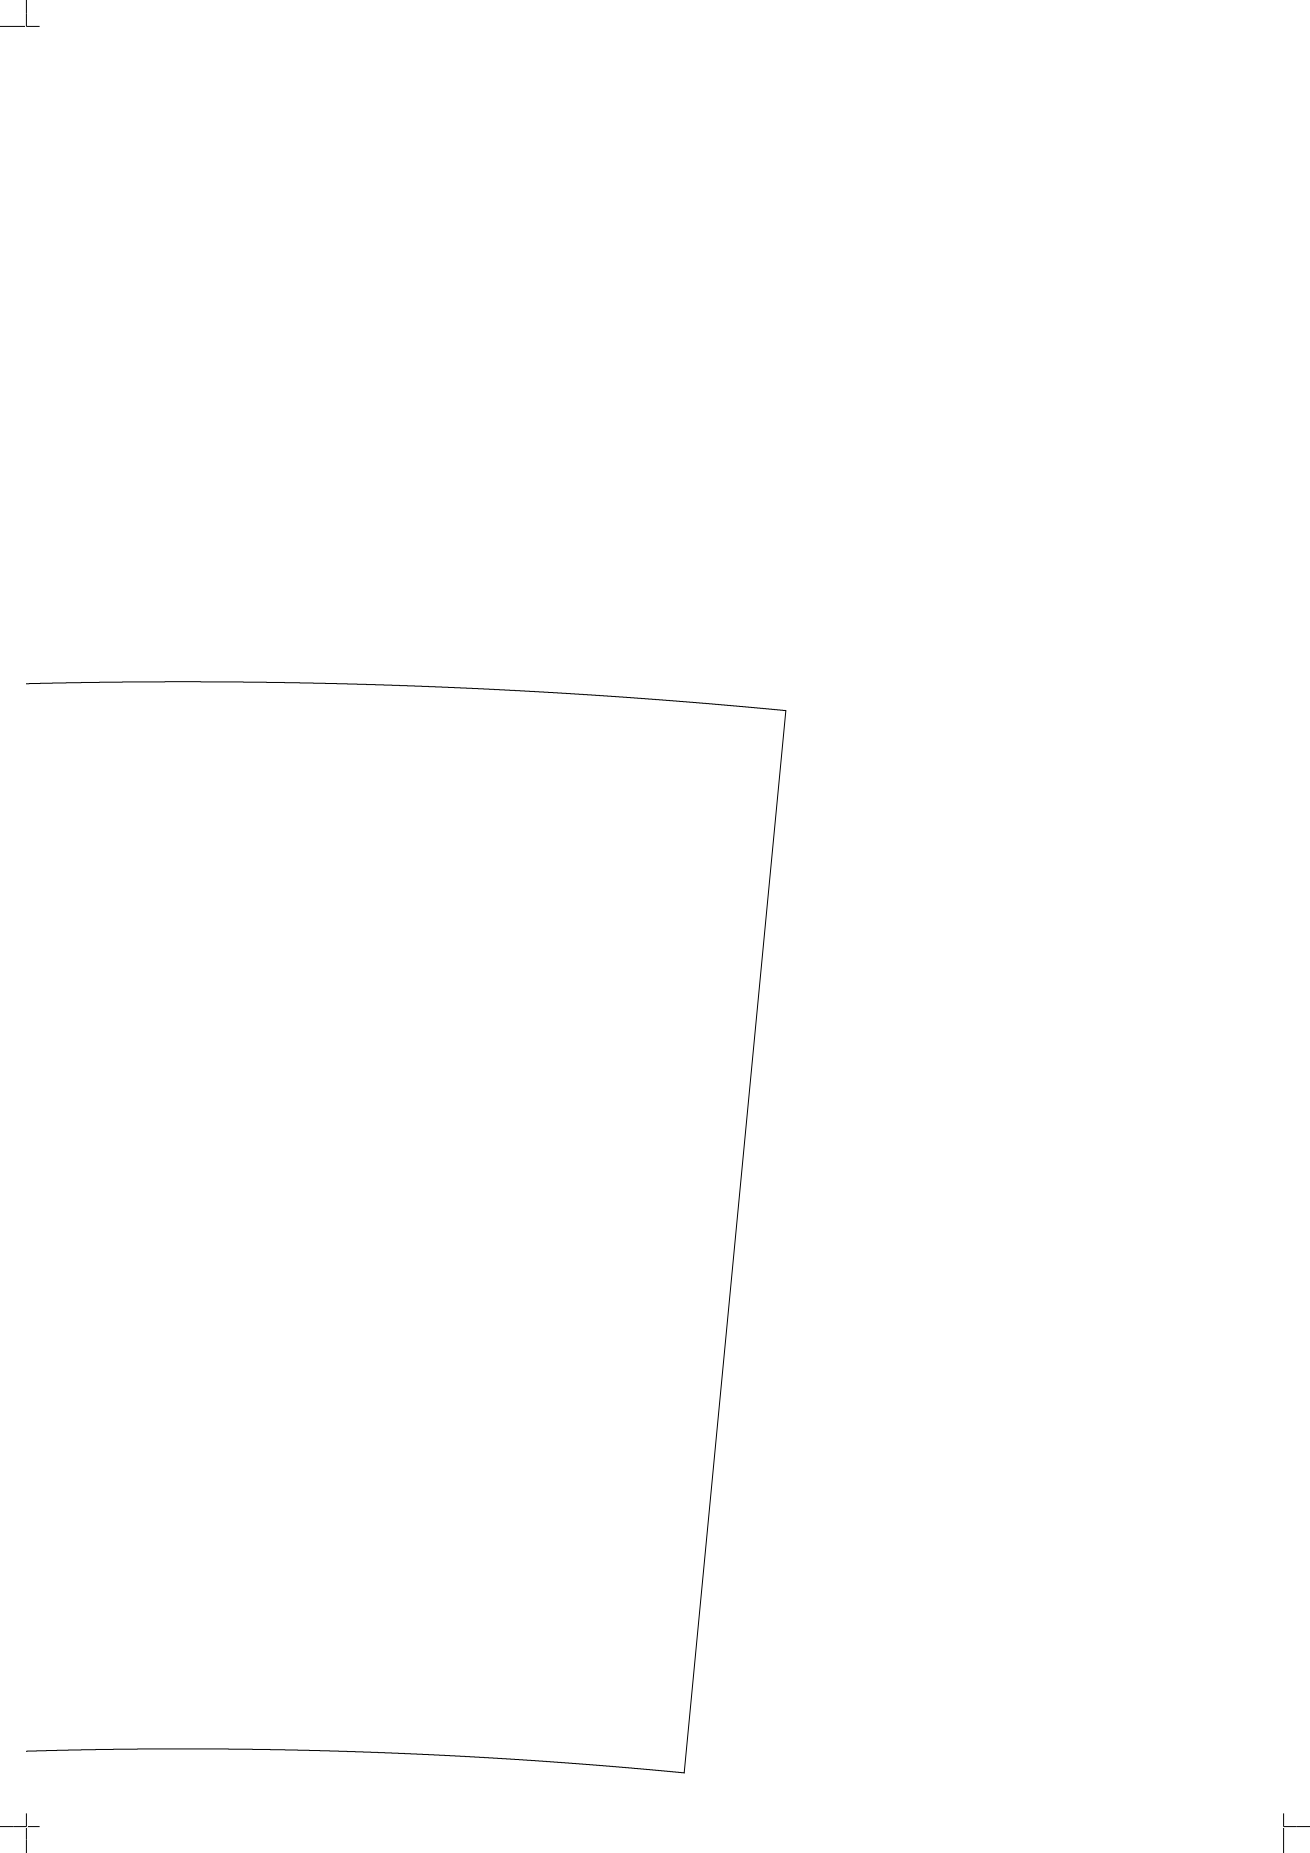
[picture p109: page 4]
